silmoon04/mist-robot/design/main_hub_20260915/corrected_spacers/README.md

Corrected spacers: eight pieces, 5.5 mm outside diameter, 13 mm height, 3.4 mm M3 clearance bore. Nominal radial wall thickness is 1.05 mm.

The main hub geometry and Cura process settings are unchanged. The combined plate was rebuilt and re-sliced: approximately 7 h 26 min and 111.9 g PLA, supports off.

Use Tonight_Hub_And_8_Spacers.3mf for the hub and eight corrected spacers together. Use Eight_Spacers_Only.3mf if you only need the spacers, or Spacer_13H_5p5OD_M3.stl for one piece. Import/select the supplied Neptune4Pro_Hub_PLA_028.curaprofile manually; the 3MF carries geometry, not Cura profile selection. Keep 100 percent scale and the supplied orientation.

This supersedes the earlier 8 mm high by 13 mm diameter spacer plate. The previous hub mounting instructions remain valid. These 13 mm spacers are not automatically interchangeable with the previously checked 11.6 mm yaw spacers; this update changes the requested loose spacers only, not the leg's checked axial stack.
