silmoon04/mist-robot/design/hexapod_phone_quad_r5_20260912/simulation/interim_ce504_yaw22/README.txt

INTERIM R5 MATRIX, SUPERSEDED OPERATING RANGE

These five reports preserve the test using a 22 degree operating yaw limit.
The final clearance review required 19 degrees to retain at least 1 mm of
fixed-saddle clearance. These reports are historical, not the final R5 release.

Solid manifest: ce504f86e7779430ae50394041a0d02d92c47ab61b77c710cbcfba79fbdd9470
Printed manifest: 15f5af97a24525fb5b8539e5f05094fd7455b7da621992cd39ce1c29796a5513

The comparison retains its original report-path fields and hashes. Matching
report bytes are saved in reports under their original case names. This folder
does not contain a complete, directly replayable CAD or trajectory snapshot.
The replacement matrix will use the corrected 19 degree limit and new hashes.
