silmoon04/mist-robot/brain/art_direction/artist_studio_20260916/reuse/mist_motion_v3/README.md

# MIST motion v3

These studies bring the 18 acting ideas back to MIST's open-ring eyes, hooked lids, rounded mint strokes and small mouths. Each clip has 12 composed poses on a shared 512 × 320 canvas. Blinks have their own timeline; they do not consume half of every acting clip.

The frames reuse original MIST components and selected ImageGen component drawings. They are assembled poses, not 216 separate ImageGen illustrations. Source records in the manifest identify the reused and generated art.

The player runs on a 15 fps timebase. Authored exposures hold some poses longer so a glance or reaction has time to read. The left eye, right eye and mouth remain separate. Their common attachment positions prevent a mouth change from moving the whole face.

Use the grid to compare the clips. Open a clip to inspect individual frames, hide layers or try a separate mouth frame. The transition controls compare two expressions. Your selections and notes keep the existing review IDs and can be exported from the page.

`previews/all-animations.gif` shows the full grid. Individual GIFs and blink previews sit in the same folder. The transparent PNGs preserve the full-colour layers; GIF is a compact review format. `AGENT_GUIDE.md` describes when to choose each expression.

This is an animation review gallery. Its mouth controls show layer independence; they do not establish speech synchronisation in the live voice app. A voice integration must drive visemes from the audio actually being played and stop them when that audio is interrupted.

The previous gallery remains available in [v2 history](https://silmoon04.github.io/mist/acting-animations-v2/). The voice app and the earlier selection page are separate.
