silmoon04/mist-robot/design/mist_v2_20260906/engineering_review.md

# Independent engineering review

Review date: 6 September 2026. Scope: `simulation/model.py`, `simulation/run_sim.py`, the analytic model and saved trajectories, wheel calculations, and the body CAD recipe available during the review. This is a review of an engineering candidate. It does not release a leg for powered use or establish stair capability. No hardware was operated. The reviewer changed only this report; findings were sent to the implementation agents.

The current reviewed mass is **3.95376294555 kg**, after reconciling the body CAD mass and COM. Stand, fixed-base leg swing, stance height, driving and ideal-range obstacle stopping pass their model criteria. The current 2:1 hip crawl and both step attempts fail. The 3.5:1 hip variant passes its slow crawl case, but this does not establish a manufactured transmission or stair capability.

The coupled transmission mathematics and nominal coordinate frames checked correctly. The review also found and helped correct an obstacle-test false pass, an inconsistent descent direction and incomplete contact acceptance criteria. Command hysteresis remains an approximation of physical backlash. Earlier **3.884 kg** results are historical evidence, preserved in `simulation/outputs_baseline_preCAD`; they are not the current design results.

## Current evidence after CAD mass reconciliation

The bounded final review checked saved reports, inputs, hashes and mass arithmetic without rerunning the full solver. All **eight current cases**, **three variant cases** and **four supported-leg load cases** match the current source hashes and their own parameter snapshots. [simulation/outputs/summary.json](simulation/outputs/summary.json) is the current eight-case summary. [simulation/README.md](simulation/README.md) explains the setup and remaining model limits.

| Current case | Reviewed result | Claim supported |
|---|---|---|
| 2:1 hip crawl | **FAIL_IN_MODEL**; 31.05 mm forward in 26 s; first-wheel clearance 12.80 mm | Misses the 15 mm actual-clearance criterion. |
| [3.5:1 hip crawl](simulation/variants/hip_3p5/crawl/report.json) | **PASS_IN_MODEL**; 34.38 mm forward and 18.26 mm lateral drift in 26 s; wheel clearances 30.36–36.60 mm; maximum tilt 2.29 degrees | Improved slow crawl under the stated assumptions. Its parameter snapshot changes only the hip ratio and candidate-status label. Added transmission mass, detailed packaging and hardware behavior are not established. |
| Aligned-wheel drive | **PASS_IN_MODEL**; 5.235 m forward in 8 s | A 0.9 m/s commanded drive after the ramp, with assumed motor and floor behavior. This is not measured robot speed. |
| Ideal-range obstacle stop | **PASS_IN_MODEL**; 177.61 mm minimum reported wheel-to-wall gap; zero sampled obstacle contacts | Corrected geometric-distance stopping case. No sensor perception or avoidance planner is tested. |
| Step ascent and descent | Both **FAIL_IN_MODEL** | Stair traversal remains unfulfilled. Ascent tips; descent includes unreachable targets and excessive sustained servo load. |
| [Supported-leg high-load test](simulation/load_tests/summary.json), 29.09 N | 2:1 hip: 148.13 mm endpoint error; 3.5:1 hip: 15.86 mm. **Both fail** their sustained-load criteria. | The higher ratio improves modeled force response. It still exceeds the 15 mm endpoint criterion and continuous motor allowance under this seconds-long fixture load. |

The 3.5:1 variant also passes its drive case. The adverse drive variant stays within its case criteria after increasing delay and backlash, reducing stiffness and lowering friction. This is one sensitivity experiment, not a bound on manufacturing or environmental uncertainty. With a 350-degree motor span, the 3.5:1 hip has only 100 degrees of usable travel; the nominal-centered range does not cover every analytically reachable stair endpoint.

The [final body report](cad/output/body_geometry_report.json) records **33 valid single solids**, no shape errors and no positive-volume intersections among those body components. Its **26 current printable-component STL filenames** match the recipe exactly, with no stale or missing files. Independent mass arithmetic confirms that shell mass **706.207559 g** excludes the B13/B14 face parts; those parts contribute **63.555387 g**, which is included once with the assumed 155 g face phone. Shell and combined face COMs match the simulator after the 35 mm origin shift. Twelve joint servos are counted once: four yaw servos in the base and eight pitch/knee servos on the carriages.

These are solid-PETG volume estimates, not sliced or weighed masses. The body check is one static body assembly. Native Fusion execution, final native-leg integration, service fasteners, root-pod load interfaces, swept collisions and print readiness remain unverified. A body-only zero-intersection result cannot certify the complete robot.

Current source SHA-256 hashes are `run_sim.py`: `0b35d5a776b8479b2bbe7238c191ccf8e890e4024b749d600639f0ca0878cddc`; `model.py`: `7da904de9f18a7e7c164d62e1b939a8b51af91a55bf1c357c62dc7707cb35392`; and `load_test.py`: `69a107302449a0fb328096b483cfd8a18f251f08429263579f79dd1648b19eff`. The current shared canonical parameter hash is `d66bb513a344fb6a9723ee8ba9d6b9debb91f5a452ef4f4a3dc87d79ed4da732`; the 3.5:1 crawl snapshot hash is `4b87a3e8c51662efe8698406ff136cf91787f916490464e28e03a56f92319e32`.

## Earlier findings and disposition

| Finding | Evidence and implication | Disposition |
|---|---|---|
| **Obstacle stopping initially passed after hitting the obstacle.** | The saved `obstacle_stop` case ended at +29.86 mm. The initial front-wheel-to-wall gap was 29.67 mm. Reloading its final pose into an isolated Bullet world found both front wheels touching the wall, with -0.010 mm separation and horizontal contact normals. The controller used a timer and the acceptance criteria did not reject obstacle contacts. | Corrected and regenerated with a declared ideal world-distance trigger, a farther obstacle, no-contact and stopped-velocity criteria. Independent geometric replay of all 400 saved frames found no penetration and a minimum whole-robot separation of **170.0 mm**. This establishes the revised model's stopping case, not perception or avoidance planning. |
| **Descent initially drove in the opposite direction to its success condition.** | The platform occupied x=0.24 to 1.64 m. The robot started at x=0.64 m and commanded positive-X foot/wheel movement, but success required x<0.10 m. Downward targets went into the platform. | Corrected to start at x=1.42 m and use the right edge, then regenerated. Both step attempts still fail. Their failure does not prove that no viable stair controller exists. |
| **Non-wheel supports and wall contacts could hide failures.** | The original acceptance test counted only base-link ground contacts. A femur, tibia or yaw carriage could support the body without failing the test. Support polygons accepted every loaded wheel contact, including vertical walls. | Corrected and regenerated: loaded non-wheel contacts fail acceptance and upward contact normals define the support polygon. Checks are still sampled at recording frequency; transient contacts between samples can be missed. |
| **Crawl PASS did not establish the requested swing clearance.** | Replay of the original 26 s crawl found peak tread clearances of 13.17, 21.75, 24.35 and 17.08 mm using wheel-center height minus radius. Commands requested 45 mm; the shared toe-clearance parameter is 15 mm. All four wheels did unload, but the first leg missed that clearance. Maximum individual knee errors reached about 9 degrees while whole-robot RMS was 3.06 degrees. Forward progress was 31.4 mm in 26 s. | Corrected acceptance now uses actual wheel bounds, reports 12.47, 21.24, 23.95 and 16.49 mm, and correctly marks the baseline crawl **FAIL_IN_MODEL**. These values describe a very slow flat-floor crawl attempt, not fast walking or validated obstacle traversal. |
| **Backlash dynamics are approximated by command hysteresis.** | `ActuatorBank` infers physical shaft angle exactly as `s=Aq`, then applies a play operator to the commanded angle. Under a fixed command, a reversed external load still sees immediate modeled stiffness; it does not cross a physical transmission gap before engagement. No separate rotor or reflected gearbox inertia is integrated. | Limitations now state this explicitly. Retain the analytic correlated-error bound. Predicting loaded reversal response requires measured gap/stiffness and either an identified model or explicit motor/load states with engagement. |
| **Body recipe and simulator initially disagreed.** | `body_spec` required `body_height_m=0.260`, while shared parameters use a 0.220 m barrel and a separate 0.260 m overall height. The initial face-phone CAD and simulation centers differed. The first body replay also reported phone/phone interference, a disconnected lower shell, and 901.99 g of fully solid printed geometry against a 650 g shell allowance. | Source, static body intersections and mass/COM accounting have been corrected, as recorded above. The final CAD solid mass is 769.76 g including the face parts; it is split into shell and face-frame budget entries without duplication. Sliced and measured values remain outstanding. |
| **Saved reports can represent different source revisions.** | `outputs/summary.json` initially contained only the last separately invoked case, while other case directories retained earlier runs. Parameters were copied, but the per-case reports did not identify the source revision. | Corrected: all eight regenerated reports contain parameter and source hashes. Independently verified every hash against its parameter snapshot and the current source. Later model/geometry changes require another matching run. |

## Checks that passed

- Nine analytic unit tests passed, including the numerical Jacobian, inverse kinematics, virtual work, coupled hip/knee motion, motor-travel mapping and affine mass allowance.
- Across 100 additional random vectors, ideal virtual work differed by at most **1.78e-15**: `(A.T @ motor_torque) dot qdot = motor_torque dot (A @ qdot)`. For the absolute-tibia belt, the hip motor load depends on `joint_hip_torque - joint_knee_torque`, as implemented.
- An isolated URDF load matched analytic wheel-link positions within **9.3e-9 m** at the neutral pose. Bullet reports the base inertial frame at the body COM; `base_link_pose` correctly removes its translated COM offset for the current zero-rotation inertial frame. The summed URDF mass and analytic mass both equal **3.884 kg** for the reviewed parameters.
- Default Bullet velocity motors are disabled before torque control. The controller applies `A.T @ (eta * shaft_torque)` to joint torques. Same-direction motoring torque falls toward zero at the assumed no-load speed, and peak torque is capped separately. It does not apply full stall torque at full no-load speed.
- Wheel inertia uses the axle as the local Y axis, consistent with the rotated cylinder. Body and link inertias remain approximate distributions: products of inertia, motor rotor inertia and actual CAD inertia are absent. These omissions limit acceleration, tipping and resonance predictions.
- The wheel study's **1,620 cases** reproduce. Four-contact acceleration at 4 kg requires **0.045297 N m** for 70 mm wheels and **0.055003 N m** for 85 mm wheels. The 15-degree slope figures are **0.098781** and **0.119949 N m**; two-contact loads double. Speed-increase ratios, efficiency penalties and the reported torque ceilings are consistent. No current-limit pass in the existing grid has zero predicted rpm.

The earlier independently rechecked **3.884 kg** baseline used `run_sim.py` SHA-256 `d95047507b5130b1a2d4e31166c1c14d411596f97fc1e2ed4900f1634aa8148b`, `model.py` SHA-256 `be18e5074f94d457e4a3b7b01fd80f1f89011537f824c023eb1170f38f6aad78`, and canonical parameter hash `043364ca09833c05f8d711fda6b7a7de019ae3bcbe12c949575a077214699b70`. Those hashes and the 170.0 mm independently replayed obstacle separation in the historical findings identify the earlier evidence, not the current mass-adjusted run.

## Limits that remain material

The wheel calculation combines nominal no-load current with linearly voltage-scaled no-load speed. That is a useful endpoint approximation, but not one internally consistent resistance/back-EMF model with constant friction current. An endpoint-consistent alternative changes the relevant FIT0493 70 mm acceleration estimate from about 1.073 to 1.066 m/s and the STS speed-increase 85 mm estimate from 1.067 to 1.053 m/s. It does not reverse the present comparison. Add voltage feasibility and a target-speed condition before reusing the current-limit Boolean as an overall operating pass.

The collision model uses boxes and cylinders, excludes parent/child contacts and additionally excludes each femur/wheel pair. It does not contain the real servo pods, belt runs, shafts, retainers, cables or cosmetic covers. Zero coarse contacts establishes no interference only for the checked proxy pairs and sampled trajectory. It cannot establish a collision-free, manufacturable leg. The native helper correctly raises on failed features and no-effect cuts; the offline body exporter records some such defects instead, so the two replay paths need a clean common recipe before native execution can be inferred.

The support polygon is a quasi-static diagnostic. It does not prove dynamic stability, traction or stair-edge support. Whole-run servo RMS is a heat-related indicator under an assumed rating, not a thermal model. An eight-second PASS does not establish continuous duty. The 180 mm step case uses one platform, not a repeated staircase with 270 mm treads, riser noses, friction variation or a perception/planning stack.

Before advancing beyond a candidate, retain the corrected failures, integrate the final leg geometry and its actual transmission mass, check the complete motion envelope, and identify the first assembled leg's backlash, force response and thermal behavior. Repeat matching-source simulations when those inputs change. Coupon feedback can establish fits; it cannot establish these load and motion properties.
