silmoon04/mist-robot/design/mist_v2_20260906/cad/fusion_motion_20260907/REVIEW.md

# Independent static review

A separate agent reviewed the initial `motion.py` against installed Autodesk declarations and the primary documentation collected in `API_EVIDENCE.md`. It found no concrete static defect at that stage. The first actual native fixture later exposed behavior that this static review did not establish: wrong-axis rotation through the custom-line definition, drive quantization and Compute All resetting the transient pose.

The review checked the native sketch datum and proxy contexts, child-relative-parent probe calculation, axis/centre checks, pose restoration, physical/as-built angle offset and sign mapping, and the separate fixed-phase rotor attachments.

After the controlled fixes, the native 17-component fixture passed all 16 joint probes and 96 transform/world-datum checks. See `NATIVE_VERIFICATION.md`. The full nested assembly, multi-part groups and rotor attachments still require native validation. The passing fixture does not retroactively turn the original static review into proof of the first implementation.
