silmoon04/mist-robot/design/mist_v2_20260906/package/body_remote_20260907/cytron_wheel_motor_note.md

# Cytron wheel motor check

Checked 7 September 2026. Target: a body-mounted encoder gearmotor near 200 wheel rpm and 0.17 N·m working torque, with an approximately £15 UK component price. Supplied comparator: FIT0493, £25.61 including VAT, 98 g, 350 rpm no-load, 1.177 N·m stall; approximately 0.172 N·m estimated at the 1 A winding-current cap. No purchase, supplier contact or bench test was made.

**No buyable UK SPG30E variant meeting that price and operating-point target was verified.** The real current fast variant below is a technical comparison, not a £15 UK purchasing recommendation. It does not reach the requested rated power even before remote-transmission losses.

## One current variant: SPG30E-GR30

[Cytron's exact encoder product page](https://www.cytron.io/p-12v-37mm-dc-geared-motor-with-encoder-spg30e-gr30) identifies **SPG30E-GR30**, distinct from the non-encoder SPG30-GR30. Its table states:

| Parameter | Value |
| --- | --- |
| Gear ratio | 30:1 |
| Rated voltage | 12 V |
| No-load speed / current | 333 rpm / 120 mA |
| Rated load speed | 266 rpm |
| Rated load torque | 1.14 kgf·cm = 0.1118 N·m |
| Rated current | 400 mA |
| Stall torque / current | 4.5 kgf·cm = 0.4413 N·m / 1.2 A |
| Encoder | Incremental, advertised 16 PPR; 3.3–5 V supply |
| Harness | Non-detachable wires with 2.54 mm female headers |

Cytron displayed **US$19.00** and **out of stock** for this exact encoder variant. No UK seller price, VAT-inclusive total, stock or delivery date was verified. A dollar conversion would not establish a delivered UK price. The linked current encoder datasheet folder returned 404 during this check; the product page and dimensional image were available. No explicit continuous-duty class, thermal-rise limit or endurance test was established from them.

## Actual current geometry

The [Cytron encoder-motor dimension drawing](https://static.cytron.io/image/catalog/products/V-SPG30/v-spg30-dimension-spg30e-v2.png), linked from the current product page, was visually inspected. For GR30 it gives gearbox length L = 22 mm and motor/encoder section length 47 mm. Thus the calculated body length is 69 mm; adding the 21 mm front boss/shaft projection gives approximately 90 mm to the output tip, excluding wire clearance.

The gearbox diameter is 37 mm and motor/encoder section diameter 35 mm. The output is a 6 mm D-shaft, 5.5 mm across the flat, with 15 mm shaft projection beyond the boss and 12 mm flat length. The locating boss is 12 mm diameter. The drawing marks M3 mounting holes on a 31 mm pattern diameter, and a 7 mm offset between output and body axes. Confirm mounting-thread depth from the actual delivered revision; do not transfer the older SPG30E-20K's thread-depth data automatically.

**Exact mass was not verified.** Do not reuse an older SPG30E weight or infer that its mass matches the 98 g FIT0493. The current 37 mm diameter and approximately 90 mm overall envelope already require a larger body mounting allowance than the supplied 25 mm-class FIT0493.
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
