silmoon04/mist-robot/design/mist_v2_20260906/package/body_remote_20260907/wheel_actuation_options.md

# Wheel actuation options with body-mounted motors

Checked 7 September 2026. **The ordered ST-3215-C018 genuinely supports continuous velocity operation, but a 2–3× speed-up cannot meet 200 wheel rpm.** Its manufacturer no-load speed is 45 rpm at 12 V. The existing simulation already uses 45 rpm; the 70–100 rpm figure was an unverified hypothesis, not a simulation defect. No ratio, material, controller or CAD changes were made from that hypothesis. FIT0493 remains the current fallback.
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
