silmoon04/mist-robot/locomotion/reviews/msi_remote_smooth/default-main.png

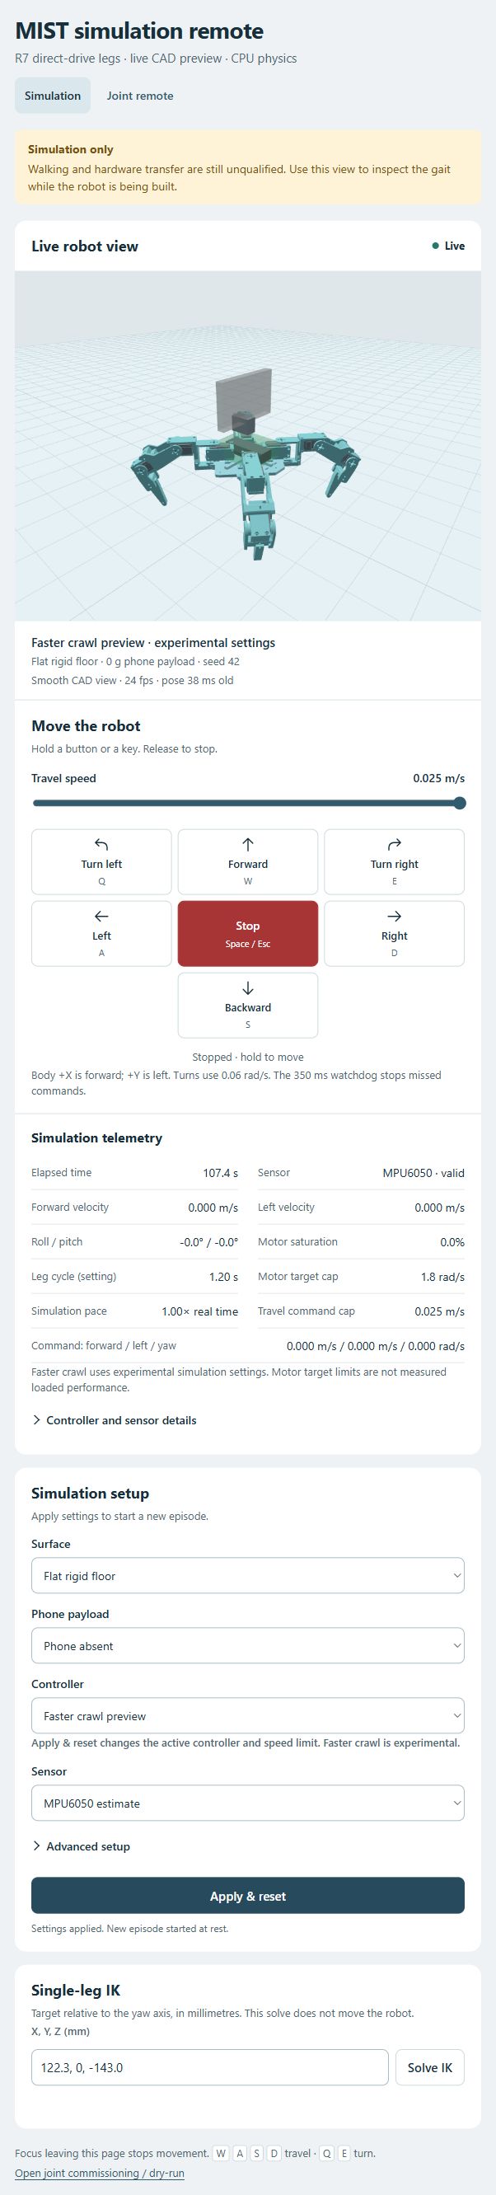
locomotion/reviews/msi_remote_smooth/default-main.png
