silmoon04/mist-robot/locomotion/reviews/msi_remote_smooth/main-current.png

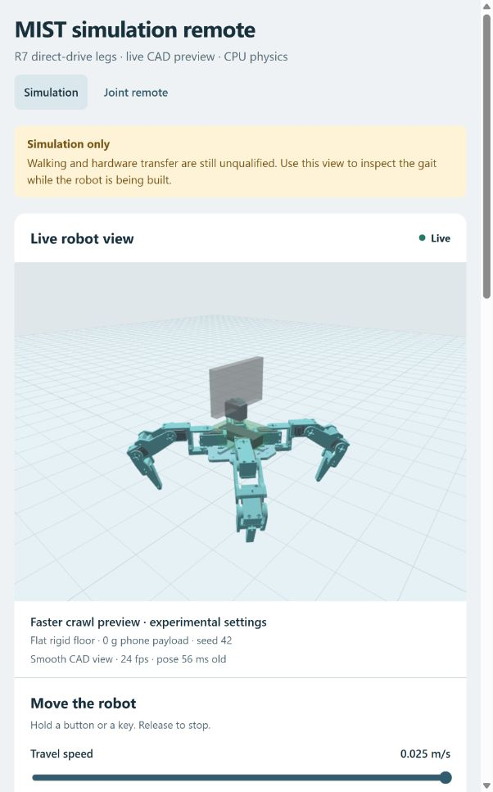
locomotion/reviews/msi_remote_smooth/main-current.png
