silmoon04/mist-robot/locomotion/reviews/msi_remote_speed/desktop.jpg

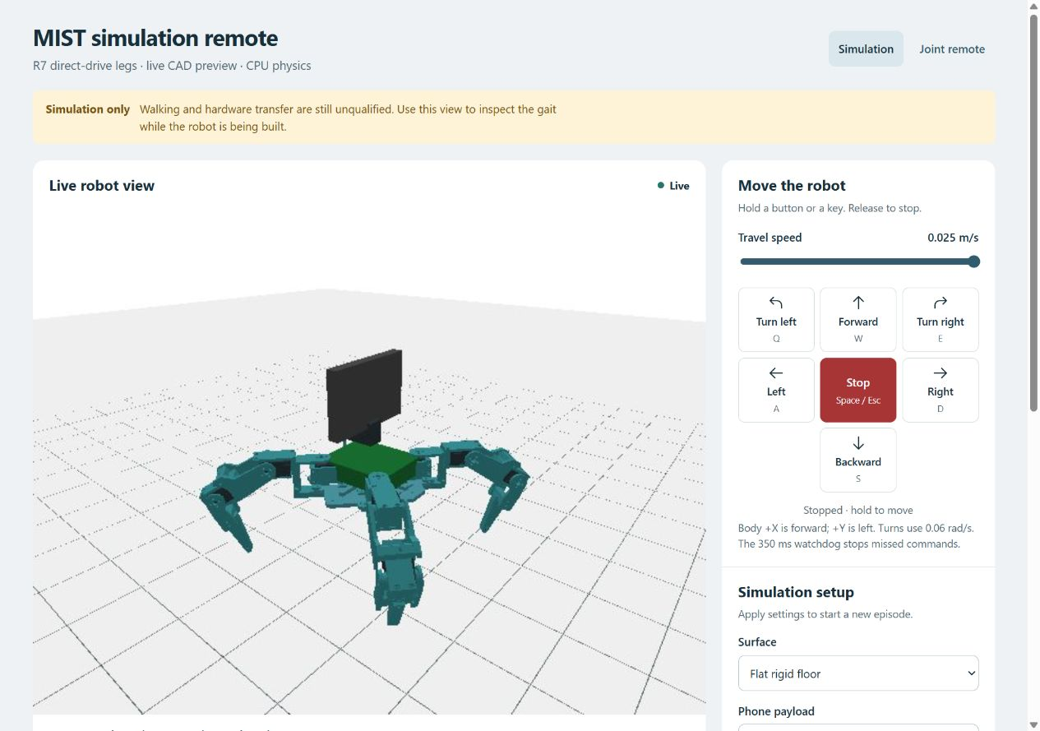
locomotion/reviews/msi_remote_speed/desktop.jpg
