silmoon04/mist-robot/locomotion/reviews/msi_remote_speed/phone.jpg

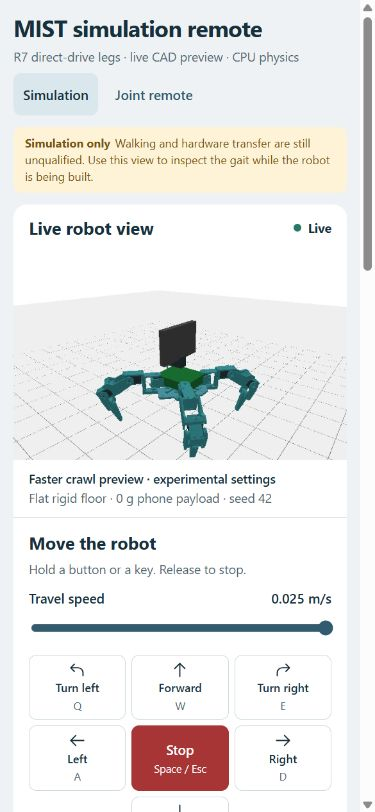
locomotion/reviews/msi_remote_speed/phone.jpg
