silmoon04/mist-robot/locomotion/reviews/msi_remote_ui/joints-desktop.jpg

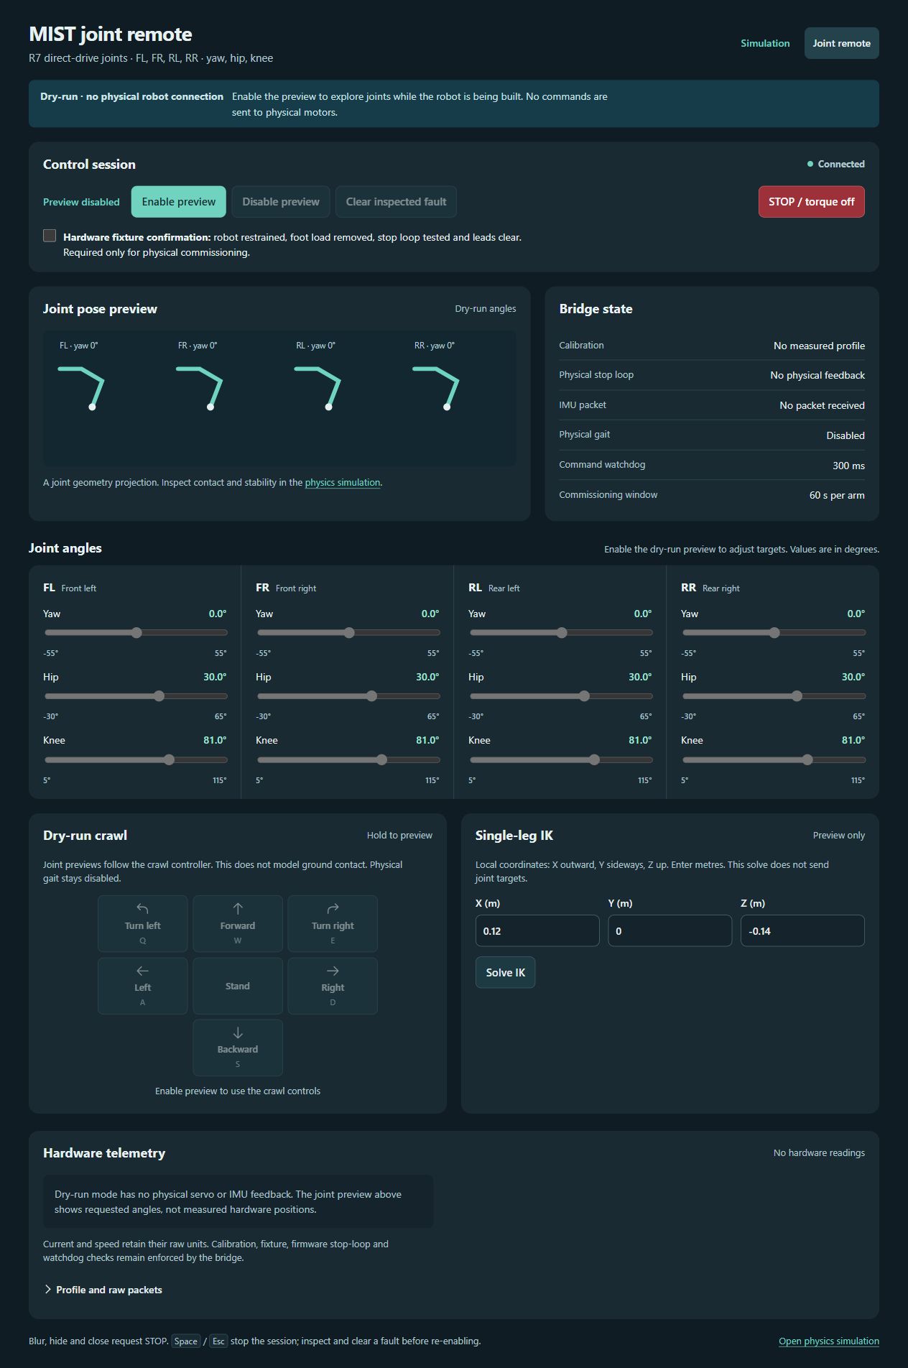
locomotion/reviews/msi_remote_ui/joints-desktop.jpg
