silmoon04/mist-robot/locomotion/reviews/msi_remote_ui/joints-mobile.jpg

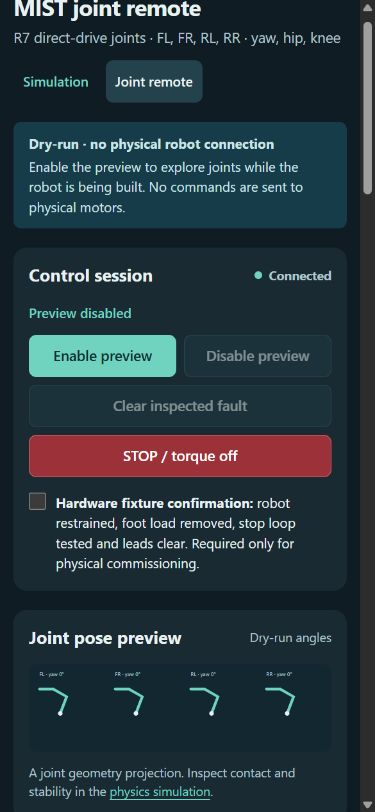
locomotion/reviews/msi_remote_ui/joints-mobile.jpg
