silmoon04/mist-robot/locomotion/reviews/msi_remote_ui/simulation-desktop.jpg

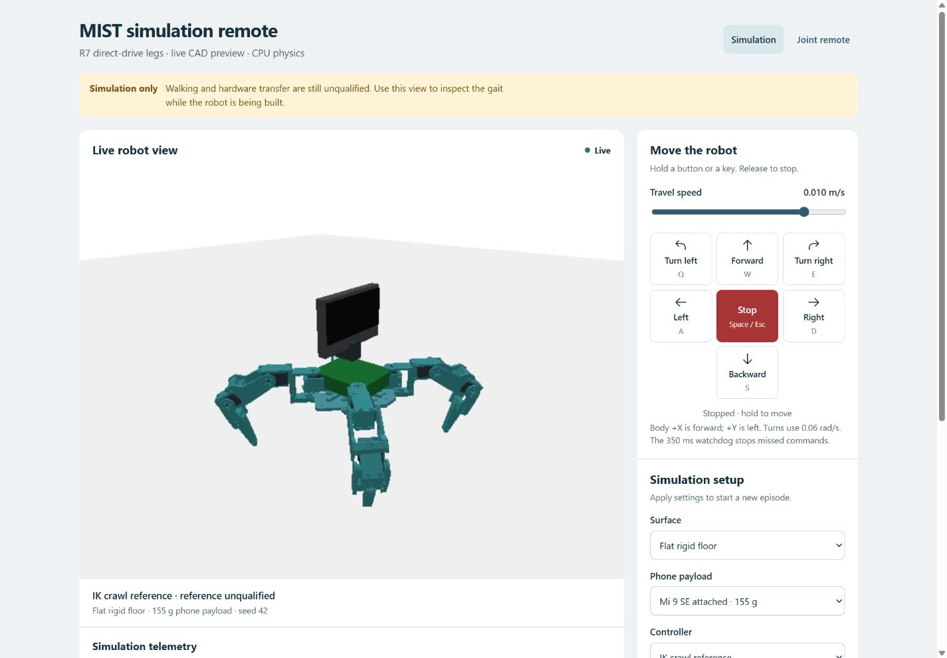
locomotion/reviews/msi_remote_ui/simulation-desktop.jpg
