silmoon04/mist-robot/locomotion/runs/preview.jpg

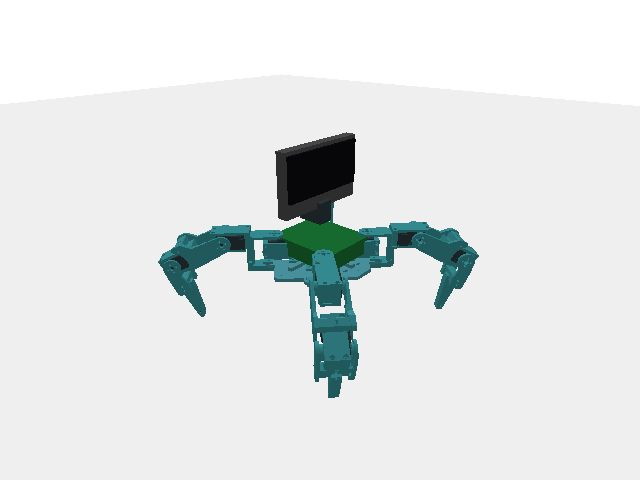
locomotion/runs/preview.jpg
