silmoon04/mist-robot/design/recovery_three_parts_20260916/balanced_profile/READ_ME.txt

Import and select Neptune4Pro_Recovery_Balanced_028.curaprofile in Cura.
Use it with the existing Recovery_Three_Parts_With_Supports.stl.
Do not change the supplied model orientation or remove its built-in supports.
Keep your existing Neptune 4 Pro printer and startup configuration.

This profile replaces the slower Recovery Three Parts 028 profile for this attempt.
The older Recovery_Three_Parts.zip retains the earlier profile; import this new profile separately.

CuraEngine estimate for the same three-part plate: 6 h 14 min, about 109 g PLA.
Previous recovery estimate: 7 h 12 min. Saving: about 58 minutes, or 13.4%.
Actual Cura and printer time may differ; these are not measured print durations.

Changes:
Outer walls: 35 to 50 mm/s.
Inner walls and infill: 60 to 90 mm/s.
Top and bottom: 35 to 60 mm/s.
Nozzle after first layer: 210 to 215 C.
Candidate volumetric flow ceiling: 8 to 11 mm3/s.
Overhang speed percentages reduced to avoid speeding up unsupported walls.

Retained:
0.28 mm layers, five walls, 25% gyroid infill.
6 mm outside brim with 0.1 mm gap.
Added removable support geometry and automatic tree supports.
20 mm/s first layer, 210 C initial nozzle temperature, 60 C bed.
Gentle acceleration, 120 mm/s travel, existing retraction and cooling settings.

The plate hash and sliced automatic support geometry match the checked recovery setup.
The higher flow has not been physically qualified for your filament. Inspect the initial
layers and subsequent extrusion on this first use; speed savings do not prove adhesion.
Clean and reseat the PEI sheet as planned before starting.
