silmoon04/mist-robot/design/mist_v2_20260906/package/metal_gears_20260907/supplier_gear_options.md

# Metal module 1 gear options

Checked 7 September 2026. Scope: 20:40 and 25:50 spur pairs, with an 8 mm face-width preference; 7 mm output shaft interface; an 8 mm knee gear slice at y = 28.125–36.125 mm coupled to the selected MISUMI 3GT pulley. No purchases or supplier contacts were made. Only this note was written for this subtask.

HPC's plain PG1 gears are the closest catalogue match to the 8 mm slice. The 25T input leaves more material around the servo horn bolt circle than 20T. A 7/8 mm finished bore and both axial bolt patterns still require a specified modification or adapter. No catalogue gear below is claimed to contain the C018 spline, four M3 holes on 14 mm BCD, or four M4 holes on 16 mm PCD.

## HPC G1 / PG1: exact 8 mm face

[HPC's manufacturer drawing and table](https://www.hpcgears.com/pdf_c33/23.28-23.33.pdf), pages 23.28–23.29, specifies module 1, 20° pressure angle, 214M15/045M10 steel and H8 bores. G is hubbed: 8 mm face + 12 mm boss = 20 mm overall. PG is plain, 8 mm overall. Dimensions are mm; masses are grams.

| Hubbed / plain part | Pitch / outside diameter | G boss diameter | Stock bore, both forms | G / PG mass | G / PG catalogue price |
| --- | --- | --- | --- | --- | --- |
| G1-20 / PG1-20 | 20 / 22 | 15 | 8 | 28 / 16 | £11.85 / £11.33 |
| G1-25 / PG1-25 | 25 / 27 | 15 | 8 | 39 / 27 | £12.75 / £12.40 |
| G1-40 / PG1-40 | 40 / 42 | 20 | 8 | 98 / 74 | £16.44 / £14.96 |
| G1-50 / PG1-50 | 50 / 52 | 30 | 10 | 173 / 115 | £18.69 / £16.44 |

These are catalogue quantities 1–5, VAT basis unspecified. Root diameter is not dimensioned. The drawing identifies the G and PG forms but shows no axial bolt pattern. [HPC's stock checker](https://hpcgears.com/stockcheck/orders.php) warns that published prices can be outdated and gives approximately 14 days manufacturing when stock is unavailable. Exact current stock/price was not established. [HPC confirms boring, keying and modifications](https://hpcgears.com/n/products/12.spur_gears/spur_gears.php).

The plain 25:50 pair totals £28.84 at those catalogue prices and 142 g before machining/attachments; the plain 20:40 pair totals £26.29 and 90 g. These are arithmetic combinations, not current quotations. PG1-25 is the useful input blank for a horn adapter. PG1-50 fits the requested 8 mm knee slice but its stock 10 mm bore cannot become 8 mm merely by reaming; specify a smaller-bore factory variant or a designed centring sleeve/carrier.

## Ondrives PSG1.0: stronger-material comparison, 10 mm face

Ondrives' [official steel-gear catalogue](https://ondrives.com/images/uploaded/PSG%200.5%20to%208.0mn%20Precision%20Steel%20Spur%20Gears.pdf), PDF pages 5–6, gives a 10 mm tooth face plus 12 mm hub projection, giving 22 mm overall width for module 1. Standard PSG material is 817M40T / AISI 4340 / EN 1.6582 steel, approximately 28 HRC; the separate H suffix is case-hardened 805M20. Both use 20° pressure angle. Catalogue geometry and ratings must be rechecked if face width or heat treatment changes.

| Exact standard part | Pitch / outside diameter | H7 stock bore | Hub diameter | Mass | UK price / lead |
| --- | --- | --- | --- | --- | --- |
| [PSG1.0-20](https://shop.ondrives.com/spur-gears/psg10-20) | 20 / 22 | 5 | 15 | 38 g | No public price/stock verified |
| [PSG1.0-25](https://ondrives.com/spur-gears/psg10-25) | 25 / 27 | 6 | 20 | 63 g | No public price/stock verified |
| [PSG1.0-40](https://ondrives.com/spur-gears/psg10-40) | 40 / 42 | 10 | 34 | 170 g | No public price/stock verified |
| [PSG1.0-50](https://shop.ondrives.com/spur-gears/psg10-50) | 50 / 52 | 10 | 34 | 225 g | No public price/stock verified |

The catalogue describes custom bore, keyway, tapped-hole and pin-hole ordering. This does not establish the required axial patterns or promise a smaller bore in an already stocked 10 mm blank. Request the finished drawing. The 25T standard hub is 20 mm diameter, unlike HPC G1-25's 15 mm boss, and its 12 mm hub projection supplies axial material for a custom interface, but hole direction, assembly access and useful thread engagement still require a finished drawing.

## KHK SS1 through RAR Gears UK: current prices and stock

[KHK's manufacturer catalogue](https://khkgears.net/pdf/ss.pdf) supplies the dimensional drawings. Standard SS1 gears are S45C steel, 20° full-depth teeth, JIS N8, black oxide, without heat treatment. All four below have 10 mm face, 10 mm hub projection and 20 mm overall length. They require width machining or an axial-layout change for the 8 mm slice.

| Exact part and UK listing | Pitch / outside diameter | H7 bore / hub diameter | Displayed unit price | Availability shown |
| --- | --- | --- | --- | --- |
| [SS1-20](https://www.rargears.com/gears/spur-gears/steel-spur-gears/SS1-20) | 20 / 22 | 8 / 16 | £10.73 | 10–14 days, subject to manufacturer availability |
| [SS1-25](https://www.rargears.com/gears/spur-gears/steel-spur-gears/SS1-25) | 25 / 27 | 8 / 20 | £10.97 | 8 in stock; shipping by close of business today |
| [SS1-40](https://www.rargears.com/gears/spur-gears/steel-spur-gears/SS1-40) | 40 / 42 | 10 / 35 | £14.13 | 10–14 days, subject to manufacturer availability |
| [SS1-50](https://www.rargears.com/gears/spur-gears/steel-spur-gears/SS1-50) | 50 / 52 | 10 / 35 | £17.91 | 1 in stock; shipping by close of business today |

RAR pages do not state VAT treatment beside these prices; no VAT-inclusive total is inferred. The 25:50 pair is £28.88 and the 20:40 pair £24.86 before delivery and any machining, as displayed. [RAR's UK delivery policy](https://www.rargears.com/legal/delivery-policy) lists £4.95 standard or £10 next-day courier, subject to its order terms. RAR is RA Rodriguez (UK) Ltd, Shefford, Bedfordshire.

KHK also documents **SS1-50A** with an 8 mm H7 bore and M5 radial set screw, retaining 10 mm face and 20 mm overall length. Exact UK stock and price for that variant were not checked. A radial set screw is not evidence of a rated low-play torque connection. Manufacturer drawing links are [SS1-25](https://khkgears2.net/catalog2/SS1-25) and [SS1-50](https://khkgears2.net/catalog2/SS1-50); the UK pages also link 3D CAD and DXF. No STEP download was claimed.

## Interface screening for the supplied robot geometry

The supplied C018 information is a 25T spline approximately 5.9 mm OD and a factory horn approximately 19.95 mm OD with four M3 holes on 14 mm BCD. Tooth count and spline OD alone do not define a machinable mating spline. The practical candidate retains the factory horn and uses a registered, bolted metal gear/adapter.

For centre distance, standard unshifted module 1 geometry gives `(20 + 40)/2 = 30 mm` and `(25 + 50)/2 = 37.5 mm`. These are nominal centres; backlash and the chosen manufacturer's tooth tolerances still matter.

For root-clearance screening only, assuming unshifted 1.25-module dedendum gives root diameters 17.5, 22.5, 37.5 and 47.5 mm for 20, 25, 40 and 50 teeth. These are calculated reference circles, not verified manufacturer root contours. Fillets, modifications and tolerances must come from the final drawing/CAD.

Four 3.4 mm M3 clearance holes on 14 mm BCD have a radial outer envelope of 17.4 mm diameter. Against that nominal root circle, 20T leaves just 0.05 mm radial material; 25T leaves 2.55 mm. Consequently a direct 20T face pattern is not a credible released design from these dimensions. M3 threaded holes or smaller drills still need root/fillet checks and useful edge distance. Counterbores need a separate, larger envelope. The 19.95 mm horn also projects beyond a 20T nominal root diameter, so horn position and mating-gear clearance must be checked in 3D. A 15 mm catalogue boss cannot fully contain this bolt pattern.

For the knee, a plain HPC PG1-50's 8 mm thickness can occupy y = 28.125–36.125 mm before added spacers or heads. The selected pulley modification is four M4 holes on 16 mm PCD; the gear needs its own separately specified matching holes and a concentric register. On a stock 10 mm gear bore, 4.5 mm clearance holes on that circle leave only `8 − 2.25 − 5 = 0.75 mm` between bore and hole edges. A factory 8 mm bore increases this to 1.75 mm. These narrow ligaments and the sleeve/register arrangement need checking; the catalogue supplies no rating for this face-bolted assembly.

For a 7 mm shaft, HPC's stock 8 mm G1/PG1-40 likewise needs a custom 7 mm bore or designed adapter. Use the face bolts and registered carrier as an explicit torque path to the chosen shaft clamp. A slip-fit bore or axial collar alone does not establish low-play torque transfer.

## Concrete quotation specification

Preferred dimensional starting point: **HPC PG1-25 + PG1-50**, steel, module 1, 20° PA, 8 mm finished face; retain 37.5 mm nominal centres pending mesh checks. Specify the actual input horn register and four M3/14 mm BCD holes from measured CAD, and the output's required 7 or 8 mm bore plus four M4/16 mm PCD interface, with hole type/depth, clocking, register and fastener-head side explicit. Do not label these as stock features.

Ask for the final drawing/STEP including actual root/fillet geometry, material condition and tooth quality, machined bore/face tolerances, minimum allowable web ligaments, price and dispatch for the modified gears. Gear tooth capacity, shaft-hub holding capacity and the face-bolt connection require separate checks. No supplier rating has been assigned to the proposed modified assembly in this note.
