silmoon04/mist-robot/design/expanded_joint_plate_20260913/PARTS.csv

name | added_now | purpose | source_sha256
01_case_to_shaft_gauge_no_support | False | Attach to the existing clamped servo with two M3x50 tie bolts, printed 5 mm underside spacers, nuts and washers. New tapered feet remove the former supports. | fda0c863cdc9c271ca749aea273b21152387ab79db16854a1b8dbe032dbe2260
01_gauge_tie_bolt_spacer_5mm_1 | False | Under the existing saddle foot, before its washer and nut, when using the M3x50 gauge tie bolt. This is not a yaw spacer. | ab0c7a442a2cc90cc595b73495a02ac836dd5a8c9d0850a1861c860b84134750
01_gauge_tie_bolt_spacer_5mm_2 | False | Under the existing saddle foot, before its washer and nut, when using the M3x50 gauge tie bolt. This is not a yaw spacer. | ab0c7a442a2cc90cc595b73495a02ac836dd5a8c9d0850a1861c860b84134750
02_main_horn_cheek | False | Use the actual supplied disc and its retainer washer. Assemble with the 38 mm bridge without forcing the disc stack. | 00e45907637aec10521d88cc0c93faf20e246648065042f59c46582d53e1867c
03_auxiliary_horn_cheek | False | Use the actual supplied disc and its retainer washer. Assemble with the 38 mm bridge without forcing the disc stack. | 7574d0e7deb1022287a449ebbfef9895d24b99ada4a0a589e395fbe3f60df056
04_horn_bridge_38_roofed | False | One M3x50, two OD7 by 0.5 mm washers and a plain 2.4 mm nut close the two cheeks. Check auxiliary free rotation. | f593b4a821eaf692829d68c525e3fbcd6e1f5b79a2d76abd9924d4131cd86adb
05_yaw_spacer_nominal_11p6_1 | False | Four nominal spacers form a complete set. Short and long alternatives are comparison samples only. | 82f2fa383771d25ccbcf4ff7617c6973d04e7dbefd853e071df5c505fa0dcc58
05_yaw_spacer_nominal_11p6_2 | False | Four nominal spacers form a complete set. Short and long alternatives are comparison samples only. | 82f2fa383771d25ccbcf4ff7617c6973d04e7dbefd853e071df5c505fa0dcc58
05_yaw_spacer_nominal_11p6_3 | False | Four nominal spacers form a complete set. Short and long alternatives are comparison samples only. | 82f2fa383771d25ccbcf4ff7617c6973d04e7dbefd853e071df5c505fa0dcc58
05_yaw_spacer_nominal_11p6_4 | False | Four nominal spacers form a complete set. Short and long alternatives are comparison samples only. | 82f2fa383771d25ccbcf4ff7617c6973d04e7dbefd853e071df5c505fa0dcc58
05_yaw_spacer_short_11p3_1 | False | Four nominal spacers form a complete set. Short and long alternatives are comparison samples only. | 179e0e4778daafffadc217a7e8f2acdf92cd5c9dbae3d9b5e3c0cb427ec1af2f
05_yaw_spacer_long_11p9_1 | False | Four nominal spacers form a complete set. Short and long alternatives are comparison samples only. | 8b6721f9ae7093d38d06ca4cf257a263f2fd611fd95a3a60c8d18c83c987c5e5
06_M3_hole_strip_3p2_3p4_3p6 | False | Left to right from the notched end: 3.2, 3.4 and 3.6 mm bore diameter. | 18a38c7b76d4d9e3df8eb7188312c017c627e62ca8a4b00e09f9e8a70828482c
07_M3_nut_depth_2p6_2p8_3p0 | False | Left to right from the notched end: 2.6, 2.8 and 3.0 mm pocket depth; all have 5.7 mm across flats. Measures nut seating without guessing what needed sanding. | 9818404f597261570e706fb4fe4c92827a9c859bacbd27ca7a5ed2202b21fa66
08_lower_yaw_support_arm | True | Fit to the supplied auxiliary disc with the four nominal yaw spacers. | 4a2774ba90cd3cd3f0fdca26ae39872e8b87dfebd063e86bbd4f10f99ea42686
09_pan_cover_spacer_1 | True | Reserve this 4 mm spacer for a phone-pan mounting foot later. It is not a yaw or gauge spacer. | 3ce66418a3977fa44637c34de2ecd635f676789f21a6663e12a0a5b7ea02084b
09_pan_cover_spacer_2 | True | Reserve this 4 mm spacer for a phone-pan mounting foot later. It is not a yaw or gauge spacer. | 3ce66418a3977fa44637c34de2ecd635f676789f21a6663e12a0a5b7ea02084b
09_pan_cover_spacer_3 | True | Reserve this 4 mm spacer for a phone-pan mounting foot later. It is not a yaw or gauge spacer. | 3ce66418a3977fa44637c34de2ecd635f676789f21a6663e12a0a5b7ea02084b
09_pan_cover_spacer_4 | True | Reserve this 4 mm spacer for a phone-pan mounting foot later. It is not a yaw or gauge spacer. | 3ce66418a3977fa44637c34de2ecd635f676789f21a6663e12a0a5b7ea02084b
