silmoon04/mist-robot/design/hexapod_phone_quad_20260912/printing/coupon_bom.csv

part | quantity | stage | source_mandatory | selection_reason | source_stl | source_sha256 | note
r4_case_datum_saddle_0p2 | 1 | optional | False | Alternative fit | ../cad/output/coupons_stl/r4_case_datum_saddle_0p2.stl | a8cbe250cf90684b9bf497a4c7193b9ba26b968c5c317efd21f800eaa6284e07 | Includes the actual mounting feet. Use the registration plate to test case-to-shaft alignment while the actual servo is clamped.
r4_case_cap_0p2 | 1 | optional | False | Alternative fit | ../cad/output/coupons_stl/r4_case_cap_0p2.stl | ba7a100b8b5196e6753f648ed50467291f1f49b6f6e39ed0bb6870916fe67a57 | The three caps are geometrically identical and can be reused across clearance variants.
r4_case_datum_saddle_0p3 | 1 | first_print | True | Source mandatory fit | ../cad/output/coupons_stl/r4_case_datum_saddle_0p3.stl | ac4612018e8a0ccf1af1ce294ebfc54ee79cf865ffc54faf44d5b8411ba3651c | Includes the actual mounting feet. Use the registration plate to test case-to-shaft alignment while the actual servo is clamped.
r4_case_cap_0p3 | 1 | first_print | True | Source mandatory fit | ../cad/output/coupons_stl/r4_case_cap_0p3.stl | ba7a100b8b5196e6753f648ed50467291f1f49b6f6e39ed0bb6870916fe67a57 | The three caps are geometrically identical and can be reused across clearance variants.
r4_case_datum_saddle_0p4 | 1 | optional | False | Alternative fit | ../cad/output/coupons_stl/r4_case_datum_saddle_0p4.stl | 9f717af867f4b651e7af4bdcf49abeba82c71061a1682e3422550104efbdb4b5 | Includes the actual mounting feet. Use the registration plate to test case-to-shaft alignment while the actual servo is clamped.
r4_case_cap_0p4 | 1 | optional | False | Alternative fit | ../cad/output/coupons_stl/r4_case_cap_0p4.stl | ba7a100b8b5196e6753f648ed50467291f1f49b6f6e39ed0bb6870916fe67a57 | The three caps are geometrically identical and can be reused across clearance variants.
r4_case_to_shaft_registration_plate | 1 | first_print | True | Source mandatory fit | ../cad/output/coupons_stl/r4_case_to_shaft_registration_plate.stl | 4590d90273ccea8253faae0aff623f1c748b8e7864f306baad3dc62559455faf | Attach to X9/Y+20 and X9/Y-20 saddle feet with two M3x12 bolts, two nuts and four OD6 by 0.5 mm washers. Fit the actual main horn at the same time. Support the two offset feet when printing inverted.
r4_horn_fixture_main | 1 | first_print | True | Source mandatory fit | ../cad/output/coupons_stl/r4_horn_fixture_main.stl | aa831f0fa3292c41e54d82a5109acba99f934cbee78b664a6a3a1e7a0c413ba8 | Use the actual supplied disc and its retainer washer. Assemble with the 38 mm bridge without forcing the disc stack.
r4_horn_fixture_auxiliary | 1 | first_print | True | Source mandatory fit | ../cad/output/coupons_stl/r4_horn_fixture_auxiliary.stl | 5d230834c32b5bc543b1ee9d721c18601be5697568793c56c7cec0f9d17263f8 | Use the actual supplied disc and its retainer washer. Assemble with the 38 mm bridge without forcing the disc stack.
r4_horn_fixture_bridge_38 | 1 | first_print | True | Source mandatory fit | ../cad/output/coupons_stl/r4_horn_fixture_bridge_38.stl | e1d19f4b16fe954254f0a472b7b93cc298469c772bb359e8342c65a094785459 | One M3x50, two OD7 by 0.5 mm washers and a plain 2.4 mm nut close the two cheeks. Check auxiliary free rotation.
r4_yaw_spacer_11p3 | 1 | optional | False | Alternative fit | ../cad/output/coupons_stl/r4_yaw_spacer_11p3.stl | 179e0e4778daafffadc217a7e8f2acdf92cd5c9dbae3d9b5e3c0cb427ec1af2f | Compare spacer lengths with the seated auxiliary disc and fixed-stub retainer. The nominal candidate is 11.6 mm; do not tighten away free rotation.
r4_yaw_spacer_11p6 | 1 | first_print | True | Source mandatory fit | ../cad/output/coupons_stl/r4_yaw_spacer_11p6.stl | 82f2fa383771d25ccbcf4ff7617c6973d04e7dbefd853e071df5c505fa0dcc58 | Compare spacer lengths with the seated auxiliary disc and fixed-stub retainer. The nominal candidate is 11.6 mm; do not tighten away free rotation.
r4_yaw_spacer_11p9 | 1 | optional | False | Alternative fit | ../cad/output/coupons_stl/r4_yaw_spacer_11p9.stl | 8b6721f9ae7093d38d06ca4cf257a263f2fd611fd95a3a60c8d18c83c987c5e5 | Compare spacer lengths with the seated auxiliary disc and fixed-stub retainer. The nominal candidate is 11.6 mm; do not tighten away free rotation.
r4_m3_clearance_3p2_3p4_3p6 | 1 | first_print | True | Source mandatory fit | ../cad/output/coupons_stl/r4_m3_clearance_3p2_3p4_3p6.stl | 6b4a6089013be8df457c1ae33dfcd8139490135b97bfa51a472e867f98385c97 | Left to right: 3.2, 3.4 and 3.6 mm holes.
r4_top_bridge_load_main | 1 | first_print | False | Section specimen required before load tests | ../cad/output/coupons_stl/r4_top_bridge_load_main.stl | e5f58c0ef3933a690732c936096b8b3e0ee545beca60491dd23c9eb1416e3ea4 | Cropped from actual R4 production geometry. Use as a sacrificial section specimen in the recorded print orientation.
r4_top_bridge_load_aux | 1 | first_print | False | Section specimen required before load tests | ../cad/output/coupons_stl/r4_top_bridge_load_aux.stl | a64ad840a33a192ba19f89ac8c73fbfb69786ea9001b6e07bb0d8d5c9798e2cc | Cropped from actual R4 production geometry. Use as a sacrificial section specimen in the recorded print orientation.
r4_post_staggered_nut_section | 1 | first_print | False | Section specimen required before load tests | ../cad/output/coupons_stl/r4_post_staggered_nut_section.stl | 55a5ecd75f6f9c78457af7c808116a3d82f120be488a72c644c286feb09673a8 | Cropped from actual R4 production geometry. Use as a sacrificial section specimen in the recorded print orientation.
phone_fit_0p3_tray | 1 | optional | False | Alternative fit | ../cad/output/coupons_stl/phone_fit_0p3_tray.stl | 862cea13ee2af2587fb6a097c3ea31ebbbcb32aa330f0877ec967dd3c21185a5 | Assemble with the two matching corner clips and two M3x16 screws. This full-width landscape coupon uses 0.3 mm end and front clearance; test the bare phone bottom 24.8 mm. Print on its reinforced column backs with removable support beneath the central rear plate. Start with 0.5 mm; alternative full-width fits are optional.
phone_fit_0p3_clip_left | 1 | optional | False | Alternative fit | ../cad/output/coupons_stl/phone_fit_0p3_clip_left.stl | 4db781092904fd35511c35968b307e2960a0bda0de63ba019b689b1d421a994a | Matching short corner clip for the 0.3 mm phone fit tray. Use one M3x16 screw.
phone_fit_0p3_clip_right | 1 | optional | False | Alternative fit | ../cad/output/coupons_stl/phone_fit_0p3_clip_right.stl | e2b774fdbb8bcbc2da909ee0a43575577253e3c248cf7fdee7f92e922521a886 | Matching short corner clip for the 0.3 mm phone fit tray. Use one M3x16 screw.
phone_fit_0p5_tray | 1 | first_print | True | Source mandatory fit | ../cad/output/coupons_stl/phone_fit_0p5_tray.stl | 1cb7793b785b5346cfc905e5defc0f555aadba2a473a62ab971564300c8be69e | Assemble with the two matching corner clips and two M3x16 screws. This full-width landscape coupon uses 0.5 mm end and front clearance; test the bare phone bottom 24.8 mm. Print on its reinforced column backs with removable support beneath the central rear plate. Start with 0.5 mm; alternative full-width fits are optional.
phone_fit_0p5_clip_left | 1 | first_print | True | Source mandatory fit | ../cad/output/coupons_stl/phone_fit_0p5_clip_left.stl | 4db781092904fd35511c35968b307e2960a0bda0de63ba019b689b1d421a994a | Matching short corner clip for the 0.5 mm phone fit tray. Use one M3x16 screw.
phone_fit_0p5_clip_right | 1 | first_print | True | Source mandatory fit | ../cad/output/coupons_stl/phone_fit_0p5_clip_right.stl | e2b774fdbb8bcbc2da909ee0a43575577253e3c248cf7fdee7f92e922521a886 | Matching short corner clip for the 0.5 mm phone fit tray. Use one M3x16 screw.
phone_fit_0p7_tray | 1 | optional | False | Alternative fit | ../cad/output/coupons_stl/phone_fit_0p7_tray.stl | 596dd1029a9ec9598512fac881c3420b6a28ad262736f92e8e11b14b72e2bd73 | Assemble with the two matching corner clips and two M3x16 screws. This full-width landscape coupon uses 0.7 mm end and front clearance; test the bare phone bottom 24.8 mm. Print on its reinforced column backs with removable support beneath the central rear plate. Start with 0.5 mm; alternative full-width fits are optional.
phone_fit_0p7_clip_left | 1 | optional | False | Alternative fit | ../cad/output/coupons_stl/phone_fit_0p7_clip_left.stl | 9dd0e932d7d65ff46c3d2c60ca93a6cd381a896fcdb3bcee694985d8565d6942 | Matching short corner clip for the 0.7 mm phone fit tray. Use one M3x16 screw.
phone_fit_0p7_clip_right | 1 | optional | False | Alternative fit | ../cad/output/coupons_stl/phone_fit_0p7_clip_right.stl | da1cdf2f33e04ae48269bdc14c6aeb500a32cf87e443c90acc304e7c5b9d408e | Matching short corner clip for the 0.7 mm phone fit tray. Use one M3x16 screw.
phone_usb_spine_6mm_coupon | 1 | first_print | False | USB spine and plug check | ../cad/output/coupons_stl/phone_usb_spine_6mm_coupon.stl | ac4f363b6b33c658e603df046e11f1cc94b961c9616ad9aab422917eb92093ea | Exact 44 mm tall crop of the production USB column, with a 6 by 8 mm residual spine, 2 mm rounded transitions and the actual plug opening. Print on its rear face. Check the parked charging plug and inspect layer bonding before a controlled load fixture test; this coupon does not by itself validate the complete phone mount.
phone_pan_horn_stack_fit | 1 | first_print | True | Source mandatory fit | ../cad/output/coupons_stl/phone_pan_horn_stack_fit.stl | 92c72911c1c91508e596bf86d895ca00e4d9cd029e23eefa747c3330bb5501cf | Seat directly on the metal horn outer face. Four M3x6 screws with 0.5 mm washers of at most 6.0 mm outer diameter sit in the 1.5 mm deep counterbores and engage 2.0 mm of the 2.5 mm metal flange. Verify this stack with the real horn. Fit the spline retaining screw before the cradle. Four M3 nuts enter the bottom pockets for the cradle feet. This coupon is the complete production hub and can be retained after a passing fit test.
