silmoon04/mist-robot/design/hexapod_phone_quad_r5_20260912/printing/manufacturing_bom.csv

part | display_name | quantity | X_mm | Y_mm | Z_mm | source_stl | source_sha256 | stage | supports_required | note
body_deck | body deck | 1 | 178.401 | 206.0 | 4.0 | ../cad/output/print_stl/body_deck.stl | 5adb28864924d444e7f9fbd789fd68f843a7a10b6d34b4d2b4fc34a22f02bb19 | Production after coupon and one-leg fit | False | Review orientation in print guide.
hex_faceted_cover | hex faceted cover | 1 | 184.0 | 208.0 | 57.5 | ../cad/output/print_stl/hex_faceted_cover.stl | 936a54e250a9e793c1971f663cccdbb5ea059b2246f9ed32b52f21b22d2dc755 | Production after coupon and one-leg fit | False | Build with top face on bed; support only captive-nut recesses if needed.
pan_cover_spacer_1 | pan cover spacer 1 | 1 | 8.0 | 8.0 | 4.0 | ../cad/output/print_stl/pan_cover_spacer_1.stl | 3ce66418a3977fa44637c34de2ecd635f676789f21a6663e12a0a5b7ea02084b | Production after coupon and one-leg fit | False | Review orientation in print guide.
pan_cover_spacer_2 | pan cover spacer 2 | 1 | 8.0 | 8.0 | 4.0 | ../cad/output/print_stl/pan_cover_spacer_2.stl | 3ce66418a3977fa44637c34de2ecd635f676789f21a6663e12a0a5b7ea02084b | Production after coupon and one-leg fit | False | Review orientation in print guide.
pan_cover_spacer_3 | pan cover spacer 3 | 1 | 8.0 | 8.0 | 4.0 | ../cad/output/print_stl/pan_cover_spacer_3.stl | 3ce66418a3977fa44637c34de2ecd635f676789f21a6663e12a0a5b7ea02084b | Production after coupon and one-leg fit | False | Review orientation in print guide.
pan_cover_spacer_4 | pan cover spacer 4 | 1 | 8.0 | 8.0 | 4.0 | ../cad/output/print_stl/pan_cover_spacer_4.stl | 3ce66418a3977fa44637c34de2ecd635f676789f21a6663e12a0a5b7ea02084b | Production after coupon and one-leg fit | False | Review orientation in print guide.
battery_tray | battery tray | 1 | 112.0 | 71.0 | 32.0 | ../cad/output/print_stl/battery_tray.stl | 603534a0da593c6d7e4e19f7cf19902f45bcff364d569805d6fb87035c838446 | Production after coupon and one-leg fit | False | Review orientation in print guide.
power_distribution_tray | power distribution tray | 1 | 47.0 | 47.0 | 4.0 | ../cad/output/print_stl/power_distribution_tray.stl | 4e0da230e71bea122fc7b0cc088031b26fbb5927c3e58f82ebc1764d97271d41 | Production after coupon and one-leg fit | False | Review orientation in print guide.
servo_bus_adapter_tray | servo bus adapter tray | 1 | 19.0 | 38.0 | 22.0 | ../cad/output/print_stl/servo_bus_adapter_tray.stl | e9b4d020afaf338d1f078ba94c581d056bf2374fc835a8603b2e02986a6b7999 | Production after coupon and one-leg fit | False | Review orientation in print guide.
esp32_tray | esp32 tray | 1 | 19.0 | 33.6 | 22.0 | ../cad/output/print_stl/esp32_tray.stl | 727b4441b5ece9b36628398fd7405fd698ee13750fca56b95528e17610352961 | Production after coupon and one-leg fit | False | Review orientation in print guide.
ubec_tray | ubec tray | 1 | 45.0 | 23.0 | 6.0 | ../cad/output/print_stl/ubec_tray.stl | ad33b247cc5e0f8958b107632fca3e57dfe0ef7f93806b2e682bd91130c343ea | Production after coupon and one-leg fit | False | Review orientation in print guide.
phone_pan_servo_saddle | phone pan servo saddle | 1 | 68.0 | 50.0 | 22.5 | ../cad/output/print_stl/phone_pan_servo_saddle.stl | aa079dad57ddb0871e10a65cb4b85bc074500f72f8fe1de02a43bd1ba20e85f6 | Production after coupon and one-leg fit | False | Candidate only. Four M3x16 screws retain the original mounting-foot interface. Two pads at Z69 support the verified auxiliary shoulder. The stepped rear cover and auxiliary stub remain free. Connect both downward-facing bus plugs before fastening the module; route wires through the matching cover window X=-19.35 to -9.65, Y=-12.7 to 12.7. Side-loaded M3 nuts retain the 2.9 mm roof and original M3x10 cap stack.
phone_pan_servo_cap | phone pan servo cap | 1 | 52.23 | 48.0 | 14.2 | ../cad/output/print_stl/phone_pan_servo_cap.stl | ef7357722f95d5ff5722eaccdbb5954a12ea13cb510b8c9dfcad75597d1a843d | Production after coupon and one-leg fit | False | Candidate only. Two 2.5 mm lips contact the verified main-face shoulder near X=0, Y=+/-11. The raised tail cover is open above. Four M3x10 screws retain 0.3 mm ear-closing travel and 0.45 mm lateral adjustment. Stop when the case is retained without distortion; verify the actual C018 shoulder before production.
phone_pan_hub | phone pan hub | 1 | 48.0 | 58.6 | 5.0 | ../cad/output/print_stl/phone_pan_hub.stl | 92c72911c1c91508e596bf86d895ca00e4d9cd029e23eefa747c3330bb5501cf | Production after coupon and one-leg fit | False | Seat directly on the metal horn outer face. Four M3x6 screws with 0.5 mm washers of at most 6.0 mm outer diameter sit in the 1.5 mm deep counterbores and engage 2.0 mm of the 2.5 mm metal flange. Verify this stack with the real horn. Fit the spline retaining screw before the cradle. Four M3 nuts enter the bottom pockets for the cradle feet.
phone_cradle_rear_frame | phone cradle rear frame | 1 | 83.5 | 164.5 | 16.5 | ../cad/output/print_stl/phone_cradle_rear_frame.stl | d726550ab902c617177201b8e7626db48ad59ac3650e966428288e1127d050b9 | Production after coupon and one-leg fit | False | Print on the column rear faces at X=-8.5, with removable build-plate support beneath the central rear plate at X=-4.5. The USB spine retains 6 mm of material and rounded port transitions. Fit the outer post nuts through the 7.4 mm rear access wells, at the unchanged M3x16 stack plane. Fit four nuts from the phone side for the unchanged rear feet. Both camera ends and long-edge button relief remain open. Measure actual buttons, cameras and the parked charging plug before assembly.
phone_cradle_top_cap | phone cradle top cap | 1 | 23.5 | 164.5 | 19.0 | ../cad/output/print_stl/phone_cradle_top_cap.stl | c18801c2e640b04a32f9267109c076504d48f801d0323b9a62ef383ee141ea70 | Production after coupon and one-leg fit | False | Insert the landscape bare phone from above, then attach this cap with two M3x16 screws. The corner-seat top gap is 0.5 mm. The central long edge has button relief; front retention covers the outer corner regions, with both rear ends open for the camera.
phone_cradle_lower_clip_left | phone cradle lower clip left | 1 | 11.0 | 16.5 | 3.0 | ../cad/output/print_stl/phone_cradle_lower_clip_left.stl | 4db781092904fd35511c35968b307e2960a0bda0de63ba019b689b1d421a994a | Production after coupon and one-leg fit | False | One M3x16 screw attaches this short corner clip at the unchanged lower post hole. The two clips retain the lower corners independently. The landscape bare phone has 0.5 mm end clearance and 0.55 mm screen clearance; do not tighten against the glass.
phone_cradle_lower_clip_right | phone cradle lower clip right | 1 | 11.0 | 16.5 | 3.0 | ../cad/output/print_stl/phone_cradle_lower_clip_right.stl | e2b774fdbb8bcbc2da909ee0a43575577253e3c248cf7fdee7f92e922521a886 | Production after coupon and one-leg fit | False | One M3x16 screw attaches this short corner clip at the unchanged lower post hole. The two clips retain the lower corners independently. The landscape bare phone has 0.5 mm end clearance and 0.55 mm screen clearance; do not tighten against the glass.
phone_cradle_foot_left | phone cradle foot left | 1 | 37.0 | 30.5 | 14.0 | ../cad/output/print_stl/phone_cradle_foot_left.stl | f383e019d7845814156dedb37e1b2feaa29f2fa84ad9e59a8958453b38ff6a0a | Production after coupon and one-leg fit | False | Print on a broad Y side. Fit two M3x10 screws downward through the foot into hub nuts, then two M3x10 screws from behind into the frame nuts. Check tips remain behind the phone cavity.
phone_cradle_foot_right | phone cradle foot right | 1 | 37.0 | 30.5 | 14.0 | ../cad/output/print_stl/phone_cradle_foot_right.stl | a9a581b34e4bd3deabef61ce97877a8ea8765a100cf17a0ed01fb89daf48a288 | Production after coupon and one-leg fit | False | Print on a broad Y side. Fit two M3x10 screws downward through the foot into hub nuts, then two M3x10 screws from behind into the frame nuts. Check tips remain behind the phone cavity.
yaw_case_saddle | yaw case saddle | 4 | 61.23 | 52.0 | 30.0 | ../cad/output/print_stl/yaw_case_saddle.stl | ac4612018e8a0ccf1af1ce294ebfc54ee79cf865ffc54faf44d5b8411ba3651c | Production after coupon and one-leg fit | False | False
case_cap_yaw | case cap yaw | 4 | 61.23 | 27.0 | 4.0 | ../cad/output/print_stl/case_cap_yaw.stl | ba7a100b8b5196e6753f648ed50467291f1f49b6f6e39ed0bb6870916fe67a57 | Production after coupon and one-leg fit | False | False
coxa_upper_and_hip_saddle | coxa upper and hip saddle | 4 | 102.115 | 60.365 | 31.5 | ../cad/output/print_stl/coxa_upper_and_hip_saddle.stl | f70dd9f6fdd0b770bd1bd562c55632172a816529a25bcb934a9e27a546d9b03c | Production after coupon and one-leg fit | True | True
coxa_lower_auxiliary_arm | coxa lower auxiliary arm | 4 | 47.0 | 28.0 | 9.0 | ../cad/output/print_stl/coxa_lower_auxiliary_arm.stl | 4a2774ba90cd3cd3f0fdca26ae39872e8b87dfebd063e86bbd4f10f99ea42686 | Production after coupon and one-leg fit | False | False
case_cap_hip | case cap hip | 4 | 61.23 | 30.0 | 4.0 | ../cad/output/print_stl/case_cap_hip.stl | 07214bbd8f56404fc5d16642c07fb3103373f4fd7a5a25e97e8ac9f9aab39f8a | Production after coupon and one-leg fit | False | False
yaw_auxiliary_spacer_1 | yaw auxiliary spacer 1 | 4 | 5.8 | 5.8 | 11.6 | ../cad/output/print_stl/yaw_auxiliary_spacer_1.stl | 76eae4d6cfe9611f405b4b844d253368211e40da73b23727d7d420e0c25e3a86 | Production after coupon and one-leg fit | False | False
yaw_auxiliary_spacer_2 | yaw auxiliary spacer 2 | 4 | 5.8 | 5.8 | 11.6 | ../cad/output/print_stl/yaw_auxiliary_spacer_2.stl | 76eae4d6cfe9611f405b4b844d253368211e40da73b23727d7d420e0c25e3a86 | Production after coupon and one-leg fit | False | False
yaw_auxiliary_spacer_3 | yaw auxiliary spacer 3 | 4 | 5.8 | 5.8 | 11.6 | ../cad/output/print_stl/yaw_auxiliary_spacer_3.stl | 3602472470bee190351a33e77d9d8b394ec228b379e70e88d5302f5dcb88e81c | Production after coupon and one-leg fit | False | False
yaw_auxiliary_spacer_4 | yaw auxiliary spacer 4 | 4 | 5.8 | 5.8 | 11.6 | ../cad/output/print_stl/yaw_auxiliary_spacer_4.stl | 3602472470bee190351a33e77d9d8b394ec228b379e70e88d5302f5dcb88e81c | Production after coupon and one-leg fit | False | False
femur_main_and_knee_saddle | femur main and knee saddle | 4 | 122.115 | 46.5 | 42.0 | ../cad/output/print_stl/femur_main_and_knee_saddle.stl | 130ff26972778fc78ace4a9e7e7bec9f9a08b0042790b6ebc00673bc59a00ee3 | Production after coupon and one-leg fit | True | True
femur_auxiliary_cheek | femur auxiliary cheek | 4 | 93.0 | 46.5 | 8.0 | ../cad/output/print_stl/femur_auxiliary_cheek.stl | 0589771fd1d3407636a95b663ad5f0ae3ff43c7778c417b353e6fdb195e88703 | Production after coupon and one-leg fit | False | False
case_cap_knee | case cap knee | 4 | 61.23 | 27.0 | 4.0 | ../cad/output/print_stl/case_cap_knee.stl | 9d926173d96257e6473c5430ba0e05cac2bb52dffd2a07d9f5a29c3103bc328c | Production after coupon and one-leg fit | False | False
tibia_curved_main_and_foot | Straight tibia main and foot | 4 | 123.999 | 28.0 | 42.0 | ../cad/output/print_stl/tibia_curved_main_and_foot.stl | 843aed3223cc36c6d5f7523f5830007fac3a613fc26f95990be94b43859e3aa7 | Production after coupon and one-leg fit | True | True
tibia_auxiliary_cheek | Short tibia auxiliary bearing cheek | 4 | 65.0 | 28.0 | 5.1 | ../cad/output/print_stl/tibia_auxiliary_cheek.stl | 889c1710a4e182e42eaca52cf938de438aa12c05258669d5edb841ab4b776b32 | Production after coupon and one-leg fit | False | False
