silmoon04/mist-robot/design/single_leg_r6_20260914/output/print_bom.csv

part | quantity | file | dimensions_mm
yaw_case_saddle | 1 | print_stl/yaw_case_saddle.stl | [61.22999999999999, 52.0, 32.916580753730955]
case_cap_yaw | 1 | print_stl/case_cap_yaw.stl | [61.22999999999999, 27.000000000000004, 4.0]
coxa_upper_and_hip_saddle | 1 | print_stl/coxa_upper_and_hip_saddle.stl | [114.115, 60.364999999999995, 31.5]
coxa_lower_auxiliary_arm | 1 | print_stl/coxa_lower_auxiliary_arm.stl | [59.000000000000014, 28.0, 9.0]
case_cap_hip | 1 | print_stl/case_cap_hip.stl | [61.22999999999999, 30.000000000000004, 4.0]
yaw_auxiliary_spacer_1 | 1 | print_stl/yaw_auxiliary_spacer_1.stl | [5.800000000000001, 5.8, 11.600000000000001]
yaw_auxiliary_spacer_2 | 1 | print_stl/yaw_auxiliary_spacer_2.stl | [5.800000000000001, 5.8, 11.600000000000001]
yaw_auxiliary_spacer_3 | 1 | print_stl/yaw_auxiliary_spacer_3.stl | [5.8, 5.800000000000001, 11.600000000000001]
yaw_auxiliary_spacer_4 | 1 | print_stl/yaw_auxiliary_spacer_4.stl | [5.8, 5.800000000000001, 11.600000000000001]
femur_main_and_knee_saddle | 1 | print_stl/femur_main_and_knee_saddle.stl | [122.115, 46.50000000000046, 42.00000000000001]
femur_auxiliary_cheek | 1 | print_stl/femur_auxiliary_cheek.stl | [93.00000000000026, 46.5, 8.000000000000007]
case_cap_knee | 1 | print_stl/case_cap_knee.stl | [61.22999999999999, 27.000000000000004, 4.0]
tibia_curved_main_and_foot | 1 | print_stl/tibia_curved_main_and_foot.stl | [123.99879062933105, 28.0, 42.0]
tibia_auxiliary_cheek | 1 | print_stl/tibia_auxiliary_cheek.stl | [65.0, 28.0, 5.100000000000005]
bench_mounting_plate | 1 | print_stl/bench_mounting_plate.stl | [128.0, 88.0, 7.000000000000007]
