silmoon04/mist-robot/design/hexapod_phone_quad_20260912/cad/output/print_bom.csv

part | quantity | X_mm | Y_mm | Z_mm | solid_mass_g_each | file
body_deck | 1 | 178.4012331795944 | 206.0 | 4.0 | 107.98923461239096 | print_stl/body_deck.stl
hex_faceted_cover | 1 | 184.0 | 208.0 | 57.500000200000024 | 166.34300979471143 | print_stl/hex_faceted_cover.stl
pan_cover_spacer_1 | 1 | 8.0 | 8.0 | 4.0 | 0.2042839472552684 | print_stl/pan_cover_spacer_1.stl
pan_cover_spacer_2 | 1 | 8.0 | 8.0 | 4.0 | 0.2042839472552684 | print_stl/pan_cover_spacer_2.stl
pan_cover_spacer_3 | 1 | 8.0 | 8.0 | 4.0 | 0.2042839472552684 | print_stl/pan_cover_spacer_3.stl
pan_cover_spacer_4 | 1 | 8.0 | 8.0 | 4.0 | 0.2042839472552684 | print_stl/pan_cover_spacer_4.stl
battery_tray | 1 | 112.0 | 71.0 | 32.0 | 47.655771958050906 | print_stl/battery_tray.stl
power_distribution_tray | 1 | 47.000000000000014 | 47.000000000000014 | 4.000000000000007 | 5.523951999999993 | print_stl/power_distribution_tray.stl
servo_bus_adapter_tray | 1 | 19.0 | 38.0 | 22.0 | 5.503367999999997 | print_stl/servo_bus_adapter_tray.stl
esp32_tray | 1 | 19.0 | 33.6 | 22.0 | 4.313216000000001 | print_stl/esp32_tray.stl
ubec_tray | 1 | 45.0 | 23.0 | 6.000000000000002 | 2.8604319999999994 | print_stl/ubec_tray.stl
phone_pan_servo_saddle | 1 | 68.0 | 50.0 | 22.5 | 23.263030428140336 | print_stl/phone_pan_servo_saddle.stl
phone_pan_servo_cap | 1 | 52.230000000000004 | 48.0 | 14.200000000000017 | 9.657336363155808 | print_stl/phone_pan_servo_cap.stl
phone_pan_hub | 1 | 48.0 | 58.6 | 5.0 | 12.172502396065028 | print_stl/phone_pan_hub.stl
phone_cradle_rear_frame | 1 | 83.5 | 164.5 | 16.500000000000007 | 29.58936314028522 | print_stl/phone_cradle_rear_frame.stl
phone_cradle_top_cap | 1 | 23.5 | 164.5 | 19.00000000000003 | 21.31501073139957 | print_stl/phone_cradle_top_cap.stl
phone_cradle_lower_clip_left | 1 | 11.0 | 16.5 | 3.0000000000000018 | 0.6414053656997869 | print_stl/phone_cradle_lower_clip_left.stl
phone_cradle_lower_clip_right | 1 | 11.0 | 16.5 | 3.0000000000000018 | 0.6414053656997869 | print_stl/phone_cradle_lower_clip_right.stl
phone_cradle_foot_left | 1 | 37.0 | 30.5 | 14.000000000000004 | 5.104355771331911 | print_stl/phone_cradle_foot_left.stl
phone_cradle_foot_right | 1 | 37.0 | 30.500000000000004 | 14.000000000000004 | 5.104355771331911 | print_stl/phone_cradle_foot_right.stl
yaw_case_saddle | 4 | 61.22999999999999 | 52.0 | 30.0 | 24.5923023631695 | print_stl/yaw_case_saddle.stl
case_cap_yaw | 4 | 61.22999999999999 | 27.000000000000004 | 4.0 | 8.064823062799137 | print_stl/case_cap_yaw.stl
coxa_upper_and_hip_saddle | 4 | 107.115 | 55.565000000000005 | 31.5 | 33.04888507187101 | print_stl/coxa_upper_and_hip_saddle.stl
coxa_lower_auxiliary_arm | 4 | 50.5 | 28.0 | 9.0 | 11.703553871473302 | print_stl/coxa_lower_auxiliary_arm.stl
case_cap_hip | 4 | 61.22999999999999 | 27.000000000000004 | 4.000000000000009 | 8.064823062799139 | print_stl/case_cap_hip.stl
yaw_auxiliary_spacer_1 | 4 | 5.800000000000001 | 5.8 | 11.600000000000001 | 0.2494414513853804 | print_stl/yaw_auxiliary_spacer_1.stl
yaw_auxiliary_spacer_2 | 4 | 5.800000000000001 | 5.8 | 11.600000000000001 | 0.2494414513853804 | print_stl/yaw_auxiliary_spacer_2.stl
yaw_auxiliary_spacer_3 | 4 | 5.8 | 5.800000000000001 | 11.600000000000001 | 0.2494414513853804 | print_stl/yaw_auxiliary_spacer_3.stl
yaw_auxiliary_spacer_4 | 4 | 5.8 | 5.800000000000001 | 11.600000000000001 | 0.2494414513853804 | print_stl/yaw_auxiliary_spacer_4.stl
femur_main_and_knee_saddle | 4 | 122.115 | 46.50000000000046 | 42.00000000000001 | 44.375596668317534 | print_stl/femur_main_and_knee_saddle.stl
femur_auxiliary_cheek | 4 | 93.00000000000026 | 46.5 | 8.000000000000007 | 15.235577821814495 | print_stl/femur_auxiliary_cheek.stl
case_cap_knee | 4 | 61.22999999999999 | 27.000000000000004 | 4.0 | 8.064823062799139 | print_stl/case_cap_knee.stl
tibia_curved_main_and_foot | 4 | 123.99879062933105 | 42.0 | 42.0 | 28.54951121940895 | print_stl/tibia_curved_main_and_foot.stl
tibia_auxiliary_cheek | 4 | 77.0 | 42.0 | 8.000000000000004 | 7.814569995348682 | print_stl/tibia_auxiliary_cheek.stl
