silmoon04/mist-robot/design/hexapod_phone_quad_20260912/manufacturing/baseline_r3/printing/coupon_bom.csv

part | quantity | stage | source_stl | source_sha256 | note
coupon_case_saddle_endgap_0p2 | 1 | optional | ../cad/output/coupons_stl/coupon_case_saddle_endgap_0p2.stl | 36e6821366817bac646b7f36a3e956bc02afa70954e1c51e236f939ab4c76ec4
coupon_case_cap_endgap_0p2 | 1 | optional | ../cad/output/coupons_stl/coupon_case_cap_endgap_0p2.stl | 65646bb92188043dc1d6654e208ac47cadb2a54a0b95d84e7cc45c63a87de37f
coupon_case_saddle_endgap_0p3 | 1 | first_print | ../cad/output/coupons_stl/coupon_case_saddle_endgap_0p3.stl | 17447734042d832a2d0d9ab150c55d8ad4eea93ff7d30773b3632f70fad2fb62
coupon_case_cap_endgap_0p3 | 1 | first_print | ../cad/output/coupons_stl/coupon_case_cap_endgap_0p3.stl | 65646bb92188043dc1d6654e208ac47cadb2a54a0b95d84e7cc45c63a87de37f
coupon_case_saddle_endgap_0p4 | 1 | optional | ../cad/output/coupons_stl/coupon_case_saddle_endgap_0p4.stl | 464b7fca69e9e28ce8129e6b93aabeedf1d2e4603a526f55d5e4d049d23fd045
coupon_case_cap_endgap_0p4 | 1 | optional | ../cad/output/coupons_stl/coupon_case_cap_endgap_0p4.stl | 65646bb92188043dc1d6654e208ac47cadb2a54a0b95d84e7cc45c63a87de37f
coupon_horn_cheek_main | 1 | first_print | ../cad/output/coupons_stl/coupon_horn_cheek_main.stl | ece90ed4679611400b32a4a257c9821477bf3a25ef0df3f56e4e01e26b5705ed
coupon_horn_cheek_auxiliary | 1 | first_print | ../cad/output/coupons_stl/coupon_horn_cheek_auxiliary.stl | 5e571eda0ff7d1ff8c0ccef3f1bf01e799a8e24d1cb9ec8f0c57b4cdc938eb09
coupon_pitch_yoke_bridge_38 | 1 | first_print | ../cad/output/coupons_stl/coupon_pitch_yoke_bridge_38.stl | e1d19f4b16fe954254f0a472b7b93cc298469c772bb359e8342c65a094785459
coupon_m3_clearance_3p2_3p4_3p6 | 1 | first_print | ../cad/output/coupons_stl/coupon_m3_clearance_3p2_3p4_3p6.stl | 6b4a6089013be8df457c1ae33dfcd8139490135b97bfa51a472e867f98385c97
coupon_yaw_spacer_10p2 | 1 | first_print | ../cad/output/coupons_stl/coupon_yaw_spacer_10p2.stl | da08dda4949ad909d24c58ddae7aded2643201e3162cb0983fc6bb3a12f2291d
coupon_yaw_spacer_10p5 | 1 | first_print | ../cad/output/coupons_stl/coupon_yaw_spacer_10p5.stl | 9c64ef828c7c10e1a5d7dc6ee96a16f81ecf9935bb2cbdd683d56d22c825e1f5
coupon_yaw_spacer_10p8 | 1 | first_print | ../cad/output/coupons_stl/coupon_yaw_spacer_10p8.stl | a079bd90614628bfea0c306975d62d42d3d12c425e8cd231ff7e788f9637ccee
coupon_femur_bridge_load_main | 1 | first_print | ../cad/output/coupons_stl/coupon_femur_bridge_load_main.stl | a61876df9b58785c6d4bf0cc883f8920d9d4b50de9a846372261dfccba53585c | Actual R3 production section for sacrificial fixture tests.
coupon_femur_bridge_load_aux | 1 | first_print | ../cad/output/coupons_stl/coupon_femur_bridge_load_aux.stl | 6344c3ee285b346b28407cbf14191a0b95cc5004c8f5b6be1c0c938a93d015ed | Actual R3 production section for sacrificial fixture tests.
coupon_coxa_staggered_nut_post | 1 | first_print | ../cad/output/coupons_stl/coupon_coxa_staggered_nut_post.stl | 55a5ecd75f6f9c78457af7c808116a3d82f120be488a72c644c286feb09673a8 | Actual R3 production section for sacrificial fixture tests.
phone_fit_0p3_tray | 1 | optional | ../cad/output/coupons_stl/phone_fit_0p3_tray.stl | 862cea13ee2af2587fb6a097c3ea31ebbbcb32aa330f0877ec967dd3c21185a5 | Assemble with the two matching corner clips and two M3x16 screws. This full-width landscape coupon uses 0.3 mm end and front clearance; test the bare phone bottom 24.8 mm. Print on its reinforced column backs with removable support beneath the central rear plate. Start with 0.5 mm; alternative full-width fits are optional.
phone_fit_0p3_clip_left | 1 | optional | ../cad/output/coupons_stl/phone_fit_0p3_clip_left.stl | 4db781092904fd35511c35968b307e2960a0bda0de63ba019b689b1d421a994a | Matching short corner clip for the 0.3 mm phone fit tray. Use one M3x16 screw.
phone_fit_0p3_clip_right | 1 | optional | ../cad/output/coupons_stl/phone_fit_0p3_clip_right.stl | e2b774fdbb8bcbc2da909ee0a43575577253e3c248cf7fdee7f92e922521a886 | Matching short corner clip for the 0.3 mm phone fit tray. Use one M3x16 screw.
phone_fit_0p5_tray | 1 | first_print | ../cad/output/coupons_stl/phone_fit_0p5_tray.stl | 1cb7793b785b5346cfc905e5defc0f555aadba2a473a62ab971564300c8be69e | Assemble with the two matching corner clips and two M3x16 screws. This full-width landscape coupon uses 0.5 mm end and front clearance; test the bare phone bottom 24.8 mm. Print on its reinforced column backs with removable support beneath the central rear plate. Start with 0.5 mm; alternative full-width fits are optional.
phone_fit_0p5_clip_left | 1 | first_print | ../cad/output/coupons_stl/phone_fit_0p5_clip_left.stl | 4db781092904fd35511c35968b307e2960a0bda0de63ba019b689b1d421a994a | Matching short corner clip for the 0.5 mm phone fit tray. Use one M3x16 screw.
phone_fit_0p5_clip_right | 1 | first_print | ../cad/output/coupons_stl/phone_fit_0p5_clip_right.stl | e2b774fdbb8bcbc2da909ee0a43575577253e3c248cf7fdee7f92e922521a886 | Matching short corner clip for the 0.5 mm phone fit tray. Use one M3x16 screw.
phone_fit_0p7_tray | 1 | optional | ../cad/output/coupons_stl/phone_fit_0p7_tray.stl | 596dd1029a9ec9598512fac881c3420b6a28ad262736f92e8e11b14b72e2bd73 | Assemble with the two matching corner clips and two M3x16 screws. This full-width landscape coupon uses 0.7 mm end and front clearance; test the bare phone bottom 24.8 mm. Print on its reinforced column backs with removable support beneath the central rear plate. Start with 0.5 mm; alternative full-width fits are optional.
phone_fit_0p7_clip_left | 1 | optional | ../cad/output/coupons_stl/phone_fit_0p7_clip_left.stl | 9dd0e932d7d65ff46c3d2c60ca93a6cd381a896fcdb3bcee694985d8565d6942 | Matching short corner clip for the 0.7 mm phone fit tray. Use one M3x16 screw.
phone_fit_0p7_clip_right | 1 | optional | ../cad/output/coupons_stl/phone_fit_0p7_clip_right.stl | da1cdf2f33e04ae48269bdc14c6aeb500a32cf87e443c90acc304e7c5b9d408e | Matching short corner clip for the 0.7 mm phone fit tray. Use one M3x16 screw.
phone_usb_spine_6mm_coupon | 1 | first_print | ../cad/output/coupons_stl/phone_usb_spine_6mm_coupon.stl | ac4f363b6b33c658e603df046e11f1cc94b961c9616ad9aab422917eb92093ea | Exact 44 mm tall crop of the production USB column, with a 6 by 8 mm residual spine, 2 mm rounded transitions and the actual plug opening. Print on its rear face. Check the parked charging plug and inspect layer bonding before a controlled load fixture test; this coupon does not by itself validate the complete phone mount.
phone_pan_horn_stack_fit | 1 | first_print | ../cad/output/coupons_stl/phone_pan_horn_stack_fit.stl | 92c72911c1c91508e596bf86d895ca00e4d9cd029e23eefa747c3330bb5501cf | Seat directly on the metal horn outer face. Four M3x6 screws with 0.5 mm washers of at most 6.0 mm outer diameter sit in the 1.5 mm deep counterbores and engage 2.0 mm of the 2.5 mm metal flange. Verify this stack with the real horn. Fit the spline retaining screw before the cradle. Four M3 nuts enter the bottom pockets for the cradle feet. This coupon is the complete production hub and can be retained after a passing fit test.
