silmoon04/mist-robot/design/hexapod_phone_quad_20260912/manufacturing/baseline_r3/printing/manufacturing_bom.csv

part | quantity | X_mm | Y_mm | Z_mm | source_stl | source_sha256 | stage | supports_required | note
body_deck | 1 | 178.401 | 206.0 | 4.0 | ../cad/output/print_stl/body_deck.stl | fcd4947f6157b533a4d5815e6e78da8e0ad3950f7a57a2c6151acf4b5d7e88c0 | Production after coupon and one-leg fit | False | Review orientation in print guide.
hex_faceted_cover | 1 | 184.0 | 208.0 | 57.5 | ../cad/output/print_stl/hex_faceted_cover.stl | a3bb8b0d50cb3eb0288f0b3ba7ff7b69ca9e46a684d27aac6d3a3294e29b4426 | Production after coupon and one-leg fit | False | Build with top face on bed; support only captive-nut recesses if needed.
pan_cover_spacer_1 | 1 | 8.0 | 8.0 | 4.0 | ../cad/output/print_stl/pan_cover_spacer_1.stl | 3ce66418a3977fa44637c34de2ecd635f676789f21a6663e12a0a5b7ea02084b | Production after coupon and one-leg fit | False | Review orientation in print guide.
pan_cover_spacer_2 | 1 | 8.0 | 8.0 | 4.0 | ../cad/output/print_stl/pan_cover_spacer_2.stl | 3ce66418a3977fa44637c34de2ecd635f676789f21a6663e12a0a5b7ea02084b | Production after coupon and one-leg fit | False | Review orientation in print guide.
pan_cover_spacer_3 | 1 | 8.0 | 8.0 | 4.0 | ../cad/output/print_stl/pan_cover_spacer_3.stl | 3ce66418a3977fa44637c34de2ecd635f676789f21a6663e12a0a5b7ea02084b | Production after coupon and one-leg fit | False | Review orientation in print guide.
pan_cover_spacer_4 | 1 | 8.0 | 8.0 | 4.0 | ../cad/output/print_stl/pan_cover_spacer_4.stl | 3ce66418a3977fa44637c34de2ecd635f676789f21a6663e12a0a5b7ea02084b | Production after coupon and one-leg fit | False | Review orientation in print guide.
battery_tray | 1 | 112.0 | 71.0 | 32.0 | ../cad/output/print_stl/battery_tray.stl | 603534a0da593c6d7e4e19f7cf19902f45bcff364d569805d6fb87035c838446 | Production after coupon and one-leg fit | False | Review orientation in print guide.
power_distribution_tray | 1 | 47.0 | 47.0 | 4.0 | ../cad/output/print_stl/power_distribution_tray.stl | 2d20fd1a99c27cd4b8f3ec1e86c7cf2078edf0a7169b1afd7776538a8dcc0a5e | Production after coupon and one-leg fit | False | Review orientation in print guide.
servo_bus_adapter_tray | 1 | 19.0 | 38.0 | 22.0 | ../cad/output/print_stl/servo_bus_adapter_tray.stl | aba36803811366231e812a0d4d52176944f261112814cdfe0f61bf85f52d5d07 | Production after coupon and one-leg fit | False | Review orientation in print guide.
esp32_tray | 1 | 19.0 | 33.6 | 22.0 | ../cad/output/print_stl/esp32_tray.stl | 18cc7bb75aa222f49c2a920ee881c3b329e10e665f0afc19a79af59380ea67f8 | Production after coupon and one-leg fit | False | Review orientation in print guide.
ubec_tray | 1 | 45.0 | 23.0 | 6.0 | ../cad/output/print_stl/ubec_tray.stl | ad33b247cc5e0f8958b107632fca3e57dfe0ef7f93806b2e682bd91130c343ea | Production after coupon and one-leg fit | False | Review orientation in print guide.
phone_pan_servo_saddle | 1 | 68.0 | 50.0 | 22.5 | ../cad/output/print_stl/phone_pan_servo_saddle.stl | ed8bf510dd5554546d635e5f2de65b66266ecc2b2ff9948838c23adcea0359a6 | Production after coupon and one-leg fit | False | Four M3x16 screws pass through the 4 mm feet and 4 mm cover spacers into captured body nuts. Seat the servo on the lower ledges. Slide four M3 nuts inward through the outward-facing slots at Z80.9 to 83.6 before fitting the cap; a 2.9 mm roof retains them against cap screw tension. Bridge the short pocket ceilings without internal support.
phone_pan_servo_cap | 1 | 52.23 | 48.0 | 14.2 | ../cad/output/print_stl/phone_pan_servo_cap.stl | c23e7a4f07037b36772c9d9ec9c2b0f5ff97c975c820cd113c2e69c7517c7140 | Production after coupon and one-leg fit | False | Four M3x10 screws secure the cap to the saddle. Upper lips contact the nominal case top before the ears close: the ears retain 0.3 mm tightening travel. Stop when the case is retained without distortion. Slots allow 0.45 mm lateral adjustment each way.
phone_pan_hub | 1 | 48.0 | 58.6 | 5.0 | ../cad/output/print_stl/phone_pan_hub.stl | 92c72911c1c91508e596bf86d895ca00e4d9cd029e23eefa747c3330bb5501cf | Production after coupon and one-leg fit | False | Seat directly on the metal horn outer face. Four M3x6 screws with 0.5 mm washers of at most 6.0 mm outer diameter sit in the 1.5 mm deep counterbores and engage 2.0 mm of the 2.5 mm metal flange. Verify this stack with the real horn. Fit the spline retaining screw before the cradle. Four M3 nuts enter the bottom pockets for the cradle feet.
phone_cradle_rear_frame | 1 | 83.5 | 164.5 | 16.5 | ../cad/output/print_stl/phone_cradle_rear_frame.stl | d726550ab902c617177201b8e7626db48ad59ac3650e966428288e1127d050b9 | Production after coupon and one-leg fit | False | Print on the column rear faces at X=-8.5, with removable build-plate support beneath the central rear plate at X=-4.5. The USB spine retains 6 mm of material and rounded port transitions. Fit the outer post nuts through the 7.4 mm rear access wells, at the unchanged M3x16 stack plane. Fit four nuts from the phone side for the unchanged rear feet. Both camera ends and long-edge button relief remain open. Measure actual buttons, cameras and the parked charging plug before assembly.
phone_cradle_top_cap | 1 | 23.5 | 164.5 | 19.0 | ../cad/output/print_stl/phone_cradle_top_cap.stl | c18801c2e640b04a32f9267109c076504d48f801d0323b9a62ef383ee141ea70 | Production after coupon and one-leg fit | False | Insert the landscape bare phone from above, then attach this cap with two M3x16 screws. The corner-seat top gap is 0.5 mm. The central long edge has button relief; front retention covers the outer corner regions, with both rear ends open for the camera.
phone_cradle_lower_clip_left | 1 | 11.0 | 16.5 | 3.0 | ../cad/output/print_stl/phone_cradle_lower_clip_left.stl | 4db781092904fd35511c35968b307e2960a0bda0de63ba019b689b1d421a994a | Production after coupon and one-leg fit | False | One M3x16 screw attaches this short corner clip at the unchanged lower post hole. The two clips retain the lower corners independently. The landscape bare phone has 0.5 mm end clearance and 0.55 mm screen clearance; do not tighten against the glass.
phone_cradle_lower_clip_right | 1 | 11.0 | 16.5 | 3.0 | ../cad/output/print_stl/phone_cradle_lower_clip_right.stl | e2b774fdbb8bcbc2da909ee0a43575577253e3c248cf7fdee7f92e922521a886 | Production after coupon and one-leg fit | False | One M3x16 screw attaches this short corner clip at the unchanged lower post hole. The two clips retain the lower corners independently. The landscape bare phone has 0.5 mm end clearance and 0.55 mm screen clearance; do not tighten against the glass.
phone_cradle_foot_left | 1 | 37.0 | 30.5 | 14.0 | ../cad/output/print_stl/phone_cradle_foot_left.stl | f383e019d7845814156dedb37e1b2feaa29f2fa84ad9e59a8958453b38ff6a0a | Production after coupon and one-leg fit | False | Print on a broad Y side. Fit two M3x10 screws downward through the foot into hub nuts, then two M3x10 screws from behind into the frame nuts. Check tips remain behind the phone cavity.
phone_cradle_foot_right | 1 | 37.0 | 30.5 | 14.0 | ../cad/output/print_stl/phone_cradle_foot_right.stl | a9a581b34e4bd3deabef61ce97877a8ea8765a100cf17a0ed01fb89daf48a288 | Production after coupon and one-leg fit | False | Print on a broad Y side. Fit two M3x10 screws downward through the foot into hub nuts, then two M3x10 screws from behind into the frame nuts. Check tips remain behind the phone cavity.
yaw_case_saddle | 4 | 61.0 | 52.0 | 30.0 | ../cad/output/print_stl/yaw_case_saddle.stl | baf784c00feef3e888a14422ffe59d7fedaea3916489382b8916a8baf46a58e0 | Production after coupon and one-leg fit | False | False
case_cap_yaw | 4 | 61.0 | 27.0 | 4.0 | ../cad/output/print_stl/case_cap_yaw.stl | 65646bb92188043dc1d6654e208ac47cadb2a54a0b95d84e7cc45c63a87de37f | Production after coupon and one-leg fit | False | False
coxa_upper_and_hip_saddle | 4 | 104.5 | 55.565 | 31.5 | ../cad/output/print_stl/coxa_upper_and_hip_saddle.stl | e464fc542b622c10028cccbb064b5bb9806c207c961cf21dc8da8fdc5655b8e4 | Production after coupon and one-leg fit | True | True
coxa_lower_auxiliary_arm | 4 | 50.5 | 28.0 | 9.0 | ../cad/output/print_stl/coxa_lower_auxiliary_arm.stl | fd0569f39777dd3dea5c809994dcecba2b150da5ce5ffd9dafecef7b4d165256 | Production after coupon and one-leg fit | False | False
case_cap_hip | 4 | 61.0 | 27.0 | 4.0 | ../cad/output/print_stl/case_cap_hip.stl | 2617d195cbf2581a3f4508823d0fd381b4f524e9f0172979685c183df70dc11e | Production after coupon and one-leg fit | False | False
yaw_auxiliary_spacer_1 | 4 | 5.8 | 5.8 | 10.5 | ../cad/output/print_stl/yaw_auxiliary_spacer_1.stl | 7dbd8d059452328edfed78a05b6e0e00930a6e06ee932a7ccdf9fbd4dd650023 | Production after coupon and one-leg fit | False | False
yaw_auxiliary_spacer_2 | 4 | 5.8 | 5.8 | 10.5 | ../cad/output/print_stl/yaw_auxiliary_spacer_2.stl | 7dbd8d059452328edfed78a05b6e0e00930a6e06ee932a7ccdf9fbd4dd650023 | Production after coupon and one-leg fit | False | False
yaw_auxiliary_spacer_3 | 4 | 5.8 | 5.8 | 10.5 | ../cad/output/print_stl/yaw_auxiliary_spacer_3.stl | 5ffce60b83245ff20ed5dbe5ad1b28bd867bf535dc61797f46bf9cc457ab63ca | Production after coupon and one-leg fit | False | False
yaw_auxiliary_spacer_4 | 4 | 5.8 | 5.8 | 10.5 | ../cad/output/print_stl/yaw_auxiliary_spacer_4.stl | 5ffce60b83245ff20ed5dbe5ad1b28bd867bf535dc61797f46bf9cc457ab63ca | Production after coupon and one-leg fit | False | False
femur_main_and_knee_saddle | 4 | 144.5 | 38.0 | 42.0 | ../cad/output/print_stl/femur_main_and_knee_saddle.stl | 7a7470147380d178c17a10639f07da34f7335e1b2c4f73b03229339f81fb1276 | Production after coupon and one-leg fit | True | True
femur_auxiliary_cheek | 4 | 93.0 | 38.0 | 8.0 | ../cad/output/print_stl/femur_auxiliary_cheek.stl | f240761efb8cbdfbf1b274e7998e452812520e8dda2b914efd3247dcdac20143 | Production after coupon and one-leg fit | False | False
case_cap_knee | 4 | 61.0 | 27.0 | 4.0 | ../cad/output/print_stl/case_cap_knee.stl | 905d5752d783ff2bba5bfaac3291241837e89f74103aa8c574b7f3f0bfc92695 | Production after coupon and one-leg fit | False | False
tibia_curved_main_and_foot | 4 | 123.999 | 42.0 | 42.0 | ../cad/output/print_stl/tibia_curved_main_and_foot.stl | e53fe9eb1a7cdf13bee17168c32ce6b022c3e7e5b4c3e55aac06a0cda04cef1c | Production after coupon and one-leg fit | True | True
tibia_auxiliary_cheek | 4 | 77.0 | 42.0 | 8.0 | ../cad/output/print_stl/tibia_auxiliary_cheek.stl | 69de94fc209e1ddd00335972bdedbbf0a225fafd702be5c9e3c54c688b7a865b | Production after coupon and one-leg fit | False | False
