silmoon04/mist-robot/mist_3d/MIST_print_tests/manifest.csv

name | file | category | qty | print_orientation | support | purpose | dimensions_mm | notes | stl_path | gcode_path | cura_time | cura_filament_mm | cura_material_g
cal_hole_sizes | cal_hole_sizes | calibration | 1 | flat on bed | none needed | Vertical-hole shrink test, 1.8-3.4mm, debossed labels are diameter x10. | 116.0 x 30.0 x 4.0 | Pick M2/M2.5/M3 tap + clearance sizes from this. | stl/cal_hole_sizes.stl
cal_screw_boss | cal_screw_boss | calibration | 1 | flat on bed | none needed | Screw boss split/bite test 1.6-2.8mm pilot, labels are diameter x10. | 112.0 x 30.0 x 10.0 | Drive real M2/M2.5/M3 screws in; note which pilots split. | stl/cal_screw_boss.stl
cal_clearance_pegs | cal_clearance_pegs | calibration | 1 | flat on bed | none needed | 5mm pin clearance test 0.1-0.6mm with three removable handled pegs. | 171.5 x 34.0 x 12.0 | Labels are clearance x10. Pegs are separate bodies with feet. | stl/cal_clearance_pegs.stl
cal_cable_tunnels | cal_cable_tunnels | calibration | 1 | flat on bed, channels up | none needed | Open-top cable channels 4/6/8/10mm for 5264 servo leads and silicone wire. | 76.0 x 30.0 x 8.0 | Labels debossed in channel floors. | stl/cal_cable_tunnels.stl
fit_servo_bracket_c03 | fit_servo_bracket_c03 | servo_fit | 1 | flat on bed | none needed | STS3215 ear-hang bracket plate, 0.3mm body clearance. | 70.0 x 44.0 x 6.0 | Servo hangs by ears exactly like a real mount. Caliper-check ear dims first. | stl/fit_servo_bracket_c03.stl
fit_servo_bracket_c05 | fit_servo_bracket_c05 | servo_fit | 1 | flat on bed | none needed | STS3215 ear-hang bracket plate, 0.5mm body clearance. | 70.0 x 44.0 x 6.0 | Print both, keep whichever clearance fits best. | stl/fit_servo_bracket_c05.stl
fit_horn_disc | fit_horn_disc | servo_fit | 1 | flat on bed | none needed | 25T horn recess + slotted bolt-circle (12-16mm) + M3 center. | 32.0 x 32.0 x 5.0 | Slots absorb unknown horn bolt circle; measure and lock in. | stl/fit_horn_disc.stl
fit_wheel_slice_76 | fit_wheel_slice_76 | servo_fit | 1 | web down on bed | tree fills the shallow horn recess; pops out | 76mm OD wheel slice with horn recess. Tests wheel-mode mounting and wobble. | 76.0 x 76.0 x 12.0 | Full wheel is 30mm wide; this 12mm slice tests the interface first. | stl/fit_wheel_slice_76.stl
dummy_sts3215_solid | dummy_sts3215_solid | servo_fit | 2 | upright, bottom on bed | tree under the 5.9mm ear overhangs | Solid STS3215 stand-in with ears/shaft/cable stub; mates with bracket plates. | 57.1 x 24.7 x 39.0 | Ear position/pitch not datasheet-confirmed - caliper-check on arrival. | stl/dummy_sts3215_solid.stl
hinge_horn_lug | hinge_horn_lug | hinge_linkage | 1 | flat on bed | none needed | Direct horn-to-link lug (single-shear). Compactness reference only. | 60.0 x 32.0 x 5.0 | Use double-shear for real load paths. | stl/hinge_horn_lug.stl
hinge_clevis_tongue | hinge_clevis_tongue | hinge_linkage | 2 | flat on bed | none needed | Double-shear clevis (7mm gap) + matching 6mm tongue link, M3 pin. | 54.0 x 44.0 x 20.0 | Best starting hinge. Add one washer per side. A 2-DOF leg chain (hip+knee) needs 2. | stl/hinge_clevis_tongue.stl
hinge_knuckle_m3 | hinge_knuckle_m3 | hinge_linkage | 1 | flat on bed | none needed | Two-piece coaxial knuckle hinge, M3 pin, free +/-90deg travel. | 80.0 x 64.0 x 11.6 | Slide halves together sideways, then pin. | stl/hinge_knuckle_m3.stl
hinge_flexure_leaves | hinge_flexure_leaves | hinge_linkage | 1 | flat on bed | none needed | PLA flexure comparison, 2.0/1.6/1.2mm leaves printed on the bed. | 92.0 x 18.0 x 5.0 | Comparison only - not a leg hinge strategy. | stl/hinge_flexure_leaves.stl
link_rocker | link_rocker | hinge_linkage | 1 | flat on bed | none needed | Three-arm rocker with 14/20/26mm radii, horn recess so it mounts on a servo. | 57.9 x 66.9 x 5.0 | For pushrod/bellcrank experiments. | stl/link_rocker.stl
link_fourbar_pair | link_fourbar_pair | hinge_linkage | 1 | flat on bed | none needed | Two SEPARATE parallel bars, 45-95mm holes at 10mm, for four-bar tests. | 115.0 x 30.0 x 4.0 | v1 had these fused together - now they are two bodies. | stl/link_fourbar_pair.stl
link_coupler_pair | link_coupler_pair | hinge_linkage | 1 | flat on bed | none needed | Two short links (20-60mm holes) - coupler + ground to close a four-bar loop. | 80.0 x 30.0 x 4.0 | A four-bar needs 4 links: 2 parallel bars + coupler + ground (or bolt to the pose grid as ground). | stl/link_coupler_pair.stl
link_femur_adjustable | link_femur_adjustable | leg_geometry | 2 | flat on bed | none needed | Adjustable femur beam 60-110mm axis-to-axis in 5mm steps (staggered rows). | 130.0 x 22.0 x 5.0 | Edge row = 10mm grid, far row = +5mm. CAD baseline 65mm. Print 2 for a two-leg stance test. | stl/link_femur_adjustable.stl
link_tibia_adjustable | link_tibia_adjustable | leg_geometry | 2 | flat on bed | none needed | Adjustable tibia beam 75-120mm axis-to-axis in 5mm steps. | 140.0 x 22.0 x 5.0 | CAD baseline 85mm. Print 2 for a two-leg stance test. | stl/link_tibia_adjustable.stl
jig_pose_grid | jig_pose_grid | leg_geometry | 1 | flat on bed | none needed | 150x90 15mm-grid M3 pose board for pinning beams into stance shapes. | 150.0 x 90.0 x 3.0 | Bolt beams to any grid hole with M3x12+nut. | stl/jig_pose_grid.stl
dummy_lipo_hoovo_2200 | dummy_lipo_hoovo_2200 | component_dummy | 1 | open shell upward | none needed | HOOVO 3S 2200 envelope (104x34.5x24.5, ~180g) - the pack that was ordered. | 104.0 x 34.5 x 24.5 | Empty envelope, not a mass dummy. Optional print. | stl/dummy_lipo_hoovo_2200.stl
dummy_xt90s_loop | dummy_xt90s_loop | component_dummy | 1 | open shell upward | none needed | XT90-S anti-spark loop key hand-clearance envelope. | 70.0 x 28.0 x 18.0 | Empty envelope, not a mass dummy. Optional print. | stl/dummy_xt90s_loop.stl
dummy_ubec_5v5a | dummy_ubec_5v5a | component_dummy | 1 | open shell upward | none needed | 5V 5A UBEC approximate envelope. | 43.0 x 21.0 x 8.0 | Empty envelope, not a mass dummy. Optional print. | stl/dummy_ubec_5v5a.stl
dummy_xt60_xt30_pdb | dummy_xt60_xt30_pdb | component_dummy | 1 | open shell upward | none needed | XT60-to-8xXT30 PDB approximate envelope. | 45.0 x 45.0 x 18.0 | Empty envelope, not a mass dummy. Optional print. | stl/dummy_xt60_xt30_pdb.stl
dummy_phone_mi9se | dummy_phone_mi9se | component_dummy | 1 | open shell upward | none needed | Mi 9 SE slab. Prefer the real phone for layout; print only if needed. | 147.5 x 70.5 x 7.4 | Empty envelope, not a mass dummy. Optional print. | stl/dummy_phone_mi9se.stl
dummy_esp32_devkit | dummy_esp32_devkit | component_dummy | 1 | open shell upward | none needed | ESP32 DevKitC approximate envelope. | 55.0 x 29.0 x 13.0 | Empty envelope, not a mass dummy. Optional print. | stl/dummy_esp32_devkit.stl
dummy_bus_servo_adapter | dummy_bus_servo_adapter | component_dummy | 1 | open shell upward | none needed | Bus Servo Adapter approximate envelope. | 42.0 x 33.0 x 12.0 | Empty envelope, not a mass dummy. Optional print. | stl/dummy_bus_servo_adapter.stl
plate_1_calibration | plate_1_calibration | combined_plate | 1 | combined plate, parts arranged flat on bed | tree, buildplate-only; only wheel recess and servo-dummy ears use it | Combined printable plate: cal_hole_sizes, cal_screw_boss, cal_clearance_pegs, cal_cable_tunnels | 171.5 x 154.0 x 12.0 | If any part fails, print the individual STL instead. | plates/plate_1_calibration.stl
plate_2_servo_fit | plate_2_servo_fit | combined_plate | 1 | combined plate, parts arranged flat on bed | tree, buildplate-only; only wheel recess and servo-dummy ears use it | Combined printable plate: fit_servo_bracket_c03, fit_servo_bracket_c05, fit_horn_disc, fit_wheel_slice_76, dummy_sts3215_solid | 192.0 x 130.0 x 39.0 | If any part fails, print the individual STL instead. | plates/plate_2_servo_fit.stl
plate_3_hinges_linkages | plate_3_hinges_linkages | combined_plate | 1 | combined plate, parts arranged flat on bed | tree, buildplate-only; only wheel recess and servo-dummy ears use it | Combined printable plate: hinge_horn_lug, hinge_clevis_tongue, hinge_knuckle_m3, hinge_flexure_leaves, link_rocker, link_fourbar_pair | 182.9 x 194.9 x 20.0 | If any part fails, print the individual STL instead. | plates/plate_3_hinges_linkages.stl
plate_4_leg_geometry | plate_4_leg_geometry | combined_plate | 1 | combined plate, parts arranged flat on bed | tree, buildplate-only; only wheel recess and servo-dummy ears use it | Combined printable plate: link_femur_adjustable, link_tibia_adjustable, jig_pose_grid | 150.0 x 154.0 x 5.0 | If any part fails, print the individual STL instead. | plates/plate_4_leg_geometry.stl
plate_7_second_leg | plate_7_second_leg | combined_plate | 1 | combined plate, parts arranged flat on bed | tree, buildplate-only; only wheel recess and servo-dummy ears use it | Combined printable plate: link_femur_adjustable, link_tibia_adjustable, hinge_clevis_tongue, link_coupler_pair | 144.0 x 108.0 x 20.0 | If any part fails, print the individual STL instead. | plates/plate_7_second_leg.stl
plate_5_dummies_power | plate_5_dummies_power | combined_plate | 1 | combined plate, parts arranged flat on bed | tree, buildplate-only; only wheel recess and servo-dummy ears use it | Combined printable plate: dummy_lipo_hoovo_2200, dummy_xt90s_loop, dummy_ubec_5v5a, dummy_xt60_xt30_pdb | 184.0 x 89.5 x 24.5 | If any part fails, print the individual STL instead. | plates/plate_5_dummies_power.stl
plate_6_dummies_boards | plate_6_dummies_boards | combined_plate | 1 | combined plate, parts arranged flat on bed | tree, buildplate-only; only wheel recess and servo-dummy ears use it | Combined printable plate: dummy_phone_mi9se, dummy_esp32_devkit, dummy_bus_servo_adapter | 147.5 x 113.5 x 13.0 | If any part fails, print the individual STL instead. | plates/plate_6_dummies_boards.stl
