silmoon04/mist-robot/design/mist_v2_20260906/coupons/feedback_BED1.csv

feature_id | interface | nominal_mm | cad_mm | measured_part_mm | measured_hardware_mm | fit_result | print_material | layer_mm | wall_count | xy_compensation_mm | notes
bearing_OD8_025 | bearing_OD8 | 8 | 8.25 |  |  | not_tested
bearing_OD8_040 | bearing_OD8 | 8 | 8.4 |  |  | not_tested
bearing_OD8_055 | bearing_OD8 | 8 | 8.55 |  |  | not_tested
bearing_OD8_070 | bearing_OD8 | 8 | 8.7 |  |  | not_tested
bearing_OD10_025 | bearing_OD10 | 10 | 10.25 |  |  | not_tested
bearing_OD10_040 | bearing_OD10 | 10 | 10.4 |  |  | not_tested
bearing_OD10_055 | bearing_OD10 | 10 | 10.55 |  |  | not_tested
bearing_OD10_070 | bearing_OD10 | 10 | 10.7 |  |  | not_tested
bearing_OD11_025 | bearing_OD11 | 11 | 11.25 |  |  | not_tested
bearing_OD11_040 | bearing_OD11 | 11 | 11.4 |  |  | not_tested
bearing_OD11_055 | bearing_OD11 | 11 | 11.55 |  |  | not_tested
bearing_OD11_070 | bearing_OD11 | 11 | 11.7 |  |  | not_tested
bearing_OD13_025 | bearing_OD13 | 13 | 13.25 |  |  | not_tested
bearing_OD13_040 | bearing_OD13 | 13 | 13.4 |  |  | not_tested
bearing_OD13_055 | bearing_OD13 | 13 | 13.55 |  |  | not_tested
bearing_OD13_070 | bearing_OD13 | 13 | 13.7 |  |  | not_tested
bearing_OD14_025 | bearing_OD14 | 14 | 14.25 |  |  | not_tested
bearing_OD14_040 | bearing_OD14 | 14 | 14.4 |  |  | not_tested
bearing_OD14_055 | bearing_OD14 | 14 | 14.55 |  |  | not_tested
bearing_OD14_070 | bearing_OD14 | 14 | 14.7 |  |  | not_tested
bearing_OD19_025 | bearing_OD19 | 19 | 19.25 |  |  | not_tested
bearing_OD19_040 | bearing_OD19 | 19 | 19.4 |  |  | not_tested
bearing_OD19_055 | bearing_OD19 | 19 | 19.55 |  |  | not_tested
bearing_OD19_070 | bearing_OD19 | 19 | 19.7 |  |  | not_tested
bearing_OD22_025 | bearing_OD22 | 22 | 22.25 |  |  | not_tested
bearing_OD22_040 | bearing_OD22 | 22 | 22.4 |  |  | not_tested
bearing_OD22_055 | bearing_OD22 | 22 | 22.55 |  |  | not_tested
bearing_OD22_070 | bearing_OD22 | 22 | 22.7 |  |  | not_tested
heat_insert_M3_1 | heat_insert_M3 | 4.6 | 4.2 |  |  | not_tested
heat_insert_M3_2 | heat_insert_M3 | 4.6 | 4.4 |  |  | not_tested
heat_insert_M3_3 | heat_insert_M3 | 4.6 | 4.6 |  |  | not_tested
heat_insert_M3_4 | heat_insert_M3 | 4.6 | 4.8 |  |  | not_tested
heat_insert_M3_5 | heat_insert_M3 | 4.6 | 5.0 |  |  | not_tested
heat_insert_M4_1 | heat_insert_M4 | 5.6 | 5.2 |  |  | not_tested
heat_insert_M4_2 | heat_insert_M4 | 5.6 | 5.4 |  |  | not_tested
heat_insert_M4_3 | heat_insert_M4 | 5.6 | 5.6 |  |  | not_tested
heat_insert_M4_4 | heat_insert_M4 | 5.6 | 5.8 |  |  | not_tested
heat_insert_M4_5 | heat_insert_M4 | 5.6 | 6.0 |  |  | not_tested
shaft_ID3_015 | shaft_clearance_ID3 | 3 | 3.15 |  |  | not_tested
shaft_ID3_030 | shaft_clearance_ID3 | 3 | 3.3 |  |  | not_tested
shaft_ID3_045 | shaft_clearance_ID3 | 3 | 3.45 |  |  | not_tested
shaft_ID4_015 | shaft_clearance_ID4 | 4 | 4.15 |  |  | not_tested
shaft_ID4_030 | shaft_clearance_ID4 | 4 | 4.3 |  |  | not_tested
shaft_ID4_045 | shaft_clearance_ID4 | 4 | 4.45 |  |  | not_tested
shaft_ID5_015 | shaft_clearance_ID5 | 5 | 5.15 |  |  | not_tested
shaft_ID5_030 | shaft_clearance_ID5 | 5 | 5.3 |  |  | not_tested
shaft_ID5_045 | shaft_clearance_ID5 | 5 | 5.45 |  |  | not_tested
shaft_ID6_015 | shaft_clearance_ID6 | 6 | 6.15 |  |  | not_tested
shaft_ID6_030 | shaft_clearance_ID6 | 6 | 6.3 |  |  | not_tested
shaft_ID6_045 | shaft_clearance_ID6 | 6 | 6.45 |  |  | not_tested
shaft_ID7_015 | shaft_clearance_ID7 | 7 | 7.15 |  |  | not_tested
shaft_ID7_030 | shaft_clearance_ID7 | 7 | 7.3 |  |  | not_tested
shaft_ID7_045 | shaft_clearance_ID7 | 7 | 7.45 |  |  | not_tested
shaft_ID8_015 | shaft_clearance_ID8 | 8 | 8.15 |  |  | not_tested
shaft_ID8_030 | shaft_clearance_ID8 | 8 | 8.3 |  |  | not_tested
shaft_ID8_045 | shaft_clearance_ID8 | 8 | 8.45 |  |  | not_tested
bolt_M3_020 | bolt_clearance_M3 | 3 | 3.2 |  |  | not_tested
bolt_M3_040 | bolt_clearance_M3 | 3 | 3.4 |  |  | not_tested
bolt_M3_060 | bolt_clearance_M3 | 3 | 3.6 |  |  | not_tested
bolt_M4_020 | bolt_clearance_M4 | 4 | 4.2 |  |  | not_tested
bolt_M4_040 | bolt_clearance_M4 | 4 | 4.4 |  |  | not_tested
bolt_M4_060 | bolt_clearance_M4 | 4 | 4.6 |  |  | not_tested
nut_M3_015 | nut_trap_M3 | 5.5 | 5.65 |  |  | not_tested
nut_M3_030 | nut_trap_M3 | 5.5 | 5.8 |  |  | not_tested
nut_M3_045 | nut_trap_M3 | 5.5 | 5.95 |  |  | not_tested
nut_M4_015 | nut_trap_M4 | 7 | 7.15 |  |  | not_tested
nut_M4_030 | nut_trap_M4 | 7 | 7.3 |  |  | not_tested
nut_M4_045 | nut_trap_M4 | 7 | 7.45 |  |  | not_tested
wire_slot_4 | wire_slot | 4 | 4 |  |  | not_tested
wire_slot_6 | wire_slot | 6 | 6 |  |  | not_tested
wire_slot_8 | wire_slot | 8 | 8 |  |  | not_tested
servo_width_1 | servo_body_width | 25.23 | 25.23 |  |  | not_tested
servo_width_2 | servo_body_width | 25.23 | 25.43 |  |  | not_tested
clamp_ID8_030 | clamp_ID8 | 8 | 8.3 |  |  | not_tested
