silmoon04/mist-robot/design/hexapod_phone_quad_20260912/manufacturing/baseline_r2/printing/fastener_mass.csv

category | sku | owning_link | attachment | quantity | low_mass_g | nominal_mass_g | high_mass_g
nut | plain_nut_M3_AF5.5_T2.4 | base | FL_yaw_clamp | 3 | 0.973038 | 1.087717 | 1.203228
nut | plain_nut_M3_AF5.5_T2.4 | base | FL_yaw_deck | 4 | 1.297384 | 1.450289 | 1.604304
nut | plain_nut_M3_AF5.5_T2.4 | base | FR_yaw_clamp | 3 | 0.973038 | 1.087717 | 1.203228
nut | plain_nut_M3_AF5.5_T2.4 | base | FR_yaw_deck | 4 | 1.297384 | 1.450289 | 1.604304
nut | plain_nut_M3_AF5.5_T2.4 | base | RL_yaw_clamp | 3 | 0.973038 | 1.087717 | 1.203228
nut | plain_nut_M3_AF5.5_T2.4 | base | RL_yaw_deck | 4 | 1.297384 | 1.450289 | 1.604304
nut | plain_nut_M3_AF5.5_T2.4 | base | RR_yaw_clamp | 3 | 0.973038 | 1.087717 | 1.203228
nut | plain_nut_M3_AF5.5_T2.4 | base | RR_yaw_deck | 4 | 1.297384 | 1.450289 | 1.604304
nut | plain_nut_M3_AF5.5_T2.4 | base | battery_tray | 4 | 1.297384 | 1.450289 | 1.604304
nut | plain_nut_M3_AF5.5_T2.4 | base | body_cover | 4 | 1.297384 | 1.450289 | 1.604304
nut | plain_nut_M3_AF5.5_T2.4 | base | pan_cap | 4 | 1.297384 | 1.450289 | 1.604304
nut | plain_nut_M3_AF5.5_T2.4 | base | pan_to_cover | 4 | 1.297384 | 1.450289 | 1.604304
nut | plain_nut_M3_AF5.5_T2.4 | coxa_FL | FL_coxa_bridge | 2 | 0.648692 | 0.725144 | 0.802152
nut | plain_nut_M3_AF5.5_T2.4 | coxa_FL | FL_hip_clamp | 3 | 0.973038 | 1.087717 | 1.203228
nut | plain_nut_M3_AF5.5_T2.4 | coxa_FR | FR_coxa_bridge | 2 | 0.648692 | 0.725144 | 0.802152
nut | plain_nut_M3_AF5.5_T2.4 | coxa_FR | FR_hip_clamp | 3 | 0.973038 | 1.087717 | 1.203228
nut | plain_nut_M3_AF5.5_T2.4 | coxa_RL | RL_coxa_bridge | 2 | 0.648692 | 0.725144 | 0.802152
nut | plain_nut_M3_AF5.5_T2.4 | coxa_RL | RL_hip_clamp | 3 | 0.973038 | 1.087717 | 1.203228
nut | plain_nut_M3_AF5.5_T2.4 | coxa_RR | RR_coxa_bridge | 2 | 0.648692 | 0.725144 | 0.802152
nut | plain_nut_M3_AF5.5_T2.4 | coxa_RR | RR_hip_clamp | 3 | 0.973038 | 1.087717 | 1.203228
nut | plain_nut_M3_AF5.5_T2.4 | femur_FL | FL_hip_bridge_external_nut | 1 | 0.324346 | 0.362572 | 0.401076
nut | plain_nut_M3_AF5.5_T2.4 | femur_FL | FL_knee_clamp | 3 | 0.973038 | 1.087717 | 1.203228
nut | plain_nut_M3_AF5.5_T2.4 | femur_FR | FR_hip_bridge_external_nut | 1 | 0.324346 | 0.362572 | 0.401076
nut | plain_nut_M3_AF5.5_T2.4 | femur_FR | FR_knee_clamp | 3 | 0.973038 | 1.087717 | 1.203228
nut | plain_nut_M3_AF5.5_T2.4 | femur_RL | RL_hip_bridge_external_nut | 1 | 0.324346 | 0.362572 | 0.401076
nut | plain_nut_M3_AF5.5_T2.4 | femur_RL | RL_knee_clamp | 3 | 0.973038 | 1.087717 | 1.203228
nut | plain_nut_M3_AF5.5_T2.4 | femur_RR | RR_hip_bridge_external_nut | 1 | 0.324346 | 0.362572 | 0.401076
nut | plain_nut_M3_AF5.5_T2.4 | femur_RR | RR_knee_clamp | 3 | 0.973038 | 1.087717 | 1.203228
nut | plain_nut_M3_AF5.5_T2.4 | phone_pan | phone_feet_frame | 4 | 1.297384 | 1.450289 | 1.604304
nut | plain_nut_M3_AF5.5_T2.4 | phone_pan | phone_feet_hub | 4 | 1.297384 | 1.450289 | 1.604304
nut | plain_nut_M3_AF5.5_T2.4 | phone_pan | phone_retention | 4 | 1.297384 | 1.450289 | 1.604304
nut | plain_nut_M3_AF5.5_T2.4 | tibia_FL | FL_knee_bridge_external_nut | 2 | 0.648692 | 0.725144 | 0.802152
nut | plain_nut_M3_AF5.5_T2.4 | tibia_FR | FR_knee_bridge_external_nut | 2 | 0.648692 | 0.725144 | 0.802152
nut | plain_nut_M3_AF5.5_T2.4 | tibia_RL | RL_knee_bridge_external_nut | 2 | 0.648692 | 0.725144 | 0.802152
nut | plain_nut_M3_AF5.5_T2.4 | tibia_RR | RR_knee_bridge_external_nut | 2 | 0.648692 | 0.725144 | 0.802152
screw | M3x10 | base | battery_tray | 4 | 2.93361 | 3.781258 | 4.457567
screw | M3x10 | base | body_cover | 4 | 2.93361 | 3.781258 | 4.457567
screw | M3x10 | base | pan_cap | 4 | 2.93361 | 3.781258 | 4.457567
screw | M3x10 | phone_pan | phone_feet_frame | 4 | 2.93361 | 3.781258 | 4.457567
screw | M3x10 | phone_pan | phone_feet_hub | 4 | 2.93361 | 3.781258 | 4.457567
screw | M3x12 | base | FL_yaw_deck | 4 | 3.267034 | 4.154264 | 4.901474
screw | M3x12 | base | FR_yaw_deck | 4 | 3.267034 | 4.154264 | 4.901474
screw | M3x12 | base | RL_yaw_deck | 4 | 3.267034 | 4.154264 | 4.901474
screw | M3x12 | base | RR_yaw_deck | 4 | 3.267034 | 4.154264 | 4.901474
screw | M3x12 | coxa_FL | FL_coxa_bridge | 2 | 1.633517 | 2.077132 | 2.450737
screw | M3x12 | coxa_FR | FR_coxa_bridge | 2 | 1.633517 | 2.077132 | 2.450737
screw | M3x12 | coxa_RL | RL_coxa_bridge | 2 | 1.633517 | 2.077132 | 2.450737
screw | M3x12 | coxa_RR | RR_coxa_bridge | 2 | 1.633517 | 2.077132 | 2.450737
screw | M3x16 | base | pan_to_cover | 4 | 3.933881 | 4.900274 | 5.789288
screw | M3x16 | coxa_FL | FL_yaw_aux_horn | 4 | 3.933881 | 4.900274 | 5.789288
screw | M3x16 | coxa_FR | FR_yaw_aux_horn | 4 | 3.933881 | 4.900274 | 5.789288
screw | M3x16 | coxa_RL | RL_yaw_aux_horn | 4 | 3.933881 | 4.900274 | 5.789288
screw | M3x16 | coxa_RR | RR_yaw_aux_horn | 4 | 3.933881 | 4.900274 | 5.789288
screw | M3x16 | phone_pan | phone_retention | 4 | 3.933881 | 4.900274 | 5.789288
screw | M3x35 | base | FL_yaw_clamp | 3 | 5.326053 | 6.332868 | 7.504803
screw | M3x35 | base | FR_yaw_clamp | 3 | 5.326053 | 6.332868 | 7.504803
screw | M3x35 | base | RL_yaw_clamp | 3 | 5.326053 | 6.332868 | 7.504803
screw | M3x35 | base | RR_yaw_clamp | 3 | 5.326053 | 6.332868 | 7.504803
screw | M3x35 | coxa_FL | FL_hip_clamp | 3 | 5.326053 | 6.332868 | 7.504803
screw | M3x35 | coxa_FR | FR_hip_clamp | 3 | 5.326053 | 6.332868 | 7.504803
screw | M3x35 | coxa_RL | RL_hip_clamp | 3 | 5.326053 | 6.332868 | 7.504803
screw | M3x35 | coxa_RR | RR_hip_clamp | 3 | 5.326053 | 6.332868 | 7.504803
screw | M3x35 | femur_FL | FL_knee_clamp | 3 | 5.326053 | 6.332868 | 7.504803
screw | M3x35 | femur_FR | FR_knee_clamp | 3 | 5.326053 | 6.332868 | 7.504803
screw | M3x35 | femur_RL | RL_knee_clamp | 3 | 5.326053 | 6.332868 | 7.504803
screw | M3x35 | femur_RR | RR_knee_clamp | 3 | 5.326053 | 6.332868 | 7.504803
screw | M3x50 | femur_FL | FL_hip_bridge_external_nut | 1 | 2.40052 | 2.810341 | 3.333927
screw | M3x50 | femur_FR | FR_hip_bridge_external_nut | 1 | 2.40052 | 2.810341 | 3.333927
screw | M3x50 | femur_RL | RL_hip_bridge_external_nut | 1 | 2.40052 | 2.810341 | 3.333927
screw | M3x50 | femur_RR | RR_hip_bridge_external_nut | 1 | 2.40052 | 2.810341 | 3.333927
screw | M3x50 | tibia_FL | FL_knee_bridge_external_nut | 2 | 4.80104 | 5.620681 | 6.667854
screw | M3x50 | tibia_FR | FR_knee_bridge_external_nut | 2 | 4.80104 | 5.620681 | 6.667854
screw | M3x50 | tibia_RL | RL_knee_bridge_external_nut | 2 | 4.80104 | 5.620681 | 6.667854
screw | M3x50 | tibia_RR | RR_knee_bridge_external_nut | 2 | 4.80104 | 5.620681 | 6.667854
screw | M3x6 | coxa_FL | FL_yaw_main_horn | 4 | 2.266763 | 3.035248 | 3.569752
screw | M3x6 | coxa_FR | FR_yaw_main_horn | 4 | 2.266763 | 3.035248 | 3.569752
screw | M3x6 | coxa_RL | RL_yaw_main_horn | 4 | 2.266763 | 3.035248 | 3.569752
screw | M3x6 | coxa_RR | RR_yaw_main_horn | 4 | 2.266763 | 3.035248 | 3.569752
screw | M3x6 | femur_FL | FL_hip_aux_horn | 4 | 2.266763 | 3.035248 | 3.569752
screw | M3x6 | femur_FL | FL_hip_main_horn | 4 | 2.266763 | 3.035248 | 3.569752
screw | M3x6 | femur_FR | FR_hip_aux_horn | 4 | 2.266763 | 3.035248 | 3.569752
screw | M3x6 | femur_FR | FR_hip_main_horn | 4 | 2.266763 | 3.035248 | 3.569752
screw | M3x6 | femur_RL | RL_hip_aux_horn | 4 | 2.266763 | 3.035248 | 3.569752
screw | M3x6 | femur_RL | RL_hip_main_horn | 4 | 2.266763 | 3.035248 | 3.569752
screw | M3x6 | femur_RR | RR_hip_aux_horn | 4 | 2.266763 | 3.035248 | 3.569752
screw | M3x6 | femur_RR | RR_hip_main_horn | 4 | 2.266763 | 3.035248 | 3.569752
screw | M3x6 | phone_pan | phone_hub_horn | 4 | 2.266763 | 3.035248 | 3.569752
screw | M3x6 | tibia_FL | FL_knee_aux_horn | 4 | 2.266763 | 3.035248 | 3.569752
screw | M3x6 | tibia_FL | FL_knee_main_horn | 4 | 2.266763 | 3.035248 | 3.569752
screw | M3x6 | tibia_FR | FR_knee_aux_horn | 4 | 2.266763 | 3.035248 | 3.569752
screw | M3x6 | tibia_FR | FR_knee_main_horn | 4 | 2.266763 | 3.035248 | 3.569752
screw | M3x6 | tibia_RL | RL_knee_aux_horn | 4 | 2.266763 | 3.035248 | 3.569752
screw | M3x6 | tibia_RL | RL_knee_main_horn | 4 | 2.266763 | 3.035248 | 3.569752
screw | M3x6 | tibia_RR | RR_knee_aux_horn | 4 | 2.266763 | 3.035248 | 3.569752
screw | M3x6 | tibia_RR | RR_knee_main_horn | 4 | 2.266763 | 3.035248 | 3.569752
supplied_aux_retainer | PA3x5 | base | FL_yaw_aux_center | 1 | 0.479697 | 0.687448 | 0.83695
supplied_aux_retainer | PA3x5 | base | FR_yaw_aux_center | 1 | 0.479697 | 0.687448 | 0.83695
supplied_aux_retainer | PA3x5 | base | RL_yaw_aux_center | 1 | 0.479697 | 0.687448 | 0.83695
supplied_aux_retainer | PA3x5 | base | RR_yaw_aux_center | 1 | 0.479697 | 0.687448 | 0.83695
supplied_aux_retainer | PA3x5 | coxa_FL | FL_hip_aux_center | 1 | 0.479697 | 0.687448 | 0.83695
supplied_aux_retainer | PA3x5 | coxa_FR | FR_hip_aux_center | 1 | 0.479697 | 0.687448 | 0.83695
supplied_aux_retainer | PA3x5 | coxa_RL | RL_hip_aux_center | 1 | 0.479697 | 0.687448 | 0.83695
supplied_aux_retainer | PA3x5 | coxa_RR | RR_hip_aux_center | 1 | 0.479697 | 0.687448 | 0.83695
supplied_aux_retainer | PA3x5 | femur_FL | FL_knee_aux_center | 1 | 0.479697 | 0.687448 | 0.83695
supplied_aux_retainer | PA3x5 | femur_FR | FR_knee_aux_center | 1 | 0.479697 | 0.687448 | 0.83695
supplied_aux_retainer | PA3x5 | femur_RL | RL_knee_aux_center | 1 | 0.479697 | 0.687448 | 0.83695
supplied_aux_retainer | PA3x5 | femur_RR | RR_knee_aux_center | 1 | 0.479697 | 0.687448 | 0.83695
supplied_main_retainer | M3x6 | coxa_FL | FL_yaw_main_center | 1 | 0.566691 | 0.758812 | 0.892438
supplied_main_retainer | M3x6 | coxa_FR | FR_yaw_main_center | 1 | 0.566691 | 0.758812 | 0.892438
supplied_main_retainer | M3x6 | coxa_RL | RL_yaw_main_center | 1 | 0.566691 | 0.758812 | 0.892438
supplied_main_retainer | M3x6 | coxa_RR | RR_yaw_main_center | 1 | 0.566691 | 0.758812 | 0.892438
supplied_main_retainer | M3x6 | femur_FL | FL_hip_main_center | 1 | 0.566691 | 0.758812 | 0.892438
supplied_main_retainer | M3x6 | femur_FR | FR_hip_main_center | 1 | 0.566691 | 0.758812 | 0.892438
supplied_main_retainer | M3x6 | femur_RL | RL_hip_main_center | 1 | 0.566691 | 0.758812 | 0.892438
supplied_main_retainer | M3x6 | femur_RR | RR_hip_main_center | 1 | 0.566691 | 0.758812 | 0.892438
supplied_main_retainer | M3x6 | phone_pan | phone_main_center | 1 | 0.566691 | 0.758812 | 0.892438
supplied_main_retainer | M3x6 | tibia_FL | FL_knee_main_center | 1 | 0.566691 | 0.758812 | 0.892438
supplied_main_retainer | M3x6 | tibia_FR | FR_knee_main_center | 1 | 0.566691 | 0.758812 | 0.892438
supplied_main_retainer | M3x6 | tibia_RL | RL_knee_main_center | 1 | 0.566691 | 0.758812 | 0.892438
supplied_main_retainer | M3x6 | tibia_RR | RR_knee_main_center | 1 | 0.566691 | 0.758812 | 0.892438
washer | washer_M3_OD6_ID3.2_T0.5 | coxa_FL | FL_yaw_main_horn | 4 | 0.285876 | 0.31764 | 0.349404
washer | washer_M3_OD6_ID3.2_T0.5 | coxa_FR | FR_yaw_main_horn | 4 | 0.285876 | 0.31764 | 0.349404
washer | washer_M3_OD6_ID3.2_T0.5 | coxa_RL | RL_yaw_main_horn | 4 | 0.285876 | 0.31764 | 0.349404
washer | washer_M3_OD6_ID3.2_T0.5 | coxa_RR | RR_yaw_main_horn | 4 | 0.285876 | 0.31764 | 0.349404
washer | washer_M3_OD6_ID3.2_T0.5 | femur_FL | FL_hip_aux_horn | 4 | 0.285876 | 0.31764 | 0.349404
washer | washer_M3_OD6_ID3.2_T0.5 | femur_FL | FL_hip_bridge_external_nut | 2 | 0.142938 | 0.15882 | 0.174702
washer | washer_M3_OD6_ID3.2_T0.5 | femur_FL | FL_hip_main_horn | 4 | 0.285876 | 0.31764 | 0.349404
washer | washer_M3_OD6_ID3.2_T0.5 | femur_FR | FR_hip_aux_horn | 4 | 0.285876 | 0.31764 | 0.349404
washer | washer_M3_OD6_ID3.2_T0.5 | femur_FR | FR_hip_bridge_external_nut | 2 | 0.142938 | 0.15882 | 0.174702
washer | washer_M3_OD6_ID3.2_T0.5 | femur_FR | FR_hip_main_horn | 4 | 0.285876 | 0.31764 | 0.349404
washer | washer_M3_OD6_ID3.2_T0.5 | femur_RL | RL_hip_aux_horn | 4 | 0.285876 | 0.31764 | 0.349404
washer | washer_M3_OD6_ID3.2_T0.5 | femur_RL | RL_hip_bridge_external_nut | 2 | 0.142938 | 0.15882 | 0.174702
washer | washer_M3_OD6_ID3.2_T0.5 | femur_RL | RL_hip_main_horn | 4 | 0.285876 | 0.31764 | 0.349404
washer | washer_M3_OD6_ID3.2_T0.5 | femur_RR | RR_hip_aux_horn | 4 | 0.285876 | 0.31764 | 0.349404
washer | washer_M3_OD6_ID3.2_T0.5 | femur_RR | RR_hip_bridge_external_nut | 2 | 0.142938 | 0.15882 | 0.174702
washer | washer_M3_OD6_ID3.2_T0.5 | femur_RR | RR_hip_main_horn | 4 | 0.285876 | 0.31764 | 0.349404
washer | washer_M3_OD6_ID3.2_T0.5 | phone_pan | phone_hub_horn | 4 | 0.285876 | 0.31764 | 0.349404
washer | washer_M3_OD6_ID3.2_T0.5 | tibia_FL | FL_knee_aux_horn | 4 | 0.285876 | 0.31764 | 0.349404
washer | washer_M3_OD6_ID3.2_T0.5 | tibia_FL | FL_knee_bridge_external_nut | 4 | 0.285876 | 0.31764 | 0.349404
washer | washer_M3_OD6_ID3.2_T0.5 | tibia_FL | FL_knee_main_horn | 4 | 0.285876 | 0.31764 | 0.349404
washer | washer_M3_OD6_ID3.2_T0.5 | tibia_FR | FR_knee_aux_horn | 4 | 0.285876 | 0.31764 | 0.349404
washer | washer_M3_OD6_ID3.2_T0.5 | tibia_FR | FR_knee_bridge_external_nut | 4 | 0.285876 | 0.31764 | 0.349404
washer | washer_M3_OD6_ID3.2_T0.5 | tibia_FR | FR_knee_main_horn | 4 | 0.285876 | 0.31764 | 0.349404
washer | washer_M3_OD6_ID3.2_T0.5 | tibia_RL | RL_knee_aux_horn | 4 | 0.285876 | 0.31764 | 0.349404
washer | washer_M3_OD6_ID3.2_T0.5 | tibia_RL | RL_knee_bridge_external_nut | 4 | 0.285876 | 0.31764 | 0.349404
washer | washer_M3_OD6_ID3.2_T0.5 | tibia_RL | RL_knee_main_horn | 4 | 0.285876 | 0.31764 | 0.349404
washer | washer_M3_OD6_ID3.2_T0.5 | tibia_RR | RR_knee_aux_horn | 4 | 0.285876 | 0.31764 | 0.349404
washer | washer_M3_OD6_ID3.2_T0.5 | tibia_RR | RR_knee_bridge_external_nut | 4 | 0.285876 | 0.31764 | 0.349404
washer | washer_M3_OD6_ID3.2_T0.5 | tibia_RR | RR_knee_main_horn | 4 | 0.285876 | 0.31764 | 0.349404
washer | washer_M3_OD7_ID3.2_T0.5 | base | FL_yaw_clamp | 3 | 0.322609 | 0.358455 | 0.3943
washer | washer_M3_OD7_ID3.2_T0.5 | base | FL_yaw_deck | 4 | 0.430146 | 0.47794 | 0.525734
washer | washer_M3_OD7_ID3.2_T0.5 | base | FR_yaw_clamp | 3 | 0.322609 | 0.358455 | 0.3943
washer | washer_M3_OD7_ID3.2_T0.5 | base | FR_yaw_deck | 4 | 0.430146 | 0.47794 | 0.525734
washer | washer_M3_OD7_ID3.2_T0.5 | base | RL_yaw_clamp | 3 | 0.322609 | 0.358455 | 0.3943
washer | washer_M3_OD7_ID3.2_T0.5 | base | RL_yaw_deck | 4 | 0.430146 | 0.47794 | 0.525734
washer | washer_M3_OD7_ID3.2_T0.5 | base | RR_yaw_clamp | 3 | 0.322609 | 0.358455 | 0.3943
washer | washer_M3_OD7_ID3.2_T0.5 | base | RR_yaw_deck | 4 | 0.430146 | 0.47794 | 0.525734
washer | washer_M3_OD7_ID3.2_T0.5 | base | battery_tray | 4 | 0.430146 | 0.47794 | 0.525734
washer | washer_M3_OD7_ID3.2_T0.5 | base | body_cover | 4 | 0.430146 | 0.47794 | 0.525734
washer | washer_M3_OD7_ID3.2_T0.5 | base | pan_to_cover | 4 | 0.430146 | 0.47794 | 0.525734
washer | washer_M3_OD7_ID3.2_T0.5 | coxa_FL | FL_coxa_bridge | 2 | 0.215073 | 0.23897 | 0.262867
washer | washer_M3_OD7_ID3.2_T0.5 | coxa_FL | FL_hip_clamp | 3 | 0.322609 | 0.358455 | 0.3943
washer | washer_M3_OD7_ID3.2_T0.5 | coxa_FR | FR_coxa_bridge | 2 | 0.215073 | 0.23897 | 0.262867
washer | washer_M3_OD7_ID3.2_T0.5 | coxa_FR | FR_hip_clamp | 3 | 0.322609 | 0.358455 | 0.3943
washer | washer_M3_OD7_ID3.2_T0.5 | coxa_RL | RL_coxa_bridge | 2 | 0.215073 | 0.23897 | 0.262867
washer | washer_M3_OD7_ID3.2_T0.5 | coxa_RL | RL_hip_clamp | 3 | 0.322609 | 0.358455 | 0.3943
washer | washer_M3_OD7_ID3.2_T0.5 | coxa_RR | RR_coxa_bridge | 2 | 0.215073 | 0.23897 | 0.262867
washer | washer_M3_OD7_ID3.2_T0.5 | coxa_RR | RR_hip_clamp | 3 | 0.322609 | 0.358455 | 0.3943
washer | washer_M3_OD7_ID3.2_T0.5 | femur_FL | FL_knee_clamp | 3 | 0.322609 | 0.358455 | 0.3943
washer | washer_M3_OD7_ID3.2_T0.5 | femur_FR | FR_knee_clamp | 3 | 0.322609 | 0.358455 | 0.3943
washer | washer_M3_OD7_ID3.2_T0.5 | femur_RL | RL_knee_clamp | 3 | 0.322609 | 0.358455 | 0.3943
washer | washer_M3_OD7_ID3.2_T0.5 | femur_RR | RR_knee_clamp | 3 | 0.322609 | 0.358455 | 0.3943
