silmoon04/mist-robot/brain/art_direction/artist_pack_20260916/drawing_checklist.csv

id | group | name | unit | pilot | draw | reference | status | artist_notes
E01 | Base eye pairs | Available | eye pair | True | Relaxed open eyes; warm enough to sit with, not a permanent grin. | 39_neutral_02_manual | not started
E02 | Base eye pairs | Listening | eye pair | False | Open and attentive, a little more lifted than E01. | 25_neutral_2_03_manual | not started
E03 | Base eye pairs | Happy | eye pair | False | A clear smile in the eyes; retain some irregularity. | 09_happy_03_manual | not started
E04 | Base eye pairs | Focused | eye pair | True | A soft squint, engaged rather than angry. | 40_neutral_03_manual | not started
E05 | Base eye pairs | Concerned | eye pair | False | Gentle inner lift; empathetic, not crying by default. | 32_sad_07_manual | not started
E06 | Base eye pairs | Sleepy | eye pair | False | Heavy lids and relaxed weight. | 16_misc_16_manual | not started
E07 | Base eye pairs | Annoyed | eye pair | False | A mild flat-lidded deadpan, never the default. | 07_annoyed_03_manual | not started
E08 | Base eye pairs | Surprised | eye pair | False | A brief clear widening without enormous eyes. | 38_misc_2_06_manual | not started
E09 | Base eye pairs | Curious | eye pair | False | Small asymmetry; one eye slightly more lifted. | 20_neutral_06_manual | not started
E10 | Base eye pairs | Playful | eye pair | False | A restrained side-eye or unequal squeeze. | 10_happy_04_manual | not started
M01 | Mouths | Rest | mouth | True | Closed relaxed line; not an O. | rest | not started
M02 | Mouths | Warm smile | mouth | False | Small uneven smile, not a large grin. | rest | not started
M03 | Mouths | Concern | mouth | False | Small shallow frown; keep the same anchor. | rest | not started
M04 | Mouths | Playful | mouth | False | Small asymmetric smile. | rest | not started
M05 | Mouths | Lips together | mouth | False | A definite closed contact for M/B/P, distinct from relaxed rest. | MBP | not started
M06 | Mouths | Open speech | mouth | True | Medium open A; primary amplitude-driven talking pose. | AA | not started
M07 | Mouths | Wide speech | mouth | False | Wider, shallower E; keep corners soft. | EE | not started
M08 | Mouths | Round speech | mouth | False | Rounded O/U; also a brief surprise accent. | OO | not started
B01 | Blink eye pairs | open half closed | eye pair | True | Half closed lid drawing for the open family. Match E01 anchors and line weight. | E01 | not started
B02 | Blink eye pairs | open closed | eye pair | True | Closed lid drawing for the open family. Match E01 anchors and line weight. | E01 | not started
B03 | Blink eye pairs | happy half closed | eye pair | False | Half closed lid drawing for the happy family. Match E03 anchors and line weight. | E03 | not started
B04 | Blink eye pairs | happy closed | eye pair | False | Closed lid drawing for the happy family. Match E03 anchors and line weight. | E03 | not started
B05 | Blink eye pairs | focused half closed | eye pair | False | Half closed lid drawing for the focused family. Match E04 anchors and line weight. | E04 | not started
B06 | Blink eye pairs | focused closed | eye pair | False | Closed lid drawing for the focused family. Match E04 anchors and line weight. | E04 | not started
B07 | Blink eye pairs | downcast half closed | eye pair | False | Half closed lid drawing for the downcast family. Match E05 anchors and line weight. | E05 | not started
B08 | Blink eye pairs | downcast closed | eye pair | False | Closed lid drawing for the downcast family. Match E05 anchors and line weight. | E05 | not started
A01 | Accent eye pairs | Surprise anticipation | eye pair | False | Brief inward squash before E08 opens. | E08 | not started
A02 | Accent eye pairs | Surprise overshoot | eye pair | False | Slightly wider than E08, then settle back. | E08 | not started
A03 | Accent eye pairs | Happy squeeze | eye pair | False | Compressed happy eyes for a one-off reaction. | E03 | not started
A04 | Accent eye pairs | Thinking squint | eye pair | False | Brief extra focus, then return to E04. | E04 | not started
A05 | Accent eye pairs | Playful asymmetry | eye pair | False | A readable asymmetric accent for E10. | E10 | not started
A06 | Accent eye pairs | Sleepy droop | eye pair | False | A little heavier than E06, then recover. | E06 | not started
R01 | Alternate eye redraws | E01 redraw B | eye pair | False | A subtly different contour of the same pose. Keep position, scale, expression and average line weight unchanged. | E01 | not started
R02 | Alternate eye redraws | E01 redraw C | eye pair | False | A subtly different contour of the same pose. Keep position, scale, expression and average line weight unchanged. | E01 | not started
R03 | Alternate eye redraws | E03 redraw B | eye pair | False | A subtly different contour of the same pose. Keep position, scale, expression and average line weight unchanged. | E03 | not started
R04 | Alternate eye redraws | E03 redraw C | eye pair | False | A subtly different contour of the same pose. Keep position, scale, expression and average line weight unchanged. | E03 | not started
R05 | Alternate eye redraws | E04 redraw B | eye pair | False | A subtly different contour of the same pose. Keep position, scale, expression and average line weight unchanged. | E04 | not started
R06 | Alternate eye redraws | E04 redraw C | eye pair | False | A subtly different contour of the same pose. Keep position, scale, expression and average line weight unchanged. | E04 | not started
