silmoon04/mist-robot/brain/art_direction/artist_studio_20260916/downloads/drawing_list.csv

id | group | name | note | unit
E01 | Eyes | Round / available | Left and right eyes on separate layers. | eye pair
E02 | Eyes | Attentive / listening | Left and right eyes on separate layers. | eye pair
E03 | Eyes | Focused / thinking | Left and right eyes on separate layers. | eye pair
E04 | Eyes | Happy | Left and right eyes on separate layers. | eye pair
E05 | Eyes | Soft / concerned | Left and right eyes on separate layers. | eye pair
E06 | Eyes | Heavy / sleepy | Left and right eyes on separate layers. | eye pair
E07 | Eyes | Angled / skeptical | Left and right eyes on separate layers. | eye pair
E08 | Eyes | Wide / surprise | Left and right eyes on separate layers. | eye pair
M01 | Mouths | Rest | Shared anchor; no baked glow. | mouth
M02 | Mouths | Smile | Shared anchor; no baked glow. | mouth
M03 | Mouths | Concern | Shared anchor; no baked glow. | mouth
M04 | Mouths | Smirk | Shared anchor; no baked glow. | mouth
M05 | Mouths | Lips together / MBP | Shared anchor; no baked glow. | mouth
M06 | Mouths | Open / AA | Shared anchor; no baked glow. | mouth
M07 | Mouths | Wide / EE | Shared anchor; no baked glow. | mouth
M08 | Mouths | Round / OO | Shared anchor; no baked glow. | mouth
B01 | Blinks | round / Half closed | Keep this family recognizable through the blink. | eye pair
B02 | Blinks | round / Closed | Keep this family recognizable through the blink. | eye pair
B03 | Blinks | happy / Half closed | Keep this family recognizable through the blink. | eye pair
B04 | Blinks | happy / Closed | Keep this family recognizable through the blink. | eye pair
B05 | Blinks | focused / Half closed | Keep this family recognizable through the blink. | eye pair
B06 | Blinks | focused / Closed | Keep this family recognizable through the blink. | eye pair
B07 | Blinks | soft / Half closed | Keep this family recognizable through the blink. | eye pair
B08 | Blinks | soft / Closed | Keep this family recognizable through the blink. | eye pair
B09 | Blinks | heavy / Half closed | Keep this family recognizable through the blink. | eye pair
B10 | Blinks | heavy / Closed | Keep this family recognizable through the blink. | eye pair
B11 | Blinks | wide / Half closed | Keep this family recognizable through the blink. | eye pair
B12 | Blinks | wide / Closed | Keep this family recognizable through the blink. | eye pair
A01 | Reactions | Surprise anticipation | A brief accent. No speaking required. | eye pair
A02 | Reactions | Surprise overshoot | A brief accent. No speaking required. | eye pair
A03 | Reactions | Happy squeeze | A brief accent. No speaking required. | eye pair
A04 | Reactions | Sleepy droop | A brief accent. No speaking required. | eye pair
R01 | Redraws | Available B | Small contour variation; position stays fixed. | eye pair
R02 | Redraws | Available C | Small contour variation; position stays fixed. | eye pair
R03 | Redraws | Focused B | Small contour variation; position stays fixed. | eye pair
R04 | Redraws | Focused C | Small contour variation; position stays fixed. | eye pair
