silmoon04/mist-robot/design/main_hub_20260915/output/Main_Hub_4Leg.stl

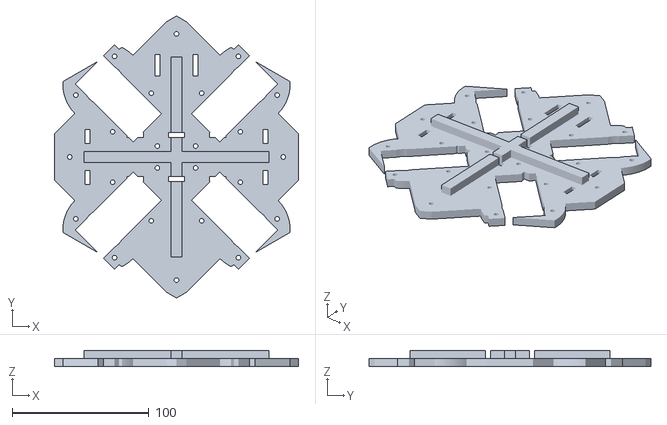
[picture p11: CAD file, 2026-10-12]
design/main_hub_20260915/output/Main_Hub_4Leg.stl
178.4 x 206.0 x 12.0
