silmoon04/mist-robot/design/single_leg_r7_wide_joints_20260914/output/assembly_mesh/tibia_curved_main_and_foot.stl

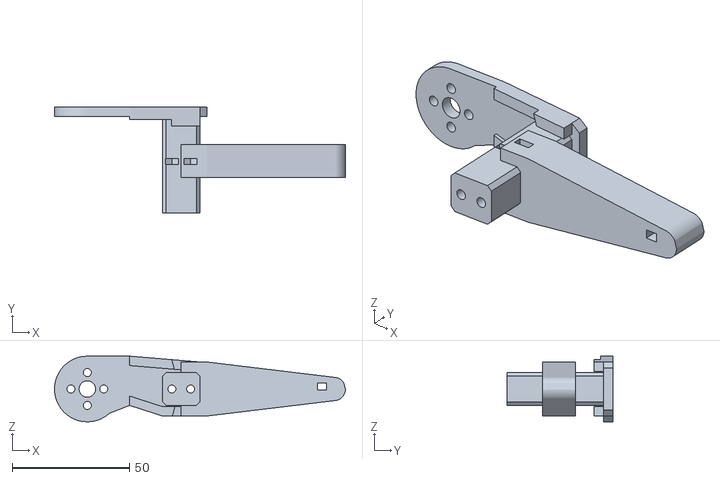
[picture p12: CAD file, 2026-10-12]
design/single_leg_r7_wide_joints_20260914/output/assembly_mesh/tibia_curved_main_and_foot.stl
124.0 x 45.0 x 28.0
