silmoon04/mist-robot/design/single_leg_r7_wide_joints_20260914/output/assembly_mesh/horn_hip_main.stl

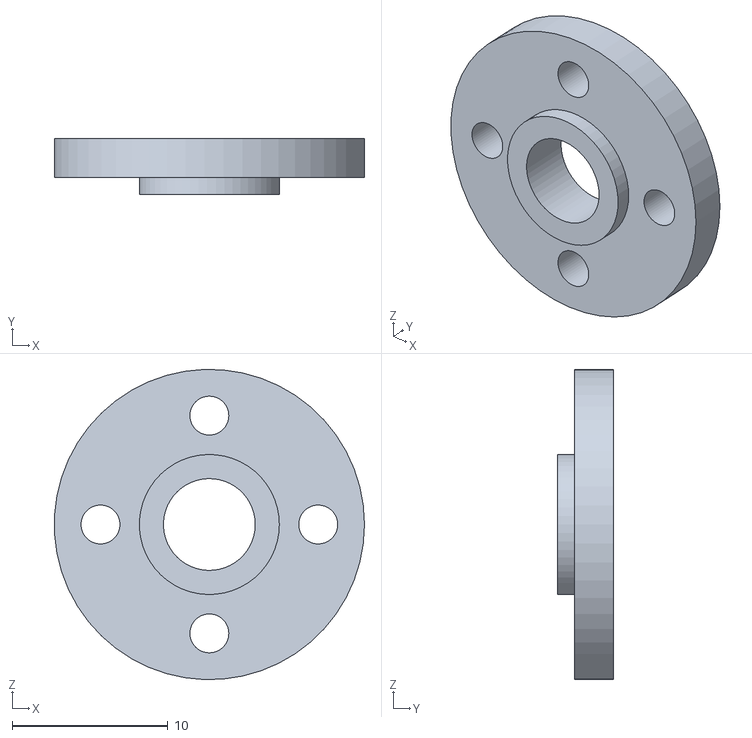
[picture p13: CAD file, 2026-10-12]
design/single_leg_r7_wide_joints_20260914/output/assembly_mesh/horn_hip_main.stl
19.9 x 3.60 x 19.9
