silmoon04/mist-robot/design/single_leg_r7_wide_joints_20260914/output/assembly_mesh/femur_main_and_knee_saddle.stl

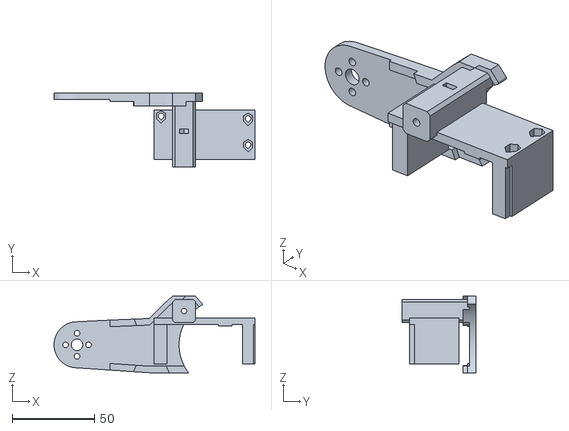
[picture p14: CAD file, 2026-10-12]
design/single_leg_r7_wide_joints_20260914/output/assembly_mesh/femur_main_and_knee_saddle.stl
122.1 x 45.0 x 46.5
