silmoon04/mist-robot/design/single_leg_r7_wide_joints_20260914/output/assembly_mesh/yaw_auxiliary_spacer_3.stl

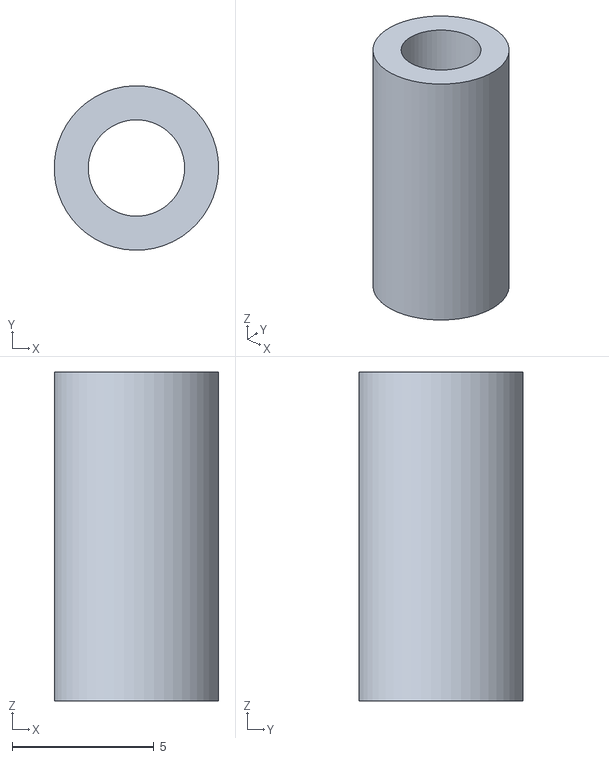
[picture p15: CAD file, 2026-10-12]
design/single_leg_r7_wide_joints_20260914/output/assembly_mesh/yaw_auxiliary_spacer_3.stl
5.79 x 5.80 x 11.6
