silmoon04/mist-robot/design/single_leg_r7_wide_joints_20260914/output/assembly_mesh/bench_mounting_plate.stl

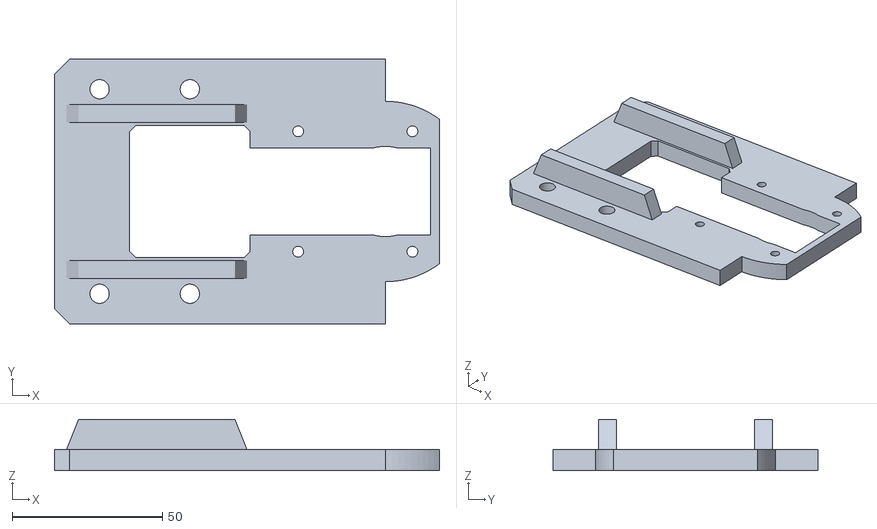
[picture p16: CAD file, 2026-10-12]
design/single_leg_r7_wide_joints_20260914/output/assembly_mesh/bench_mounting_plate.stl
128.0 x 88.0 x 17.0
