silmoon04/mist-robot/design/single_leg_r7_wide_joints_20260914/output/assembly_mesh/case_cap_knee.stl

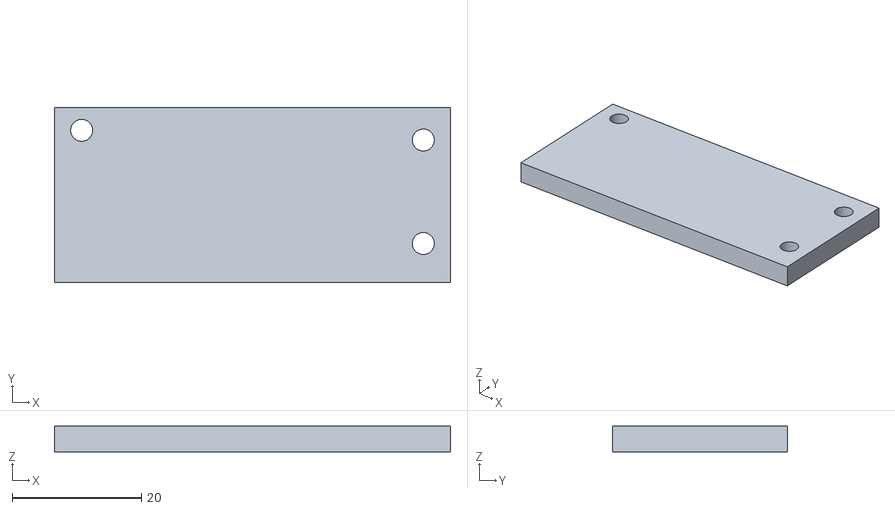
[picture p17: CAD file, 2026-10-12]
design/single_leg_r7_wide_joints_20260914/output/assembly_mesh/case_cap_knee.stl
61.2 x 27.0 x 4.00
