silmoon04/mist-robot/design/single_leg_r7_wide_joints_20260914/output/assembly_mesh/servo_hip.stl

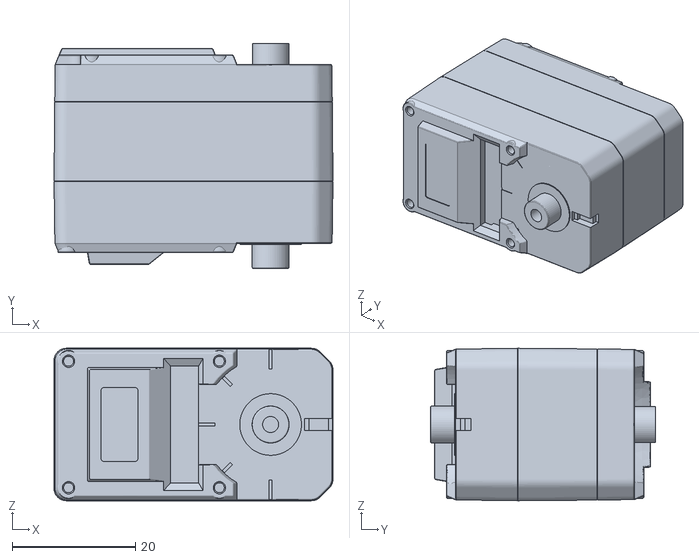
[picture p18: CAD file, 2026-10-12]
design/single_leg_r7_wide_joints_20260914/output/assembly_mesh/servo_hip.stl
45.2 x 36.5 x 24.7
