silmoon04/mist-robot/design/single_leg_r7_wide_joints_20260914/output/assembly_mesh/case_cap_hip.stl

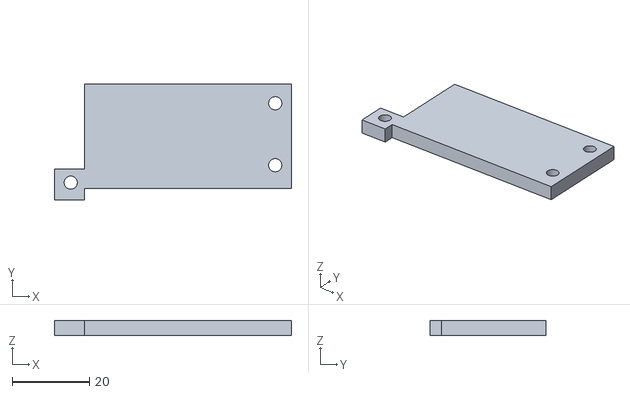
[picture p19: CAD file, 2026-10-12]
design/single_leg_r7_wide_joints_20260914/output/assembly_mesh/case_cap_hip.stl
61.2 x 30.0 x 4.00
