silmoon04/mist-robot/design/single_leg_r7_wide_joints_20260914/output/assembly_mesh/tibia_auxiliary_cheek.stl

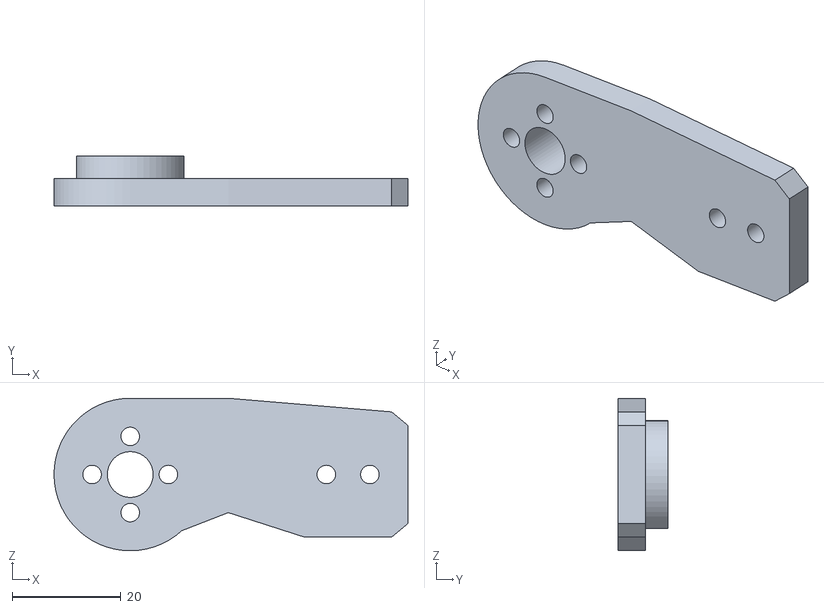
[picture p20: CAD file, 2026-10-12]
design/single_leg_r7_wide_joints_20260914/output/assembly_mesh/tibia_auxiliary_cheek.stl
65.0 x 9.10 x 28.0
