silmoon04/mist-robot/design/single_leg_r7_wide_joints_20260914/output/assembly_mesh/horn_hip_auxiliary.stl

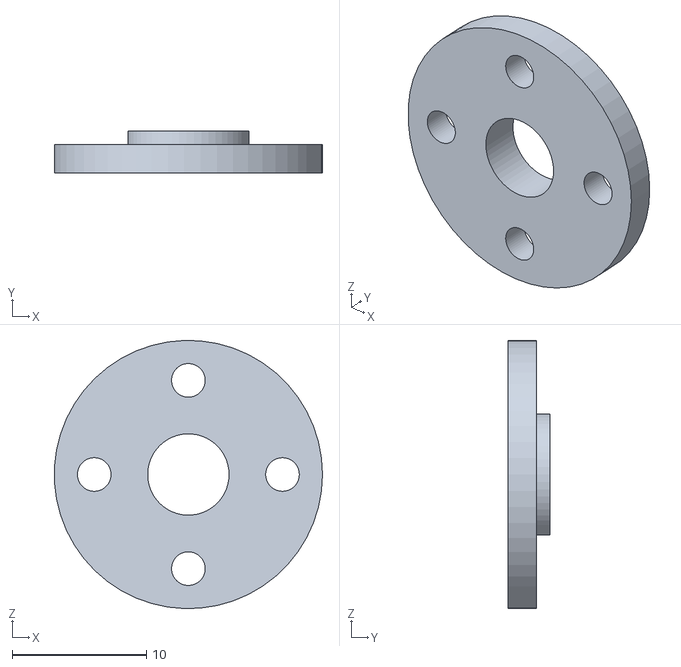
[picture p21: CAD file, 2026-10-12]
design/single_leg_r7_wide_joints_20260914/output/assembly_mesh/horn_hip_auxiliary.stl
19.9 x 3.10 x 19.9
