silmoon04/mist-robot/design/single_leg_r7_wide_joints_20260914/output/assembly_mesh/coxa_upper_and_hip_saddle.stl

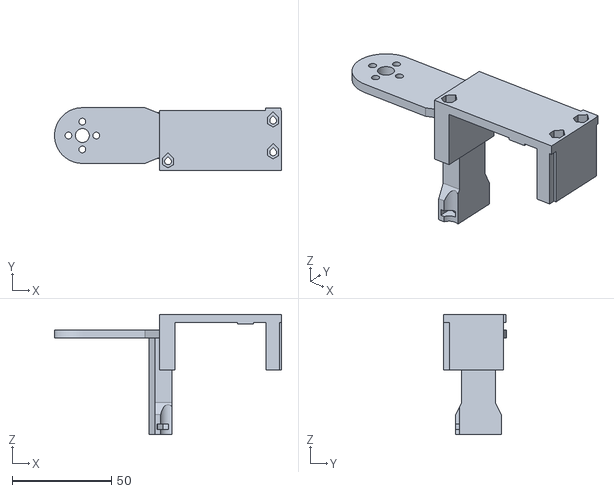
[picture p22: CAD file, 2026-10-12]
design/single_leg_r7_wide_joints_20260914/output/assembly_mesh/coxa_upper_and_hip_saddle.stl
114.1 x 31.5 x 60.4
