silmoon04/mist-robot/design/single_leg_r7_wide_joints_20260914/output/assembly_mesh/yaw_case_saddle.stl

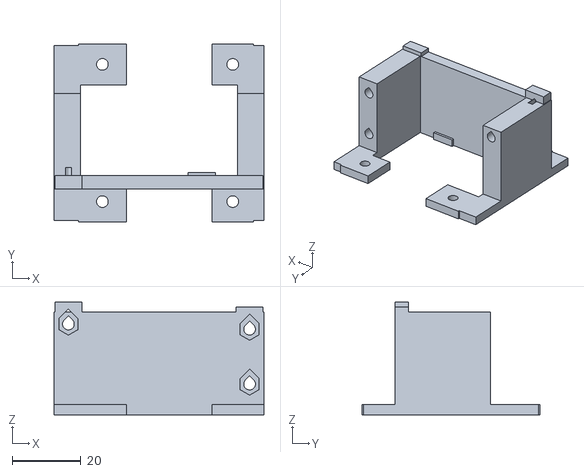
[picture p24: CAD file, 2026-10-12]
design/single_leg_r7_wide_joints_20260914/output/assembly_mesh/yaw_case_saddle.stl
61.2 x 52.0 x 32.9
