silmoon04/mist-robot/design/single_leg_r7_wide_joints_20260914/output/assembly_mesh/coxa_lower_auxiliary_arm.stl

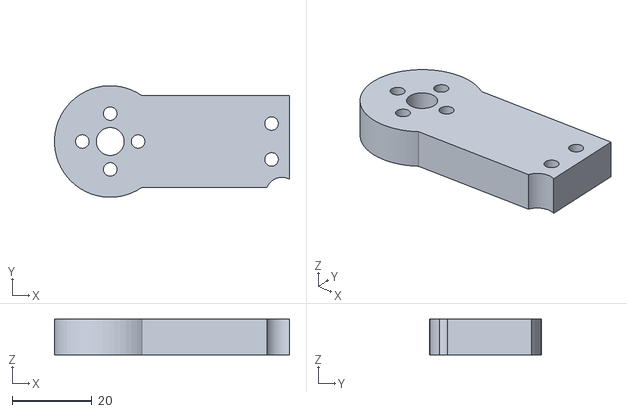
[picture p25: CAD file, 2026-10-12]
design/single_leg_r7_wide_joints_20260914/output/assembly_mesh/coxa_lower_auxiliary_arm.stl
59.0 x 28.0 x 9.00
