silmoon04/mist-robot/(list of files, cad)

Other CAD files:
design/single_leg_r7_wide_joints_20260914/output/assembly_mesh/horn_knee_main.stl
design/single_leg_r7_wide_joints_20260914/output/assembly_mesh/horn_yaw_main.stl
design/single_leg_r7_wide_joints_20260914/output/assembly_mesh/yaw_auxiliary_spacer_4.stl
design/single_leg_r7_wide_joints_20260914/output/assembly_mesh/servo_knee.stl
design/single_leg_r7_wide_joints_20260914/output/assembly_mesh/yaw_auxiliary_spacer_2.stl
design/single_leg_r7_wide_joints_20260914/output/assembly_mesh/horn_knee_auxiliary.stl
design/single_leg_r7_wide_joints_20260914/output/assembly_mesh/yaw_auxiliary_spacer_1.stl
design/single_leg_r7_wide_joints_20260914/output/assembly_mesh/case_cap_yaw.stl
design/single_leg_r7_wide_joints_20260914/output/assembly_mesh/servo_yaw.stl
design/single_leg_r7_wide_joints_20260914/output/assembly_mesh/horn_yaw_auxiliary.stl
