silmoon04/mist-robot/locomotion/REMOTE_GUIDE.md

# MIST remotes on the MSI

Double-click **Start MIST Remote (Smooth).cmd** in this directory, or the **MIST Remote** desktop shortcut. It starts the installed WSL CPU runtime with the smooth CAD viewer and Faster crawl preview. Both services listen on this laptop's loopback interface:

- [Simulation remote](http://127.0.0.1:8131/): live CAD view, held driving commands, terrain, phone payload, sensors, checkpoint loading and inverse kinematics.
- [Joint preview](http://127.0.0.1:8130/): dry-run joint angles and commissioning controls. The launcher supplies no serial port or physical calibration.

The user reported on 12 October 2026 that the R7 is being built. Loaded motor and telemetry measurements wait until assembly. Walking and physical transfer remain unqualified.

## Using the simulation

Hold a direction to move; release to stop. W/A/S/D drive forward/left/backward/right, Q/E turn, and Space or Escape stop. Shortcuts leave text fields and selectors alone. Motion also stops when the page loses focus, is hidden or loses its connection. The server retains its independent 350 ms command watchdog.

Changing the surface, payload, controller or sensor does not apply until **Apply & reset** succeeds. Advanced settings contain the seed, randomization, sensor profile and checkpoint path. Checkpoint paths refer to the WSL filesystem; loading still requires the matching provenance and sensor contract. An explicit reset refusal preserves the running simulation. If the connection times out during reset, the page reports that the outcome is unknown and reconciles the settings when state returns.

**Faster crawl preview** starts at a 0.025 m/s travel command and uses a 1.2-second leg cycle. The original reference uses a 3.2-second cycle and retains its 0.012 m/s command cap. The preview's measured forward progress is about 0.017 m/s on the flat floor; requested speed is not guaranteed actual speed. The telemetry shows the active cycle, motor target cap and measured simulation pace. A 10 cm floor grid makes world movement visible while the camera follows the body.

The faster gait keeps the original 1.8 rad/s motor target filter, torque limits, latency and physics timestep. A larger target filter did not improve walking in the paired tests. The faster cycle increases simulated joint motion, but loaded hardware response remains unmeasured. This preview still fails the original strict tracking criteria. PPO/SAC and **IK crawl reference** use their original environment configuration and limits; clear the checkpoint path before selecting Faster crawl.

To try more speed, select **Higher speed preview**, press **Apply & reset**, then move Travel speed to **0.040 m/s**. It uses a 1.0-second cycle and achieved 0.02382–0.02430 m/s average forward progress in the flat-ground screen, about 40–43% above Faster crawl. This is the fastest preview tested so far. The 0.8-second cycle moved more slowly, even at a 0.060 m/s request. Higher speed has only been screened forward; it still fails strict tracking and is not a hardware speed rating. Faster crawl remains the startup default.

The CAD view now draws on the browser GPU from measured physics poses, with interpolation between samples. It no longer waits for a server-generated JPEG. The app measured 23–25 fps, while the main server's command response P95 fell from about 267 ms to 3.2 ms. The status beneath the view shows current frame rate and pose age. A paused pose remains at its last measured position. The viewer, CAD meshes and Three.js dependency are served locally and work without a CDN.

The joint page's **Enable preview** enables dry-run angle controls for a 60-second commissioning window. Hold a crawl direction to preview it; release returns to Stand. **STOP / torque off** disables the preview and latches a stop. Inspect the reason, then use **Clear inspected fault** before enabling it again. Disable preview, the watchdog and intent-generation handling remain active. Dry-run angles are requested poses, not measured servo feedback. Hardware commissioning uses the same guarded backend but requires a deliberately launched serial connection and measured calibration. Physical crawl is disabled.

## Session controls

From PowerShell in this directory:

```powershell
& '.\Start MIST Remote (Smooth).cmd' -NoBrowser
& '.\scripts\launch_remote_smooth.ps1' -Status
& '.\scripts\launch_remote_smooth.ps1' -Stop
```

Repeated launch reuses the running session. Stop closes only services created by that session; remotes started separately stay with their original owner. The Linux supervisor uses a process lock and kernel process identity for shutdown.

The default distribution is `Ubuntu`, repository `/home/hssil/mist-locomotion-msi/repo`, and interpreter `.venv-locomotion/bin/python` inside it. A restored installation can select another prepared path:

```powershell
& '.\scripts\launch_remote_smooth.ps1' -Distribution Ubuntu -WslRepo '/home/hssil/mist-locomotion-msi/repo'
```

Startup errors name the relevant log. Windows launcher logs are in `locomotion/.remote-session/` in the review checkout; service logs are in that directory in the WSL checkout. Session files are local runtime state and are excluded from Git and portable archives. Runtime installation and source preservation are described in [MSI_SETUP.md](handoff/MSI_SETUP.md); experiment outcomes and the next gait change are in [MSI_CONTINUATION.md](handoff/MSI_CONTINUATION.md).

The prior **Start MIST Remote.cmd** and **Start MIST Remote (Fast).cmd** remain available for the earlier servers. Stop the current managed session before changing launchers. The smooth launcher refuses an earlier server already occupying port 8131; it does not terminate a separately owned process.
