silmoon04/mist-robot/design/hexapod_phone_quad_20260912/printing/R4_FASTENER_STACKS.md

# R4 fastener stacks and assembly checks

Use this table with the R4 inward-knee geometry and corrected C018 shaft datum. Dimensions are nominal millimetres. A successful solid-intersection check does not establish screw engagement, nut capture, washer seating, driver access or free auxiliary rotation. Check those interfaces with the delivered hardware before copying the first assembled leg.

The purchased screw plan contains 200 screws: 36 M3x35, 16 M3x12, 52 M3x6, 32 M3x8, 24 M3x20, 12 M3x50, 20 M3x10 and 8 M3x16. It also requires 100 plain M3 nuts and 256 washers. Washers are ID3.2, 0.5 thick: 148 have OD6 and 108 have OD7. The 13 supplied main M3x6 and 12 supplied auxiliary PA3.0x5 retainers are counted separately. Quantities exclude spare and coupon-only hardware.

| Attachment | Robot quantity and selected stack | Nominal fit condition |
|---|---|---|
| Leg case caps | 36 M3x35, one OD7 washer and one recessed nut each | 32.73 outer rail span; screw tip extends 1.77 beyond the rail |
| Yaw saddles to deck | 16 M3x12, one OD7 washer and one nut each | 3 mm foot and 4 mm deck; verify tips beneath deck |
| Leg main horns | 48 M3x6, one OD6 washer each | 4 mm cheek; 1.5 mm engagement in 2.5 mm flange |
| Hip and knee auxiliary discs | 32 M3x8, TWO OD6 washers each | 4 mm cheek plus 1.1 mm integral land; 1.9 mm engagement in 2.1 mm flange |
| Yaw auxiliary discs | 16 M3x20, TWO OD6 washers each | 9 mm arm, 3.5 mm counterbore and 11.6 mm spacer; 1.9 mm engagement |
| Lower yaw arm to coxa post | 8 M3x20, one OD7 washer and one nut each | Staggered side-loaded nuts; retain full insertion access before closing arm |
| Femur and tibia bridges | 12 M3x50, TWO OD7 washers and one external nut each | 46 mm outer span plus 1 mm washers and 2.4 mm nut; 0.6 mm tip emergence |
| Phone hub to main horn | 4 M3x6, one OD6 washer each | 1.5 mm counterbore leaves 3.5 mm plastic; 2.0 mm flange engagement |
| Pan saddle to body cover | 4 M3x16, one OD7 washer and one nut each | 4 mm saddle foot plus 4 mm spacer; check captured body nut seating |
| Pan saddle cap | 4 M3x10 and four captured nuts | Side-loaded nuts sit beneath 2.9 mm retained roofs |
| Phone feet to hub and frame | 8 M3x10 and eight captured nuts | Four screws downward and four from behind; tips remain outside phone cavity |
| Phone clips and top cap | 4 M3x16 and four nuts | Retain the phone edges without preloading glass or buttons |
| Body cover and battery tray | 8 M3x10, one OD7 washer and one nut each | Four screws per attachment; inspect battery-side tip clearance |
| Main center retainers | 13 supplied M3x6 | Use the actual supplied main-horn retention hardware |
| Auxiliary center retainers | 12 supplied PA3.0x5, each with one added OD7 washer | Washer spans 6.05 mm disc bore and bears on fixed stub; verify free axial movement |

The pitch auxiliary screws enter along +Y from an under-head plane at Y-24 and end at Y-16. The flange spans Y-17.9 to Y-15.8, leaving only 0.2 mm nominal rear margin. One washer would make these M3x8 screws project 0.3 mm behind the flange. Keep both washers and measure the assembled stack.

The yaw auxiliary counterbore floor is Z-49.5. Two washers place the under-head plane at Z-50.5 and the M3x20 tip at Z-30.5. Its flange spans Z-32.4 to Z-30.3, again leaving 0.2 mm nominal rear margin. An OD7 washer does not fit the 6.2 mm peripheral counterbores. Do not substitute washer sizes or screw lengths without repeating this check.

Each auxiliary center washer bears on the fixed stub tip at servo-local Z-33.1. Its center is Z-33.35, and the PA screw starts at Z-33.6. The disc face is Z-32.4, giving 0.7 mm nominal axial gap to the washer. The 7 mm washer overlaps the 6.05 mm bore by 0.475 mm radially. After the washer, the 5 mm screw has 4.5 mm of nominal entry; this does not prove the actual pilot-hole depth or threaded engagement. Verify the head covers the washer bore, the washer clears the printed opening and the disc rotates freely when the screw is seated against the stub.

The knee case now points inward. Its clamp screws enter from below, opposite to the hip's orientation. Check screwdriver access with the complete femur and tibia in place. Inspect the exposed M3x50 heads, nuts and tips through the permitted motion; the tibia's 8 mm bridge-hole spacing leaves only 1 mm between OD7 washers. Load the coxa's staggered nuts through their side windows before attaching the lower arm. Stop for binding, bottomed screws, washers sitting on support residue, nut pockets that cannot react tension, or parts that need forced spreading.

The distributed mass model estimates 273.946 to 390.991 g for this hardware, with 334.673 g nominal. It assigns the auxiliary center screws and washers to the fixed servo housing links. Replace the old fastener allowance rather than adding both. Weigh actual hardware, and resolve whether the stated bare servo mass already includes the supplied center screws, before final loaded qualification.
