silmoon04/mist-robot/design/hexapod_phone_quad_20260912/manufacturing/knee_inward_study/candidate_phone_notes.txt

This is an isolated corrected-C018 pan candidate. It does not replace the production robot or its printing package.

The C018 shaft is 12.5 mm from the case midpoint. In the existing shaft frame the corrected case extends from X=-35.115 to X=10.115 mm. The pan axis remains at robot XYZ=(0,0,98) mm, and the four body mounting holes remain at (-39,+/-20) and (19,+/-20) mm. Mounting feet, screw stack, landscape phone frame, 6 mm USB spines, corner clips, pan hub and L feet retain their existing interfaces.

The candidate uses the shared servo_contract.py supplier exterior. Its main face is local Z0 and auxiliary face is Z-29. The supplier transformation is x=-(X+25.5), y=Z, z=Y-4.9. At that datum the inspected main cover reaches approximately +2.6 mm, the rear bulge -32.4 mm, and the auxiliary stub -33.1 mm. The main shaft reservation uses the C018 drawing's +3.4 mm projection. These are distinct from the approximate +2.7/-32.3 profile pair, which is displaced by 0.1 mm while retaining the same 35 mm span.

Supplier auxiliary-cover solid 2 has seven invalid nested internal void shells. The canonical study repair uses its valid exterior shell, conservatively filling 17.213290 mm3 of internal voids without changing the outside surface. Other supplier case solids remain unchanged. The case and output shaft are separate physical solids. The manufacturer nominal servo mass remains 55 g; exterior CAD volume is not treated as weighed hardware.

The saddle floor is open beneath the rear bulge and auxiliary stub. Two lower pads at global Z69 bear on the verified auxiliary shoulder near X=0 and Y=+/-11 mm. Two upper lips at global Z98 to 100.5 bear on the opposed main shoulder. The raised main cover remains open above. The lips are outside the 19.95 mm metal horn and remain below the rotating hub underside at Z102.5. The stepped supplier geometry supplies roughly 94 percent material coverage in each sampled shoulder patch; small case grooves explain the remainder. The tests also displace the servo upward and downward to verify a positive contact reaction.

The revised case pocket retains at least 3.05 mm outer walls. Cap nuts still enter through outward-facing side slots at Z80.9 to 83.6 mm beneath a 2.9 mm retaining roof. M3x10 screws retain the original seat at Z90.8. The cap ears keep 0.3 mm of closing travel. Stop tightening when the case is secure, without distorting it.

The bus sockets face down through the auxiliary side. The proposed floor opening is X=-19.35 to -9.65 mm and Y=-12.7 to 12.7 mm. It adds 2 mm in-plane allowance around the supplier shell access region. The production body cover needs the same opening continued through its local thickness. This candidate exports no changed body cover. The independent test uses a separate cover witness plate to check that integration contract.

Connect the bus plugs before fastening the pan module if the cover prevents straight insertion. Route the wires through the opening into the body. The approximate user measurement of a 35 mm case profile, 1.5 mm added plug projection and 2 mm flexible-wire clearance is retained as a provisional clearance check, not assigned an exact socket mating datum. The shell aperture does not measure the individual plug housing, latch or required insertion stroke. Check the owned servo and connected leads before integrating or printing the production mount.

The main metal horn envelope follows the C018 interface: 19.95 mm outer diameter, outer face at local Z4.5, a 5.9 mm central shaft bore, and the supplied boss facing the case. The printed hub and its M3x6 plus 0.5 mm washer stack are unchanged. The phone remains wireless during rotation and charges only when parked.

Run check_candidate_phone.py with the OCP-enabled Python runtime. It reuses the production phone geometry tests, adds supplier shoulder, wall, downward-port and mesh checks, verifies production source hashes remain unchanged, and writes candidate_phone_check.json. Passing runs export candidate_phone_output/corrected_C018_phone_candidate.step and the nine isolated printable STL files.

References are connector_evidence.md, supplier_solid_inventory.md, the local original supplier STEP, and the C018 manufacturer drawing cited in those notes. Exact owned-unit fit, actual plugged-cable geometry, clamp load capability and final integration remain physical checks.
