silmoon04/mist-robot/design/hexapod_phone_quad_20260912/manufacturing/strength/r4_chart_review.md

Iteration 1: generated the actual mesh projection and horizontal section. Lint found an oversized preview and insufficient title clearance.

Iteration 2: reduced export resolution to 1820 pixels wide and lowered the title. Automated lint passed. Visual review found the screw-access label crossed the right plot frame.

Iteration 3: split that annotation into two lines in the generator. Automated lint passed. The image distinguishes retained material, access removal and location leaders; it contains no stress colour scale or inferred force distribution. At reduced display size the two panels and key numeric caption remain readable.

Iteration 4: reviewed the final rendered image again against the computed section and report. The annotation now fits inside its panel. The net area, section modulus, cut position and coupon limitation agree with the numerical record. No further generator changes were needed.
