silmoon04/mist-robot/design/hexapod_phone_quad_20260912/simulation/output_r3_printed_nominal/recorded_motion_notes.txt

RECORDED SIMULATED MOTION

256 exact trajectory poses, shown at 24 fps.
Playback duration: 10.667 seconds. Nominal speed: 6x.
Rigid-link model, 0.588 Nm cap. No new poses or dynamics were generated.
Physical walking and printed strength remain unvalidated.

Trajectory SHA256: 8a6c53f0f2fb08ed6cbd3590989292382f93b964de4679e81994c724e7f85392
Physics report SHA256: 5edd4a7ffe5516ca630bc9e840635f6c129fcf67376262738444d48b987c97d2
Video SHA256: 2e36beb4dfff2946e4687638f46065aef8a79885119333425c85273ed6c0325c
