silmoon04/mist-robot/design/hexapod_phone_quad_r5_20260912/manufacturing/clearance_revision/CHANGE_NOTE.md

# R5 clearance correction

The first inward-hip full-body sweep found 27.407738 mm3 of overlap between a coxa upper part and the deck at the tested 22-degree yaw endpoints. The isolated bracket had cleared its own servo and clamp; the deck was an additional obstacle.

Each final deck relief is a rounded capsule between the previous 85/54 mm location and 77/58 mm, reflected at all four corners, with a 7.5 mm radius. The coxa flange and its load path remain intact. The nearest listed fixing-hole ligament is 3.747382 mm.

At 22 degrees, the coxa still had only 0.656223 mm nominal gap to the fixed yaw saddle despite no solid intersection. Operation is therefore limited to 19 degrees, where the saddle gap is 1.610540 mm. A 312-pair scan across every integer yaw from -19 to 19 degrees finds a minimum deck gap of 1.573865 mm at 18 degrees. The final full-body check passes its 1.5 mm target. Neither check proves continuous loaded clearance or physical print tolerance.

The earlier overlap and 22-degree reports are retained here as superseded workspace evidence. The current release uses manifest 67f0d5e3bfb633414722b17305cef4212ca7f8fa753aa922a252bc383306ad3d and excludes those interim print instructions and native assemblies.
