silmoon04/mist-robot/design/hexapod_phone_quad_r5_20260912/simulation/output_r5_printed_nominal/recorded_motion_notes.txt

RECORDED SIMULATED MOTION

160 exact trajectory poses, shown at 15 fps.
Playback duration: 10.667 seconds. Nominal speed: 6x.
Model with rigid links, 0.588 Nm cap. No new poses or dynamics were generated.
Physical walking and printed strength remain unvalidated.

Trajectory SHA256: 77e4769910f320e06cce9ae3cc259f5c96cf8301a83f837419a2faac7092bd63
Physics report SHA256: 63e2a958f2ad8c25f25b48c7f961b69509029fc2d89290e481ff0dc4c8934714
Video SHA256: f3b5a37abfb9dee186fcf08d0b8d62eeda8622194119f400ac4606e79050b80a
