silmoon04/mist-robot/docs/mist/fusion-guide/drafts/03_leg_assembly.md

# Build one real MIST leg, then assemble all four

This chapter builds the mechanical chain that the concept posters only suggest:

`base_link → q1 hip roll → d1 offset → q2 hip pitch → femur → q3 knee → tibia → driven wheel`

The result is one editable, motion-tested leg module and three associative copies attached at MIST's four actual body azimuths. The dimensions in [`MIST_FUSION_MASTER_DIMENSIONS.md`](../../MIST_FUSION_MASTER_DIMENSIONS.md), the parameter CSV in this guide, and `sim/js/kin.js` are authoritative. The AI posters are composition references only.

> **Poster correction.** The Step 4 poster shows two plain links and a foot, the Step 5 poster shows four mounts at 90-degree intervals, and the Step 6 poster gives generic hip/knee limits. MIST instead has three articulated axes plus a driven wheel, four non-equally-spaced mounts, and the limits listed below. Do not trace the poster holes or type its dimensions into Fusion.

## What this chapter freezes, and what it deliberately leaves open

By the end of the chapter, freeze these facts:

- world frame: `+X` forward toward the phone face, `+Y` left, `+Z` up;
- leg-local mount frame: `Xm` radial outward, `Ym` tangential counter-clockwise, `Zm` up;
- q1 axis point: radius `mount_r = body_dia/2 + mount_standoff = 100 mm`, height `leg_mount_h = 35 mm` above the barrel bottom;
- q1 axis: `+Xm`, radial and horizontal;
- q2 axis point: `d1 = 32 mm` farther outward along q1's axis;
- q2, q3, and the Layout A wheel axes: parallel to `-Ym` in the zero-roll pose;
- `femur = 110 mm` from q2 to q3, measured axis-to-axis;
- `tibia = 70 mm` from q3 to wheel axle, measured axis-to-axis;
- `wheel_dia = 70 mm` at the tire outside diameter;
- the four mount azimuths: FL `+25°`, FR `-25°`, RL `+109°`, RR `-109°`.

Do **not** freeze these without hardware or a design decision:

- servo ear holes, horn bolt circle, spline/horn recess, output-stack thickness, auxiliary support, cable exit, and fastener lengths;
- bearing sizes, wheel width, hub stem length, or a Layout B belt and pulley standard;
- the final wheel-heading strategy;
- final mechanical stops or cable-safe joint limits.

The first pass is therefore a kinematically exact blockout with measured envelopes. The second pass turns the envelopes into printable, double-supported brackets after the real STS3215, horn, screws, bearings, and coupons are available.

## Read the chain before drawing it

| Joint | Parent → child | Axis point | Positive axis | Zero definition | Analysis ROM |
|---|---|---|---|---|---:|
| `q1` hip roll | `base_link/root_mount → hiproll` | `R=mount_r`, `Z=leg_mount_h` | radial `+Xm` | leg plane vertical | `-60°…+60°` |
| offset `d1` | within `hiproll` | q1 to q2, outward | along `+Xm` | not a joint | `32 mm` |
| `q2` hip pitch | `hiproll → femur` | q1 point + `d1` | rolled `-Ym` | femur straight down | `-35°…+110°` |
| `q3` knee | `femur → tibia` | q2 + `femur` | parallel to q2 | tibia aligned with femur | `-135°…+135°` |
| wheel | `tibia → wheel` | q3 + `tibia` | Layout A: parallel to q3 | arbitrary spoke index | unlimited in CAD |

Positive q2 rotates a straight-down femur toward radial outward. MIST's current spider-like inverse-kinematics branch uses a negative q3 value: the knee bows out and the tibia returns toward the wheel. Do not mirror a leg to obtain the other side; rotating the same module to a different mount frame preserves this convention.

For a useful visual check, the current neutral reference (`stance_r=176 mm`, barrel-bottom clearance `148 mm`) evaluates to approximately:

`q1 = 0°`, `q2 = +40.52°`, `q3 = -63.63°`

That value is derived from the current geometry and `sim/js/kin.js`. It is a CAD pose check, not a servo calibration or a promise that the bracket clears there.

## Hard design gate: decide what “driving” means

At zero roll, the current kinematic model makes each wheel axle tangential and each ordinary wheel's rolling line radial. Its four rolling-line headings are therefore `+25°`, `-25°`, `+109°`, and `-109°`. They are not parallel.

That arrangement cannot behave like conventional four-wheel skid steering without lateral tire slip. Even straight motion asks some wheels to scrub. Moving the wheel servo from the axle to the knee in Layout B does **not** change this fact; it only changes how torque reaches the same axle.

| Direction | What it preserves | What it costs |
|---|---|---|
| Accept fixed radial wheels and scrub | simplest common leg; q3 and wheel axes stay parallel; current Layout A/B study remains closest | tire wear, wasted power, unpredictable floor loads, poorer odometry; must be proven slowly on the real floor |
| Make four wheel rolling lines parallel to `+X` in the neutral pose | familiar forward drive and skid-turn model | wheel axle is no longer simply knee-parallel; needs per-corner yaw adapters, an adjustable pod, or a distal redesign; common-carrier symmetry may be lost |
| Use omni wheels | tolerates lateral velocity while keeping the leg-plane axle | different wheel, traction, vibration, noise, print/BOM, and floor-contact behavior |
| Add a passive caster/swivel | wheel may self-align | a driven caster is mechanically awkward, heading can flutter or reverse, and it is poor as a precise leg endpoint |
| Add powered steering | heading becomes controllable | four more axes, actuators, cables, mass, current, software, and collision envelopes |
| Keep a bolted, adjustable wheel pod for v1 trials | lets physical tests choose before a permanent carrier is printed | more fasteners and another interface that must not slip under wheel torque |

**Gate W:** do not print four final wheel carriers, cut a permanent horn recess, or claim skid steering until one option is selected. The safest CAD move now is a removable wheel pod with a repeatable datum and enough yaw adjustment to test radial and parallel headings.

## 1. Prepare the current Fusion file

These paths are for Autodesk Fusion `v2704.1.23` as checked on 12 July 2026. If a command is not visible in a compact toolbar, press `S`, type its current name, and launch it from the Toolbox.

1. Open the guide's **Hybrid Design** in **Parametric Modeling Mode**.
2. Activate the top/default component before creating assembly relationships. Joints, contact sets, and motion studies belong at assembly level.
3. Open `Modify > Change Parameters` and confirm the imported values in [`../mist-fusion-parameters.csv`](../mist-fusion-parameters.csv), especially `mount_r`, `d1`, `femur`, `tibia`, the four azimuth parameters, and `q1_min` through `q3_max`.
4. In the Browser, right-click `base_link` and choose **Pin**. Current Fusion renamed the old top-level **Ground** action to **Pin**. **Ground To Parent** is a different child-to-parent relationship and is not the command wanted here.
5. Save a named version before assembly work, for example `MIST_leg_chain_axes_v01`.

For every new internal part, use `Design > Solid > Assemble > New Component`, set `Type: Part`, `Part Type: Standard`, clear **External**, enter the name, and check **Activate**. Creating the component before its sketches keeps its parametric history reusable. If **External** is unavailable, verify that the file is a Hybrid Design rather than a pure Assembly Design.

Do not use `Extrude > Operation: New Component` for this reusable leg. Current Autodesk guidance warns that this shortcut can leave the sketch/history in the default component, which makes later reuse and copying harder to understand.

## 2. Build the four body mount datums

The mount skeleton is more important than the cosmetic shell. It prevents a later body edit from silently rotating a joint axis.

### 2.1 Make the mount-height sketch

1. Activate `base_link`.
2. Choose `Design > Solid > Construct > Offset Plane`.
3. Select the barrel-bottom datum plane, not a filleted shell face.
4. Enter `leg_mount_h` as the offset and rename the result `PL_leg_mount_height`.
5. Start a sketch on `PL_leg_mount_height`; rename it `SK_mount_azimuths`.
6. Project the body origin with `Create > Project/Include > Project` if it is not already selectable.
7. Draw a centre-point circle at the body axis. Toggle it to **Construction** and dimension its radius as `mount_r`.
8. Draw a horizontal construction line from the centre along world `+X`; this is the zero-azimuth reference toward the phone.
9. Draw four construction rays from the same centre to the circle. Constrain every outer endpoint coincident with the construction circle.
10. With `Sketch > Sketch Dimension`, set the signed ray angles as follows. Use dimensions or symmetry expressions, not eyeballed positions.

| Point | Expression | World interpretation |
|---|---:|---|
| `P_FL_q1` | `front_az` | forward-left, `+25°` CCW from `+X` |
| `P_FR_q1` | `-front_az` | forward-right, `-25°` |
| `P_RL_q1` | `rear_az` | rear-left, `+109°` |
| `P_RR_q1` | `-rear_az` | rear-right, `-109°` |

11. Add a sketch point at each ray endpoint and rename the point/ray through the sketch feature names where practical.
12. Fully constrain the sketch, then finish it.

The angular gaps are not four equal quadrants. Around the ring they are `50°`, `84°`, `142°`, and `84°`. A four-instance Circular Pattern or two Mirrors produces the poster robot, not MIST.

### 2.2 Create explicit base joint origins

For each of the four sketch points:

1. Choose `Design > Solid > Assemble > Joint Origin`.
2. Set **Mode: Simple** and select the named sketch point.
3. In **Alignment**, choose **Reorient**.
4. Set the joint origin's `Z Axis` along that point's radial sketch ray, outward from the body centre.
5. Set its `X Axis` straight down, parallel to world `-Z`. This makes the origin right-handed and gives every leg the same zero-roll reference.
6. Click OK and rename the origin `JO_FL_mount`, `JO_FR_mount`, `JO_RL_mount`, or `JO_RR_mount`.

Use the joint-origin coordinate glyph, not only the dot, as the check. At every mount:

- origin Z arrow: radial outward;
- origin X arrow: down;
- q1 point: exactly on `mount_r` and `leg_mount_h`;
- no arrow is copied from a global axis by accident.

To make the glyphs legible, use the Navigation bar at the bottom of the canvas: `Display Settings > Object Visibility > Joint Origins` or `Joint Origin Axes`.

**Gate M:** from Top view, the four origin Z arrows must lie on the four radial rays; from Front/Right views, all origin points must be on the same mount-height plane.

## 3. Create a reusable leg module as rigid links

Create an organisational parent called `LEG_MASTER`, then create these internal components under it. The parent has no printable body.

| Working component | What is rigidly inside it | Export/final name for the FL instance |
|---|---|---|
| `root_mount` | stationary q1 servo case reference, ear bracket, chassis interface, optional opposite-side support | `FL_root_mount` or merge to `base_link` by a fixed joint |
| `hiproll` | q1 metal horn reference and moving cradle; `d1` bridge; q2 servo case and its fixed bracket | `FL_hiproll` |
| `femur_link` | q2 horn/clevis, 110 mm femur beam, q3 servo case and bracket | `FL_femur` |
| `tibia_link` | q3 horn/clevis, 70 mm tibia beam, Layout A wheel-servo case/carrier | `FL_tibia` |
| `wheel_link` | metal wheel horn, PETG hub, TPU tire | `FL_wheel` |

The `root_mount` is a Fusion/printing convenience, not a fourth leg degree of freedom. It attaches to `base_link` with a rigid placement joint. Keeping it separate lets **Duplicate With Joints** copy the q1 servo pocket and bracket to the other three mount datums. At URDF/export time it can remain a fixed link or be merged into `base_link`.

### Bodies are not links

Fusion joints act between **components**, not between bodies. A single `Leg` body containing all beams, clevises, servo cases, and wheels cannot articulate. Conversely, do not split a rigid beam, bracket, and its captive servo body into independent moving components unless they are joined rigidly.

If detailed purchased hardware is nested as separate reference components, select only hardware that moves with the same link and use `Assemble > Rigid Group`. Never include components from both sides of q1, q2, q3, or the wheel in one Rigid Group.

### Put servo parts on the physically correct side of each joint

The servo case and its mounting ears are stationary relative to the **parent** link. The output horn is stationary relative to the **child** link:

| Axis | Servo case belongs with | Horn/output belongs with |
|---|---|---|
| q1 | `root_mount` | `hiproll` |
| q2 | `hiproll` | `femur_link` |
| q3 | `femur_link` | `tibia_link` |
| wheel | `tibia_link` | `wheel_link` |

Do not import a servo as one rigid component that spans both sides of a revolute joint. Either split the visual reference into `servo_case_ref` and `servo_horn_ref`, or place copied reference bodies in their respective link components.

## 4. Model the one-leg geometry

Work at the FL mount first, but dimension the module in its own local frame. Activate only the component being edited. Show neighbouring components as translucent references; do not accidentally extrude into them.

### 4.1 Make a measured STS3215 envelope

Until the servos arrive, the only locked case envelope is `servo_l × servo_w × servo_h = 45.2 × 24.7 × 35 mm`. Create a simple case body and add clearly named provisional bodies for:

- mounting ears and ear holes;
- output boss/shaft axis;
- metal horn outside diameter, thickness, bolt circle, and centre screw;
- opposite-case/auxiliary support feature;
- both bus sockets, plug insertion space, and the cable bend envelope.

Prefix uncertain bodies or dimensions with `VERIFY_`. The case box proves packaging; it does not prove a printable pocket. Do not infer ear holes or horn geometry from the AI render.

The print kit contains 0.3 mm and 0.5 mm servo-pocket coupons. They are calibration choices, not proof that either clearance fits the actual unit. In this guide, `pocket_clearance_per_side` means clearance on **each side**:

`pocket_width = measured_servo_width + 2 * pocket_clearance_per_side`

Keep that distinct from `pin_radial_clearance`, which is a **radial** gap:

`free_bore_dia = measured_pin_dia + 2 * pin_radial_clearance + hole_diameter_comp`

The last term is a separately coupon-tuned printer process correction, not desired fit.

### 4.2 Build the q1 root and hip-roll cradle

1. In `root_mount`, place the q1 servo output axis at `JO_FL_mount`.
2. Orient its output axis along local `+Xm`—the base joint origin's Z axis—not vertically and not tangentially.
3. Create the stationary ear bracket around the servo envelope. Leave tool access to every mounting screw and space to unplug the bus connector without removing the barrel.
4. In `hiproll`, place the q1 horn at the same axis.
5. Create a moving U-cradle or two-cheek bracket around the servo. One cheek connects to the metal horn; the other provides a coaxial auxiliary pivot/bearing or supported idler.
6. Extend the moving structure outward along the q1 axis until the q2 axis is exactly `d1` from q1.
7. Place the q2 servo case in the `hiproll` component with its output axis along local `-Ym`.

`d1` is an **axis-to-axis offset along q1**, not a vertical link and not the thickness of the q1 bracket. At 32 mm, packaging is tight relative to a 24.7 mm servo body. Prove room for the horn stack, bracket cheeks, washers, support, and cable before decorating the part.

### 4.3 Use a servo-supported clevis, not a printed pin pretending to be a servo

Use the same load-path pattern at q1, q2, q3, and preferably the wheel:

1. The real metal horn transmits torque on one side.
2. A printed moving tongue or hub bolts to that horn.
3. Two structural cheeks place the moving link in double shear.
4. The far cheek uses a coaxial bearing, bushing, shoulder screw, or the servo's verified auxiliary support feature.
5. A small controlled axial gap plus washers prevents rub.
6. The output and support axes must be genuinely coaxial; forcing a misaligned far support will preload the servo and make it run hot.

The print kit's 7 mm clevis / 6 mm tongue / M3 pin coupon is a useful passive-hinge experiment. It is **not** the final geometry for an actuated STS3215 joint. Keep the metal horn and the servo output axis in the real load path.

Every bracket needs:

- a removable horn-centre-screw path;
- captive-nut, nyloc, or heat-set-insert access as chosen later;
- enough material around holes after print shrinkage;
- a cable slot and a service loop that cannot reach the horn;
- clearance at the entire ROM, not only the home pose;
- a print orientation that does not put the primary bending load across a weak layer seam.

### 4.4 Model the femur

1. Activate `femur_link`.
2. Make a side-profile sketch in the q2–q3 leg plane.
3. Place the q2 and q3 axis centres first and dimension their separation as `femur`.
4. Build the beam around that construction line using `beam_w` and `beam_t`. Keep the **axis centres** 110 mm apart after end caps, fillets, and pockets are added.
5. At q2, add the horn-attached tongue/hub and the opposite support feature.
6. At q3, place the q3 servo case and fixed double-support bracket. Its output axis must be parallel to q2.
7. Cut cable passages only after a swept cable envelope exists. A tunnel through the narrowest beam section can erase the stiffness gained by `beam_w` and `beam_t`.

The AI poster's “90 mm upper link with Ø12 holes” is not a usable shortcut. The actuator axis is defined by the measured servo output and support, not by a generic through-hole.

### 4.5 Model the tibia and Layout A wheel carrier

1. Activate `tibia_link`.
2. Place its q3 origin at the proximal end and its wheel-axis origin exactly `tibia` away.
3. Build the beam around the 70 mm axis-to-axis construction line.
4. At q3, add the horn-attached tongue/hub and far-side support.
5. At the distal end, place the Layout A wheel-servo case. Its output axis is parallel to q3 in the current kinematic baseline.
6. Make the direct wheel carrier a **removable pod** attached to a repeatable planar datum on the tibia. Keep its final bolt pattern provisional until fasteners and wheel-heading strategy are selected.
7. Push the wheel hub outboard on a parameterised stem far enough that the 70 mm tire does not touch the tibia, servo case, screw heads, or cable. A previous printable concept had a real wheel/shin collision.
8. Add an opposite-side wheel support if packaging permits. A wheel hanging only from the servo horn sends ground impacts and bending load into the servo output bearing.

Increasing the hub stem improves shin clearance but increases bending moment on the servo, support, and printed carrier. The correct value is the shortest stem that clears the complete moving envelope plus print and assembly tolerance.

### 4.6 Model the wheel as its own component

1. Activate `wheel_link`.
2. Sketch the 70 mm tire outside diameter on a plane normal to the axle.
3. Make a PETG hub and TPU tire as separate bodies within the same rigid component, or as nested components held in one Rigid Group.
4. Keep wheel width provisional; the old print kit mentions 30 mm, but the current master dimensions do not lock it.
5. Model the real metal horn and its measured fasteners. Do not print an invented spline.
6. Add a visible spoke/index mark to make wheel rotation and sign obvious in Fusion.

The old `fit_wheel_slice_76` coupon is a 76 mm legacy interface test. It must not overwrite the current `wheel_dia = 70 mm` baseline.

## 5. Reserve the Layout B corridor now

Layout A is the v1 recommendation: all four leg actuators are direct, so there is no transmission to tension or tune. Layout B moves only the wheel servo to the knee and uses one belt along the rigid tibia to a bearing-supported axle. The belt crosses no moving joint, which makes it the least difficult later upgrade.

| Study result | Layout A, all direct | Layout B, wheel at knee |
|---|---:|---:|
| Optimised femur/tibia | 111/70 mm | 82/91 mm |
| Optimised `d1` | 32 mm | 31 mm |
| Optimised front/rear azimuth | 25°/109° | 25°/119° |
| Mass | 3223 g | 3263 g |
| Crawl peak servo | 42% stall | 35% stall |
| Hip swing torque | 0.125 N·m | 0.128 N·m |
| Runtime estimate | 38 min | 41 min |

The counter-intuitive swing result matters: moving the wheel servo to the knee does not automatically reduce every hip load because the knee can have a longer gravity arm in the sprawled pose. Layout B also has a different optimised geometry. Reserving a corridor in the 110/70 Layout A leg makes a retrofit physically possible; it does **not** turn that leg into the optimised Layout B result.

### Create non-printing keep-outs

1. Under `LEG_MASTER`, create an internal component named `REF_layout_B_keepouts`.
2. Create a servo envelope adjacent to q3 called `KEEP_B_wheel_servo`.
3. Create a straight swept/rectangular volume from the knee pulley region to the wheel axle called `KEEP_B_belt_run`.
4. Add `KEEP_B_axle_bearing` and `KEEP_B_tensioner_sweep` cylinders/volumes.
5. Give all keep-outs a bright translucent appearance and place `REF_` / `KEEP_` at the start of every name.
6. Do not include the component when exporting printable bodies.

The keep-out sizes remain provisional until belt pitch/width, pulley tooth counts, bearing, shaft, tension method, guards, and allowable belt twist are selected. The corridor still enforces useful rules now:

- no cross-rib, fastener, horn screw, or cable tunnel blocks the knee-to-axle line;
- there is a flat mounting land near q3 for a future wheel servo;
- the axle region can accept a bearing-supported free axle rather than only a servo spline;
- the direct wheel pod can be removed without cutting the tibia;
- a guard and tension adjustment have somewhere to exist.

Do not hollow the whole tibia into a belt tunnel. That trades a future mechanism for a current structural weakness. Reserve an **external or locally guarded corridor** first, then calculate the final section after belt selection.

**Gate B:** hide `REF_layout_B_keepouts`, verify Layout A assembly; show it, run `Inspect > Interference` against the tibia and hardware, and confirm no unintended physical body occupies the reserved route.

## 6. Create and orient the joint origins on the leg

Use `Design > Solid > Assemble > Joint Origin`. The point says **where** a joint is; the coordinate triad says **which way it rotates and what zero means**. Create both sides of each interface explicitly.

| Origin | Component | Location | Origin `Z Axis` | Origin `X Axis` at zero |
|---|---|---|---|---|
| `JO_mount_root` | `root_mount` | q1-axis pod-placement datum, coincident with `JO_q1_parent` | radial outward | down |
| `JO_q1_parent` | `root_mount` | q1 output centre | radial outward `+Xm` | down |
| `JO_q1_child` | `hiproll` | q1 horn centre | radial outward `+Xm` | down |
| `JO_q2_parent` | `hiproll` | q2 output centre | `-Ym` | down |
| `JO_q2_child` | `femur_link` | q2 horn centre | `-Ym` | femur distal direction at q2=0 |
| `JO_q3_parent` | `femur_link` | q3 output centre | parallel to q2 | femur distal direction |
| `JO_q3_child` | `tibia_link` | q3 horn centre | parallel to q2 | tibia distal direction at q3=0 |
| `JO_wheel_parent` | `tibia_link` | wheel-servo output centre | parallel to q3 for Layout A | a chosen visible radial/index direction |
| `JO_wheel_child` | `wheel_link` | horn/axle centre | same as parent | same visible index direction |

For a circular edge or hole whose centre is hard to select, hover over the face/hole, hold `Ctrl` on Windows, then select the obscured snap point. Use **Reorient** to select the intended Z and X directions. Use **Flip** only when the triad needs reversing; do not compensate for a wrong origin with an arbitrary joint angle.

The q2, q3, and wheel axes are **parallel**, not coincident. q3 sits one femur length from q2; the axle sits one tibia length from q3.

**Gate A:** show only Joint Origin Axes and link centreline sketches. All parent/child origin pairs must be coincident when the module is in its zero pose, and each pair's Z and X arrows must agree.

## 7. Add the five assembly relationships

Current Autodesk guidance recommends the normal **Joint** command with **Duplicate With Joints**. Use As-Built Joint only when already-positioned imported geometry makes repositioning undesirable and you accept a less direct duplication workflow.

### 7.1 Rigidly place the root at FL

1. Activate the top/default component.
2. Choose `Design > Solid > Assemble > Joint`.
3. On **Position**, set Component 1 to `root_mount` and select `JO_mount_root`.
4. Set Component 2 to `base_link` and select `JO_FL_mount`.
5. Use **Flip** only if the root points into the barrel.
6. On **Motion**, choose **Rigid**.
7. Click OK and rename the relationship `FL_mount_fixed`.

The base is pinned; the root is fixed to it by a real relationship. Do not Pin each leg part. Pinning all of them masks missing or incorrect joints.

### 7.2 Add q1, q2, q3, and wheel

For each row below, use `Design > Solid > Assemble > Joint`, select the child origin as Component 1 and the parent origin as Component 2, then choose **Motion: Revolute** and **Rotate: Z Axis**.

| Name | Component 1 / Component 2 | Minimum | Maximum | Rest for frame audit |
|---|---|---:|---:|---:|
| `FL_q1_roll` | `hiproll` / `root_mount` | `q1_min` | `q1_max` | `0 deg` |
| `FL_q2_hip` | `femur_link` / `hiproll` | `q2_min` | `q2_max` | `0 deg` |
| `FL_q3_knee` | `tibia_link` / `femur_link` | `q3_min` | `q3_max` | `0 deg` |
| `FL_wheel` | `wheel_link` / `tibia_link` | unchecked | unchecked | `0 deg` |

In the **Motion > Joint Motion Limits** section, enable Minimum and Maximum and enter the parameter expressions. The wheel remains an unlimited Revolute joint because Fusion has no separate “continuous” joint type. Unchecked limits mean continuous for the CAD model; firmware must still impose speed, current, temperature, and mode safety.

Use **Preview Motion** to check each axis. Then stop and verify the sign:

- positive q1 follows the right-hand rule about radial `+Xm`;
- positive q2 moves a down-pointing femur radially outward;
- q3 zero makes tibia and femur collinear; MIST's current neutral branch uses negative q3;
- positive wheel rotation agrees with the visible wheel index and the sign convention intended for firmware.

If a sign is wrong, reorient/flip the joint origins. Do not silently reverse one limit pair or add `180°` until the animation looks plausible; that creates a CAD/URDF/firmware mismatch.

### CAD zero, home, limit rest, and servo centre are different things

- **CAD zero** defines the kinematic frames above.
- **Joint Rest** is a Fusion assembly setting; it is not written to the servo.
- **Home Position** is the pose Fusion returns to. After driving the leg to the validated neutral reference, right-click a joint and use **Set as Home Position** only if that behavior is useful for the assembly.
- **STS3215 position 2048** is the electrical/mechanical centring step before the horn is fitted.

Because q2's requested range is asymmetric (`-35°…+110°`), servo centre 2048 does not automatically equal the middle of the CAD reference range or q2=0. Choose horn indexing and the firmware centre offset deliberately after the physical bracket range is known.

Joint limits in Fusion are an analysis aid, not a physical stop and not a firmware guard. Final protection needs all three: collision-safe printed geometry, firmware min/max calibration per servo ID, and a mechanical/cable arrangement that cannot destroy itself on a bad command.
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
