silmoon04/mist-robot/docs/mist/fusion-guide/drafts/05_parameter_tradeoffs.md

# Parameter impact, trade-offs, and experiment appendix

This appendix explains what each number means, what it is allowed to drive, and
what else must be rechecked when it changes. It is deliberately stricter than a
normal dimension table: a robot can recompute cleanly in Fusion and still be
unreachable, unstable, hard to print, or impossible to assemble.

> **Authority and scope.** The build-CAD baseline is the table in
> [MIST_FUSION_MASTER_DIMENSIONS.md](../../MIST_FUSION_MASTER_DIMENSIONS.md):
> femur 110 mm, tibia 70 mm, wheel diameter 70 mm, and Layout A direct
> actuation. The actuator study used an unrounded 111 mm femur when it generated
> its reported metrics. Both values appear below only where that distinction
> matters. The default sliders in the simulator are generic starting values,
> not the MIST Fusion baseline. Dimensions drawn into AI concept images and the
> older 65/85 mm print-test beams are not dimensional authorities.
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
