silmoon04/mist-robot/design/assembly_handoff_20261008/assets/Femur_Upper_Lip_Support.png

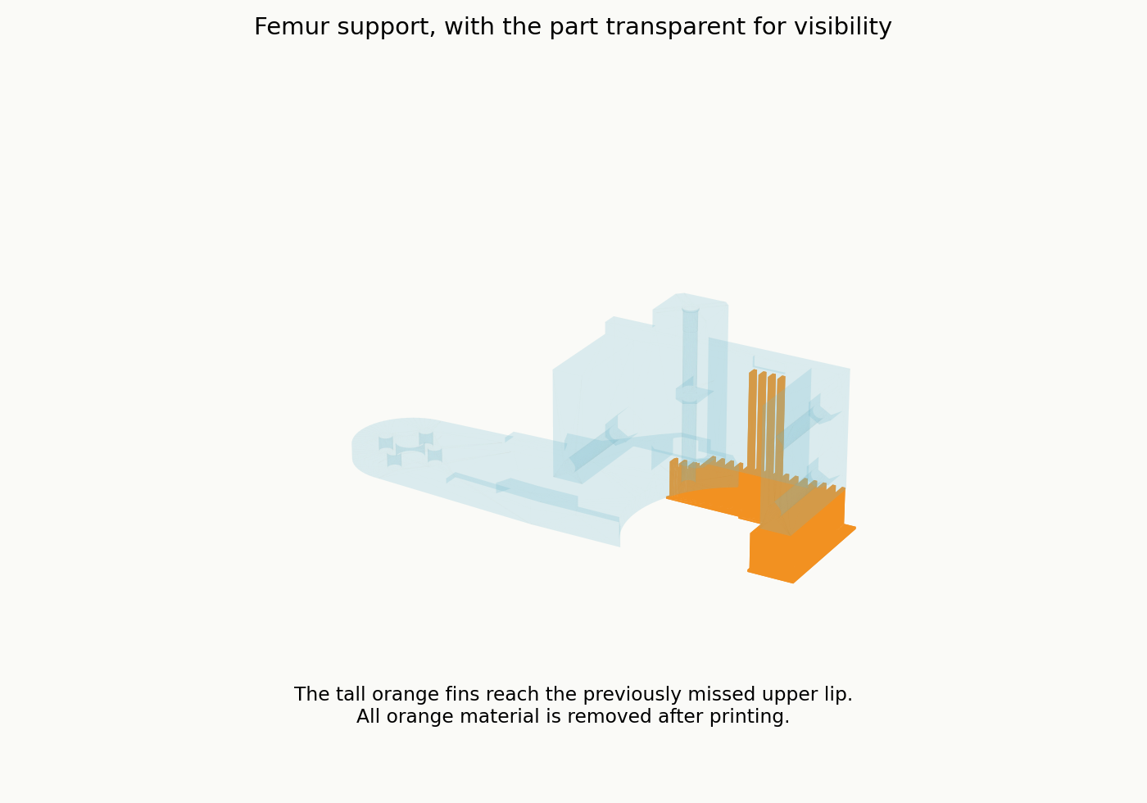
design/assembly_handoff_20261008/assets/Femur_Upper_Lip_Support.png
