silmoon04/mist-robot/design/print_profiles_20260913/profile_validation.txt

PROFILE VALIDATION

Result: pass
Profile: Neptune4Pro_R5_FirstFit_PLA_020.curaprofile
SHA256: de71f5a382e428ca2bcdc8a044cfea082e9d9fb180db9212ee6d510e38793338
Target: Installed UltiMaker Cura 5.13, ELEGOO NEPTUNE 4 Pro, 0.4 mm nozzle, PLA
Validated settings: 128

First-plate engine trial:
Model PLA: 92.09 g
Support PLA: 6.27 g
Adhesion PLA: 2.69 g
Estimated time: 10.26 hours
Peak calculated deposition flow: 7.00 mm3/s
Motion bounds: [[1.18, 24.768, 0.2], [223.82, 200.232, 42.0]]
Supports generated and all moves within the 225 x 225 x 265 mm analysis envelope.

This is an engine trial with the same process overrides on an explicit numeric analysis stack. The file has not been imported into the live Cura frontend or tested on the physical printer. Actual slicing can differ with machine, material and retained user settings.
