silmoon04/mist-robot/brain/art_direction/game_face_research_20260929/RESULT.md

# Game face research delivered

Published: https://silmoon04.github.io/mist/game-face-references/

Pages build: 7362b5923a0240ca8bac45ee003ff584652eed95, status built.

Nine research branches contributed 35 studies, supported by 78 unique source pages and 53 credited people with role-specific evidence. The catalog has 85 verified media URLs and one excluded, known-unavailable video. Fifty supplied image/GIF assets decoded in the independent audit. Twenty-four studies are featured.

Catalog SHA-256: 489dd7822c08ccdbfbc47ae612608ec2d9e91d46663b30dabbe093d80e602f9e

## What was delivered

- Art-first board with supplied GIFs, stills, drawings, official clips and animator process links.
- Inspector with exact project roles, source links, observations, creator statements and separately labeled MIST proposals.
- Search, context and media filters, featured shortlist, GIF pause, original-size links, local saves and notes, JSON/Markdown export and import.
- Source CSV, full research report, proposed MIST study plan, and research ZIP containing the linked board and notes. Source art remains on its original hosts.

## Verification

Independent media/credit review is bound to the catalog above. UI checked desktop and 390px phone layout, note persistence, actual export files, current-frame GIF pause, clip cleanup, supplied Vimeo hash and malformed inputs. Seven regression checks pass. Root checked the published DOM, source image access and all ten public text files against the packaged hashes, plus exact research ZIP bytes. Public verification and the actual published-board screenshot are in qa/.

## Limits and next work

Sampled visuals and creator accounts support the research observations. They do not certify exact blink cadence, production frame counts or a continuously watched performance. All catalog motionVerified fields remain false. Wide source GIFs and full-paper drawings can be enlarged through the inspector's original-size link. Unknown shot-specific authorship stays unknown.

No new MIST animation style was selected in this pass. Use the board's saved references and reasons to write the next drawing brief. Preserve MIST's existing cyan screen-face identity unless the user chooses a different direction. The proposed studies focus on distinct held poses, emotional speech-mouth families, local eyelid geometry, event-specific reactions and interruption-aware playback. Existing voice and animation routes were preserved.
