silmoon04/mist-robot/brain/art_direction/artist_studio_20260916/reuse/thinking_v8/qa_findings.md

# Final independent QA

The independent checks are ready in `qa_assets.cjs` and `qa_runtime.cjs`. Run them from any working directory with Node. They write `qa_assets_report.json` and `qa_runtime_report.json` beside the scripts.

The final `qa_assets_report.json` passes against the completed 192-frame manifest. All eight contact reviews pass and all source/component/frame hashes match. The minimum visible-art crop margin is 21 pixels.

The final `qa_runtime_report.json` passes against runtime `0a08259942ac3fa32c1c7dc51372ba0bf3e008553ec1a1860cc6421f36a8a55f`. Independent inspection confirms the entrance now approaches the last phrase's gaze and lean, which are also the active loop's starting values. This fixes the previously detected searching gaze jump at 600 ms. The continuity threshold was not weakened, and all eight activities pass the boundary checks.

Runtime checks pass for all forty original faces and blinks, three automatic variants, explicit face overrides, speech stability and original mouth behavior, all 64 stale-completion replacement pairs, and phase reachability. Search clearance covers 1,960 states and 2,040 visible prop-layer samples, including both images during exit blending, with zero overlaps and a minimum gap of about 10.96 face-coordinate units. The final asset, runtime, and visual reports are bound to manifest `48562750d59e7fa052a3737038177cfdd311bd4c67f577786da1437337baec5a`.

All eight studies have contact approval, including the assembled sorting/checking/connecting loops and corrected drafting sequence. The reported total is 192 playback frames; declared component reuse does not represent 192 independently drawn poses. The earlier `qa_runtime_contract_report.json` and `qa_semantic_probe.json` concern development versions and must not be used as final asset evidence.

The measured active phrases are 2.4 seconds for coding and drafting, 2.6 seconds for sorting, 3.0 seconds for reading, 2.9 seconds for quiet thought, and about 2.13 seconds for each continuous scanning activity. The original audio clock remains unquantized while speech paints at 15 fps, including immediate consonant and stopped-audio closure between display ticks.

The earlier book acceptance was wrong: a blank turning-page back did not justify text popping onto the landing page. That source has been replaced with a printed front/back turn. The rejected checking sheet's repeated coarse positions and disappearing scanner have been replaced by a continuous bracket assembly. The approvals below apply only to these reviewed replacements. Absence of success ticks alone does not establish good motion.

Different pixel hashes do not establish different poses. Small drawing noise, outline wobble, and antialiasing differences can make repeated poses hash differently. Final acceptance requires manual inspection of consecutive active cels, the loop seam, persistent body position, and entrance/exit logic. The automatic report remains an asset-integrity report, not a motion-quality verdict.

Final visual review is complete for the rebuilt contact sheets with their current body registration. Cel numbers are zero-based and refer to the whole 24-cel sheet; active cels are 4 through 19.

| Study | Current visual verdict | Consecutive motion and continuity | Persistent body and phase behavior |
| --- | --- | --- | --- |
| Reading / book | Contact review approved for replacement source | Text is now present on both sides of the moving page and remains attached through the right-to-left turn. The page settles onto an already printed left side. No blank flat page gains text. | Spine and lower outline stay in the same place after registration. Entrance, active turn, and shrinking exit are coherent. Small drawn-outline variation remains. |
| Coding / terminal | Contact review approved for corrected source | Success marks have been replaced with plain code strokes. Typing, changing line, and upward scrolling are distinct actions. Cels 4/19 deliberately approach the same empty-screen start around the loop seam. | Bottom registration removes the major row drift. Slight differences in screen lean/width remain but do not interrupt the action. Opening and closing are readable. |
| Drafting / note | Contact review approved for hybrid component assembly | The first stroke now grows in steps while the pen follows its end. The upper line remains visible during the lower-line stroke. The marked page leaves through the top binding before the pen returns to the blank page. | The explicit page-body anchors remove the former drop at cel 16. Generated finishing/page-turn cels retain small pen and contour variations but stay grounded. Pad, pen, and handwriting crops are reused for the early action; the final six active page cels remain generated drawings. |
| Sorting / cards | Contact review approved for rigid component assembly | The centre card rises and returns in successive visible steps, then the left card rises and returns. Repeated positions occur on the return paths rather than in padded groups of consecutive poses. | The three rigid card silhouettes keep their shape. The front card correctly hides rear outlines, including while it rises. Entrance opens the fan; exit closes and shrinks it to the original single-card shape. The 24 outputs reuse one generated card component three times; they are not 24 independently drawn source poses. |
| Searching / searching | Contact review approved for replacement source | Scanner remains visible, crosses left to right, rounds the endpoint, and comes back left. The former blank-scanner cels 17/18 now show return positions. | The rectangular body stays registered. The scanner has a natural short turnaround, not padded groups of repeated poses. It remains present while the exit shrinks. |
| Quiet thought / planning | Contact review approved for replacement source | Dot positions now describe an ordered outward-and-return path. The old repeated return groups are gone. The near-endpoint cels represent the turnaround and loop closure. | The arc retains slight hand-drawn variation. It reads as one persistent guide curve rather than an unrelated moving outline; pixel identity is not required. |
| Connecting / connecting | Contact review approved for rigid component assembly | One filled packet advances right and returns left in successive positions. The former mid-loop jump is gone. The seam moves 4 source pixels, within an ordinary step of at most 9 pixels. | Fixed endpoint/path component keeps its shape and position. Gaps remain, with no success tick or completed solid connection. The marker stays attached to the shrinking entrance/exit assembly. |
| Checking / checking | Contact review approved for rigid component assembly | The right-hand bracket moves continuously down the three rows and back up; no disappearing or coarse three-stop groups remain. The seam moves 7 source pixels, within an ordinary step of at most 15 pixels. | Page and row contents remain fixed. The bracket remains visible in all active frames and scales with the page during entrance/exit. Body and bracket are declared reused generated components. |

The reviewed source/contact hashes and machine-readable verdicts are in `qa_visual_report.json`. Parent browser review is recorded separately in `BROWSER_CHECK.md`: all eight studies load, checking exits to the original face, reading retains printed marks, frame/playback controls work, and the saved voice sample plays to completion with speech mouths and dimmed, held props. That review reports no console errors; it does not claim subjective audio listening or a live voice-provider test.

The Lordicon research and four concrete motion principles are saved in `qa_references.md`. The official guidance supports quick interaction beats that slow into a hold, separate entrance/action/state-change behavior, plausible prop mechanics, and movement that communicates the object's function. The proposed MIST timings and search clearance are local requirements rather than measurements from Lordicon.

The QA scripts modify only their own report files. They do not repair implementation files.
