silmoon04/mist-robot/brain/benchmarks/naturalness/browser_lab.html

# MIST browser benchmark

Send recorded test speech through the voice connection and capture MIST's playback, expressions, and turn timing. No microphone is opened.

Case Run selected case Run all cases Stop run

Loading face and fixtures...

Keep this tab visible during a run. Speaker timing is a software estimate from Web Audio, not an acoustic measurement. Digital echo can be injected from the rendered audio. Physical microphone processing, room acoustics, and device speaker delay remain unmeasured.
