silmoon04/mist-robot/docs/mist/order-verified-guides-v2/battery_power_explainer.html

# Why the battery path has several parts

Each item has one job; none of them magically makes the battery “safer” by itself

REQUIRED FULL ROBOTRECOMMENDEDSETUP ONLY

SOURCE  HOOVO 3S · XT60

INTERFACE  XT connectors/pigtails

DISTRIBUTE  XT60 → 8×XT30 PDB

PROTECT  Blade fuses/holders

REGULATE  5 V UBEC modules

1

## Battery XT60

The pack already ends in XT60. It is the starting connector and carries raw 3S: about 9.9–12.6 V.

→

2

## XT90-S loop/disconnect

A reachable kill/disconnect with pre-charge contact to reduce plug-in spark. Useful, but it is not a voltage converter and is not required for one-servo testing.

→

3

## 30 A main fuse

Placed close to the battery so a trunk short cannot make the heavy cable act like a heater. It protects wiring/fire risk—not the servo electronics.

→

4

## PDB

Splits one battery feed into several keyed outputs. A correctly built distribution harness could replace it; some form of distribution is required.

## What comes out of the PDB

### FL leg · XT30

15 A fuse → 16 AWG → four C018 servos. Raw 3S.

### FR leg · XT30

15 A fuse → 16 AWG → four C018 servos. Raw 3S.

### RR leg · XT30

15 A fuse → 16 AWG → four C018 servos. Raw 3S.

### RL leg · XT30

15 A fuse → 16 AWG → four C018 servos. Raw 3S.

### Logic branch

Raw 3S → measured UBEC → regulated 5 V for ESP32 and sensors.

### Signal/common ground

ESP32 → Adapter A → servo data. Servo motor current does not pass through the ESP32 or adapter.

## Why use separate leg branches?

Four C018s in one leg could theoretically draw about 10.8 A at simultaneous stall. Separate branches keep the high-current route short and let one leg fault be isolated without dismantling the whole robot.

A 4700 µF / 25 V capacitor at each leg root supplies very brief current transients and reduces local voltage dips. It goes across + and GND in parallel; reversed polarity is dangerous.

The full robot must never be designed to sit at simultaneous stall. Fuses are the last layer; motion limits, current/temperature monitoring and mechanical freedom are the first layers.

### XT60 versus XT90-S

XT60 is the battery interface. XT90-S is an added disconnect/anti-spark device. Changing connector size does not increase what the battery lead or XT60 can safely deliver.

### Smoke stopper

Temporary current limiting for first static power after wiring changes. Remove/bypass it before movement because its voltage drop can reset servos and ESP32.

### UBEC

Essential voltage separation: the C018s use raw 3S, while the ESP32 module itself operates around 3.3 V and the DevKit is normally fed from a regulated 5 V input.

Design rationale from MIST_BUILD_PHASES.md; real photos from the user's video.Battery explainer 1/3

# Do you need all of it? It depends on the test

A one-servo intake setup is intentionally much smaller than the finished 16-servo robot

POWER PATHTEMPORARYNOT NEEDED YET

## 1 · Charging a pack

This is a charger circuit, not the robot power harness.



100 W USB-C PD

→

B6 Neo

XT60 main

+

3S balance plug

ONE HOOVO PACK

- LiPo, not LiHV
- 3S balance charge
- 2.2 A maximum
- 12.6 V full
- Non-flammable surface; supervised

Not used while charging: XT90-S, robot PDB, leg fuses, servos and ESP32.

## 2 · Testing one C018

The smallest sensible commissioning circuit.



HOOVO XT60

→

5/7.5 A fuse

Smoke stopper

→

ONE C018 power

PC USB

→

FE-URT-1 data

Verified 5264

→

ONE C018 bus

- Working multimeter first
- No horn for initial register/read/small sweep
- External 3S powers the servo
- USB powers/links the FE-URT logic
- Smoke stopper for static first power

Not needed yet: ESP32, Adapter A, main PDB, four branch fuses, four capacitors, or XT90-S. Those belong to the robot harness.

## 3 · Finished robot

High current is split, protected and kept away from logic.



LiPo XT60

→

XT90-S

30 A main fuse

→

PDB

4 × 15 A branches

→

16 servos

UBEC 5 V

→

ESP32

- One accessible emergency disconnect
- Main fuse close to the pack
- One independently fused branch per leg
- Raw 3S and regulated 5 V clearly labelled
- Common ground; separate high-current path

Smoke stopper is setup-only: use it for static first power and ID scans, then bypass it before any movement or load test.

The XT90-S is recommended for the finished robot; it is not a prerequisite for the FE-URT one-servo test.Battery explainer 2/3

# What each safety layer catches—and what it cannot

Protection is layered because a connector, fuse, capacitor or software check only covers certain failures

FAULTDEFENCELIMIT

## Battery/trunk wire shorts

Defence: 30 A main fuse close to the pack.

It cannot correct reversed polarity or make undersized wire safe.

## One leg cable shorts or servo jams

Defence: that leg's 15 A fuse plus firmware current/temperature/position limits.

A fuse is not a precision servo protector; it primarily protects the branch wiring.

## New harness was wired incorrectly

Defence: continuity/polarity checks, then smoke stopper for static first power.

Do not move motors through the stopper; voltage sag creates false resets/dropouts.

## Plug-in spark charges capacitors instantly

Defence: XT90-S pre-charge/anti-spark contact and a reachable disconnect.

It does not change voltage, increase XT60 capacity or replace the main fuse.

## Servo movement pulls the rail down briefly

Defence: short/good-gauge wiring and 4700 µF capacitor at each leg root.

A capacitor cannot support sustained overload. Reversing it can cause violent failure.

## Raw 3S reaches low-voltage logic

Defence: measured UBEC output, labelled 5 V rail and separate connector routing.

Never “test by plugging in.” Meter the UBEC at 4.9–5.2 V first.

## Battery is overcharged or cells drift apart

Defence: B6 Neo in LiPo 3S balance mode with main and balance leads attached.

LiHV mode is wrong for the 11.1 V HOOVO packs.

## Robot needs to stop immediately

Defence: accessible XT90-S/loop key or battery disconnect plus software torque-off/deadman.

A software stop does not help if the controller has crashed; a buried plug is not a useful kill path.

## Why the current paths are substantial

2.7 A × 16 = 43.2 A

Feetech specifies about 2.7 A stall current per ST-3215-C018 at 12 V. Four in one leg could theoretically reach 10.8 A; all 16 could reach 43.2 A.

The project’s 15 A branch and 30 A main fuses are starting values for a robot that must avoid simultaneous stall. A repeated fuse blow means stop and diagnose binding, command limits, wiring or current—not install a larger fuse.

## Correct HOOVO charge card

Chemistry
LiPo

Cells
3S

Mode
Balance

Current
≤ 2.2 A

Full pack
12.6 V

Connected
One pack

Your charger photo showed LiHV/3S Charge selected; change both chemistry and mode.

## Stop immediately if

- Smoke stopper stays bright
- Connector or fuse holder warms
- LiPo swells, smells or has a bad cell
- Capacitor vents/bulges
- ESP32 resets when servos move
- The same branch fuse blows twice

Fuse values must match verified wire, connectors and measured operating current; do not up-fuse to hide a fault.Battery explainer 3/3
