silmoon04/mist-robot/docs/mist/order-verified-guides/reference_boards.html

# MIST item atlas — what your parts actually look like

Real crops from your 8K video and close-up photos · status is kept separate from the order ledger

SEENORDER LEDGERNOT LOCATED / VERIFYMISSINGEXTRA / WRONG TYPE

SEENVIDEO



### Feetech C018 servo boxes

Target 18: 16 installed + 2 spares. Boxes are visible; open one and confirm each servo label says 12 V / 30 kg / ST-3215-C018.

SEENVIDEO



### FE-URT-1

Exposed red PCB, white bus sockets, blue screw terminal and USB. Bench tool only; it is not the black/white box drawn before.

SEENVIDEO



### Bus Servo Adapter A

Small black PCB with barrel jack, green terminal, yellow jumper and two visible white bus ports. Signal/common reference—not the leg-current path.

SEENVIDEO



### ESP32 WROOM DevKit

Long black DevKit with metal WROOM shield and USB-C. The separate camera board is an extra device, not proof of the servo C018 option.

SEEN ×2USER PHOTO



### HOOVO LiPo packs

3S · 2200 mAh · 11.1 V nominal · 50 C · XT60. Keep both as stock, but connect or charge only one pack at a time.

SEENUSER PHOTO



### SKYRC B6 Neo

Compact red/cyan charger with colour screen and three black buttons. Your close-up confirms LiHV/3S was selected—use normal LiPo 3S balance, not LiHV.

SEEN / VERIFYVIDEO



### 5 V UBEC modules

Several small exposed modules with red/black leads are visible. Verify each output is 4.9–5.2 V before any ESP32 connection.

SEENVIDEO



### XT60 → 8×XT30 PDB

Narrow row-style power distributor—not the invented square black block. It distributes raw 3S; it does not regulate voltage.

SEENVIDEO



### XT pigtails + silicone wire

Yellow XT30/XT60 connectors and heavy red/black leads are visible. Confirm the wire labels: 12, 14 and 16 AWG.

SEENVIDEO



### Blade fuses + holders

Standard fuse assortment and loose holders/leads are visible. Physically match holder size; use 30 A main and 15 A per leg only after the guide checks.

SEEN / MATCHVIDEO



### Smoke stopper

Present, but exact product body is not clear enough for a definitive close-up match. Static first-power checks only; not for real motion/load.

WRONG FOR BUSVIDEO



### Generic PWM servo leads

Large bag of red/white/black leads with black housings. Keep separate: these do NOT count as Feetech 5264 bus cables.

CANDIDATE — VERIFYVIDEO 34 S



### Likely Feetech 5264 bus leads

The white tray holds many long black flat leads with small white keyed housings. Verify one plug fits without force and confirm pin order/continuity before power. Keep separate from the generic PWM bag.

SEENVIDEO



### Heat-shrink + connector bags

Bagged pigtails and black heat-shrink are visible. Loose parts are not a finished harness—joins still need to be fabricated and checked.

NEEDS BATTERYVIDEO



### ANENG SZ308 multimeter

Red meter is physically present. Fit its specified PP3/6F22 9 V battery and prove continuity/DC voltage before powered wiring.

PARTIALVIDEO + USER



### Fasteners and tools

M2 lengths are present but thread type/count needs checking. M3 ×6/8/10/12/16 + M3 nylocs are missing. M4 is not currently required.

Photo evidence ≠ completed electrical verification.NOT TO SCALE · no product has been redrawn

# Group 1 — charging and LiPo safety

The delivered charger and pack appearance, using your close-up photos

SEENMETER NEEDS 9 V

PACK A + B



### 2 × HOOVO 3S 2200 mAh

Inventory picture may show two; connection picture must show one.

SEEN



### SKYRC B6 Neo

Red/cyan charger; colour screen; three black buttons.

SEEN



### XT60 main + 3S balance lead

Both are required for balance charging.

OWNED

ANKER 317
100 W USB-C PD

### Charger input supply

Use the owned 100 W PD charger and 5 A e-marked cable.

SEEN



### LiPo guard bag

One pack at a time; stay present while charging.

FIX FIRST



### Working multimeter

Install PP3/6F22 9 V battery before pack/polarity checks.

## Correct first-charge settings

- Battery type: LiPo, not LiHV
- Cell count: 3S
- Mode: balance charge
- Current: 2.2 A maximum
- Full: 12.6 V

## One connected path

Anker PD→B6 Neo

ONE HOOVO→XT60 + balance

## Do not

- Do not charge on the bed or carpet.
- Do not connect both LiPos.
- Do not leave charging unattended.
- Do not continue with a swollen/damaged pack.

Actual red/cyan B6 Neo and HOOVO label shown.Group 1

# Group 2 — raw 3S main trunk

These are loose parts to fabricate and verify—not a ready-made plug chain

SEENVERIFY / FABRICATE

SEEN



### One HOOVO XT60 pack

Raw 3S: roughly 9.9–12.6 V.

ORDER LEDGER

XT90-S
ANTI-SPARK

### Main disconnect

Confirm the received cable gauge, length and connector gender.

SEEN



### 30 A main fuse + holder

Standard blade size must physically match the holder.

TEMPORARY



### Smoke stopper

Static first-power path only; bypass before motion/load.

SEEN



### XT60 → 8×XT30 PDB

Narrow row-style distributor. Meter every raw-3S output.

SEEN / CHECK GAUGE



### 12/14 AWG silicone + pigtails

Red/black heavy wire; labels and lengths still need checking.

## Conceptual power order

LiPo→XT90-S

30 A fuse→PDB

This is electrical order only. XT60, XT90-S and bare fuse-holder leads do not automatically mate. Use verified adapters or soldered, insulated joins.

## Fabricate / verify

- Connector gender and polarity
- 12/14 AWG label
- Heat-shrunk solder joins
- PDB polarity on every XT30

## Raw 3S only

- No ESP32 directly on this rail.
- No sensor/5 V device on XT30 or XT60.
- Smoke stopper does not stay in for movement.

No XT60-to-XT90 direct-mating claim is made.Group 2

# Group 3 — four leg kits

A likely 5264 bundle is in the white tray; identify one lead before sorting four per leg

SEENCANDIDATE — VERIFY

BOXES SEEN



### Per tray: 4 × C018

Coxa, femur, tibia, wheel. Confirm physical labels before raw 3S.

CANDIDATE — VERIFY



### Likely Feetech 5264 leads

Long black flat leads with small white keyed housings are visible. Verify key, fit and pin order before assigning four to each leg.

SEEN



### XT30 + 16 AWG branch

One protected raw-3S branch per leg.

SEEN



### 15 A fuse + 4700 µF cap

One holder/fuse and one 25 V capacitor per leg; capacitor is parallel, not inline.

KEEP SEPARATE



### Generic PWM leads

Wrong connector family for the STS3215 bus.

SEEN



### 2 spare servos: IDs 17–18

Test and label; no fifth leg branch is required.

## Make four labelled trays

- FL: IDs 1–4
- FR: IDs 5–8
- RR: IDs 9–12
- RL: IDs 13–16

## Each tray receives

- 4 servos + 4 positively verified 5264 leads
- 1 XT30 branch path
- 1 holder + 15 A fuse
- 16 AWG red/black route wire
- 1 × 4700 µF 25 V capacitor

## Gate

Take one black/white lead from the tray. Verify connector key, no-force fit and pin order before starting the four leg harnesses.

Candidate cables are shown from the video, but are not labelled confirmed until physically checked.Group 3

# Group 4 — 5 V logic and servo signal

Actual delivered board colours and port layouts from the video

SEENVERIFY 5 V

VERIFY OUTPUT



### FPV 5 A UBEC modules

Small exposed modules; verify 4.9–5.2 V with a working meter.

SEEN



### ESP32 WROOM USB-C

Main controller. Use one power source at a time by default.

SEEN



### Bus Servo Adapter A

Black PCB, barrel jack, green terminal, yellow jumper, two visible white bus sockets.

SEEN



### Optional ESP camera board

Separate accessory. Its board marking must not be confused with the servo option code.

ORDER LEDGER

VL53L0X
OPTIONAL SENSOR

### VL53L0X

Optional; not required for first servo commissioning.

PRESENT / TEST



### USB data + jumpers

Prove COM/data operation; charging LEDs alone are not enough.

## Correct voltage domains

RAW 3S→UBEC

VERIFIED 5 V→ESP32/sensors

ESP32 UART→Adapter A

## Common reference

Raw power, UBEC, ESP32, adapter and servo grounds share the required common reference. Signal mapping comes from the board markings/docs, not from wire colour guesses.

## Never

- Do not carry leg servo current through the ESP32.
- Do not carry leg servo current through Adapter A.
- Do not attach raw 3S to a 5 V pin.

Actual red FE-URT board is in Group 5, not here.Group 4

# Group 5 — one-servo intake bench

Use the real red FE-URT-1; powered testing waits for a positively identified lead and working meter

SEENVERIFY FIRST

SEEN



### Red FE-URT-1 board

USB powers adapter logic; external power is still required for the servo.

BOXES SEEN



### Exactly one C018 servo

No horn fitted for first read/register/small sweep.

CANDIDATE — VERIFY



### Likely 5264 servo bus cable

Select one black flat lead with white keyed ends. Do not force it; verify its pin order. Generic PWM lead is not acceptable.

PRESENT / TEST



### PC USB data cable

Correct plug for FE-URT-1; prove USB data enumeration.

SEEN



### Protected external 3S

One HOOVO pack, 5 A/7.5 A fuse if available, plus smoke stopper for static first power.

NEEDS 9 V



### Working multimeter

Required for voltage, polarity and continuity. The light-up screwdriver is not a substitute.

## Logical arrangement

Windows PC→FE-URT-1

5264 lead→ONE servo

Protected 3S→Servo V+/GND

## Current blockers

- Identify one candidate black/white lead
- Verify connector fit and pin order
- Install meter battery and prove it works
- Confirm low-current fuse and FE-URT USB data

## Do not test through ESP32 yet

The ESP32 comes later through Bus Servo Adapter A, verified 5 V logic and common ground. It never powers the C018 motor.

One servo · no horn · no breadboard required.Group 5

# Group 6 — mechanical hardware and tools

Keep present/verify, missing, and not-needed-yet in separate bins

PRESENTVERIFYMISSING

VERIFY THREAD + COUNT



### M2 assortment

Lengths 4/5/6/8/10/12/16/20 reported. Verify they are machine screws; prioritise enough ×6 and ×8.

MISSING

M3 ×6 / 8 / 10 / 12 / 16
+ M3 NYLOC NUTS

### M3 hardware

Required for final mechanics. Add M3 washers as needed.

CHECK SIZES



### Existing folding key/tool set

Check for 1.5, 2.0, 2.5 and 3.0 mm metric hex sizes before buying more.

NEEDS BATTERY



### ANENG multimeter

Buy/install one PP3/6F22 9 V battery specified by the meter.

SEEN



### Soldering/measurement tools

Iron, stand, solder, wick, cutters/stripper, caliper and scales are visible or recorded. Use a non-flammable hot-work surface.

LOCATE

20 mm HOOK-AND-LOOP
BATTERY STRAPS

### Battery/phone retention

Use proper straps; double-sided tape alone is not adequate LiPo retention.

## Buy / locate next

- PP3/6F22 9 V meter battery
- M3 machine screws + nylocs
- 20 mm hook-and-loop straps
- Any missing metric hex sizes

## Do not buy yet

- M4 hardware—no current guide requirement
- Breadboard—not required for servo intake
- More generic PWM servo leads

## Tool distinction

The illuminated/non-contact electrician screwdriver cannot measure low-voltage DC, continuity, polarity or UBEC output. It does not replace the ANENG meter.

Check existing tools before duplicating them.Group 6

# MIST master sorting map — photographic revision

Six bins/trays; tools stay off the robot; candidate or unverified items stay visibly amber

SEENGATE

## 1 · Charge + LiPo

  

2 packs in stock; 1 connected at a time. B6 Neo + main lead + balance lead + LiPo bag.

SEEN

## 2 · Raw 3S trunk

  

XT90-S + 30 A fuse + PDB + heavy wire. Fabricate verified joins; do not assume every connector mates.

VERIFY / FABRICATE

## 3 · Four leg kits

  

FL 1–4 · FR 5–8 · RR 9–12 · RL 13–16. Each tray: 4 servos, 4 positively verified 5264 leads, XT30, fuse, cap, 16 AWG.

5264 CANDIDATE — VERIFY

## 4 · 5 V logic + signal

  

UBEC → verified 5 V → ESP32. ESP32 UART → black Adapter A. Common reference; no leg current through either board.

METER 5 V FIRST

## 5 · Servo intake

  

Red FE-URT-1 + one servo + one positively verified 5264 + USB data + protected 3S. No horn. ESP32 later.

CABLE + METER GATE

## 6 · Mechanical + tools

  

M2 present/verify. M3 screws + nylocs missing. Meter needs 9 V. M4 and breadboard are not current blockers.

PARTIAL

GATE 1 · VERIFY ONE WHITE-ENDED BLACK LEAD AS 5264

GATE 2 · INSTALL PP3/6F22 9 V IN MULTIMETER

16 installed servos · 2 tested spares · charger and FE-URT stay bench-only.Master map
