silmoon04/mist-robot/design/third_fit_joints_20260913/NEXT_MEASUREMENTS.csv

part | check | nominal_or_note | measured_or_observed | pass_fail
Hardware | Actual nut thread and thickness | M3 design; operator description not yet clarified
Cleanup | Where sanding or brim cleanup was needed | Record before modifying the next part
Screw strip | 3.2 /3.4 /3.6 mm passage fit | Use actual M3 screw by hand
Nut strip | 2.6 /2.8 /3.0 mm pocket seating | Same5.7 mm AF in all three
Alignment gauge | Horn face and both feet meet without forcing | Check before tightening tie bolts
Main horn | Spline seating and retaining-screw entry | No forced seating or bottoming
Auxiliary disc | Free rotation before fixture assembly | Washer bears on fixed stub
Closed horn fixture | Binding or cheek spreading as bridge is tightened | Observe both sides
Plug | Actual lead clears auxiliary cheek in neutral fixture | Provisional cable reserve
Yaw spacers | Actual heights of the four nominal pieces | 11.6 mm nominal; do not mix trial heights
