silmoon04/mist-robot/design/mist_v2_20260906/brain_v2_20260907/CODEX_EVALUATION.md

# MIST Codex evaluation, September 7, 2026

The backend runs GPT-6 Astra with low reasoning in a persistent Codex 0.153.4 app-server process. Its `priority` service tier was accepted by the live service. The local catalog labels this tier Fast and describes it as "2x speed, increased usage". The measurements below do not demonstrate a twofold speedup.

## Results

The initial ten-turn suite passed nine strict checks. The failing check required a fresh tool call for a current-vision question. MIST correctly said it had no observation producer, but reused the previous capability result. After the persona was updated to refresh `observe` for each current-vision question, the targeted follow-up passed. A separate executive check returned a short engineering explanation with zero available or called tools.

| Initial scenario | First reaction | Full response | Output tokens | Result |
| --- | ---: | ---: | ---: | --- |
| Capability connections | 3.00 s | 7.08 s | 113 | Pass |
| Missing camera after capability check | 2.59 s | 2.62 s | 51 | Fresh-read check failed; absence stated correctly |
| Save greeting preference | 2.23 s | 4.14 s | 43 | Pass |
| Use preference in following turn | 2.47 s | 2.48 s | 20 | Pass |
| Recall saved note after thread reset | 3.52 s | 6.72 s | 42 | Pass |
| One-metre simulation command | 2.20 s | 4.98 s | 75 | Pass; reported actual 0.97 m |
| Servo at 50 C cutoff | 3.70 s | 6.17 s | 63 | Pass; checked telemetry and refused movement |
| Queue executive research | 2.67 s | 5.16 s | 95 | Pass; worker accurately reported offline |
| Arithmetic while ticket pending | 2.03 s | 5.08 s | 38 | Pass; 17 x 23 = 391, inbox still pending |
| Read completed mock executive result | 2.00 s | 5.17 s | 48 | Pass; explicitly called it a fixture |

The main process started in 0.766 seconds. Its first full response took 7.08 seconds after submitting the prompt, or about 7.84 seconds including startup. The nine subsequent turns reused the process; their full-response median was 5.08 seconds. The overall median first reaction was 2.53 seconds, median first visible text was 5.09 seconds, and median completion was 5.12 seconds. Most first reactions were tool requests, so streaming or a visible thinking state matters while the tool round trip completes.

The corrected observation check called `observe`, took 6.02 seconds and used 50 output tokens. The tool-free executive check took 3.42 seconds and used 49 output tokens. Both passed. These were separate fresh processes, not warm latency samples.

Across all 12 live turns, usage reports show 60,704 input tokens, including 44,160 cached input tokens, and 687 output tokens. The backend did not expose currency cost, so no dollar amount is inferred. There were no live executive model calls inside the initial ten-turn suite: its completion was produced by the existing offline mock worker. The twelfth turn directly evaluated the executive's tool-free Codex client.

## What the tests establish

- The model selects real registered tools through app-server callbacks and uses the returned receipts in its answer.
- The simulator's 50 C refusal and 0.97 m odometry remain authoritative.
- An explicit preference survives a new Codex thread through the run's saved notes and `recall_memory`.
- A pending background ticket does not prevent subsequent conversational turns. A mock completion remains labelled as mock.
- The main loopback protocol audit exposes exactly the 18 robot tools; executive mode exposes none. It completes a real dynamic callback without making a cloud model call.
- Nine offline contract tests cover streamed receipts, warm token accounting, reset accounting, deterministic interlocks, rejected tools and malformed arguments, timeout isolation, unacknowledged-start cleanup, retry recovery and explicit cancellation.

These are bounded functional checks, not a general intelligence benchmark, long-term memory evaluation, physical robot test or proof of robust behavior under every adversarial input. The observation correction received one targeted retest; the complete ten-turn suite was not rerun after that wording change.

## Comparison with earlier Gemini evidence

The existing five-case `brain_eval_live` Gemini sample completed in 1.39-2.45 seconds, with a 2.00-second completion median and 0.69-second first-reaction median. Astra Fast completed the ten initial cases in 2.48-7.08 seconds, with medians of 5.12 seconds and 2.53 seconds respectively. The Astra sample was slower here. The earlier Gemini run used a different persona and reset strategy, fewer scenarios and a different time window; this is not a controlled provider benchmark. No Astra standard-tier trial was run, so Fast versus standard speed is unmeasured.

## Constraints and reproducibility

The app-server protocol has no verified hard assistant-output-token cap. Responses were instructed to be short, visible output was bounded locally, each prompt had a 60-second timeout, and the suite was capped at ten initial plus two targeted turns. Every live turn stayed below 114 reported output tokens. No unrestricted shell, filesystem, network, messaging, purchasing or hardware tools were exposed to the model.

The direct-tool configuration is important. Astra's default CLI metadata enables code mode and collaboration independently of several feature toggles. The adapter writes a per-run catalog retaining `gpt-6-astra` while selecting direct tools, disabling collaboration, and clearing experimental tools. It also disables orchestrator skills and MCP and removes the host environment. The model identity is unchanged. Re-run the offline tool-exposure audit after a CLI upgrade.

Final review also found that the installed Codex configuration contained a legacy notification helper. That hook is independent of the hooks feature flag and may have run after the initial live turns. Its native executable was not run for this review, and its metadata did not establish behavior, so the evidence establishes neither external contact nor local-only behavior. The final adapter clears `notify=[]` explicitly. An offline test supplies a harmless inherited hook and verifies it is not invoked. The latency records describe the original runs; the final notification override was checked offline without spending more live turns.

Evidence files in this directory:

- `codex_priority_live/results.jsonl` and `summary.json`: preserved initial ten-turn results, including the failed fresh-read check.
- `codex_targeted_followup/results.jsonl` and `summary.json`: the corrected observation and tool-free executive turns.
- `codex_tool_exposure_audit.json`: actual outgoing tool names and requested model/reasoning/tier from the offline mock service.

Reproduce the offline audit with `python harness/audit_codex_tool_exposure.py --out results/codex-tool-exposure.json` from `brain/`. Reproduce the initial live suite with `python harness/eval_codex_smoke.py --out results/codex-live-evaluation`. The live command makes real model calls; its mock executive step does not.
