silmoon04/mist-robot/brain/art_direction/mist_game_faces_20260929/qa/independent_first20.md

# Independent QA: first 20 MIST game-inspired face studies

Reviewed all selected group1 through group4 sheets as original complete images using `view_image`, after each final group manifest existed. No assets, prompts or UI files were edited. Both local MIST references were inspected. Catalog observations, manifest approaches and original/repair prompts were compared with the visible designs. A second agent checked that textual adaptation and process claims stayed within the catalog evidence.

**Result: all 20 studies pass the face, layout, crop and expression checks.** All 20 sheets contain exactly five two-eye, one-mouth faces in cells 1 through 5, with cell 6 blank. No text, frames or props were found. No skeptical or concerned mouth reads happy.

The previous Night in the Woods original contained a detached five-pixel cyan fleck beside the left skeptical eye. Two targeted imagegen edits retained it. A fresh built-in generation is now selected, and its canonical file was inspected again at full original scale. The old isolated fleck is absent. The skeptical eyes now share integrated flat-top lids and pupil-edge tapers. A small right-eye taper separates under the cyan threshold, but visually it belongs to the same intentional notch construction as the left eye; it is not judged an accidental floating fragment. This judgement and the threshold evidence are retained in the JSON report.

Every sheet has faint almost-black backdrop variation. This is a literal departure from a uniform flat fill, already disclosed in the manifests. It creates no visible object in the blank sixth cell and is recorded as a limitation. The brightest channel in any sixth cell is 22/255.

The pixel audit only supports the visual inspection. It reads original RGB pixels with G >75, B >75 and G >R +20, checks cyan bounds in each 512-by-512 crop, and looks for isolated components below 100 pixels. It does not infer facial emotion from connected-component counts. Minimum cyan margin across these sheets is 37 pixels. All 20 sixth cells contain zero pixels above this cyan threshold. Only Night in the Woods has a threshold-separated component below 100 pixels; its position at the pupil-edge taper is interpreted visually as intentional.

These are static held expression studies. Continuous animation, transition timing, controller independence and physical-screen readability were not tested.

| Study | Result | Visible adaptation | Preference or limitation |
|---|---|---|---|
| later-alligator-sweet-geraldine | Pass | Large directional eye openings, unequal apertures and compact mouth attitudes visibly adapt the catalog into original MIST poses. | The C-eye construction overlaps with Dicey Dungeons and Pip/Dot; the exact attitudes differ, so this is a family resemblance rather than a duplicated sheet. |
| slime-rancher-face-shader | Pass | Filled eye apertures and changing mouth masks create a clear design change. The static sheet supports an authored channel-separation experiment, without proving a shader or controller implementation. | No material design preference recorded. |
| dicey-dungeons-lady-luck-warrior | Pass | Clipped lids, knowing side gaze and restrained angular mouths distinguish composed attention from alert delight. | Its side-gaze C-eye family overlaps with Later Alligator and Pip/Dot. |
| omori-held-pencil-face | Pass | Small mouths and restrained upright eye forms make the held-pose restraint visibly different from the wider C-eye sheets. | Consideration is subtle and relies mostly on the mouth; this fits the held-pose approach but is less forceful than the other attitudes. No line-boil, transition timing or physical-screen readability was tested. |
| cuphead-hopus-pocus-pencil | Pass | Changes in height, width and coordinated deformation visibly go beyond stroke weight. Each pose remains a two-eye, one-mouth MIST face. | Shares an elastic geometry family with Pizza Tower, though the unequal eye shapes and narrower amused pose are distinct. |
| smile-for-me-response-comparisons | Pass | Acknowledgement and resistance receive different eye tension and mouths. The one-open, one-closed amused pair adds conversational attitude. | The standard C-eye shapes overlap with Pip/Dot and the broader MIST family; nod or shake motion is not established by these stills. |
| isat-odile-mixed-affect | Pass | Heavy lids remain across attitudes, while uneven warmth and mouth tension carry mixed affect. Pose 4 is more specific than the ordinary closed-eye delight recipe. | No material design preference recorded. |
| chicory-feeling-first-faces | Pass | Filled eyes, gaze cutouts and coordinated geometry visibly change with the intended feeling. | The aperture-and-cutout vocabulary overlaps with Night in the Woods, but Chicory uses rounder apertures and more coordinated whole-pose changes. |
| undertale-flowey-denial | Pass | Stable eye spacing gives open-versus-narrowed eye changes weight. The mouth turns clearly between uncertainty, firmness, warmth and concern. | This is one of the more generic C-eye sheets. The catalog friendly-mouth/defensive-language contradiction is only partially visible in isolated stills; conversational subtext remains an intention rather than a demonstrated outcome. |
| great-god-grove-god-faces | Pass | Rounded diamond cutouts and an inward closed considering pose create a distinct silhouette vocabulary; the eyes carry much of the emotion. | No material design preference recorded. |
| cuphead-baroness-pencil | Pass | Unequal open-versus-hooded eyes and compact-versus-open mouths transfer theatrical contrast without source anatomy. | The distinction from Pip/Dot and the familiar Cuphead/C-eye family is modest. Skepticism is stern and concern can also read pained, but neither mouth reads happy. |
| pizza-tower-peppino-poses | Pass | Strong changes in eye width, height, spacing and mouth category make the static elasticity clear. | The unusually wide amused and skeptical poses still leave more than 50 pixels of cell margin; physical display-size readability is untested. |
| spiritfarer-trailer-stella-daffodil | Pass | The small closed mouths and quiet asymmetric squint visibly support restrained warmth. The exact upper-left attention is weaker than it would be with explicit pupils. | High resemblance to the broader C-eye family, particularly Dory, Moss and Pip/Dot. This is a quiet trailer-inspired study rather than a distinctive new eye model. |
| dory-independent-face-prototype | Pass | Discrete lid and mouth states are clear as an original process experiment; a static sheet cannot demonstrate controller independence. | High generic similarity to Moss, Wandersong and the standard C-eye recipes. |
| astro-bot-led-acting | Pass | Filled capsules, wedges and droops provide a restricted eye-led vocabulary visibly distinct from hollow C eyes. The tiny MIST mouths are intentional additions to a mouthless source. | No material design preference recorded. |
| night-in-the-woods-graphic-gaze | Pass | Large filled apertures, pupil targets, strong upper lids and tiny mouths visibly implement the graphic-gaze approach. | Both skeptical eyes use matched integrated upper-lid and pupil-edge tapers. One right taper separates under the cyan threshold; original-scale visual review treats it as an intentional contour termination. |
| antonblast-anton-reaction | Pass | Eye compression and the broad ribbon-versus-bowl mouth contrast supply a specific reaction design without teeth or anatomy. | Welcome, amusement and concern retain standard MIST recipes. The central compressed reaction is visibly distinct. |
| moss-quill-lico-process | Pass | Direct listening, directional searching and asymmetric acknowledgement support an original relationship-focused process study. | High generic similarity to Wandersong and Dory. The relationship intention is not proved by a still, and the strongest visible difference is the asymmetric acknowledgement. |
| cuphead-pip-dot-pencil | Pass | Repeated left-right eye conflict, fixed spacing and unequal attitudes visibly adapt the catalog while retaining MIST identity. | Moderate resemblance to Baroness and other asymmetry studies; the sustained paired-eye conflict is a clear distinction. |
| wandersong-singing-face | Pass | The clearest source-specific choice is pose 4: closed eyes and an open bowl agree with delight or recognition. The slit-eye skeptical pose is also distinct. | The other recipes overlap with Moss and Dory. Static event poses cannot demonstrate singing, timing or a recovery sequence. |

The JSON report binds each assessment to the selected sheet SHA256 and records all five pose observations, crop bounds, measured margins, blank-cell values and the resolved blocker history. The common C-eye recipes are design-family notes, not requests to regenerate passing sheets.
