silmoon04/mist-robot/brain/art_direction/mist_game_faces_20260929/qa/independent_last15.md

Independent visual QA of MIST studies, groups 5–7

Reviewed 2026-09-29 against BRIEF.md and assignments_5.json through assignments_7.json. Each selected canonical sheet in the frozen group manifests was inspected with view_image at original full-sheet resolution. Only these QA reports were authored; the sheets, prompts, and UI were not edited.

All 15 selected sheets pass the required checks: exactly five complete faces in cells 1–5 of the invisible 3×2 grid; no facial artwork in cell 6; cyan MIST identity; two eyes and one mouth per face; no text, props, detached facial fragments, or fused features; five readable attitudes; and unsmiling skeptical and concerned mouths. All selected sheets are 1536×1024 PNGs, and each copy matches the manifest's returned generated original byte for byte.

Equal-cell pixel measurements support the full-sheet visual check. The smallest cyan-art margin is 30 pixels, and all 15 sixth cells contain zero detected cyan pixels. These measurements check artwork presence and cell boundaries; the visual review supplies face-count and emotion judgments.

All 15 descriptions and selected prompts pass the separate source-claim review. Process-only and uninspected-source studies are described as authored MIST experiments. No reviewed caption falsely attributes the generated faces to an observed game facial style or measured source timing.

Three sheets have a moderate study-differentiation weakness: Cuphead / Jake Clark, Klei, and Ori. They share much of the generic C-eye/open-arc construction and pose vocabulary. Their source principles differ mainly through process descriptions. This does not invalidate their distinct required attitudes, and no further repair is required by the rejection criteria. Minor similarities and subjective preferences are recorded per study below.

The dark backdrops and cyan marks retain faint tonal variation. This is visible but creates no framing, feature-count, or emotion failure. These are static studies. This review does not establish physical robot-screen legibility or animated acting.

**cult-lamb-follower-reaction**

Pass. Sheet: `sheets/cult-lamb-follower-reaction.png`. SHA-256: `d73d6e34dbd5bce37495745dc5a14ebf7a4c7421ac380174013890003c55684c`. Minimum cyan-art margin: 76 px. Returned-original byte match: confirmed.

- Pose 1, attentive: Tall oval eyes and a closed shallow U mouth read as receptive welcome.
- Pose 2, considering: Unequal lid heights and a tilted short mouth read as uncertainty.
- Pose 3, skeptical: Level clipped eyes and a mouth with one downward corner read as dry skepticism.
- Pose 4, amused: The stable tall-eye design gains an open filled half-oval mouth for delighted recognition.
- Pose 5, concerned: Inward-raised lids and a compact frown give sympathetic concern.

Source adaptation: Tall cyan ovals with vertical dark slots visibly invert the inspected source's stable oval-eye identity. Mouth contrast supplies the five attitudes. The manifest qualifies studio-posted media and unverified continuous motion.

No material study-specific quality concern.

Subjective preference: The welcome smile is cheerful, but remains closed.

**webbed-social-acting**

Pass. Sheet: `sheets/webbed-social-acting.png`. SHA-256: `cae5364586e0829431c3dca50d83d9f534bb317ddb520e629f4f2316f172a768`. Minimum cyan-art margin: 44 px. Returned-original byte match: confirmed.

- Pose 1, attentive: Broad right-directed open eyes and a closed smile read as a warm greeting.
- Pose 2, considering: One compressed eye, one open eye and a slanted small mouth give a searching doubtful look.
- Pose 3, skeptical: Paired flat lids and a downward-slanted closed mouth read as restrained frustration.
- Pose 4, amused: Unequal lifted eye arcs and a filled small open mouth read as pleased recognition.
- Pose 5, concerned: Paired raised inner lids and an upside-down U mouth read as gentle concern.

Source adaptation: A disclosed face-only translation of body-led social attention. Directed gaze and eye compression carry the original MIST experiment; no Webbed face style or measured timing is claimed.

Quality observation (minor, study differentiation, poses 1, 2, 3, 5): The C/open-arc and clipped-lid family closely resembles the Cuphead and Klei process sheets. Pupillary tips and the amused opening add some distinction, but the body-led source connection remains largely conceptual. No repair required.

Subjective preference: The greeting is quite cheerful and the amused mouth is broad for a reserved success response; both remain readable in the required roles.

**pikuniku-minimal-body-language**

Pass. Sheet: `sheets/pikuniku-minimal-body-language.png`. SHA-256: `294211f52012cf2342d98475e8153a80d8fc120c4bfdd41db0fb48526b813d63`. Minimum cyan-art margin: 56 px. Returned-original byte match: confirmed.

- Pose 1, attentive: Two solid upright apertures and a compact horizontal mouth give quiet attentive presence.
- Pose 2, considering: Unequal eye height and a diagonally tilted solid eye with a slanted mouth give deliberation.
- Pose 3, skeptical: Flattened solid half-ovals and one downward mouth corner give skeptical compression.
- Pose 4, amused: Upward eye arcs and a closed U smile give modest amusement.
- Pose 5, concerned: Solid inward-raised lid silhouettes and a small frown give sadness or concern.

Source adaptation: The selected repair removes hollow eye detail, making sparse solid silhouettes the visible study principle. The source pose had no visible mouth; all MIST mouth shapes are explicitly authored.

No material study-specific quality concern.

Subjective preference: Welcome is quiet and neutral rather than strongly smiling, which suits the source's reduced facial detail.

**lil-gator-head-followthrough**

Pass. Sheet: `sheets/lil-gator-head-followthrough.png`. SHA-256: `a9eef5b104314cf957b1e1c84425bebaa092b970a66141b984c6ab3d2b97a41c`. Minimum cyan-art margin: 30 px. Returned-original byte match: confirmed.

- Pose 1, attentive: Broad horizontal eye masses with right-directed cutouts and a straight small mouth read as quiet welcome.
- Pose 2, considering: One eye sits markedly higher and opens more than the other; the mouth tilts in thought.
- Pose 3, skeptical: Very flat paired eyes and a downward-slanted mouth read as dry skepticism.
- Pose 4, amused: Centred dark apertures and a filled shallow open mouth read as amused recognition.
- Pose 5, concerned: Inward-raised eye silhouettes and a compact frown read as concern.

Source adaptation: Broad eye masses and unequal held positions visibly translate the large-head readability and heavy-head account into original static MIST faces. The caption states that these offsets cannot establish follow-through timing.

No material study-specific quality concern.

Subjective preference: The welcome is somewhat neutral. The amused mouth carries most of the warmth.

**battleblock-cutscene-puppets**

Pass. Sheet: `sheets/battleblock-cutscene-puppets.png`. SHA-256: `a388a65db00fdef77044b5ad5d0ca36a36ef8c485a0e964c0769a06d904cdd4b`. Minimum cyan-art margin: 70 px. Returned-original byte match: confirmed.

- Pose 1, attentive: Opposing open arcs and a short flat mouth give an attentive, restrained greeting.
- Pose 2, considering: One clipped eye, one open eye and a tilted mouth give comic uncertainty.
- Pose 3, skeptical: Uneven shallow lids and a closed mouth with a falling right corner give dry skepticism.
- Pose 4, amused: Lifted arcs and a simple filled open mouth give delight.
- Pose 5, concerned: One wide eye, one concerned clipped eye and an explicit frown give concerned surprise.

Source adaptation: Simple marks and clear independently shaped eye/mouth poses match rough acting before polish. The manifest labels this an original process experiment; proposed arrival/overshoot behavior is qualified in limitations and is not proven by the sheet.

Quality observation (minor, static description precision): The approach's phrase 'independent eye/mouth arrival' describes a future behavior. 'Independently shaped eye and mouth poses' would describe the static artifact more exactly. No repair required.

Subjective preference: The attentive pose looks neutral rather than overtly warm.

**botanicula-tiny-faces**

Pass. Sheet: `sheets/botanicula-tiny-faces.png`. SHA-256: `a08c3b166798949b7c5e01041a2c28a16d60065cf0275f20e55c5056f84bc700`. Minimum cyan-art margin: 84 px. Returned-original byte match: confirmed.

- Pose 1, attentive: Compact filled apertures and a shallow closed smile read as welcome.
- Pose 2, considering: Together-directed dark cutouts, unequal eye height and a slanted mouth read as deliberation.
- Pose 3, skeptical: Low clipped lid silhouettes and a mouth with one downturned corner read as skepticism.
- Pose 4, amused: Raised eye arcs and a small U mouth give amusement.
- Pose 5, concerned: Inward-raised lids, lowered cutouts and a frown give empathetic concern.

Source adaptation: Sparse marks and shared directed attention visibly link the study to inspected stills. The descriptions disclose uninspected source movement and hold lengths. 'Move as a unit' is a proposed behavior; the delivered evidence is static alignment.

Quality observation (minor, static description precision): The approach says the eye pairs 'move as a unit'. 'Share directed gaze and position' is a more precise description of the still sheet. No repair required.

**bugsnax-eggabell-rosenthal**

Pass. Sheet: `sheets/bugsnax-eggabell-rosenthal.png`. SHA-256: `af0eabd08126459e95985fe88c4c13eb014e4b3748c0d821a1be3afb5c06f15d`. Minimum cyan-art margin: 78 px. Returned-original byte match: confirmed.

- Pose 1, attentive: Tall cyan apertures with dark circular cutouts and a small flat mouth give quiet attention.
- Pose 2, considering: One tall eye and one low eye with a tilted mouth give asymmetric doubt; the repaired upper lid is attached.
- Pose 3, skeptical: Flat lid silhouettes with cutouts and a down-slanted small mouth give skepticism.
- Pose 4, amused: One lifted arc and one broader open eye accompany a gentle closed smile.
- Pose 5, concerned: Inward-raised solid lid silhouettes, lower dark cutouts and a frown give concern.

Source adaptation: The viewer failure is stated directly. The aperture construction and held pose set are called our original experiment, using the artist's selectable set only as a workflow cue. No Eggabell-specific facial adoption is claimed.

No material study-specific quality concern.

Subjective preference: Welcome is neutral but receptive.

**cuphead-jake-clark-process**

Pass. Sheet: `sheets/cuphead-jake-clark-process.png`. SHA-256: `9d8519ef52adeb8acbb5d7678741e1a442fe42b48532ec25222b2062498c0bc4`. Minimum cyan-art margin: 74 px. Returned-original byte match: confirmed.

- Pose 1, attentive: Opposing C-shaped eyes and a short tilted closed mouth give an attentive look.
- Pose 2, considering: One open eye and one compressed eye with a short diagonal mouth give doubt.
- Pose 3, skeptical: Unequal lowered lids and a level closed mouth give dry skepticism.
- Pose 4, amused: Unequal lifted arcs and a closed rounded smile give amusement.
- Pose 5, concerned: Two drooping open U eye arcs and a compact frown give concern.

Source adaptation: A truthful original pose-first experiment based on a verified but unviewed process talk. Distinct eye/lid and mouth drawings are visible; no Clark-specific facial style is asserted.

Quality observation (moderate, study differentiation, poses 1, 2, 4): Welcome, considering and amused use nearly the same open-arc construction, proportions and mouth vocabulary as Klei. The claimed broad-arc/squash study contributes limited distinction beyond the common MIST template. Skeptical and concerned silhouettes do differ, so this is a quality weakness rather than a failed pose/count check. No repair required.

Subjective preference: Welcome reads as quiet attention rather than an obvious smile.

**farewell-north-kyle-banks-face-process**

Pass. Sheet: `sheets/farewell-north-kyle-banks-face-process.png`. SHA-256: `0c472a2a63db677e970fc231d181b6e70834abfa8bb61f35ae62823ff85c99ee`. Minimum cyan-art margin: 73 px. Returned-original byte match: confirmed.

- Pose 1, attentive: Round aperture outlines, centred restrained pupils and a small flat mouth give steady attentive presence.
- Pose 2, considering: Upper-right pupils with a tilted mouth give a directed considering look.
- Pose 3, skeptical: Low clipped lids and a mouth with one falling corner give skepticism.
- Pose 4, amused: The repaired clean round eyes have upper-right pupils and a small U smile for recognition.
- Pose 5, concerned: Raised inner lids, lowered pupils and a frown give concern.

Source adaptation: Purposeful pupils make gaze a visibly separate channel alongside lid openness and mouth silhouette. This connects to the developer's reported channels while remaining explicitly an authored static experiment; no inspected source performance is claimed.

No material study-specific quality concern.

Subjective preference: The centred attentive pupils give a more direct, steady welcome than the gaze-led variants.

**klei-symbol-animation-process**

Pass. Sheet: `sheets/klei-symbol-animation-process.png`. SHA-256: `11179284b64ede834028e0a5ee1a0622d9461878513e88155361ba2092333d73`. Minimum cyan-art margin: 82 px. Returned-original byte match: confirmed.
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
