silmoon04/mist-robot/locomotion/handoff/history/MSI_20261013.md

# MSI continuation — 13 October 2026

The user requested faster walking and then clarified that the motors appeared slow too. Hardware is still being assembled. The remote work continues on this device with a separate Faster crawl preview; the frozen simulator, old launchers, checkpoints and prior evidence remain intact.

The selected profile requests 0.025 m/s, with a 1.2 s cycle, 1.875 mm planned body shift, gain 1.15 and recovery phases .82–.96. Target slew remains 1.8 rad/s after a 3 rad/s trial failed to improve progress. Paired flat-floor development cases measured about 1.9 times the slower reference's actual forward progress and higher actual simulated joint velocity. Original strict tracking checks still fail; this is an unqualified simulation preview.

The interactive worker preserves physics dt while fixing wall pacing. The original remote measured 0.473 times real time and clipped commands to 0.012 m/s. The final live remote accepted 0.025 m/s, measured 1.032 times real time in the same short probe, and displayed approximately 1.00 cumulatively beyond 100 simulated seconds. The first 42-object visual grid caused a rendering stall; the retained grid is one collision-free visual mesh.

The MIST Remote desktop shortcut now starts `Start MIST Remote (Fast).cmd`. Actual Windows startup, owned stop/restart and repeated-session reuse passed. The simulation remains on 8131 and dry-run joint preview on 8130. The prior live flat/zero-payload/MPU6050/seed-42 settings were retained across migration. Motion is stopped. Held forward/turn and stop shortcuts were checked in the browser; desktop and phone layouts were verified.

Six backend, nineteen UI and eight fast-gait static tests passed; the final mesh revision passed the backend suite again. The frozen 55-file source inventory and 139 prior protected files remain exact across Windows and WSL. New walking receipts stay in `runs/msi_20261012/dev_fast_*` because versioned helpers bind those paths. Live remote receipts are under `runs/msi_20261013/remote_speed`.

See [the live review](../../reviews/msi_remote_speed/REVIEW.md), [independent boundary review](../../reviews/msi_remote_speed_review.md), [preservation audit](../../reviews/msi_remote_speed_preservation.json), [operating guide](../../REMOTE_GUIDE.md) and [current continuation](../MSI_CONTINUATION.md). The next physical step remains loaded actuator, mass, calibration and sensor measurements after assembly. No training or physical actuation was performed for the speed request.
