silmoon04/mist-robot/locomotion/handoff/history/MSI_20261012.md

# MSI continuation session, 12 October 2026

User request:

> continue https://github.com/silmoon04/mist-robot/blob/main/locomotion/handoff/history/CHAT_HISTORY.md in this device

The continuation used the actual MSI laptop and installed Ubuntu WSL2. The current state, measured outcomes and next action are recorded in [MSI_CONTINUATION.md](../MSI_CONTINUATION.md) and [MSI_STATE.json](../MSI_STATE.json). The original conversation remains in [CHAT_HISTORY.md](CHAT_HISTORY.md).

Ten Sol implementation/review work streams were followed by the requested Astra critic/reviser pass. Subsequent bounded gait experiments used the same reviewers and preserved the frozen source/CAD identity. The reviews distinguish static checks, executed runtime checks, short screens and full-duration acceptance.

Completed run evidence is under `locomotion/runs/msi_20261012/`. The CUDA environment receipt is under `locomotion/reports/msi_cuda_20261012/`. Runtime environments, downloaded caches and credentials are local dependencies and are excluded from the portable archive. This file is a session summary, not a complete transcript of every tool call.

The user then reported, "im building it rn", in response to the hardware-availability question. Hardware assembly is under construction; loaded servo and telemetry measurements have not started. They also requested usable, polished remotes and UI using the web-design skill. That work uses the existing simulation and dry-run commissioning interfaces; the launcher does not select a serial port.

The UI milestone delivered a Windows desktop shortcut, session launcher, polished simulation/joint pages, desktop and narrow browser checks, thirteen command-ordering regressions and five session regressions. The mobile confirmation places Stop directly below the live view in the first viewport. The pages remain available at ports 8131 and 8130. Review and screenshot evidence is in `locomotion/reviews/msi_remote_ui/`.

A bounded planned support-transfer reference also completed its static audit and matched 480-step backward/.155 kg pilot. It removed nominal negative-load samples but worsened velocity tracking, front contact and saturation. The candidate was not promoted or expanded. Its seven tests, original initialization failure and repaired paired receipts are preserved. Continue with the saved-trace torque/headroom and COM diagnosis described in the current continuation document.
