silmoon04/mist-robot/locomotion/handoff/history/CHAT_HISTORY.md

# Conversation snapshot

Saved on 12 October 2026 for the MSI handoff. Available public messages, commands and activity for this task through the handoff snapshot; private reasoning, system/developer instructions and unrelated conversations are excluded.

## User

Can you go into my GitHub repository for silmoon04 called mist-robot and basically download all of the files necessary, required for the robot. And this can be CAD assembly, if there is any URDF files or anything like that. If not, then you should make them. Basically, the weight can be changed slightly depending on what is actually going to be in real life, but I am working on the final version of the robot right now, and I need to simulate it completely. First of all, I need to simulate one entire leg, and then I need to simulate all of them together completely. What I want you to do is to research all of them, a lot of training environments that can actually run on my laptop, maybe even headless, with a few checks and that things are working properly. And after being able to simulate in 3D with the assembly information and robot that you have, I want you to basically make an algorithm that makes it able to, using the fully emulating our motors, sensors, and other things, walk forward, like walking in four directions. It doesn't have vision yet, but it should be able to walk forward, like in four directions, without falling over in different surfaces. So it should be able to train for that, basically. So make sure it works, make sure it works with slightly different weights. So do a bit of domain randomization, and with a phone on or not. So just make sure the algorithm is good, correct, and I could basically control it. So I have a full remote with, like inverse kinematics, and have, like a fully functional remote controller that I can work with, with an ESP32, with basically all of the components connected in the best way possible, with the different kind of weights shifted. And, like just try to, like train on my GPU if possible. If not, just queue it so I can do on a better GPU, but prepare all of the data, all of the environments, and test them with different algorithms and stuff like that to then transfer onto the real world and see if that works properly or not.

## Assistant

I’ll inspect `silmoon04/mist-robot`, check your laptop’s compute, and build toward a runnable leg simulation and full-robot training setup. I’ll use the repository’s geometry and hardware details where available, and flag any assumptions that affect transfer to the real robot.

## Assistant

The repository is public. Your laptop has an i5-9300H, 24 GB RAM, and a GTX 1650, though CUDA isn’t currently available through the installed tools. The Git download hit a TLS error; I’m using the recovery workflow to retrieve the files another way. I’m also applying the writing skill to keep the setup notes clear.

## Assistant

The repository already contains CAD and URDF files. The key issue is revision mismatch: the old bench controller uses a four-bar leg, while the current R7 leg uses direct-drive yaw, hip and knee joints with 82/90/105 mm links. I’ll build from R7 and download the release archive that holds the CAD meshes.

For training, I’ll use CPU physics on this laptop and prepare a portable job for a stronger machine. Your current NVIDIA driver is Nouveau, so it cannot provide CUDA training.

## Assistant

Are you building the current R7 direct-drive legs (82/90/105 mm), with 12 V STS3215 C018 servos? I’m using that documented design unless you give a newer revision.
- Yes, current R7 and C018
- R7 geometry, different servo variant
- Newer geometry or hardware

What motion sensors will the final robot have? An IMU model and any foot-contact sensors will determine which feedback the controller can use.
- No motion sensors chosen yet
- IMU only
- IMU plus foot-contact sensors

## Assistant

The hardware details support a more careful motor model: C018 servos are rated at about 0.98 N·m, while 2.94 N·m is stall torque. I’m adding torque and speed limits, command delay, encoder quantization and backlash estimates.

The controller will receive joint feedback and an IMU-like signal. True simulated velocity and contact forces will be used for scoring, since the robot cannot currently measure those directly.

## Assistant

All release files are downloaded, and their published SHA-256 checksums pass. The CAD archive is restored locally.

The free-base four-leg model loads and remains upright in its first standing check. Motor saturation is substantial at the conservative torque limit, so I’m checking loaded-leg behavior and directional motion before choosing training settings.

## User

<send_user_message_question_reply>
[{"questionItemId":"[\"request_user_input_async\",\"call_CYIgMqAIrFpFlRHnd84Uq4ef\",0]","question":"Are you building the current R7 direct-drive legs (82/90/105 mm), with 12 V STS3215 C018 servos? I’m using that documented design unless you give a newer revision.","answer":"Yes, current R7 and C018"},{"questionItemId":"[\"request_user_input_async\",\"call_CYIgMqAIrFpFlRHnd84Uq4ef\",1]","question":"What motion sensors will the final robot have? An IMU model and any foot-contact sensors will determine which feedback the controller can use.","answer":"none chosen yet, but i was thinking of connecting my xiaomi mi9se and use all of that phones servo. i also have an mpu6050 that i might choose so accomodate all options"}]
</send_user_message_question_reply>

## Assistant

Thanks—that confirms the R7/C018 model. I’ll accommodate both the Mi 9 SE sensors and your MPU6050.

A fixed MPU6050 gives the controller a direct body-motion signal. A phone on a rotating mount needs mounting-frame calibration and pan-motion compensation. I’ll keep both sensor paths explicit in the simulation and controller setup.

## Assistant

Four parallel environments performed best in the laptop benchmark, at roughly 850 simulation transitions per second. PPO and SAC training checks are running now, with larger repeatable jobs prepared for later runs.

The first walking tests had failures in several directions. I’m investigating the gait and position-servo response; those results do not yet support calling it a reliable walking controller.

## Assistant

I found and corrected a simulator frame bug: Bullet reported the body’s principal-inertia axes, and I had treated them as the IMU’s body axes. That made a level robot appear tilted by about 38 degrees and caused incorrect leg corrections. I’ve added a regression test and am rerunning the walking and training checks with the corrected frame.

## Assistant

The timestep check found a second issue: the explicit servo controller oscillated at 240 Hz. At 1,000 and 2,000 Hz, the leg-tracking results agree closely and the artificial saturation disappears. I’m moving physics to 1,000 Hz with a 50 Hz controller, then rerunning the walking tests and training on that configuration.

## User

do everything parallely with subagents so its fast to make, but also for everything critique with another one so u make sure things are okay and code quality is good to expand for different designs and better hardware (plan to move onto a device with 64ddr5 ram, intel 9 ultra, 4080gpu mobile) so training can be better, but also simulate and research quite a bit of things and input and things that can change. for every 10 6.1 sol agent that implement and critiques use one astra critiquer and one astra reviser so things come great quality workflow. manage workflow task e2e, and think about end goal and readjust/course correct based on new prototype data, research, issues etc, test well

## Assistant

I’ll add paired implementation and review passes using GPT-6.1 Sol, followed by an Astra critique and revision pass after each ten-agent batch. The independent reviews have already caught consequential frame and timestep bugs.

I’ll also account for the planned Ultra 9 / 64 GB / RTX 4080 laptop, including its actual GPU memory, and make the configuration and validation easier to adapt as prototype measurements arrive.

## Assistant

The corrected model now walks in all four directions in the nominal tests. It covers about 9–10 cm in 12 seconds using scheduled support loads and gravity compensation, without reading simulated contact forces.

That result is for the nominal model. The next reviews and tests will check changed weights, phone placement, surfaces and sensor assumptions. Firmware also compiles for both the plain ESP32 and MPU6050 configurations.

## Assistant

The Sol reviews found two improvements to make before training: stronger checks against geometry/configuration mismatch, and delayed sensor data shared by the policy and gait controller. The sensor simulation now supports the MPU6050, phone-only sensing and explicit open-loop operation.

The upgrade research confirms that an RTX 4080 Laptop GPU normally has 12 GB VRAM. It should enable CUDA experiments, but it is below the current published 16 GB requirement for standard Isaac Lab. I’m keeping the CPU pipeline portable and documenting the GPU alternatives and checks.

## Assistant

The ten-agent Sol batch is complete, and Astra is applying the consolidated fixes before the final training runs. The fixes cover checkpoint provenance, sensor gaps, cumulative speed limits, Arm/Disarm ordering and acceptance tests that reject short or drifting runs.

I’m also checking the fixed leg in MuJoCo as an independent comparison with Bullet, and exporting an MJCF model for future accelerator work.

## Assistant

The revised code passes 100 tests plus 12 subtests, and Astra’s independent re-audit cleared it for fresh training. PPO and SAC are now running in parallel with matched 51,200-transition budgets.

The loaded-leg comparison also agrees closely between Bullet and MuJoCo: the largest joint-trajectory difference is about 0.0007 radians RMS. The next tests will measure walking performance across surfaces, payloads and weight shifts.

## Assistant

The broader tests are exposing drift and tracking failures that the nominal walking check missed. Those failures will stay in the report.

I also found a receipt-writing bug: some NumPy Boolean values could not be saved as JSON. I’m correcting the writer and replaying that test run; the controller and training model remain unchanged.

## Assistant

The matched PPO and SAC runs are still training on the laptop’s CPU. The broader tests are finding cases where the robot stays upright but drifts or tracks commands poorly, so I’m keeping those failures visible. The independent MuJoCo leg check agrees closely with the PyBullet model; whole-robot contact behavior still needs the broader tests.

## Assistant

Both algorithms have reached 51,200 training transitions and are now running validation. The main weakness appears to be command tracking rather than falling. I’m testing whether the crawl’s scheduled body shift causes the velocity oscillation, without changing the controller or weights being evaluated.

## Assistant

The full matrix has passed its halfway point, covering slopes, slippery ground, phone sensing and open-loop operation. The initial comparisons stay upright, but their typical velocity error is about 0.05 m/s against the 0.015 m/s limit. I’m preserving the completed training work while checking whether the body-shift change improves that error.

## Assistant

Halving the body shift reduced median velocity error by about 51%, with little change in progress or tilt, but all eight cases still failed the tracking checks. Removing the shift caused other problems. I’m keeping the current controller and recording the smaller shift as a candidate for the next experiment.

## Assistant

The baseline finished all 239 cases: 20 passed, all stops. No case fell over, but every moving case failed at least one tracking check. The learned policies have finished their first validation pass and are completing the final pass. I’ll report upright stability and accurate command tracking separately.

## User

okay now pause any work, update everything into github, make direction file, save your crurrent chat and any hisory, work, directions, startegies, to continue in my actual msi laptop with 4080gpu, so save so things can continue there

## Assistant

I’ll stop the training and experiments, save their current checkpoints and results, and push the simulation package plus a `DIRECTIONS.md` handoff to GitHub. I’ll also save the available chat history and mark what remains unfinished for your MSI laptop.

## Assistant

Training and experiment processes are stopped. Both algorithms have 51,200-step checkpoints saved, along with SAC replay buffers, completed validation receipts and the 239-case baseline report. The interrupted final validation is marked unfinished, and the source remains frozen so the saved checkpoints can be verified on the MSI laptop.
