silmoon04/mist-robot/brain/art_direction/mist_geraldine_animation_pack_20261002/prompts/eyes-amused-v2-repair.txt

Use case: precise-object-edit
Asset type: transparent native PNG 4 by 3 EYE-PAIR animation atlas.
Input image 1 is the atlas EDIT TARGET. Input image 2 is the original Geraldine PRIMARY SHAPE REFERENCE; use ONLY the bottom-left amused eyes, ignore its mouth.
Repair the target while preserving the twelve-pair 4-column by 3-row layout and asymmetrical right-opening C identity. Output 1536x1024, genuine transparent RGBA. ONLY turquoise eye glyphs. There is no lighting or glow: remove the translucent halo from every glyph, with plain opaque flat turquoise interior and only a narrow antialiased outer edge. Make all background and C aperture space alpha zero. No dark background, no checkerboard, no noise, no gradients.
Focused blink repair: frame2 (row1 column3) should be clearly half closed; frame3 (row1 column4) should be NEARLY closed with tiny organic eye apertures, not yet two closed smiling arcs; frame4 (row2 column1) is the only fully closed frame, drawn soft curved unequal lid arcs; frame5 (row2 column2) must visibly start reopening with a low but definite aperture, not duplicate the closed arcs. Frame6 (row2 column3) is three-quarter open. Draw coherent soft upper and lower eyelid contours in these intermediate frames. Never merely scale a ring vertically or rotate it.
Preserve larger viewer-left eye slightly higher, smaller viewer-right eye lower, BOTH C apertures opening to the RIGHT. The left and right are unequal individual hand-drawn soft filled strokes, with original slight unequal mass. Do not regularize into matching hoops.
Preserve rest frames0,7,11; anticipation frame1; subtle left and right aperture-change gaze frames8,9; settle frame10.
For EVERY cell use fixed centers viewer-left x120 y158, viewer-right x265 y181 relative to its invisible 384x341 cell. Target rest heights about95 and78. Maintain roomy empty transparent margins and every shape fully inside its cell.
Absolutely no mouth, face, head, brow, pupil, text, labels, visible grid, borders, detached dot fragments, sparkles, shadows, glow or tinted backdrop. Exactly24 connected turquoise eye glyphs on transparency.
