silmoon04/mist-robot/brain/art_direction/mist_geraldine_animation_pack_20261002/prompts/eyes-considering-repair.txt

Use case: background-extraction
Asset type: MIST Geraldine considering eye pair sprite atlas repair
Input images: Image 1 is the 12-frame target atlas to correct. Image 2 is the original style reference, whose TOP MIDDLE eyes define the considering identity.
Primary correction: The target has distracting turquoise glow/haze and stray faint alpha outside the eyes. REMOVE ALL background and ALL glow/haze entirely. Output a genuine transparent-alpha PNG: every pixel outside the 24 clean eye silhouettes must have alpha zero. Do not draw any backdrop or checker pattern. Inside eye apertures must also be fully transparent. The eyes must be flat SOLID bright turquoise, with a single clean rounded silhouette and only edge antialiasing, no luminous aura, no soft shadow, no gradient, no shading, no texture. Output landscape 1536 x 1024 preferred.
Maintain exact 4 equal columns by 3 equal rows, 12 pairs of two eyes, same stable registration. Keep viewer-left eye larger/higher and viewer-right eye smaller/lower. All open C eyes open LEFT as in the top-middle original reference; no flip or rotation. Eye layer only: no mouth, pupils, brows, body, labels, text, watermark or grid.
Preserve the row-major motion sequence: frame 0 rest; 1 slightly lowered lids; 2 genuine halfway blink; 3 nearly closed narrow apertures; 4 fully closed two distinct rounded organic lid arcs; 5 opening low; 6 opening three quarters; 7 rest; 8 subtle look left by aperture reshaping only; 9 subtle look right by aperture reshaping only; 10 settle; 11 rest. For the clear blink-stage problem in frames 2 and 3, visibly close the lid apertures: frame 2 HALF-closed, frame 3 NEAR-closed. Keep the thicker organic eye mass and stable anchors; no mechanical vertical compression. Keep the unequal left and right eye dimensions at their original anchors.
Critical: This is a transparent sprite layer. The final outside-eye canvas must contain absolutely no painted pixels, no color, no atmospheric wash, no background, no glow.
