silmoon04/mist-robot/brain/art_direction/artist_studio_20260916/reuse/thinking_v8/prompts/checking_motion_fix2.txt

Fix ONLY FIVE scan brackets in this sprite sheet. Keep every other pixel and all document drawings as they are. Six columns, four rows. Cyan outlines on true alpha transparency.

1. In the TOP ROW, SIXTH cell (far right): move its separate ] scan bracket UP. Put its center just BELOW the top checkbox but ABOVE the halfway point between top and middle checkboxes. This is the small downward step between the fifth top-row cell and the first cell of row two.
2. In the THIRD ROW, SIXTH cell (far right): move its separate ] scan bracket DOWN slightly from its current position. Center the bracket just ABOVE the center of the TOP checkbox, with the bracket's lower tip level with the bottom of that top checkbox.
3. In the BOTTOM ROW, FIRST cell (far left): move its separate ] scan bracket UP so its BOTTOM tip is level with the TOP edge of the top checkbox.
4. In the BOTTOM ROW, SECOND cell: move its separate ] scan bracket UP farther so its BOTTOM tip is halfway between the document top edge and the top checkbox. This bracket must be visibly HIGHER than the bottom-row first cell. Never copy their bracket positions.
5. In the TOP ROW, FIFTH cell: put its bracket center level with the TOP EDGE of the TOP checkbox, visibly lower than the bottom-row second-cell bracket. The loop now turns smoothly back down.

Do not move, redraw, scale, reflow, or remove any page or checkbox. Do not change any of the other nineteen scan brackets. Preserve a clearly visible 10px gap between every bracket and page. Keep all 24 drawings with all empty boxes and no text or success marks. The three brackets at row3 col6, row4 col1, row4 col2 MUST be at three progressively higher heights. This is the essential correction.
