silmoon04/mist-robot/brain/art_direction/artist_studio_20260916/reuse/thinking_v8/prompts/checking_motion_fix3.txt

This is a 24-frame transparent animation sheet, six columns by four rows. Correct only these scan brackets; preserve all paper drawings, boxes, lines, colors, alpha and layout.

THIRD ROW, SIXTH CELL: place the center of its separate ] bracket horizontally LEVEL WITH THE UPPER EDGE OF THE TOP CHECKBOX. Keep a wide transparent gap from the page.

BOTTOM ROW, FIRST CELL: place its bracket center halfway between the PAGE TOP and TOP CHECKBOX upper edge. It must be visibly higher than the bracket in the preceding cell, third-row sixth.

BOTTOM ROW, SECOND CELL: place its bracket center LEVEL WITH THE PAGE TOP. It must be visibly higher than the bottom-row first cell.

BOTTOM ROW, THIRD CELL, the first EXIT frame: keep the full-size paper and move its bracket next to the page top, same center height as the bracket in bottom-row second cell. Shorten this bracket to THREE QUARTERS of its previous height. This must be a visibly gradual retraction with NO position jump.
BOTTOM ROW, FOURTH CELL: the page already shrinks; put the scan bracket level with this smaller PAGE TOP and HALF its previous full-size height.
BOTTOM ROW, FIFTH CELL: bracket level with this smaller PAGE TOP, ONE QUARTER full-size height.
BOTTOM ROW, SIXTH CELL: keep a tiny but clearly visible bracket beside this smallest PAGE TOP.

Preserve everything else exactly, especially all sixteen different scan positions and the clear gap outside the page. No bracket should touch the paper. All boxes empty, no success marks. True transparent background. No added text or borders.
