silmoon04/mist-robot/brain/art_direction/mist_geraldine_animation_pack_20261002/prompts/eyes-laughing-repair.txt

Use case: precise-object-edit
Asset type: transparent eyes-only animation atlas repair
Edit target: Image 1, the generated twelve-pair laughing atlas. Images 2 and 3 are the original Geraldine construction/palette and dry amused-expression references. Repair only the atlas technical cleanliness and registration; retain the same twelve frame silhouettes and the correct LEFT closed soft happy arch + RIGHT open C laughing identity. Never open the left arch.
Critical repair: Delete every glow, haze, dark backing, coloured background, low-opacity speck and stray alpha fragment around the eyes. This is clean flat cyan sprite ink on truly transparent alpha, with anti-aliasing only in a one-pixel edge. The thick flat cyan eye marks themselves should be opaque. Absolutely no luminous aura. Empty space between eye marks is fully transparent.
Critical registration: Output a native 1536x1024 PNG. Correct to an exact 4x3 invisible equal-cell grid. The generated target is incorrectly spread toward the canvas edges and the rows drift. Reposition/redraw its eye silhouettes so all pairs have identical fixed centres. Cell column origins x=0,384,768,1152; cell row origins y=0,341.333,682.667. Within EVERY cell, LEFT eye centre (120,170), RIGHT eye centre (265,170). Therefore LEFT global centres x=120,504,888,1272; RIGHT global centres x=265,649,1033,1417; row global centres y=170,511.333,852.667. Left closed arch width90 height35, thick round-ended stroke about18. Resting right C width80 height80, rim about18. All eye marks stay within local x75..305 and local y130..210; no cross-cell fragments. Keep these sizes in ALL cells. Don't change the eye shape identity to achieve alignment; redraw cleanly at those stable registrations.
Exactly twelve pairs, four columns, three rows, reading order:
0 left closed happy arch + right fully open C opening RIGHT.
1 left closed soft arch + right upper lid slightly lowered.
2 left closed arch + right naturally half-closed lid with smaller transparent aperture.
3 left closed arch + right nearly closed happy curved lid with tiny aperture.
4 two softly arched CLOSED happy lids; no aperture.
5 left closed arch + right opening-low, small aperture.
6 left closed arch + right three-quarters reopened C opening RIGHT.
7 same rest pair as frame0.
8 left slightly tighter closed happy arch + right narrower laugh squeeze aperture.
9 left closed arch + right fully open C opening RIGHT.
10 left closed arch + right nearly fully open C opening RIGHT.
11 same rest pair as frame0.
Invariants: smooth soft cartoon geometric cyan shapes, round ends, flat source-matching turquoise/cyan ink. Original bottom-left dry eye pair is primary expression reference. The left arch is ALREADY CLOSED throughout and must NEVER become an open C. Do not rotate eyes; do not squash a C into a blink; natural separate lid silhouettes. Keep twelve pairs and only eyes. No pupils, mouth, eyebrows, face, head, text, numbers, labels, grid, guides, borders, checkerboard, signature or watermark. Preserve genuine transparency and clean sprites.
