silmoon04/mist-robot/design/mist_v2_20260906/coupons/bed1/build_log.txt

Building 01_bearing_boss_carrier
Building 02_hardware_interface_board
Building 03_servo_width_gauge
Building 04_split_clamp_lower
Building 05_split_clamp_upper
Building 06_624_retainer_boss
Building 07_624_retainer_cap
{
  "status": "geometry_checks_passed_physical_fit_pending",
  "part_count": 7,
  "bounds_mm": [
    [
      0.0,
      0.0,
      0.0
    ],
    [
      206.0,
      202.5,
      10.0
    ]
  ],
  "extent_mm": [
    206.0,
    202.5,
    10.0
  ],
  "model_volume_cm3": 75.346,
  "solid_PLA_estimate_g": 93.43,
  "tessellation_mm": 0.03,
  "inter_part_intersections_mm3": 0,
  "checks": [
    {
      "part": "01_bearing_boss_carrier",
      "brep_valid": true,
      "solid_count": 1,
      "watertight": true,
      "winding_consistent": true,
      "volume_mm3": 42957.454,
      "mesh_volume_mm3": 42947.717,
      "bounds_mm": [
        [
          0.0,
          0.0,
          0.0
        ],
        [
          133.0,
          171.0,
          8.4
        ]
      ],
      "triangles": 106682
    },
    {
      "part": "02_hardware_interface_board",
      "brep_valid": true,
      "solid_count": 1,
      "watertight": true,
      "winding_consistent": true,
      "volume_mm3": 19797.04,
      "mesh_volume_mm3": 19796.614,
      "bounds_mm": [
        [
          141.0,
          0.0,
          0.0
        ],
        [
          205.0,
          114.0,
          10.0
        ]
      ],
      "triangles": 39898
    },
    {
      "part": "03_servo_width_gauge",
      "brep_valid": true,
      "solid_count": 1,
      "watertight": true,
      "winding_consistent": true,
      "volume_mm3": 4382.907,
      "mesh_volume_mm3": 4382.907,
      "bounds_mm": [
        [
          141.0,
          120.0,
          0.0
        ],
        [
          205.0,
          144.0,
          8.0
        ]
      ],
      "triangles": 132
    },
    {
      "part": "04_split_clamp_lower",
      "brep_valid": true,
      "solid_count": 1,
      "watertight": true,
      "winding_consistent": true,
      "volume_mm3": 1985.148,
      "mesh_volume_mm3": 1985.204,
      "bounds_mm": [
        [
          141.0,
          149.0,
          0.0
        ],
        [
          173.0,
          159.0,
          8.0
        ]
      ],
      "triangles": 400
    },
    {
      "part": "05_split_clamp_upper",
      "brep_valid": true,
      "solid_count": 1,
      "watertight": true,
      "winding_consistent": true,
      "volume_mm3": 3439.666,
      "mesh_volume_mm3": 3439.722,
      "bounds_mm": [
        [
          141.0,
          148.0,
          0.0
        ],
        [
          205.0,
          174.0,
          8.0
        ]
      ],
      "triangles": 836
    },
    {
      "part": "06_624_retainer_boss",
      "brep_valid": true,
      "solid_count": 1,
      "watertight": true,
      "winding_consistent": true,
      "volume_mm3": 1926.356,
      "mesh_volume_mm3": 1926.239,
      "bounds_mm": [
        [
          138.0,
          181.5,
          0.0
        ],
        [
          169.0,
          202.5,
          6.4
        ]
      ],
      "triangles": 3466
    },
    {
      "part": "07_624_retainer_cap",
      "brep_valid": true,
      "solid_count": 1,
      "watertight": true,
      "winding_consistent": true,
      "volume_mm3": 857.852,
      "mesh_volume_mm3": 857.763,
      "bounds_mm": [
        [
          175.0,
          181.5,
          0.0
        ],
        [
          206.0,
          202.5,
          2.4
        ]
      ],
      "triangles": 2424
    }
  ],
  "unvalidated": [
    "printer profile",
    "printed fit",
    "clamp performance",
    "heat insert dimensions",
    "structural loads"
  ]
}
