silmoon04/mist-robot/brain/art_direction/mist_geraldine_animation_pack_20261002/character-preview/history/20261004-resume/CHECKPOINT.md

# Character preview checkpoint

Milestone: a local three-scene conversation preview and versioned Geraldine runtime adapter.

Scope is restricted to this subtree. Existing artwork, WAVs, published pack, shared runtime, and live defaults are read-only. No paid calls, publication, synthesis, microphone, hardware, or live-service restart.

The execution brief is `<LOCAL_HOME>/Downloads/03_Programming_Projects/admin/coordinator/runs/astra-20261002/plan-robot-faces.md`. Stop new scope when acceptance passes; stop execution by 2026-10-04T12:45:00Z.

## Ownership

- Adapter worker: `adapter/`, `contract/`.
- Character direction worker: `direction/`.
- Speech review worker: `speech-review/`.
- Preview worker: `preview/`.
- Independent acceptance worker: `qa/`.
- Parent: launch command, source-provenance receipt, README, release manifest, integration handoff, this checkpoint, and final coordinator result.

## State

2026-10-02: brief and current source interfaces read; no applicable AGENTS.md found in project inventory or ancestry. Workers are being assigned. Current sources will be hashed before integration. Existing site has six eye families, three mouth families, thirteen presets, and three synthetic audio fixtures. The live playback seam supplies `startSpeech({events,duration,clock,sample})` and `stopSpeech()`.

Next: freeze the adapter/scene interfaces, build disjoint modules, integrate, run focused acceptance, inspect desktop and 851 by 393, then package a local handoff. Existing public delivery stays intact.
