silmoon04/mist-robot/brain/art_direction/artist_studio_20260916/reuse/mist_motion_v3/prompts/eyes/stroke_repair.txt

Precise stroke-weight repair on this six-cell MIST eye blink sheet. KEEP all six eye silhouettes and their outer dimensions, all locations, the same 3×2 layout, and transparent background. Increase ONLY stroke thickness by 30 percent inward, so the open C resembles original attached second eye reference. Current sheet line is too thin. Reference MIST C stroke is 16 percent of eye width, not13percent. Use a consistent54pixelstroke on340pixel-wide glyphs. Keep all stroke ends round. Intermediate cel4/cel5: their top and lower ends approach and join CLEANLY with no doubled nub or jagged overlapping circles atleft. Last closedcel stays a SINGLE shallow lower-curved stroke that is almost horizontal, not a smiling mouth bowl. Rest of geometry must stay unchanged. Flatsoftmint#5eeadd; no pupils,brows,shading,outerglow. Preserve actualalpha. Thisisnotanewdesign; onlyconsistentboldnesscorrection to match reference.
