silmoon04/mist-robot/locomotion/models/quadruped.urdf

<?xml version='1.0' encoding='utf-8'?>
<robot name="mist_r7_four_leg_provisional">
  <link name="body">
    <inertial>
      <origin xyz="-0.001053263021725473 -5.849643931557224e-05 0.03353894898761452" rpy="0 0 0" />
      <mass value="0.9817111034761168" />
      <inertia ixx="0.001977414037404424" ixy="6.048531844584743e-08" ixz="7.131672664576226e-05" iyy="0.002193526242108633" iyz="-1.753748129779927e-06" izz="0.002012902684158956" />
    </inertial>
    <visual name="source_hub">
      <geometry>
        <mesh filename="../../design/main_hub_20260915/output/Main_Hub_4Leg.stl" scale="0.001 0.001 0.001" />
      </geometry>
      <material name="hub_material">
        <color rgba="0.3 0.6 0.65 1" />
      </material>
    </visual>
    <collision name="hub_proxy">
      <origin xyz="0 0 0.006" rpy="0 0 0" />
      <geometry>
        <box size="0.158 0.184 0.012" />
      </geometry>
    </collision>
    <visual name="battery_estimate">
      <origin xyz="0 0 0.02425" rpy="0 0 0" />
      <geometry>
        <box size="0.104 0.0345 0.0245" />
      </geometry>
      <material name="battery_estimate_material">
        <color rgba="0.1 0.12 0.14 1" />
      </material>
    </visual>
    <visual name="electronics_estimate">
      <origin xyz="0 0 0.028" rpy="0 0 0" />
      <geometry>
        <box size="0.12 0.1 0.028" />
      </geometry>
      <material name="electronics_estimate_material">
        <color rgba="0.1 0.45 0.2 0.25" />
      </material>
    </visual>
    <visual name="phone_mount_estimate">
      <origin xyz="-0.006 0 0.142" rpy="0 0 0" />
      <geometry>
        <box size="0.017 0.156 0.101" />
      </geometry>
      <material name="phone_mount_estimate_material">
        <color rgba="0.3 0.3 0.3 0.4" />
      </material>
    </visual>
    <visual name="phone_pan_servo_estimate">
      <origin xyz="-0.0128 0 0.08400000000000001" rpy="0 0 0" />
      <geometry>
        <box size="0.0452 0.0247 0.035" />
      </geometry>
      <material name="phone_pan_servo_estimate_material">
        <color rgba="0.18 0.23 0.25 1" />
      </material>
    </visual>
  </link>
  <link name="FL_base_mount">
    <visual name="yaw_case_saddle">
      <geometry>
        <mesh filename="../../design/single_leg_r7_wide_joints_20260914/output/assembly_mesh/yaw_case_saddle.stl" scale="0.001 0.001 0.001" />
      </geometry>
      <material name="yaw_case_saddle_colour">
        <color rgba="0.22 0.58 0.60 1" />
      </material>
    </visual>
    <visual name="case_cap_yaw">
      <geometry>
        <mesh filename="../../design/single_leg_r7_wide_joints_20260914/output/assembly_mesh/case_cap_yaw.stl" scale="0.001 0.001 0.001" />
      </geometry>
      <material name="case_cap_yaw_colour">
        <color rgba="0.22 0.58 0.60 1" />
      </material>
    </visual>
    <visual name="servo_yaw">
      <geometry>
        <mesh filename="../../design/single_leg_r7_wide_joints_20260914/output/assembly_mesh/servo_yaw.stl" scale="0.001 0.001 0.001" />
      </geometry>
      <material name="servo_yaw_colour">
        <color rgba="0.18 0.23 0.25 1" />
      </material>
    </visual>
    <collision name="base_mount_proxy_0">
      <origin xyz="-0.014 0 -0.017" rpy="0 0 0" />
      <geometry>
        <box size="0.059 0.041 0.032" />
      </geometry>
    </collision>
    <inertial>
      <origin xyz="-0.01295226553421215 -8.784308577222556e-05 -0.01559161639935989" rpy="0 0 0" />
      <mass value="0.08745987637442382" />
      <inertia ixx="1.522247415648824e-05" ixy="-6.68204732004394e-08" ixz="-3.289130556805698e-08" iyy="3.202677454783466e-05" iyz="-1.010234294000052e-07" izz="3.28762095334239e-05" />
    </inertial>
  </link>
  <link name="FL_coxa">
    <visual name="coxa_upper_and_hip_saddle">
      <geometry>
        <mesh filename="../../design/single_leg_r7_wide_joints_20260914/output/assembly_mesh/coxa_upper_and_hip_saddle.stl" scale="0.001 0.001 0.001" />
      </geometry>
      <material name="coxa_upper_and_hip_saddle_colour">
        <color rgba="0.22 0.58 0.60 1" />
      </material>
    </visual>
    <visual name="coxa_lower_auxiliary_arm">
      <geometry>
        <mesh filename="../../design/single_leg_r7_wide_joints_20260914/output/assembly_mesh/coxa_lower_auxiliary_arm.stl" scale="0.001 0.001 0.001" />
      </geometry>
      <material name="coxa_lower_auxiliary_arm_colour">
        <color rgba="0.22 0.58 0.60 1" />
      </material>
    </visual>
    <visual name="case_cap_hip">
      <geometry>
        <mesh filename="../../design/single_leg_r7_wide_joints_20260914/output/assembly_mesh/case_cap_hip.stl" scale="0.001 0.001 0.001" />
      </geometry>
      <material name="case_cap_hip_colour">
        <color rgba="0.22 0.58 0.60 1" />
      </material>
    </visual>
    <visual name="servo_hip">
      <geometry>
        <mesh filename="../../design/single_leg_r7_wide_joints_20260914/output/assembly_mesh/servo_hip.stl" scale="0.001 0.001 0.001" />
      </geometry>
      <material name="servo_hip_colour">
        <color rgba="0.18 0.23 0.25 1" />
      </material>
    </visual>
    <visual name="horn_yaw_main">
      <geometry>
        <mesh filename="../../design/single_leg_r7_wide_joints_20260914/output/assembly_mesh/horn_yaw_main.stl" scale="0.001 0.001 0.001" />
      </geometry>
      <material name="horn_yaw_main_colour">
        <color rgba="0.22 0.58 0.60 1" />
      </material>
    </visual>
    <visual name="horn_yaw_auxiliary">
      <geometry>
        <mesh filename="../../design/single_leg_r7_wide_joints_20260914/output/assembly_mesh/horn_yaw_auxiliary.stl" scale="0.001 0.001 0.001" />
      </geometry>
      <material name="horn_yaw_auxiliary_colour">
        <color rgba="0.22 0.58 0.60 1" />
      </material>
    </visual>
    <visual name="yaw_auxiliary_spacer_1">
      <geometry>
        <mesh filename="../../design/single_leg_r7_wide_joints_20260914/output/assembly_mesh/yaw_auxiliary_spacer_1.stl" scale="0.001 0.001 0.001" />
      </geometry>
      <material name="yaw_auxiliary_spacer_1_colour">
        <color rgba="0.22 0.58 0.60 1" />
      </material>
    </visual>
    <visual name="yaw_auxiliary_spacer_2">
      <geometry>
        <mesh filename="../../design/single_leg_r7_wide_joints_20260914/output/assembly_mesh/yaw_auxiliary_spacer_2.stl" scale="0.001 0.001 0.001" />
      </geometry>
      <material name="yaw_auxiliary_spacer_2_colour">
        <color rgba="0.22 0.58 0.60 1" />
      </material>
    </visual>
    <visual name="yaw_auxiliary_spacer_3">
      <geometry>
        <mesh filename="../../design/single_leg_r7_wide_joints_20260914/output/assembly_mesh/yaw_auxiliary_spacer_3.stl" scale="0.001 0.001 0.001" />
      </geometry>
      <material name="yaw_auxiliary_spacer_3_colour">
        <color rgba="0.22 0.58 0.60 1" />
      </material>
    </visual>
    <visual name="yaw_auxiliary_spacer_4">
      <geometry>
        <mesh filename="../../design/single_leg_r7_wide_joints_20260914/output/assembly_mesh/yaw_auxiliary_spacer_4.stl" scale="0.001 0.001 0.001" />
      </geometry>
      <material name="yaw_auxiliary_spacer_4_colour">
        <color rgba="0.22 0.58 0.60 1" />
      </material>
    </visual>
    <collision name="coxa_proxy_0">
      <origin xyz="0.039 0 0" rpy="0 0 0" />
      <geometry>
        <box size="0.078 0.024 0.018" />
      </geometry>
    </collision>
    <collision name="coxa_proxy_1">
      <origin xyz="0.067 0 -0.01" rpy="0 0 0" />
      <geometry>
        <box size="0.055 0.04 0.027" />
      </geometry>
    </collision>
    <inertial>
      <origin xyz="0.05545258777402026 -0.0003262270661361422 -0.007411181974307129" rpy="0 0 0" />
      <mass value="0.116188274378526" />
      <inertia ixx="4.884448832271316e-05" ixy="7.745356217217634e-07" ixz="-3.077386854505764e-05" iyy="0.0001315815648874679" iyz="5.456770085067065e-07" izz="9.845169734911079e-05" />
    </inertial>
  </link>
  <link name="FL_femur">
    <visual name="femur_main_and_knee_saddle">
      <geometry>
        <mesh filename="../../design/single_leg_r7_wide_joints_20260914/output/assembly_mesh/femur_main_and_knee_saddle.stl" scale="0.001 0.001 0.001" />
      </geometry>
      <material name="femur_main_and_knee_saddle_colour">
        <color rgba="0.22 0.58 0.60 1" />
      </material>
    </visual>
    <visual name="femur_auxiliary_cheek">
      <geometry>
        <mesh filename="../../design/single_leg_r7_wide_joints_20260914/output/assembly_mesh/femur_auxiliary_cheek.stl" scale="0.001 0.001 0.001" />
      </geometry>
      <material name="femur_auxiliary_cheek_colour">
        <color rgba="0.22 0.58 0.60 1" />
      </material>
    </visual>
    <visual name="case_cap_knee">
      <geometry>
        <mesh filename="../../design/single_leg_r7_wide_joints_20260914/output/assembly_mesh/case_cap_knee.stl" scale="0.001 0.001 0.001" />
      </geometry>
      <material name="case_cap_knee_colour">
        <color rgba="0.22 0.58 0.60 1" />
      </material>
    </visual>
    <visual name="servo_knee">
      <geometry>
        <mesh filename="../../design/single_leg_r7_wide_joints_20260914/output/assembly_mesh/servo_knee.stl" scale="0.001 0.001 0.001" />
      </geometry>
      <material name="servo_knee_colour">
        <color rgba="0.18 0.23 0.25 1" />
      </material>
    </visual>
    <visual name="horn_hip_main">
      <geometry>
        <mesh filename="../../design/single_leg_r7_wide_joints_20260914/output/assembly_mesh/horn_hip_main.stl" scale="0.001 0.001 0.001" />
      </geometry>
      <material name="horn_hip_main_colour">
        <color rgba="0.22 0.58 0.60 1" />
      </material>
    </visual>
    <visual name="horn_hip_auxiliary">
      <geometry>
        <mesh filename="../../design/single_leg_r7_wide_joints_20260914/output/assembly_mesh/horn_hip_auxiliary.stl" scale="0.001 0.001 0.001" />
      </geometry>
      <material name="horn_hip_auxiliary_colour">
        <color rgba="0.22 0.58 0.60 1" />
      </material>
    </visual>
    <collision name="femur_proxy_0">
      <origin xyz="0.043 0 0" rpy="0 0 0" />
      <geometry>
        <box size="0.08599999999999999 0.024 0.018" />
      </geometry>
    </collision>
    <collision name="femur_proxy_1">
      <origin xyz="0.075 0 0.01" rpy="0 0 0" />
      <geometry>
        <box size="0.047 0.041 0.027" />
      </geometry>
    </collision>
    <inertial>
      <origin xyz="0.06336517604261289 -0.001298314040615189 0.001934967497040738" rpy="0 0 0" />
      <mass value="0.1249160158306359" />
      <inertia ixx="3.802203223109219e-05" ixy="-3.321671674319615e-06" ixz="-3.950552346680719e-07" iyy="0.000113452612881376" iyz="3.848976942245111e-07" izz="0.0001232966723477869" />
    </inertial>
  </link>
  <link name="FL_tibia">
    <visual name="tibia_curved_main_and_foot">
      <geometry>
        <mesh filename="../../design/single_leg_r7_wide_joints_20260914/output/assembly_mesh/tibia_curved_main_and_foot.stl" scale="0.001 0.001 0.001" />
      </geometry>
      <material name="tibia_curved_main_and_foot_colour">
        <color rgba="0.22 0.58 0.60 1" />
      </material>
    </visual>
    <visual name="tibia_auxiliary_cheek">
      <geometry>
        <mesh filename="../../design/single_leg_r7_wide_joints_20260914/output/assembly_mesh/tibia_auxiliary_cheek.stl" scale="0.001 0.001 0.001" />
      </geometry>
      <material name="tibia_auxiliary_cheek_colour">
        <color rgba="0.22 0.58 0.60 1" />
      </material>
    </visual>
    <visual name="horn_knee_main">
      <geometry>
        <mesh filename="../../design/single_leg_r7_wide_joints_20260914/output/assembly_mesh/horn_knee_main.stl" scale="0.001 0.001 0.001" />
      </geometry>
      <material name="horn_knee_main_colour">
        <color rgba="0.22 0.58 0.60 1" />
      </material>
    </visual>
    <visual name="horn_knee_auxiliary">
      <geometry>
        <mesh filename="../../design/single_leg_r7_wide_joints_20260914/output/assembly_mesh/horn_knee_auxiliary.stl" scale="0.001 0.001 0.001" />
      </geometry>
      <material name="horn_knee_auxiliary_colour">
        <color rgba="0.22 0.58 0.60 1" />
      </material>
    </visual>
    <collision name="tibia_proxy_0">
      <origin xyz="0.048 0 0" rpy="0 0 0" />
      <geometry>
        <box size="0.092 0.017 0.014" />
      </geometry>
    </collision>
    <inertial>
      <origin xyz="0.0414753995760796 -0.001694745710956234 0.0002991704986421671" rpy="0 0 0" />
      <mass value="0.04930491667511244" />
      <inertia ixx="1.341332884585064e-05" ixy="-1.987778173156809e-06" ixz="3.685225617944397e-07" iyy="4.556212902457954e-05" iyz="3.336425043941025e-08" izz="5.547369214215767e-05" />
    </inertial>
  </link>
  <joint name="FL_mount" type="fixed">
    <parent link="body" />
    <child link="FL_base_mount" />
    <origin xyz="0.05303300858899106 0.05303300858899106 0.038" rpy="0 0 0.7853981633974483" />
  </joint>
  <joint name="FL_yaw" type="revolute">
    <parent link="FL_base_mount" />
    <child link="FL_coxa" />
    <origin xyz="0 0 0" rpy="0 0 0" />
    <axis xyz="0 0 1" />
    <limit lower="-0.9599310885968813" upper="0.9599310885968813" effort="0.588" velocity="4.717" />
    <dynamics damping="0.015" friction="0.0" />
  </joint>
  <joint name="FL_hip" type="revolute">
    <parent link="FL_coxa" />
    <child link="FL_femur" />
    <origin xyz=".082 0 0" rpy="0 0 0" />
    <axis xyz="0 1 0" />
    <limit lower="-0.5235987755982988" upper="1.1344640137963142" effort="0.588" velocity="4.717" />
    <dynamics damping="0.015" friction="0.0" />
  </joint>
  <joint name="FL_knee" type="revolute">
    <parent link="FL_femur" />
    <child link="FL_tibia" />
    <origin xyz=".090 0 0" rpy="0 0 0" />
    <axis xyz="0 1 0" />
    <limit lower="0.08726646259971647" upper="2.007128639793479" effort="0.588" velocity="4.717" />
    <dynamics damping="0.015" friction="0.0" />
  </joint>
  <link name="FL_toe">
    <inertial>
      <origin xyz="0 0 0" rpy="0 0 0" />
      <mass value="0" />
      <inertia ixx="0" ixy="0" ixz="0" iyy="0" iyz="0" izz="0" />
    </inertial>
    <collision name="FL_toe_sphere">
      <origin xyz="0 0 0" rpy="0 0 0" />
      <geometry>
        <sphere radius="0.005" />
      </geometry>
    </collision>
    <visual name="FL_toe_contact">
      <origin xyz="0 0 0" rpy="0 0 0" />
      <geometry>
        <sphere radius="0.005" />
      </geometry>
      <material name="FL_toe_contact_material">
        <color rgba="0.15 0.15 0.15 1" />
      </material>
    </visual>
  </link>
  <joint name="FL_toe_fixed" type="fixed">
    <parent link="FL_tibia" />
    <child link="FL_toe" />
    <origin xyz="0.105 0 0" rpy="0 0 0" />
  </joint>
  <link name="FR_base_mount">
    <visual name="yaw_case_saddle">
      <geometry>
        <mesh filename="../../design/single_leg_r7_wide_joints_20260914/output/assembly_mesh/yaw_case_saddle.stl" scale="0.001 0.001 0.001" />
      </geometry>
      <material name="yaw_case_saddle_colour">
        <color rgba="0.22 0.58 0.60 1" />
      </material>
    </visual>
    <visual name="case_cap_yaw">
      <geometry>
        <mesh filename="../../design/single_leg_r7_wide_joints_20260914/output/assembly_mesh/case_cap_yaw.stl" scale="0.001 0.001 0.001" />
      </geometry>
      <material name="case_cap_yaw_colour">
        <color rgba="0.22 0.58 0.60 1" />
      </material>
    </visual>
    <visual name="servo_yaw">
      <geometry>
        <mesh filename="../../design/single_leg_r7_wide_joints_20260914/output/assembly_mesh/servo_yaw.stl" scale="0.001 0.001 0.001" />
      </geometry>
      <material name="servo_yaw_colour">
        <color rgba="0.18 0.23 0.25 1" />
      </material>
    </visual>
    <collision name="base_mount_proxy_0">
      <origin xyz="-0.014 0 -0.017" rpy="0 0 0" />
      <geometry>
        <box size="0.059 0.041 0.032" />
      </geometry>
    </collision>
    <inertial>
      <origin xyz="-0.01295226553421215 -8.784308577222556e-05 -0.01559161639935989" rpy="0 0 0" />
      <mass value="0.08745987637442382" />
      <inertia ixx="1.522247415648824e-05" ixy="-6.68204732004394e-08" ixz="-3.289130556805698e-08" iyy="3.202677454783466e-05" iyz="-1.010234294000052e-07" izz="3.28762095334239e-05" />
    </inertial>
  </link>
  <link name="FR_coxa">
    <visual name="coxa_upper_and_hip_saddle">
      <geometry>
        <mesh filename="../../design/single_leg_r7_wide_joints_20260914/output/assembly_mesh/coxa_upper_and_hip_saddle.stl" scale="0.001 0.001 0.001" />
      </geometry>
      <material name="coxa_upper_and_hip_saddle_colour">
        <color rgba="0.22 0.58 0.60 1" />
      </material>
    </visual>
    <visual name="coxa_lower_auxiliary_arm">
      <geometry>
        <mesh filename="../../design/single_leg_r7_wide_joints_20260914/output/assembly_mesh/coxa_lower_auxiliary_arm.stl" scale="0.001 0.001 0.001" />
      </geometry>
      <material name="coxa_lower_auxiliary_arm_colour">
        <color rgba="0.22 0.58 0.60 1" />
      </material>
    </visual>
    <visual name="case_cap_hip">
      <geometry>
        <mesh filename="../../design/single_leg_r7_wide_joints_20260914/output/assembly_mesh/case_cap_hip.stl" scale="0.001 0.001 0.001" />
      </geometry>
      <material name="case_cap_hip_colour">
        <color rgba="0.22 0.58 0.60 1" />
      </material>
    </visual>
    <visual name="servo_hip">
      <geometry>
        <mesh filename="../../design/single_leg_r7_wide_joints_20260914/output/assembly_mesh/servo_hip.stl" scale="0.001 0.001 0.001" />
      </geometry>
      <material name="servo_hip_colour">
        <color rgba="0.18 0.23 0.25 1" />
      </material>
    </visual>
    <visual name="horn_yaw_main">
      <geometry>
        <mesh filename="../../design/single_leg_r7_wide_joints_20260914/output/assembly_mesh/horn_yaw_main.stl" scale="0.001 0.001 0.001" />
      </geometry>
      <material name="horn_yaw_main_colour">
        <color rgba="0.22 0.58 0.60 1" />
      </material>
    </visual>
    <visual name="horn_yaw_auxiliary">
      <geometry>
        <mesh filename="../../design/single_leg_r7_wide_joints_20260914/output/assembly_mesh/horn_yaw_auxiliary.stl" scale="0.001 0.001 0.001" />
      </geometry>
      <material name="horn_yaw_auxiliary_colour">
        <color rgba="0.22 0.58 0.60 1" />
      </material>
    </visual>
    <visual name="yaw_auxiliary_spacer_1">
      <geometry>
        <mesh filename="../../design/single_leg_r7_wide_joints_20260914/output/assembly_mesh/yaw_auxiliary_spacer_1.stl" scale="0.001 0.001 0.001" />
      </geometry>
      <material name="yaw_auxiliary_spacer_1_colour">
        <color rgba="0.22 0.58 0.60 1" />
      </material>
    </visual>
    <visual name="yaw_auxiliary_spacer_2">
      <geometry>
        <mesh filename="../../design/single_leg_r7_wide_joints_20260914/output/assembly_mesh/yaw_auxiliary_spacer_2.stl" scale="0.001 0.001 0.001" />
      </geometry>
      <material name="yaw_auxiliary_spacer_2_colour">
        <color rgba="0.22 0.58 0.60 1" />
      </material>
    </visual>
    <visual name="yaw_auxiliary_spacer_3">
      <geometry>
        <mesh filename="../../design/single_leg_r7_wide_joints_20260914/output/assembly_mesh/yaw_auxiliary_spacer_3.stl" scale="0.001 0.001 0.001" />
      </geometry>
      <material name="yaw_auxiliary_spacer_3_colour">
        <color rgba="0.22 0.58 0.60 1" />
      </material>
    </visual>
    <visual name="yaw_auxiliary_spacer_4">
      <geometry>
        <mesh filename="../../design/single_leg_r7_wide_joints_20260914/output/assembly_mesh/yaw_auxiliary_spacer_4.stl" scale="0.001 0.001 0.001" />
      </geometry>
      <material name="yaw_auxiliary_spacer_4_colour">
        <color rgba="0.22 0.58 0.60 1" />
      </material>
    </visual>
    <collision name="coxa_proxy_0">
      <origin xyz="0.039 0 0" rpy="0 0 0" />
      <geometry>
        <box size="0.078 0.024 0.018" />
      </geometry>
    </collision>
    <collision name="coxa_proxy_1">
      <origin xyz="0.067 0 -0.01" rpy="0 0 0" />
      <geometry>
        <box size="0.055 0.04 0.027" />
      </geometry>
    </collision>
    <inertial>
      <origin xyz="0.05545258777402026 -0.0003262270661361422 -0.007411181974307129" rpy="0 0 0" />
      <mass value="0.116188274378526" />
      <inertia ixx="4.884448832271316e-05" ixy="7.745356217217634e-07" ixz="-3.077386854505764e-05" iyy="0.0001315815648874679" iyz="5.456770085067065e-07" izz="9.845169734911079e-05" />
    </inertial>
  </link>
  <link name="FR_femur">
    <visual name="femur_main_and_knee_saddle">
      <geometry>
        <mesh filename="../../design/single_leg_r7_wide_joints_20260914/output/assembly_mesh/femur_main_and_knee_saddle.stl" scale="0.001 0.001 0.001" />
      </geometry>
      <material name="femur_main_and_knee_saddle_colour">
        <color rgba="0.22 0.58 0.60 1" />
      </material>
    </visual>
    <visual name="femur_auxiliary_cheek">
      <geometry>
        <mesh filename="../../design/single_leg_r7_wide_joints_20260914/output/assembly_mesh/femur_auxiliary_cheek.stl" scale="0.001 0.001 0.001" />
      </geometry>
      <material name="femur_auxiliary_cheek_colour">
        <color rgba="0.22 0.58 0.60 1" />
      </material>
    </visual>
    <visual name="case_cap_knee">
      <geometry>
        <mesh filename="../../design/single_leg_r7_wide_joints_20260914/output/assembly_mesh/case_cap_knee.stl" scale="0.001 0.001 0.001" />
      </geometry>
      <material name="case_cap_knee_colour">
        <color rgba="0.22 0.58 0.60 1" />
      </material>
    </visual>
    <visual name="servo_knee">
      <geometry>
        <mesh filename="../../design/single_leg_r7_wide_joints_20260914/output/assembly_mesh/servo_knee.stl" scale="0.001 0.001 0.001" />
      </geometry>
      <material name="servo_knee_colour">
        <color rgba="0.18 0.23 0.25 1" />
      </material>
    </visual>
    <visual name="horn_hip_main">
      <geometry>
        <mesh filename="../../design/single_leg_r7_wide_joints_20260914/output/assembly_mesh/horn_hip_main.stl" scale="0.001 0.001 0.001" />
      </geometry>
      <material name="horn_hip_main_colour">
        <color rgba="0.22 0.58 0.60 1" />
      </material>
    </visual>
    <visual name="horn_hip_auxiliary">
      <geometry>
        <mesh filename="../../design/single_leg_r7_wide_joints_20260914/output/assembly_mesh/horn_hip_auxiliary.stl" scale="0.001 0.001 0.001" />
      </geometry>
      <material name="horn_hip_auxiliary_colour">
        <color rgba="0.22 0.58 0.60 1" />
      </material>
    </visual>
    <collision name="femur_proxy_0">
      <origin xyz="0.043 0 0" rpy="0 0 0" />
      <geometry>
        <box size="0.08599999999999999 0.024 0.018" />
      </geometry>
    </collision>
    <collision name="femur_proxy_1">
      <origin xyz="0.075 0 0.01" rpy="0 0 0" />
      <geometry>
        <box size="0.047 0.041 0.027" />
      </geometry>
    </collision>
    <inertial>
      <origin xyz="0.06336517604261289 -0.001298314040615189 0.001934967497040738" rpy="0 0 0" />
      <mass value="0.1249160158306359" />
      <inertia ixx="3.802203223109219e-05" ixy="-3.321671674319615e-06" ixz="-3.950552346680719e-07" iyy="0.000113452612881376" iyz="3.848976942245111e-07" izz="0.0001232966723477869" />
    </inertial>
  </link>
  <link name="FR_tibia">
    <visual name="tibia_curved_main_and_foot">
      <geometry>
        <mesh filename="../../design/single_leg_r7_wide_joints_20260914/output/assembly_mesh/tibia_curved_main_and_foot.stl" scale="0.001 0.001 0.001" />
      </geometry>
      <material name="tibia_curved_main_and_foot_colour">
        <color rgba="0.22 0.58 0.60 1" />
      </material>
    </visual>
    <visual name="tibia_auxiliary_cheek">
      <geometry>
        <mesh filename="../../design/single_leg_r7_wide_joints_20260914/output/assembly_mesh/tibia_auxiliary_cheek.stl" scale="0.001 0.001 0.001" />
      </geometry>
      <material name="tibia_auxiliary_cheek_colour">
        <color rgba="0.22 0.58 0.60 1" />
      </material>
    </visual>
    <visual name="horn_knee_main">
      <geometry>
        <mesh filename="../../design/single_leg_r7_wide_joints_20260914/output/assembly_mesh/horn_knee_main.stl" scale="0.001 0.001 0.001" />
      </geometry>
      <material name="horn_knee_main_colour">
        <color rgba="0.22 0.58 0.60 1" />
      </material>
    </visual>
    <visual name="horn_knee_auxiliary">
      <geometry>
        <mesh filename="../../design/single_leg_r7_wide_joints_20260914/output/assembly_mesh/horn_knee_auxiliary.stl" scale="0.001 0.001 0.001" />
      </geometry>
      <material name="horn_knee_auxiliary_colour">
        <color rgba="0.22 0.58 0.60 1" />
      </material>
    </visual>
    <collision name="tibia_proxy_0">
      <origin xyz="0.048 0 0" rpy="0 0 0" />
      <geometry>
        <box size="0.092 0.017 0.014" />
      </geometry>
    </collision>
    <inertial>
      <origin xyz="0.0414753995760796 -0.001694745710956234 0.0002991704986421671" rpy="0 0 0" />
      <mass value="0.04930491667511244" />
      <inertia ixx="1.341332884585064e-05" ixy="-1.987778173156809e-06" ixz="3.685225617944397e-07" iyy="4.556212902457954e-05" iyz="3.336425043941025e-08" izz="5.547369214215767e-05" />
    </inertial>
  </link>
  <joint name="FR_mount" type="fixed">
    <parent link="body" />
    <child link="FR_base_mount" />
    <origin xyz="0.05303300858899106 -0.05303300858899106 0.038" rpy="0 0 -0.7853981633974483" />
  </joint>
  <joint name="FR_yaw" type="revolute">
    <parent link="FR_base_mount" />
    <child link="FR_coxa" />
    <origin xyz="0 0 0" rpy="0 0 0" />
    <axis xyz="0 0 1" />
    <limit lower="-0.9599310885968813" upper="0.9599310885968813" effort="0.588" velocity="4.717" />
    <dynamics damping="0.015" friction="0.0" />
  </joint>
  <joint name="FR_hip" type="revolute">
    <parent link="FR_coxa" />
    <child link="FR_femur" />
    <origin xyz=".082 0 0" rpy="0 0 0" />
    <axis xyz="0 1 0" />
    <limit lower="-0.5235987755982988" upper="1.1344640137963142" effort="0.588" velocity="4.717" />
    <dynamics damping="0.015" friction="0.0" />
  </joint>
  <joint name="FR_knee" type="revolute">
    <parent link="FR_femur" />
    <child link="FR_tibia" />
    <origin xyz=".090 0 0" rpy="0 0 0" />
    <axis xyz="0 1 0" />
    <limit lower="0.08726646259971647" upper="2.007128639793479" effort="0.588" velocity="4.717" />
    <dynamics damping="0.015" friction="0.0" />
  </joint>
  <link name="FR_toe">
    <inertial>
      <origin xyz="0 0 0" rpy="0 0 0" />
      <mass value="0" />
      <inertia ixx="0" ixy="0" ixz="0" iyy="0" iyz="0" izz="0" />
    </inertial>
    <collision name="FR_toe_sphere">
      <origin xyz="0 0 0" rpy="0 0 0" />
      <geometry>
        <sphere radius="0.005" />
      </geometry>
    </collision>
    <visual name="FR_toe_contact">
      <origin xyz="0 0 0" rpy="0 0 0" />
      <geometry>
        <sphere radius="0.005" />
      </geometry>
      <material name="FR_toe_contact_material">
        <color rgba="0.15 0.15 0.15 1" />
      </material>
    </visual>
  </link>
  <joint name="FR_toe_fixed" type="fixed">
    <parent link="FR_tibia" />
    <child link="FR_toe" />
    <origin xyz="0.105 0 0" rpy="0 0 0" />
  </joint>
  <link name="RL_base_mount">
    <visual name="yaw_case_saddle">
      <geometry>
        <mesh filename="../../design/single_leg_r7_wide_joints_20260914/output/assembly_mesh/yaw_case_saddle.stl" scale="0.001 0.001 0.001" />
      </geometry>
      <material name="yaw_case_saddle_colour">
        <color rgba="0.22 0.58 0.60 1" />
      </material>
    </visual>
    <visual name="case_cap_yaw">
      <geometry>
        <mesh filename="../../design/single_leg_r7_wide_joints_20260914/output/assembly_mesh/case_cap_yaw.stl" scale="0.001 0.001 0.001" />
      </geometry>
      <material name="case_cap_yaw_colour">
        <color rgba="0.22 0.58 0.60 1" />
      </material>
    </visual>
    <visual name="servo_yaw">
      <geometry>
        <mesh filename="../../design/single_leg_r7_wide_joints_20260914/output/assembly_mesh/servo_yaw.stl" scale="0.001 0.001 0.001" />
      </geometry>
      <material name="servo_yaw_colour">
        <color rgba="0.18 0.23 0.25 1" />
      </material>
    </visual>
    <collision name="base_mount_proxy_0">
      <origin xyz="-0.014 0 -0.017" rpy="0 0 0" />
      <geometry>
        <box size="0.059 0.041 0.032" />
      </geometry>
    </collision>
    <inertial>
      <origin xyz="-0.01295226553421215 -8.784308577222556e-05 -0.01559161639935989" rpy="0 0 0" />
      <mass value="0.08745987637442382" />
      <inertia ixx="1.522247415648824e-05" ixy="-6.68204732004394e-08" ixz="-3.289130556805698e-08" iyy="3.202677454783466e-05" iyz="-1.010234294000052e-07" izz="3.28762095334239e-05" />
    </inertial>
  </link>
  <link name="RL_coxa">
    <visual name="coxa_upper_and_hip_saddle">
      <geometry>
        <mesh filename="../../design/single_leg_r7_wide_joints_20260914/output/assembly_mesh/coxa_upper_and_hip_saddle.stl" scale="0.001 0.001 0.001" />
      </geometry>
      <material name="coxa_upper_and_hip_saddle_colour">
        <color rgba="0.22 0.58 0.60 1" />
      </material>
    </visual>
    <visual name="coxa_lower_auxiliary_arm">
      <geometry>
        <mesh filename="../../design/single_leg_r7_wide_joints_20260914/output/assembly_mesh/coxa_lower_auxiliary_arm.stl" scale="0.001 0.001 0.001" />
      </geometry>
      <material name="coxa_lower_auxiliary_arm_colour">
        <color rgba="0.22 0.58 0.60 1" />
      </material>
    </visual>
    <visual name="case_cap_hip">
      <geometry>
        <mesh filename="../../design/single_leg_r7_wide_joints_20260914/output/assembly_mesh/case_cap_hip.stl" scale="0.001 0.001 0.001" />
      </geometry>
      <material name="case_cap_hip_colour">
        <color rgba="0.22 0.58 0.60 1" />
      </material>
    </visual>
    <visual name="servo_hip">
      <geometry>
        <mesh filename="../../design/single_leg_r7_wide_joints_20260914/output/assembly_mesh/servo_hip.stl" scale="0.001 0.001 0.001" />
      </geometry>
      <material name="servo_hip_colour">
        <color rgba="0.18 0.23 0.25 1" />
      </material>
    </visual>
    <visual name="horn_yaw_main">
      <geometry>
        <mesh filename="../../design/single_leg_r7_wide_joints_20260914/output/assembly_mesh/horn_yaw_main.stl" scale="0.001 0.001 0.001" />
      </geometry>
      <material name="horn_yaw_main_colour">
        <color rgba="0.22 0.58 0.60 1" />
      </material>
    </visual>
    <visual name="horn_yaw_auxiliary">
      <geometry>
        <mesh filename="../../design/single_leg_r7_wide_joints_20260914/output/assembly_mesh/horn_yaw_auxiliary.stl" scale="0.001 0.001 0.001" />
      </geometry>
      <material name="horn_yaw_auxiliary_colour">
        <color rgba="0.22 0.58 0.60 1" />
      </material>
    </visual>
    <visual name="yaw_auxiliary_spacer_1">
      <geometry>
        <mesh filename="../../design/single_leg_r7_wide_joints_20260914/output/assembly_mesh/yaw_auxiliary_spacer_1.stl" scale="0.001 0.001 0.001" />
      </geometry>
      <material name="yaw_auxiliary_spacer_1_colour">
        <color rgba="0.22 0.58 0.60 1" />
      </material>
    </visual>
    <visual name="yaw_auxiliary_spacer_2">
      <geometry>
        <mesh filename="../../design/single_leg_r7_wide_joints_20260914/output/assembly_mesh/yaw_auxiliary_spacer_2.stl" scale="0.001 0.001 0.001" />
      </geometry>
      <material name="yaw_auxiliary_spacer_2_colour">
        <color rgba="0.22 0.58 0.60 1" />
      </material>
    </visual>
    <visual name="yaw_auxiliary_spacer_3">
      <geometry>
        <mesh filename="../../design/single_leg_r7_wide_joints_20260914/output/assembly_mesh/yaw_auxiliary_spacer_3.stl" scale="0.001 0.001 0.001" />
      </geometry>
      <material name="yaw_auxiliary_spacer_3_colour">
        <color rgba="0.22 0.58 0.60 1" />
      </material>
    </visual>
    <visual name="yaw_auxiliary_spacer_4">
      <geometry>
        <mesh filename="../../design/single_leg_r7_wide_joints_20260914/output/assembly_mesh/yaw_auxiliary_spacer_4.stl" scale="0.001 0.001 0.001" />
      </geometry>
      <material name="yaw_auxiliary_spacer_4_colour">
        <color rgba="0.22 0.58 0.60 1" />
      </material>
    </visual>
    <collision name="coxa_proxy_0">
      <origin xyz="0.039 0 0" rpy="0 0 0" />
      <geometry>
        <box size="0.078 0.024 0.018" />
      </geometry>
    </collision>
    <collision name="coxa_proxy_1">
      <origin xyz="0.067 0 -0.01" rpy="0 0 0" />
      <geometry>
        <box size="0.055 0.04 0.027" />
      </geometry>
    </collision>
    <inertial>
      <origin xyz="0.05545258777402026 -0.0003262270661361422 -0.007411181974307129" rpy="0 0 0" />
      <mass value="0.116188274378526" />
      <inertia ixx="4.884448832271316e-05" ixy="7.745356217217634e-07" ixz="-3.077386854505764e-05" iyy="0.0001315815648874679" iyz="5.456770085067065e-07" izz="9.845169734911079e-05" />
    </inertial>
  </link>
  <link name="RL_femur">
    <visual name="femur_main_and_knee_saddle">
      <geometry>
        <mesh filename="../../design/single_leg_r7_wide_joints_20260914/output/assembly_mesh/femur_main_and_knee_saddle.stl" scale="0.001 0.001 0.001" />
      </geometry>
      <material name="femur_main_and_knee_saddle_colour">
        <color rgba="0.22 0.58 0.60 1" />
      </material>
    </visual>
    <visual name="femur_auxiliary_cheek">
      <geometry>
        <mesh filename="../../design/single_leg_r7_wide_joints_20260914/output/assembly_mesh/femur_auxiliary_cheek.stl" scale="0.001 0.001 0.001" />
      </geometry>
      <material name="femur_auxiliary_cheek_colour">
        <color rgba="0.22 0.58 0.60 1" />
      </material>
    </visual>
    <visual name="case_cap_knee">
      <geometry>
        <mesh filename="../../design/single_leg_r7_wide_joints_20260914/output/assembly_mesh/case_cap_knee.stl" scale="0.001 0.001 0.001" />
      </geometry>
      <material name="case_cap_knee_colour">
        <color rgba="0.22 0.58 0.60 1" />
      </material>
    </visual>
    <visual name="servo_knee">
      <geometry>
        <mesh filename="../../design/single_leg_r7_wide_joints_20260914/output/assembly_mesh/servo_knee.stl" scale="0.001 0.001 0.001" />
      </geometry>
      <material name="servo_knee_colour">
        <color rgba="0.18 0.23 0.25 1" />
      </material>
    </visual>
    <visual name="horn_hip_main">
      <geometry>
        <mesh filename="../../design/single_leg_r7_wide_joints_20260914/output/assembly_mesh/horn_hip_main.stl" scale="0.001 0.001 0.001" />
      </geometry>
      <material name="horn_hip_main_colour">
        <color rgba="0.22 0.58 0.60 1" />
      </material>
    </visual>
    <visual name="horn_hip_auxiliary">
      <geometry>
        <mesh filename="../../design/single_leg_r7_wide_joints_20260914/output/assembly_mesh/horn_hip_auxiliary.stl" scale="0.001 0.001 0.001" />
      </geometry>
      <material name="horn_hip_auxiliary_colour">
        <color rgba="0.22 0.58 0.60 1" />
      </material>
    </visual>
    <collision name="femur_proxy_0">
      <origin xyz="0.043 0 0" rpy="0 0 0" />
      <geometry>
        <box size="0.08599999999999999 0.024 0.018" />
      </geometry>
    </collision>
    <collision name="femur_proxy_1">
      <origin xyz="0.075 0 0.01" rpy="0 0 0" />
      <geometry>
        <box size="0.047 0.041 0.027" />
      </geometry>
    </collision>
    <inertial>
      <origin xyz="0.06336517604261289 -0.001298314040615189 0.001934967497040738" rpy="0 0 0" />
      <mass value="0.1249160158306359" />
      <inertia ixx="3.802203223109219e-05" ixy="-3.321671674319615e-06" ixz="-3.950552346680719e-07" iyy="0.000113452612881376" iyz="3.848976942245111e-07" izz="0.0001232966723477869" />
    </inertial>
  </link>
  <link name="RL_tibia">
    <visual name="tibia_curved_main_and_foot">
      <geometry>
        <mesh filename="../../design/single_leg_r7_wide_joints_20260914/output/assembly_mesh/tibia_curved_main_and_foot.stl" scale="0.001 0.001 0.001" />
      </geometry>
      <material name="tibia_curved_main_and_foot_colour">
        <color rgba="0.22 0.58 0.60 1" />
      </material>
    </visual>
    <visual name="tibia_auxiliary_cheek">
      <geometry>
        <mesh filename="../../design/single_leg_r7_wide_joints_20260914/output/assembly_mesh/tibia_auxiliary_cheek.stl" scale="0.001 0.001 0.001" />
      </geometry>
      <material name="tibia_auxiliary_cheek_colour">
        <color rgba="0.22 0.58 0.60 1" />
      </material>
    </visual>
    <visual name="horn_knee_main">
      <geometry>
        <mesh filename="../../design/single_leg_r7_wide_joints_20260914/output/assembly_mesh/horn_knee_main.stl" scale="0.001 0.001 0.001" />
      </geometry>
      <material name="horn_knee_main_colour">
        <color rgba="0.22 0.58 0.60 1" />
      </material>
    </visual>
    <visual name="horn_knee_auxiliary">
      <geometry>
        <mesh filename="../../design/single_leg_r7_wide_joints_20260914/output/assembly_mesh/horn_knee_auxiliary.stl" scale="0.001 0.001 0.001" />
      </geometry>
      <material name="horn_knee_auxiliary_colour">
        <color rgba="0.22 0.58 0.60 1" />
      </material>
    </visual>
    <collision name="tibia_proxy_0">
      <origin xyz="0.048 0 0" rpy="0 0 0" />
      <geometry>
        <box size="0.092 0.017 0.014" />
      </geometry>
    </collision>
    <inertial>
      <origin xyz="0.0414753995760796 -0.001694745710956234 0.0002991704986421671" rpy="0 0 0" />
      <mass value="0.04930491667511244" />
      <inertia ixx="1.341332884585064e-05" ixy="-1.987778173156809e-06" ixz="3.685225617944397e-07" iyy="4.556212902457954e-05" iyz="3.336425043941025e-08" izz="5.547369214215767e-05" />
    </inertial>
  </link>
  <joint name="RL_mount" type="fixed">
    <parent link="body" />
    <child link="RL_base_mount" />
    <origin xyz="-0.05303300858899106 0.05303300858899106 0.038" rpy="0 0 2.356194490192345" />
  </joint>
  <joint name="RL_yaw" type="revolute">
    <parent link="RL_base_mount" />
    <child link="RL_coxa" />
    <origin xyz="0 0 0" rpy="0 0 0" />
    <axis xyz="0 0 1" />
    <limit lower="-0.9599310885968813" upper="0.9599310885968813" effort="0.588" velocity="4.717" />
    <dynamics damping="0.015" friction="0.0" />
  </joint>
  <joint name="RL_hip" type="revolute">
    <parent link="RL_coxa" />
    <child link="RL_femur" />
    <origin xyz=".082 0 0" rpy="0 0 0" />
    <axis xyz="0 1 0" />
    <limit lower="-0.5235987755982988" upper="1.1344640137963142" effort="0.588" velocity="4.717" />
    <dynamics damping="0.015" friction="0.0" />
  </joint>
  <joint name="RL_knee" type="revolute">
    <parent link="RL_femur" />
    <child link="RL_tibia" />
    <origin xyz=".090 0 0" rpy="0 0 0" />
    <axis xyz="0 1 0" />
    <limit lower="0.08726646259971647" upper="2.007128639793479" effort="0.588" velocity="4.717" />
    <dynamics damping="0.015" friction="0.0" />
  </joint>
  <link name="RL_toe">
    <inertial>
      <origin xyz="0 0 0" rpy="0 0 0" />
      <mass value="0" />
      <inertia ixx="0" ixy="0" ixz="0" iyy="0" iyz="0" izz="0" />
    </inertial>
    <collision name="RL_toe_sphere">
      <origin xyz="0 0 0" rpy="0 0 0" />
      <geometry>
        <sphere radius="0.005" />
      </geometry>
    </collision>
    <visual name="RL_toe_contact">
      <origin xyz="0 0 0" rpy="0 0 0" />
      <geometry>
        <sphere radius="0.005" />
      </geometry>
      <material name="RL_toe_contact_material">
        <color rgba="0.15 0.15 0.15 1" />
      </material>
    </visual>
  </link>
  <joint name="RL_toe_fixed" type="fixed">
    <parent link="RL_tibia" />
    <child link="RL_toe" />
    <origin xyz="0.105 0 0" rpy="0 0 0" />
  </joint>
  <link name="RR_base_mount">
    <visual name="yaw_case_saddle">
      <geometry>
        <mesh filename="../../design/single_leg_r7_wide_joints_20260914/output/assembly_mesh/yaw_case_saddle.stl" scale="0.001 0.001 0.001" />
      </geometry>
      <material name="yaw_case_saddle_colour">
        <color rgba="0.22 0.58 0.60 1" />
      </material>
    </visual>
    <visual name="case_cap_yaw">
      <geometry>
        <mesh filename="../../design/single_leg_r7_wide_joints_20260914/output/assembly_mesh/case_cap_yaw.stl" scale="0.001 0.001 0.001" />
      </geometry>
      <material name="case_cap_yaw_colour">
        <color rgba="0.22 0.58 0.60 1" />
      </material>
    </visual>
    <visual name="servo_yaw">
      <geometry>
        <mesh filename="../../design/single_leg_r7_wide_joints_20260914/output/assembly_mesh/servo_yaw.stl" scale="0.001 0.001 0.001" />
      </geometry>
      <material name="servo_yaw_colour">
        <color rgba="0.18 0.23 0.25 1" />
      </material>
    </visual>
    <collision name="base_mount_proxy_0">
      <origin xyz="-0.014 0 -0.017" rpy="0 0 0" />
      <geometry>
        <box size="0.059 0.041 0.032" />
      </geometry>
    </collision>
    <inertial>
      <origin xyz="-0.01295226553421215 -8.784308577222556e-05 -0.01559161639935989" rpy="0 0 0" />
      <mass value="0.08745987637442382" />
      <inertia ixx="1.522247415648824e-05" ixy="-6.68204732004394e-08" ixz="-3.289130556805698e-08" iyy="3.202677454783466e-05" iyz="-1.010234294000052e-07" izz="3.28762095334239e-05" />
    </inertial>
  </link>
  <link name="RR_coxa">
    <visual name="coxa_upper_and_hip_saddle">
      <geometry>
        <mesh filename="../../design/single_leg_r7_wide_joints_20260914/output/assembly_mesh/coxa_upper_and_hip_saddle.stl" scale="0.001 0.001 0.001" />
      </geometry>
      <material name="coxa_upper_and_hip_saddle_colour">
        <color rgba="0.22 0.58 0.60 1" />
      </material>
    </visual>
    <visual name="coxa_lower_auxiliary_arm">
      <geometry>
        <mesh filename="../../design/single_leg_r7_wide_joints_20260914/output/assembly_mesh/coxa_lower_auxiliary_arm.stl" scale="0.001 0.001 0.001" />
      </geometry>
      <material name="coxa_lower_auxiliary_arm_colour">
        <color rgba="0.22 0.58 0.60 1" />
      </material>
    </visual>
    <visual name="case_cap_hip">
      <geometry>
        <mesh filename="../../design/single_leg_r7_wide_joints_20260914/output/assembly_mesh/case_cap_hip.stl" scale="0.001 0.001 0.001" />
      </geometry>
      <material name="case_cap_hip_colour">
        <color rgba="0.22 0.58 0.60 1" />
      </material>
    </visual>
    <visual name="servo_hip">
      <geometry>
        <mesh filename="../../design/single_leg_r7_wide_joints_20260914/output/assembly_mesh/servo_hip.stl" scale="0.001 0.001 0.001" />
      </geometry>
      <material name="servo_hip_colour">
        <color rgba="0.18 0.23 0.25 1" />
      </material>
    </visual>
    <visual name="horn_yaw_main">
      <geometry>
        <mesh filename="../../design/single_leg_r7_wide_joints_20260914/output/assembly_mesh/horn_yaw_main.stl" scale="0.001 0.001 0.001" />
      </geometry>
      <material name="horn_yaw_main_colour">
        <color rgba="0.22 0.58 0.60 1" />
      </material>
    </visual>
    <visual name="horn_yaw_auxiliary">
      <geometry>
        <mesh filename="../../design/single_leg_r7_wide_joints_20260914/output/assembly_mesh/horn_yaw_auxiliary.stl" scale="0.001 0.001 0.001" />
      </geometry>
      <material name="horn_yaw_auxiliary_colour">
        <color rgba="0.22 0.58 0.60 1" />
      </material>
    </visual>
    <visual name="yaw_auxiliary_spacer_1">
      <geometry>
        <mesh filename="../../design/single_leg_r7_wide_joints_20260914/output/assembly_mesh/yaw_auxiliary_spacer_1.stl" scale="0.001 0.001 0.001" />
      </geometry>
      <material name="yaw_auxiliary_spacer_1_colour">
        <color rgba="0.22 0.58 0.60 1" />
      </material>
    </visual>
    <visual name="yaw_auxiliary_spacer_2">
      <geometry>
        <mesh filename="../../design/single_leg_r7_wide_joints_20260914/output/assembly_mesh/yaw_auxiliary_spacer_2.stl" scale="0.001 0.001 0.001" />
      </geometry>
      <material name="yaw_auxiliary_spacer_2_colour">
        <color rgba="0.22 0.58 0.60 1" />
      </material>
    </visual>
    <visual name="yaw_auxiliary_spacer_3">
      <geometry>
        <mesh filename="../../design/single_leg_r7_wide_joints_20260914/output/assembly_mesh/yaw_auxiliary_spacer_3.stl" scale="0.001 0.001 0.001" />
      </geometry>
      <material name="yaw_auxiliary_spacer_3_colour">
        <color rgba="0.22 0.58 0.60 1" />
      </material>
    </visual>
    <visual name="yaw_auxiliary_spacer_4">
      <geometry>
        <mesh filename="../../design/single_leg_r7_wide_joints_20260914/output/assembly_mesh/yaw_auxiliary_spacer_4.stl" scale="0.001 0.001 0.001" />
      </geometry>
      <material name="yaw_auxiliary_spacer_4_colour">
        <color rgba="0.22 0.58 0.60 1" />
      </material>
    </visual>
    <collision name="coxa_proxy_0">
      <origin xyz="0.039 0 0" rpy="0 0 0" />
      <geometry>
        <box size="0.078 0.024 0.018" />
      </geometry>
    </collision>
    <collision name="coxa_proxy_1">
      <origin xyz="0.067 0 -0.01" rpy="0 0 0" />
      <geometry>
        <box size="0.055 0.04 0.027" />
      </geometry>
    </collision>
    <inertial>
      <origin xyz="0.05545258777402026 -0.0003262270661361422 -0.007411181974307129" rpy="0 0 0" />
      <mass value="0.116188274378526" />
      <inertia ixx="4.884448832271316e-05" ixy="7.745356217217634e-07" ixz="-3.077386854505764e-05" iyy="0.0001315815648874679" iyz="5.456770085067065e-07" izz="9.845169734911079e-05" />
    </inertial>
  </link>
  <link name="RR_femur">
    <visual name="femur_main_and_knee_saddle">
      <geometry>
        <mesh filename="../../design/single_leg_r7_wide_joints_20260914/output/assembly_mesh/femur_main_and_knee_saddle.stl" scale="0.001 0.001 0.001" />
      </geometry>
      <material name="femur_main_and_knee_saddle_colour">
        <color rgba="0.22 0.58 0.60 1" />
      </material>
    </visual>
    <visual name="femur_auxiliary_cheek">
      <geometry>
        <mesh filename="../../design/single_leg_r7_wide_joints_20260914/output/assembly_mesh/femur_auxiliary_cheek.stl" scale="0.001 0.001 0.001" />
      </geometry>
      <material name="femur_auxiliary_cheek_colour">
        <color rgba="0.22 0.58 0.60 1" />
      </material>
    </visual>
    <visual name="case_cap_knee">
      <geometry>
        <mesh filename="../../design/single_leg_r7_wide_joints_20260914/output/assembly_mesh/case_cap_knee.stl" scale="0.001 0.001 0.001" />
      </geometry>
      <material name="case_cap_knee_colour">
        <color rgba="0.22 0.58 0.60 1" />
      </material>
    </visual>
    <visual name="servo_knee">
      <geometry>
        <mesh filename="../../design/single_leg_r7_wide_joints_20260914/output/assembly_mesh/servo_knee.stl" scale="0.001 0.001 0.001" />
      </geometry>
      <material name="servo_knee_colour">
        <color rgba="0.18 0.23 0.25 1" />
      </material>
    </visual>
    <visual name="horn_hip_main">
      <geometry>
        <mesh filename="../../design/single_leg_r7_wide_joints_20260914/output/assembly_mesh/horn_hip_main.stl" scale="0.001 0.001 0.001" />
      </geometry>
      <material name="horn_hip_main_colour">
        <color rgba="0.22 0.58 0.60 1" />
      </material>
    </visual>
    <visual name="horn_hip_auxiliary">
      <geometry>
        <mesh filename="../../design/single_leg_r7_wide_joints_20260914/output/assembly_mesh/horn_hip_auxiliary.stl" scale="0.001 0.001 0.001" />
      </geometry>
      <material name="horn_hip_auxiliary_colour">
        <color rgba="0.22 0.58 0.60 1" />
      </material>
    </visual>
    <collision name="femur_proxy_0">
      <origin xyz="0.043 0 0" rpy="0 0 0" />
      <geometry>
        <box size="0.08599999999999999 0.024 0.018" />
      </geometry>
    </collision>
    <collision name="femur_proxy_1">
      <origin xyz="0.075 0 0.01" rpy="0 0 0" />
      <geometry>
        <box size="0.047 0.041 0.027" />
      </geometry>
    </collision>
    <inertial>
      <origin xyz="0.06336517604261289 -0.001298314040615189 0.001934967497040738" rpy="0 0 0" />
      <mass value="0.1249160158306359" />
      <inertia ixx="3.802203223109219e-05" ixy="-3.321671674319615e-06" ixz="-3.950552346680719e-07" iyy="0.000113452612881376" iyz="3.848976942245111e-07" izz="0.0001232966723477869" />
    </inertial>
  </link>
  <link name="RR_tibia">
    <visual name="tibia_curved_main_and_foot">
      <geometry>
        <mesh filename="../../design/single_leg_r7_wide_joints_20260914/output/assembly_mesh/tibia_curved_main_and_foot.stl" scale="0.001 0.001 0.001" />
      </geometry>
      <material name="tibia_curved_main_and_foot_colour">
        <color rgba="0.22 0.58 0.60 1" />
      </material>
    </visual>
    <visual name="tibia_auxiliary_cheek">
      <geometry>
        <mesh filename="../../design/single_leg_r7_wide_joints_20260914/output/assembly_mesh/tibia_auxiliary_cheek.stl" scale="0.001 0.001 0.001" />
      </geometry>
      <material name="tibia_auxiliary_cheek_colour">
        <color rgba="0.22 0.58 0.60 1" />
      </material>
    </visual>
    <visual name="horn_knee_main">
      <geometry>
        <mesh filename="../../design/single_leg_r7_wide_joints_20260914/output/assembly_mesh/horn_knee_main.stl" scale="0.001 0.001 0.001" />
      </geometry>
      <material name="horn_knee_main_colour">
        <color rgba="0.22 0.58 0.60 1" />
      </material>
    </visual>
    <visual name="horn_knee_auxiliary">
      <geometry>
        <mesh filename="../../design/single_leg_r7_wide_joints_20260914/output/assembly_mesh/horn_knee_auxiliary.stl" scale="0.001 0.001 0.001" />
      </geometry>
      <material name="horn_knee_auxiliary_colour">
        <color rgba="0.22 0.58 0.60 1" />
      </material>
    </visual>
    <collision name="tibia_proxy_0">
      <origin xyz="0.048 0 0" rpy="0 0 0" />
      <geometry>
        <box size="0.092 0.017 0.014" />
      </geometry>
    </collision>
    <inertial>
      <origin xyz="0.0414753995760796 -0.001694745710956234 0.0002991704986421671" rpy="0 0 0" />
      <mass value="0.04930491667511244" />
      <inertia ixx="1.341332884585064e-05" ixy="-1.987778173156809e-06" ixz="3.685225617944397e-07" iyy="4.556212902457954e-05" iyz="3.336425043941025e-08" izz="5.547369214215767e-05" />
    </inertial>
  </link>
  <joint name="RR_mount" type="fixed">
    <parent link="body" />
    <child link="RR_base_mount" />
    <origin xyz="-0.05303300858899106 -0.05303300858899106 0.038" rpy="0 0 -2.356194490192345" />
  </joint>
  <joint name="RR_yaw" type="revolute">
    <parent link="RR_base_mount" />
    <child link="RR_coxa" />
    <origin xyz="0 0 0" rpy="0 0 0" />
    <axis xyz="0 0 1" />
    <limit lower="-0.9599310885968813" upper="0.9599310885968813" effort="0.588" velocity="4.717" />
    <dynamics damping="0.015" friction="0.0" />
  </joint>
  <joint name="RR_hip" type="revolute">
    <parent link="RR_coxa" />
    <child link="RR_femur" />
    <origin xyz=".082 0 0" rpy="0 0 0" />
    <axis xyz="0 1 0" />
    <limit lower="-0.5235987755982988" upper="1.1344640137963142" effort="0.588" velocity="4.717" />
    <dynamics damping="0.015" friction="0.0" />
  </joint>
  <joint name="RR_knee" type="revolute">
    <parent link="RR_femur" />
    <child link="RR_tibia" />
    <origin xyz=".090 0 0" rpy="0 0 0" />
    <axis xyz="0 1 0" />
    <limit lower="0.08726646259971647" upper="2.007128639793479" effort="0.588" velocity="4.717" />
    <dynamics damping="0.015" friction="0.0" />
  </joint>
  <link name="RR_toe">
    <inertial>
      <origin xyz="0 0 0" rpy="0 0 0" />
      <mass value="0" />
      <inertia ixx="0" ixy="0" ixz="0" iyy="0" iyz="0" izz="0" />
    </inertial>
    <collision name="RR_toe_sphere">
      <origin xyz="0 0 0" rpy="0 0 0" />
      <geometry>
        <sphere radius="0.005" />
      </geometry>
    </collision>
    <visual name="RR_toe_contact">
      <origin xyz="0 0 0" rpy="0 0 0" />
      <geometry>
        <sphere radius="0.005" />
      </geometry>
      <material name="RR_toe_contact_material">
        <color rgba="0.15 0.15 0.15 1" />
      </material>
    </visual>
  </link>
  <joint name="RR_toe_fixed" type="fixed">
    <parent link="RR_tibia" />
    <child link="RR_toe" />
    <origin xyz="0.105 0 0" rpy="0 0 0" />
  </joint>
  <link name="phone">
    <inertial>
      <origin xyz="0 0 0" rpy="0 0 0" />
      <mass value="0.155" />
      <inertia ixx="0.0003452172916666666" ixy="0" ixz="0" iyy="6.491596979166666e-05" iyz="0" izz="0.0002817351364583333" />
    </inertial>
    <visual name="phone_estimate">
      <origin xyz="0 0 0" rpy="0 0 0" />
      <geometry>
        <box size="0.00745 0.1475 0.07049999999999999" />
      </geometry>
      <material name="phone_estimate_material">
        <color rgba="0.05 0.05 0.07000000000000001 1" />
      </material>
    </visual>
    <collision name="phone_proxy">
      <origin xyz="0 0 0" rpy="0 0 0" />
      <geometry>
        <box size="0.00745 0.1475 0.07049999999999999" />
      </geometry>
    </collision>
  </link>
  <joint name="phone_mount" type="fixed">
    <parent link="body" />
    <child link="phone" />
    <origin xyz="0.003725 0 0.15125" rpy="0 0 0" />
  </joint>
</robot>
