silmoon04/mist-robot/design/hexapod_phone_quad_20260912/simulation/output/quadruped.urdf

<?xml version='1.0' encoding='utf-8'?>
<robot name="video_reference_phone_quadruped">
  <link name="base">
    <inertial>
      <origin xyz="-0.00134007060328 0.00111831642493 0.020083946829" rpy="0 0 0" />
      <mass value="1.2155465570378146" />
      <inertia ixx="0.002760981514793024" iyy="0.003024842331030948" izz="0.0038641727971708917" ixy="-1.8216459873550134e-06" ixz="5.8571458243537915e-05" iyz="8.86885007022687e-06" />
    </inertial>
    <visual>
      <origin xyz="0 0 0" rpy="0 0 0" />
      <geometry>
        <mesh filename="../../cad/output/links/base.stl" scale="0.001 0.001 0.001" />
      </geometry>
      <material name="material_base">
        <color rgba="0.16 0.20 0.24 1" />
      </material>
    </visual>
    <collision>
      <origin xyz="0 0 0.01" rpy="0 0 0" />
      <geometry>
        <box size="0.14 0.14 0.05" />
      </geometry>
    </collision>
  </link>
  <link name="coxa_FL">
    <inertial>
      <origin xyz="0.0498189056857 -0.00056399892237 -0.00444048616271" rpy="0 0 0" />
      <mass value="0.1012116907542061" />
      <inertia ixx="3.0702592970635096e-05" iyy="8.133088509243036e-05" izz="6.459088485286042e-05" ixy="4.85923645282171e-07" ixz="-1.4243672240157788e-05" iyz="-5.317915354945925e-09" />
    </inertial>
    <visual>
      <origin xyz="0 0 0" rpy="0 0 0" />
      <geometry>
        <mesh filename="../../cad/output/links/coxa_FL.stl" scale="0.001 0.001 0.001" />
      </geometry>
      <material name="material_coxa_FL">
        <color rgba="0.14 0.47 0.53 1" />
      </material>
    </visual>
    <collision>
      <origin xyz="0.025 0 0" rpy="0 0 0" />
      <geometry>
        <box size="0.05 0.018 0.022" />
      </geometry>
    </collision>
  </link>
  <link name="femur_FL">
    <inertial>
      <origin xyz="0.0808941894369 -0.000466650883114 -0.000463944370934" rpy="0 0 0" />
      <mass value="0.10916491567403029" />
      <inertia ixx="2.7068938968074198e-05" iyy="0.00014815813817048104" izz="0.0001576268415357868" ixy="1.4143934124205571e-06" ixz="-4.544348128687383e-07" iyz="-2.1826644865971573e-07" />
    </inertial>
    <visual>
      <origin xyz="0 0 0" rpy="0 0 0" />
      <geometry>
        <mesh filename="../../cad/output/links/femur_FL.stl" scale="0.001 0.001 0.001" />
      </geometry>
      <material name="material_femur_FL">
        <color rgba="0.14 0.47 0.53 1" />
      </material>
    </visual>
    <collision>
      <origin xyz="0.045 0 0" rpy="0 0 0" />
      <geometry>
        <box size="0.09 0.018 0.018" />
      </geometry>
    </collision>
  </link>
  <link name="tibia_FL">
    <inertial>
      <origin xyz="0.0439002148923 6.14814655733e-05 0.00931966359116" rpy="0 0 0" />
      <mass value="0.034618031504977526" />
      <inertia ixx="1.0646460514442463e-05" iyy="4.237179167911499e-05" izz="4.7449792660901834e-05" ixy="2.460676303483196e-07" ixz="-3.175735337559154e-06" iyz="7.422255656688876e-08" />
    </inertial>
    <visual>
      <origin xyz="0 0 0" rpy="0 0 0" />
      <geometry>
        <mesh filename="../../cad/output/links/tibia_FL.stl" scale="0.001 0.001 0.001" />
      </geometry>
      <material name="material_tibia_FL">
        <color rgba="0.14 0.47 0.53 1" />
      </material>
    </visual>
    <collision>
      <origin xyz="0.0465 0 0" rpy="0 0 0" />
      <geometry>
        <box size="0.093 0.015 0.015" />
      </geometry>
    </collision>
    <collision>
      <origin xyz="0.105 0 0" rpy="1.57079632679 0 0" />
      <geometry>
        <cylinder radius="0.005" length="0.014" />
      </geometry>
    </collision>
  </link>
  <link name="coxa_FR">
    <inertial>
      <origin xyz="0.0498189056857 -0.00056399892237 -0.00444048616271" rpy="0 0 0" />
      <mass value="0.1012116907542061" />
      <inertia ixx="3.0702592970635096e-05" iyy="8.133088509243036e-05" izz="6.459088485286042e-05" ixy="4.85923645282171e-07" ixz="-1.4243672240157788e-05" iyz="-5.317915354945925e-09" />
    </inertial>
    <visual>
      <origin xyz="0 0 0" rpy="0 0 0" />
      <geometry>
        <mesh filename="../../cad/output/links/coxa_FR.stl" scale="0.001 0.001 0.001" />
      </geometry>
      <material name="material_coxa_FR">
        <color rgba="0.14 0.47 0.53 1" />
      </material>
    </visual>
    <collision>
      <origin xyz="0.025 0 0" rpy="0 0 0" />
      <geometry>
        <box size="0.05 0.018 0.022" />
      </geometry>
    </collision>
  </link>
  <link name="femur_FR">
    <inertial>
      <origin xyz="0.0808941894369 -0.000466650883114 -0.000463944370934" rpy="0 0 0" />
      <mass value="0.10916491567403029" />
      <inertia ixx="2.7068938968074198e-05" iyy="0.00014815813817048104" izz="0.0001576268415357868" ixy="1.4143934124205571e-06" ixz="-4.544348128687383e-07" iyz="-2.1826644865971573e-07" />
    </inertial>
    <visual>
      <origin xyz="0 0 0" rpy="0 0 0" />
      <geometry>
        <mesh filename="../../cad/output/links/femur_FR.stl" scale="0.001 0.001 0.001" />
      </geometry>
      <material name="material_femur_FR">
        <color rgba="0.14 0.47 0.53 1" />
      </material>
    </visual>
    <collision>
      <origin xyz="0.045 0 0" rpy="0 0 0" />
      <geometry>
        <box size="0.09 0.018 0.018" />
      </geometry>
    </collision>
  </link>
  <link name="tibia_FR">
    <inertial>
      <origin xyz="0.0439002148923 6.14814655733e-05 0.00931966359116" rpy="0 0 0" />
      <mass value="0.034618031504977526" />
      <inertia ixx="1.0646460514442463e-05" iyy="4.237179167911499e-05" izz="4.7449792660901834e-05" ixy="2.460676303483196e-07" ixz="-3.175735337559154e-06" iyz="7.422255656688876e-08" />
    </inertial>
    <visual>
      <origin xyz="0 0 0" rpy="0 0 0" />
      <geometry>
        <mesh filename="../../cad/output/links/tibia_FR.stl" scale="0.001 0.001 0.001" />
      </geometry>
      <material name="material_tibia_FR">
        <color rgba="0.14 0.47 0.53 1" />
      </material>
    </visual>
    <collision>
      <origin xyz="0.0465 0 0" rpy="0 0 0" />
      <geometry>
        <box size="0.093 0.015 0.015" />
      </geometry>
    </collision>
    <collision>
      <origin xyz="0.105 0 0" rpy="1.57079632679 0 0" />
      <geometry>
        <cylinder radius="0.005" length="0.014" />
      </geometry>
    </collision>
  </link>
  <link name="coxa_RL">
    <inertial>
      <origin xyz="0.0498189056857 -0.00056399892237 -0.00444048616271" rpy="0 0 0" />
      <mass value="0.1012116907542061" />
      <inertia ixx="3.0702592970635096e-05" iyy="8.133088509243036e-05" izz="6.459088485286042e-05" ixy="4.85923645282171e-07" ixz="-1.4243672240157788e-05" iyz="-5.317915354945925e-09" />
    </inertial>
    <visual>
      <origin xyz="0 0 0" rpy="0 0 0" />
      <geometry>
        <mesh filename="../../cad/output/links/coxa_RL.stl" scale="0.001 0.001 0.001" />
      </geometry>
      <material name="material_coxa_RL">
        <color rgba="0.14 0.47 0.53 1" />
      </material>
    </visual>
    <collision>
      <origin xyz="0.025 0 0" rpy="0 0 0" />
      <geometry>
        <box size="0.05 0.018 0.022" />
      </geometry>
    </collision>
  </link>
  <link name="femur_RL">
    <inertial>
      <origin xyz="0.0808941894369 -0.000466650883114 -0.000463944370934" rpy="0 0 0" />
      <mass value="0.10916491567403029" />
      <inertia ixx="2.7068938968074198e-05" iyy="0.00014815813817048104" izz="0.0001576268415357868" ixy="1.4143934124205571e-06" ixz="-4.544348128687383e-07" iyz="-2.1826644865971573e-07" />
    </inertial>
    <visual>
      <origin xyz="0 0 0" rpy="0 0 0" />
      <geometry>
        <mesh filename="../../cad/output/links/femur_RL.stl" scale="0.001 0.001 0.001" />
      </geometry>
      <material name="material_femur_RL">
        <color rgba="0.14 0.47 0.53 1" />
      </material>
    </visual>
    <collision>
      <origin xyz="0.045 0 0" rpy="0 0 0" />
      <geometry>
        <box size="0.09 0.018 0.018" />
      </geometry>
    </collision>
  </link>
  <link name="tibia_RL">
    <inertial>
      <origin xyz="0.0439002148923 6.14814655733e-05 0.00931966359116" rpy="0 0 0" />
      <mass value="0.034618031504977526" />
      <inertia ixx="1.0646460514442463e-05" iyy="4.237179167911499e-05" izz="4.7449792660901834e-05" ixy="2.460676303483196e-07" ixz="-3.175735337559154e-06" iyz="7.422255656688876e-08" />
    </inertial>
    <visual>
      <origin xyz="0 0 0" rpy="0 0 0" />
      <geometry>
        <mesh filename="../../cad/output/links/tibia_RL.stl" scale="0.001 0.001 0.001" />
      </geometry>
      <material name="material_tibia_RL">
        <color rgba="0.14 0.47 0.53 1" />
      </material>
    </visual>
    <collision>
      <origin xyz="0.0465 0 0" rpy="0 0 0" />
      <geometry>
        <box size="0.093 0.015 0.015" />
      </geometry>
    </collision>
    <collision>
      <origin xyz="0.105 0 0" rpy="1.57079632679 0 0" />
      <geometry>
        <cylinder radius="0.005" length="0.014" />
      </geometry>
    </collision>
  </link>
  <link name="coxa_RR">
    <inertial>
      <origin xyz="0.0498189056857 -0.00056399892237 -0.00444048616271" rpy="0 0 0" />
      <mass value="0.1012116907542061" />
      <inertia ixx="3.0702592970635096e-05" iyy="8.133088509243036e-05" izz="6.459088485286042e-05" ixy="4.85923645282171e-07" ixz="-1.4243672240157788e-05" iyz="-5.317915354945925e-09" />
    </inertial>
    <visual>
      <origin xyz="0 0 0" rpy="0 0 0" />
      <geometry>
        <mesh filename="../../cad/output/links/coxa_RR.stl" scale="0.001 0.001 0.001" />
      </geometry>
      <material name="material_coxa_RR">
        <color rgba="0.14 0.47 0.53 1" />
      </material>
    </visual>
    <collision>
      <origin xyz="0.025 0 0" rpy="0 0 0" />
      <geometry>
        <box size="0.05 0.018 0.022" />
      </geometry>
    </collision>
  </link>
  <link name="femur_RR">
    <inertial>
      <origin xyz="0.0808941894369 -0.000466650883114 -0.000463944370934" rpy="0 0 0" />
      <mass value="0.10916491567403029" />
      <inertia ixx="2.7068938968074198e-05" iyy="0.00014815813817048104" izz="0.0001576268415357868" ixy="1.4143934124205571e-06" ixz="-4.544348128687383e-07" iyz="-2.1826644865971573e-07" />
    </inertial>
    <visual>
      <origin xyz="0 0 0" rpy="0 0 0" />
      <geometry>
        <mesh filename="../../cad/output/links/femur_RR.stl" scale="0.001 0.001 0.001" />
      </geometry>
      <material name="material_femur_RR">
        <color rgba="0.14 0.47 0.53 1" />
      </material>
    </visual>
    <collision>
      <origin xyz="0.045 0 0" rpy="0 0 0" />
      <geometry>
        <box size="0.09 0.018 0.018" />
      </geometry>
    </collision>
  </link>
  <link name="tibia_RR">
    <inertial>
      <origin xyz="0.0439002148923 6.14814655733e-05 0.00931966359116" rpy="0 0 0" />
      <mass value="0.034618031504977526" />
      <inertia ixx="1.0646460514442463e-05" iyy="4.237179167911499e-05" izz="4.7449792660901834e-05" ixy="2.460676303483196e-07" ixz="-3.175735337559154e-06" iyz="7.422255656688876e-08" />
    </inertial>
    <visual>
      <origin xyz="0 0 0" rpy="0 0 0" />
      <geometry>
        <mesh filename="../../cad/output/links/tibia_RR.stl" scale="0.001 0.001 0.001" />
      </geometry>
      <material name="material_tibia_RR">
        <color rgba="0.14 0.47 0.53 1" />
      </material>
    </visual>
    <collision>
      <origin xyz="0.0465 0 0" rpy="0 0 0" />
      <geometry>
        <box size="0.093 0.015 0.015" />
      </geometry>
    </collision>
    <collision>
      <origin xyz="0.105 0 0" rpy="1.57079632679 0 0" />
      <geometry>
        <cylinder radius="0.005" length="0.014" />
      </geometry>
    </collision>
  </link>
  <link name="phone_pan">
    <inertial>
      <origin xyz="0.0026726664176 2.4495474879e-18 0.0462230710967" rpy="0 0 0" />
      <mass value="0.21546668473890546" />
      <inertia ixx="0.0005377515347052381" iyy="0.0001416731880522004" izz="0.00040648797578297826" ixy="8.787982507335151e-22" ixz="-6.8750134763136804e-06" iyz="1.7969374173261036e-20" />
    </inertial>
    <visual>
      <origin xyz="0 0 0" rpy="0 0 0" />
      <geometry>
        <mesh filename="../../cad/output/links/phone_pan.stl" scale="0.001 0.001 0.001" />
      </geometry>
      <material name="material_phone_pan">
        <color rgba="0.86 0.57 0.12 1" />
      </material>
    </visual>
    <collision>
      <origin xyz="0.003725 0 0.05325" rpy="0 0 0" />
      <geometry>
        <box size="0.00745 0.1475 0.0705" />
      </geometry>
    </collision>
  </link>
  <joint name="yaw_FL" type="revolute">
    <parent link="base" />
    <child link="coxa_FL" />
    <origin xyz="0.053033008589 0.053033008589 0.036" rpy="0 0 0.785398163397" />
    <axis xyz="0 0 1" />
    <limit lower="-0.4363323129985824" upper="0.4363323129985824" effort="0.588" velocity="1.0" />
    <dynamics damping="0.003" friction="0.0" />
  </joint>
  <joint name="hip_FL" type="revolute">
    <parent link="coxa_FL" />
    <child link="femur_FL" />
    <origin xyz="0.05 0 0" rpy="0 0 0" />
    <axis xyz="0 1 0" />
    <limit lower="0.05235987755982989" upper="0.6108652381980153" effort="0.588" velocity="1.0" />
    <dynamics damping="0.003" friction="0.0" />
  </joint>
  <joint name="knee_FL" type="revolute">
    <parent link="femur_FL" />
    <child link="tibia_FL" />
    <origin xyz="0.09 0 0" rpy="0 0 0" />
    <axis xyz="0 1 0" />
    <limit lower="0.5235987755982988" upper="1.7453292519943295" effort="0.588" velocity="1.0" />
    <dynamics damping="0.003" friction="0.0" />
  </joint>
  <joint name="yaw_FR" type="revolute">
    <parent link="base" />
    <child link="coxa_FR" />
    <origin xyz="0.053033008589 -0.053033008589 0.036" rpy="0 0 -0.785398163397" />
    <axis xyz="0 0 1" />
    <limit lower="-0.4363323129985824" upper="0.4363323129985824" effort="0.588" velocity="1.0" />
    <dynamics damping="0.003" friction="0.0" />
  </joint>
  <joint name="hip_FR" type="revolute">
    <parent link="coxa_FR" />
    <child link="femur_FR" />
    <origin xyz="0.05 0 0" rpy="0 0 0" />
    <axis xyz="0 1 0" />
    <limit lower="0.05235987755982989" upper="0.6108652381980153" effort="0.588" velocity="1.0" />
    <dynamics damping="0.003" friction="0.0" />
  </joint>
  <joint name="knee_FR" type="revolute">
    <parent link="femur_FR" />
    <child link="tibia_FR" />
    <origin xyz="0.09 0 0" rpy="0 0 0" />
    <axis xyz="0 1 0" />
    <limit lower="0.5235987755982988" upper="1.7453292519943295" effort="0.588" velocity="1.0" />
    <dynamics damping="0.003" friction="0.0" />
  </joint>
  <joint name="yaw_RL" type="revolute">
    <parent link="base" />
    <child link="coxa_RL" />
    <origin xyz="-0.053033008589 0.053033008589 0.036" rpy="0 0 2.35619449019" />
    <axis xyz="0 0 1" />
    <limit lower="-0.4363323129985824" upper="0.4363323129985824" effort="0.588" velocity="1.0" />
    <dynamics damping="0.003" friction="0.0" />
  </joint>
  <joint name="hip_RL" type="revolute">
    <parent link="coxa_RL" />
    <child link="femur_RL" />
    <origin xyz="0.05 0 0" rpy="0 0 0" />
    <axis xyz="0 1 0" />
    <limit lower="0.05235987755982989" upper="0.6108652381980153" effort="0.588" velocity="1.0" />
    <dynamics damping="0.003" friction="0.0" />
  </joint>
  <joint name="knee_RL" type="revolute">
    <parent link="femur_RL" />
    <child link="tibia_RL" />
    <origin xyz="0.09 0 0" rpy="0 0 0" />
    <axis xyz="0 1 0" />
    <limit lower="0.5235987755982988" upper="1.7453292519943295" effort="0.588" velocity="1.0" />
    <dynamics damping="0.003" friction="0.0" />
  </joint>
  <joint name="yaw_RR" type="revolute">
    <parent link="base" />
    <child link="coxa_RR" />
    <origin xyz="-0.053033008589 -0.053033008589 0.036" rpy="0 0 -2.35619449019" />
    <axis xyz="0 0 1" />
    <limit lower="-0.4363323129985824" upper="0.4363323129985824" effort="0.588" velocity="1.0" />
    <dynamics damping="0.003" friction="0.0" />
  </joint>
  <joint name="hip_RR" type="revolute">
    <parent link="coxa_RR" />
    <child link="femur_RR" />
    <origin xyz="0.05 0 0" rpy="0 0 0" />
    <axis xyz="0 1 0" />
    <limit lower="0.05235987755982989" upper="0.6108652381980153" effort="0.588" velocity="1.0" />
    <dynamics damping="0.003" friction="0.0" />
  </joint>
  <joint name="knee_RR" type="revolute">
    <parent link="femur_RR" />
    <child link="tibia_RR" />
    <origin xyz="0.09 0 0" rpy="0 0 0" />
    <axis xyz="0 1 0" />
    <limit lower="0.5235987755982988" upper="1.7453292519943295" effort="0.588" velocity="1.0" />
    <dynamics damping="0.003" friction="0.0" />
  </joint>
  <joint name="phone_pan" type="continuous">
    <parent link="base" />
    <child link="phone_pan" />
    <origin xyz="0 0 0.098" rpy="0 0 0" />
    <axis xyz="0 0 1" />
    <limit effort="0.588" velocity="1.0" />
    <dynamics damping="0.003" friction="0.0" />
  </joint>
</robot>
