silmoon04/mist-robot/design/mist_v2_20260906/simulation/cad_mass_20260907/mass_only_candidate.urdf

<?xml version='1.0' encoding='utf-8'?>
<robot name="mist_v2_engineering_candidate">
  <link name="base_link">
    <inertial>
      <origin xyz="0.00332334254 1.464693721e-06 0.03320864763" />
      <mass value="2.497144615750418" />
      <inertia ixx="0.01148689627851007" iyy="0.012851937057630578" izz="0.009283857166790676" ixy="0" ixz="0" iyz="0" />
    </inertial>
    <visual>
      <origin xyz="0 0 0.075" rpy="0 0 0" />
      <geometry>
        <cylinder radius="0.09" length="0.22" />
      </geometry>
      <material name="base_link_material">
        <color rgba="0.83 0.8 0.73 1" />
      </material>
    </visual>
    <collision>
      <origin xyz="0 0 0.075" rpy="0 0 0" />
      <geometry>
        <cylinder radius="0.09" length="0.22" />
      </geometry>
    </collision>
  </link>
  <link name="FL_yaw">
    <inertial>
      <origin xyz="0.0175 0.015 0" />
      <mass value="0.43185924208629095" />
      <inertia ixx="0.00020243401972794888" iyy="0.0002249266885866099" izz="0.0002816082141104356" ixy="0" ixz="0" iyz="0" />
    </inertial>
    <visual>
      <origin xyz="0.0175 0.015 0" rpy="0 0 0" />
      <geometry>
        <box size="0.065 0.06 0.045" />
      </geometry>
      <material name="FL_yaw_material">
        <color rgba="0.25 0.27 0.28 1" />
      </material>
    </visual>
    <collision>
      <origin xyz="0.0175 0.015 0" rpy="0 0 0" />
      <geometry>
        <box size="0.065 0.06 0.045" />
      </geometry>
    </collision>
  </link>
  <joint name="FL_q1_yaw" type="revolute">
    <parent link="base_link" />
    <child link="FL_yaw" />
    <origin xyz="0.07283199846 0.07283199846 0" rpy="0 0 0.7853981634" />
    <axis xyz="0 0 1" />
    <limit lower="-1.7453292519943295" upper="1.7453292519943295" effort="20" velocity="20" />
    <dynamics damping="0" friction="0" />
  </joint>
  <link name="FL_femur">
    <inertial>
      <origin xyz="0 0 -0.06975" />
      <mass value="0.1715272545917623" />
      <inertia ixx="0.00028639691290118316" iyy="0.0002827948405547562" izz="1.2864544094382171e-05" ixy="0" ixz="0" iyz="0" />
    </inertial>
    <visual>
      <origin xyz="0 0 -0.06975" rpy="0 0 0" />
      <geometry>
        <box size="0.018 0.024 0.1395" />
      </geometry>
      <material name="FL_femur_material">
        <color rgba="0.68 0.7 0.67 1" />
      </material>
    </visual>
    <collision>
      <origin xyz="0 0 -0.06975" rpy="0 0 0" />
      <geometry>
        <box size="0.018 0.024 0.1395" />
      </geometry>
    </collision>
  </link>
  <joint name="FL_q2_hip" type="revolute">
    <parent link="FL_yaw" />
    <child link="FL_femur" />
    <origin xyz="0.035 0.03 0" rpy="0 0 0" />
    <axis xyz="0 -1 0" />
    <limit lower="-0.6981317007977318" upper="2.181661564992912" effort="20" velocity="20" />
    <dynamics damping="0" friction="0" />
  </joint>
  <link name="FL_tibia">
    <inertial>
      <origin xyz="0 0 -0.09551791951" />
      <mass value="0.27304913299150024" />
      <inertia ixx="0.0003976505540132882" iyy="0.00039191652222046676" izz="2.0478684974362515e-05" ixy="0" ixz="0" iyz="0" />
    </inertial>
    <visual>
      <origin xyz="0 0 -0.065" rpy="0 0 0" />
      <geometry>
        <box size="0.018 0.024 0.13" />
      </geometry>
      <material name="FL_tibia_material">
        <color rgba="0.68 0.7 0.67 1" />
      </material>
    </visual>
    <collision>
      <origin xyz="0 0 -0.065" rpy="0 0 0" />
      <geometry>
        <box size="0.018 0.024 0.13" />
      </geometry>
    </collision>
  </link>
  <joint name="FL_q3_knee" type="revolute">
    <parent link="FL_femur" />
    <child link="FL_tibia" />
    <origin xyz="0 0 -0.1395" rpy="0 0 0" />
    <axis xyz="0 -1 0" />
    <limit lower="-2.6179938779914944" upper="-0.2617993877991494" effort="20" velocity="20" />
    <dynamics damping="0" friction="0" />
  </joint>
  <link name="FL_wheel">
    <inertial>
      <origin xyz="0 0 0" />
      <mass value="0.08454368068314383" />
      <inertia ixx="4.223485248127304e-05" iyy="7.635351161696428e-05" izz="4.223485248127304e-05" ixy="0" ixz="0" iyz="0" />
    </inertial>
    <visual>
      <origin xyz="0 0 0" rpy="1.570796327 0 0" />
      <geometry>
        <cylinder radius="0.0425" length="0.024" />
      </geometry>
      <material name="FL_wheel_material">
        <color rgba="0.12 0.13 0.13 1" />
      </material>
    </visual>
    <collision>
      <origin xyz="0 0 0" rpy="1.570796327 0 0" />
      <geometry>
        <cylinder radius="0.0425" length="0.024" />
      </geometry>
    </collision>
  </link>
  <joint name="FL_wheel_drive" type="continuous">
    <parent link="FL_tibia" />
    <child link="FL_wheel" />
    <origin xyz="0 0 -0.13" rpy="0 0 0" />
    <axis xyz="0 -1 0" />
    <dynamics damping="0" friction="0" />
  </joint>
  <link name="FR_yaw">
    <inertial>
      <origin xyz="0.0175 -0.015 0" />
      <mass value="0.43185924208629095" />
      <inertia ixx="0.00020243401972794888" iyy="0.0002249266885866099" izz="0.0002816082141104356" ixy="0" ixz="0" iyz="0" />
    </inertial>
    <visual>
      <origin xyz="0.0175 -0.015 0" rpy="0 0 0" />
      <geometry>
        <box size="0.065 0.06 0.045" />
      </geometry>
      <material name="FR_yaw_material">
        <color rgba="0.25 0.27 0.28 1" />
      </material>
    </visual>
    <collision>
      <origin xyz="0.0175 -0.015 0" rpy="0 0 0" />
      <geometry>
        <box size="0.065 0.06 0.045" />
      </geometry>
    </collision>
  </link>
  <joint name="FR_q1_yaw" type="revolute">
    <parent link="base_link" />
    <child link="FR_yaw" />
    <origin xyz="0.07283199846 -0.07283199846 0" rpy="0 0 -0.7853981634" />
    <axis xyz="0 0 1" />
    <limit lower="-1.7453292519943295" upper="1.7453292519943295" effort="20" velocity="20" />
    <dynamics damping="0" friction="0" />
  </joint>
  <link name="FR_femur">
    <inertial>
      <origin xyz="0 0 -0.06975" />
      <mass value="0.1715272545917623" />
      <inertia ixx="0.00028639691290118316" iyy="0.0002827948405547562" izz="1.2864544094382171e-05" ixy="0" ixz="0" iyz="0" />
    </inertial>
    <visual>
      <origin xyz="0 0 -0.06975" rpy="0 0 0" />
      <geometry>
        <box size="0.018 0.024 0.1395" />
      </geometry>
      <material name="FR_femur_material">
        <color rgba="0.68 0.7 0.67 1" />
      </material>
    </visual>
    <collision>
      <origin xyz="0 0 -0.06975" rpy="0 0 0" />
      <geometry>
        <box size="0.018 0.024 0.1395" />
      </geometry>
    </collision>
  </link>
  <joint name="FR_q2_hip" type="revolute">
    <parent link="FR_yaw" />
    <child link="FR_femur" />
    <origin xyz="0.035 -0.03 0" rpy="0 0 0" />
    <axis xyz="0 -1 0" />
    <limit lower="-0.6981317007977318" upper="2.181661564992912" effort="20" velocity="20" />
    <dynamics damping="0" friction="0" />
  </joint>
  <link name="FR_tibia">
    <inertial>
      <origin xyz="0 0 -0.09551791951" />
      <mass value="0.27304913299150024" />
      <inertia ixx="0.0003976505540132882" iyy="0.00039191652222046676" izz="2.0478684974362515e-05" ixy="0" ixz="0" iyz="0" />
    </inertial>
    <visual>
      <origin xyz="0 0 -0.065" rpy="0 0 0" />
      <geometry>
        <box size="0.018 0.024 0.13" />
      </geometry>
      <material name="FR_tibia_material">
        <color rgba="0.68 0.7 0.67 1" />
      </material>
    </visual>
    <collision>
      <origin xyz="0 0 -0.065" rpy="0 0 0" />
      <geometry>
        <box size="0.018 0.024 0.13" />
      </geometry>
    </collision>
  </link>
  <joint name="FR_q3_knee" type="revolute">
    <parent link="FR_femur" />
    <child link="FR_tibia" />
    <origin xyz="0 0 -0.1395" rpy="0 0 0" />
    <axis xyz="0 -1 0" />
    <limit lower="-2.6179938779914944" upper="-0.2617993877991494" effort="20" velocity="20" />
    <dynamics damping="0" friction="0" />
  </joint>
  <link name="FR_wheel">
    <inertial>
      <origin xyz="0 0 0" />
      <mass value="0.08454368068314383" />
      <inertia ixx="4.223485248127304e-05" iyy="7.635351161696428e-05" izz="4.223485248127304e-05" ixy="0" ixz="0" iyz="0" />
    </inertial>
    <visual>
      <origin xyz="0 0 0" rpy="1.570796327 0 0" />
      <geometry>
        <cylinder radius="0.0425" length="0.024" />
      </geometry>
      <material name="FR_wheel_material">
        <color rgba="0.12 0.13 0.13 1" />
      </material>
    </visual>
    <collision>
      <origin xyz="0 0 0" rpy="1.570796327 0 0" />
      <geometry>
        <cylinder radius="0.0425" length="0.024" />
      </geometry>
    </collision>
  </link>
  <joint name="FR_wheel_drive" type="continuous">
    <parent link="FR_tibia" />
    <child link="FR_wheel" />
    <origin xyz="0 0 -0.13" rpy="0 0 0" />
    <axis xyz="0 -1 0" />
    <dynamics damping="0" friction="0" />
  </joint>
  <link name="RL_yaw">
    <inertial>
      <origin xyz="0.0175 -0.015 0" />
      <mass value="0.43185924208629095" />
      <inertia ixx="0.00020243401972794888" iyy="0.0002249266885866099" izz="0.0002816082141104356" ixy="0" ixz="0" iyz="0" />
    </inertial>
    <visual>
      <origin xyz="0.0175 -0.015 0" rpy="0 0 0" />
      <geometry>
        <box size="0.065 0.06 0.045" />
      </geometry>
      <material name="RL_yaw_material">
        <color rgba="0.25 0.27 0.28 1" />
      </material>
    </visual>
    <collision>
      <origin xyz="0.0175 -0.015 0" rpy="0 0 0" />
      <geometry>
        <box size="0.065 0.06 0.045" />
      </geometry>
    </collision>
  </link>
  <joint name="RL_q1_yaw" type="revolute">
    <parent link="base_link" />
    <child link="RL_yaw" />
    <origin xyz="-0.07283199846 0.07283199846 0" rpy="0 0 2.35619449" />
    <axis xyz="0 0 1" />
    <limit lower="-1.7453292519943295" upper="1.7453292519943295" effort="20" velocity="20" />
    <dynamics damping="0" friction="0" />
  </joint>
  <link name="RL_femur">
    <inertial>
      <origin xyz="0 0 -0.06975" />
      <mass value="0.1715272545917623" />
      <inertia ixx="0.00028639691290118316" iyy="0.0002827948405547562" izz="1.2864544094382171e-05" ixy="0" ixz="0" iyz="0" />
    </inertial>
    <visual>
      <origin xyz="0 0 -0.06975" rpy="0 0 0" />
      <geometry>
        <box size="0.018 0.024 0.1395" />
      </geometry>
      <material name="RL_femur_material">
        <color rgba="0.68 0.7 0.67 1" />
      </material>
    </visual>
    <collision>
      <origin xyz="0 0 -0.06975" rpy="0 0 0" />
      <geometry>
        <box size="0.018 0.024 0.1395" />
      </geometry>
    </collision>
  </link>
  <joint name="RL_q2_hip" type="revolute">
    <parent link="RL_yaw" />
    <child link="RL_femur" />
    <origin xyz="0.035 -0.03 0" rpy="0 0 0" />
    <axis xyz="0 -1 0" />
    <limit lower="-0.6981317007977318" upper="2.181661564992912" effort="20" velocity="20" />
    <dynamics damping="0" friction="0" />
  </joint>
  <link name="RL_tibia">
    <inertial>
      <origin xyz="0 0 -0.09551791951" />
      <mass value="0.27304913299150024" />
      <inertia ixx="0.0003976505540132882" iyy="0.00039191652222046676" izz="2.0478684974362515e-05" ixy="0" ixz="0" iyz="0" />
    </inertial>
    <visual>
      <origin xyz="0 0 -0.065" rpy="0 0 0" />
      <geometry>
        <box size="0.018 0.024 0.13" />
      </geometry>
      <material name="RL_tibia_material">
        <color rgba="0.68 0.7 0.67 1" />
      </material>
    </visual>
    <collision>
      <origin xyz="0 0 -0.065" rpy="0 0 0" />
      <geometry>
        <box size="0.018 0.024 0.13" />
      </geometry>
    </collision>
  </link>
  <joint name="RL_q3_knee" type="revolute">
    <parent link="RL_femur" />
    <child link="RL_tibia" />
    <origin xyz="0 0 -0.1395" rpy="0 0 0" />
    <axis xyz="0 -1 0" />
    <limit lower="-2.6179938779914944" upper="-0.2617993877991494" effort="20" velocity="20" />
    <dynamics damping="0" friction="0" />
  </joint>
  <link name="RL_wheel">
    <inertial>
      <origin xyz="0 0 0" />
      <mass value="0.08454368068314383" />
      <inertia ixx="4.223485248127304e-05" iyy="7.635351161696428e-05" izz="4.223485248127304e-05" ixy="0" ixz="0" iyz="0" />
    </inertial>
    <visual>
      <origin xyz="0 0 0" rpy="1.570796327 0 0" />
      <geometry>
        <cylinder radius="0.0425" length="0.024" />
      </geometry>
      <material name="RL_wheel_material">
        <color rgba="0.12 0.13 0.13 1" />
      </material>
    </visual>
    <collision>
      <origin xyz="0 0 0" rpy="1.570796327 0 0" />
      <geometry>
        <cylinder radius="0.0425" length="0.024" />
      </geometry>
    </collision>
  </link>
  <joint name="RL_wheel_drive" type="continuous">
    <parent link="RL_tibia" />
    <child link="RL_wheel" />
    <origin xyz="0 0 -0.13" rpy="0 0 0" />
    <axis xyz="0 -1 0" />
    <dynamics damping="0" friction="0" />
  </joint>
  <link name="RR_yaw">
    <inertial>
      <origin xyz="0.0175 0.015 0" />
      <mass value="0.43185924208629095" />
      <inertia ixx="0.00020243401972794888" iyy="0.0002249266885866099" izz="0.0002816082141104356" ixy="0" ixz="0" iyz="0" />
    </inertial>
    <visual>
      <origin xyz="0.0175 0.015 0" rpy="0 0 0" />
      <geometry>
        <box size="0.065 0.06 0.045" />
      </geometry>
      <material name="RR_yaw_material">
        <color rgba="0.25 0.27 0.28 1" />
      </material>
    </visual>
    <collision>
      <origin xyz="0.0175 0.015 0" rpy="0 0 0" />
      <geometry>
        <box size="0.065 0.06 0.045" />
      </geometry>
    </collision>
  </link>
  <joint name="RR_q1_yaw" type="revolute">
    <parent link="base_link" />
    <child link="RR_yaw" />
    <origin xyz="-0.07283199846 -0.07283199846 0" rpy="0 0 -2.35619449" />
    <axis xyz="0 0 1" />
    <limit lower="-1.7453292519943295" upper="1.7453292519943295" effort="20" velocity="20" />
    <dynamics damping="0" friction="0" />
  </joint>
  <link name="RR_femur">
    <inertial>
      <origin xyz="0 0 -0.06975" />
      <mass value="0.1715272545917623" />
      <inertia ixx="0.00028639691290118316" iyy="0.0002827948405547562" izz="1.2864544094382171e-05" ixy="0" ixz="0" iyz="0" />
    </inertial>
    <visual>
      <origin xyz="0 0 -0.06975" rpy="0 0 0" />
      <geometry>
        <box size="0.018 0.024 0.1395" />
      </geometry>
      <material name="RR_femur_material">
        <color rgba="0.68 0.7 0.67 1" />
      </material>
    </visual>
    <collision>
      <origin xyz="0 0 -0.06975" rpy="0 0 0" />
      <geometry>
        <box size="0.018 0.024 0.1395" />
      </geometry>
    </collision>
  </link>
  <joint name="RR_q2_hip" type="revolute">
    <parent link="RR_yaw" />
    <child link="RR_femur" />
    <origin xyz="0.035 0.03 0" rpy="0 0 0" />
    <axis xyz="0 -1 0" />
    <limit lower="-0.6981317007977318" upper="2.181661564992912" effort="20" velocity="20" />
    <dynamics damping="0" friction="0" />
  </joint>
  <link name="RR_tibia">
    <inertial>
      <origin xyz="0 0 -0.09551791951" />
      <mass value="0.27304913299150024" />
      <inertia ixx="0.0003976505540132882" iyy="0.00039191652222046676" izz="2.0478684974362515e-05" ixy="0" ixz="0" iyz="0" />
    </inertial>
    <visual>
      <origin xyz="0 0 -0.065" rpy="0 0 0" />
      <geometry>
        <box size="0.018 0.024 0.13" />
      </geometry>
      <material name="RR_tibia_material">
        <color rgba="0.68 0.7 0.67 1" />
      </material>
    </visual>
    <collision>
      <origin xyz="0 0 -0.065" rpy="0 0 0" />
      <geometry>
        <box size="0.018 0.024 0.13" />
      </geometry>
    </collision>
  </link>
  <joint name="RR_q3_knee" type="revolute">
    <parent link="RR_femur" />
    <child link="RR_tibia" />
    <origin xyz="0 0 -0.1395" rpy="0 0 0" />
    <axis xyz="0 -1 0" />
    <limit lower="-2.6179938779914944" upper="-0.2617993877991494" effort="20" velocity="20" />
    <dynamics damping="0" friction="0" />
  </joint>
  <link name="RR_wheel">
    <inertial>
      <origin xyz="0 0 0" />
      <mass value="0.08454368068314383" />
      <inertia ixx="4.223485248127304e-05" iyy="7.635351161696428e-05" izz="4.223485248127304e-05" ixy="0" ixz="0" iyz="0" />
    </inertial>
    <visual>
      <origin xyz="0 0 0" rpy="1.570796327 0 0" />
      <geometry>
        <cylinder radius="0.0425" length="0.024" />
      </geometry>
      <material name="RR_wheel_material">
        <color rgba="0.12 0.13 0.13 1" />
      </material>
    </visual>
    <collision>
      <origin xyz="0 0 0" rpy="1.570796327 0 0" />
      <geometry>
        <cylinder radius="0.0425" length="0.024" />
      </geometry>
    </collision>
  </link>
  <joint name="RR_wheel_drive" type="continuous">
    <parent link="RR_tibia" />
    <child link="RR_wheel" />
    <origin xyz="0 0 -0.13" rpy="0 0 0" />
    <axis xyz="0 -1 0" />
    <dynamics damping="0" friction="0" />
  </joint>
</robot>
