silmoon04/mist-robot/locomotion/hardware/esp32/include/calibration_profile.h

#pragma once
#include <stdint.h>
// Real IDs, signs, reference angles and safe ends have not been measured for R7.
constexpr bool PROFILE_CONFIGURED = false;
constexpr char PROFILE_HASH[] = "unconfigured";
constexpr uint8_t SERVO_IDS[12] = {0};
constexpr int16_t MIN_TICKS[12] = {0};
constexpr int16_t MAX_TICKS[12] = {0};
