silmoon04/mist-robot/(commit log)

2026-10-12 Publish robot CAD, manufacturing history, assembly and project source
    [MIST_proximal_cad_inertials.urdf, NEXT_MEASUREMENTS.csv, PARTS.csv, RESULTS.csv, SHA256SUMS.csv, Single_Leg_R6.urdf, Single_Leg_R7.urdf, Stocks.csv]
2026-10-12 Save paused R7 locomotion simulation and MSI training handoff
    [Main_Hub_4Leg.stl, bench_mounting_plate.stl, case_cap_hip.stl, case_cap_knee.stl, case_cap_yaw.stl, coxa_lower_auxiliary_arm.stl, coxa_upper_and_hip_saddle.stl, femur_auxiliary_cheek.stl]
2026-10-12 Continue locomotion handoff on MSI with verified runtimes and development receipts
    [monitor_0.monitor.csv, monitor_1.monitor.csv, nvidia-gpus.csv]
2026-10-12 Add faster interactive crawl with measured joint motion and real-time pacing
2026-10-13 Stream smooth CAD poses and add an optional higher speed preview
